aljazblatnik/Spectrum-analyzer/README.md

# Spectrum-analyzer
This is the first public release of all the building blocks of an open source 0 - 4 GHz spectrum analyzer with tracking generator. Detailed assembly instructions and plans will be published in the coming months.
