aljazblatnik/Spectrum-analyzer/AMP HEMT/AMP HEMT schematic.png

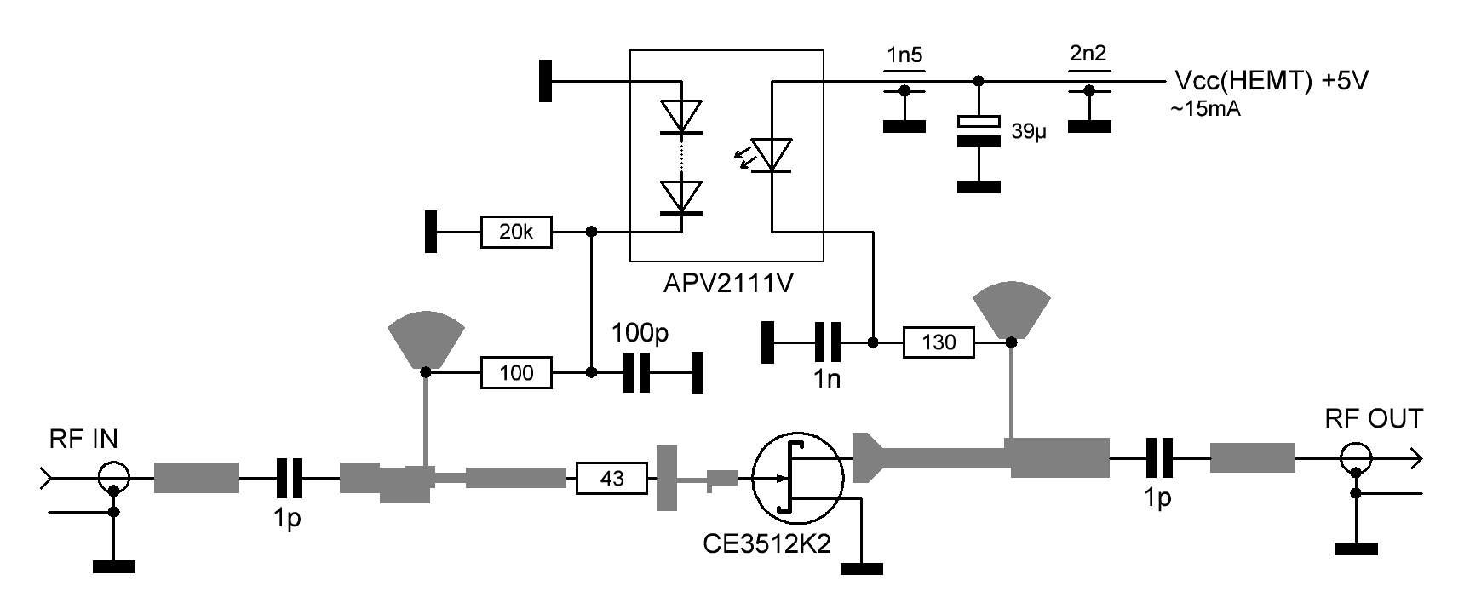
AMP HEMT/AMP HEMT schematic.png
