aljazblatnik/Spectrum-analyzer/AMP HEMT/photo/IMG_5204.jpg

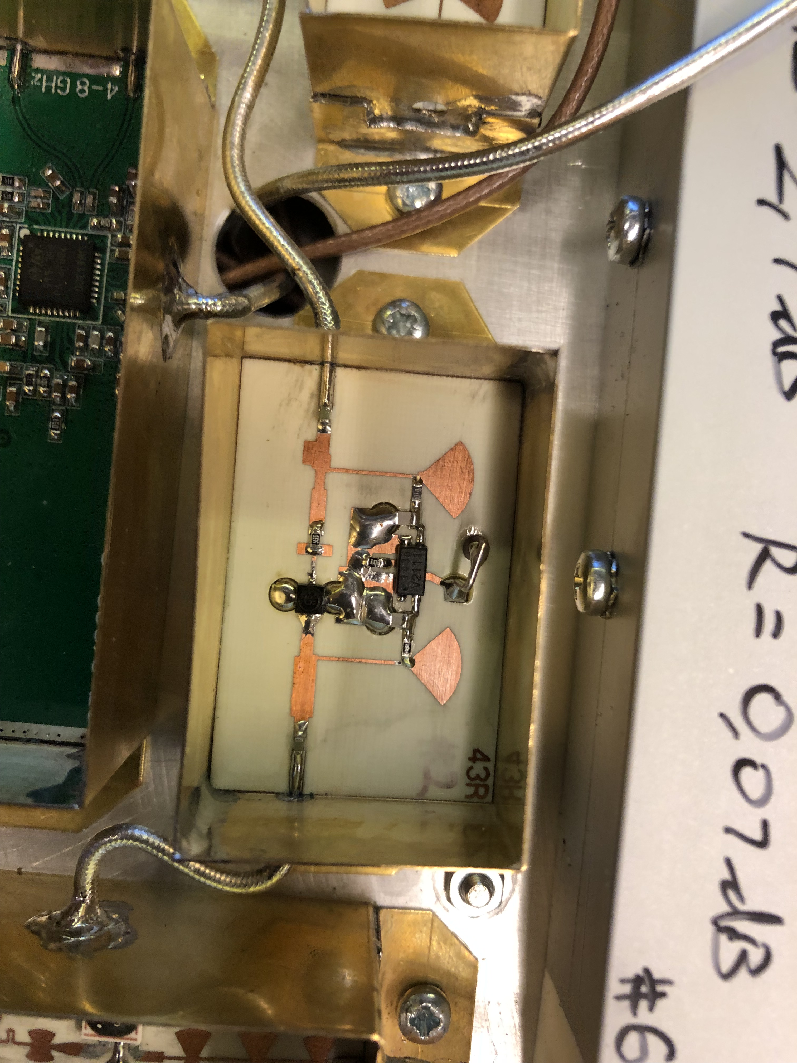
AMP HEMT/photo/IMG_5204.jpg
