aljazblatnik/Spectrum-analyzer/AMP HEMT/photo/IMG_5205.jpg

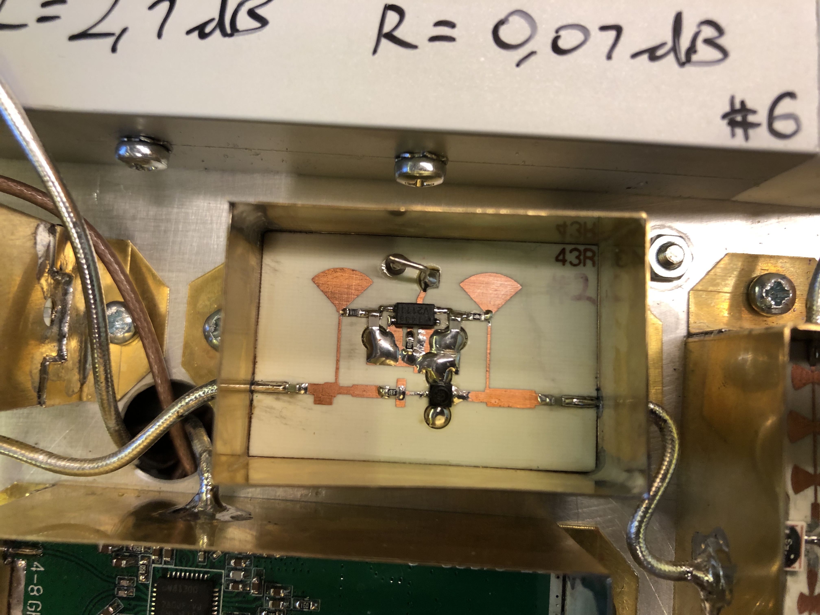
AMP HEMT/photo/IMG_5205.jpg
