aljazblatnik/Spectrum-analyzer/AMP HEMT/photo/IMG_5207.jpg

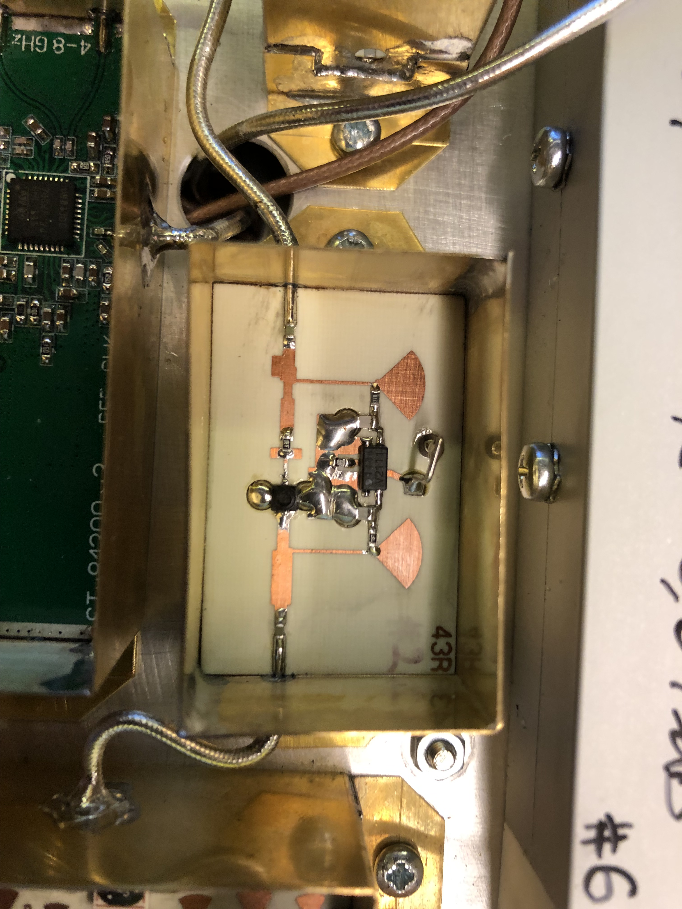
AMP HEMT/photo/IMG_5207.jpg
