aljazblatnik/Spectrum-analyzer/AMP HEMT/photo/IMG_5208.jpg

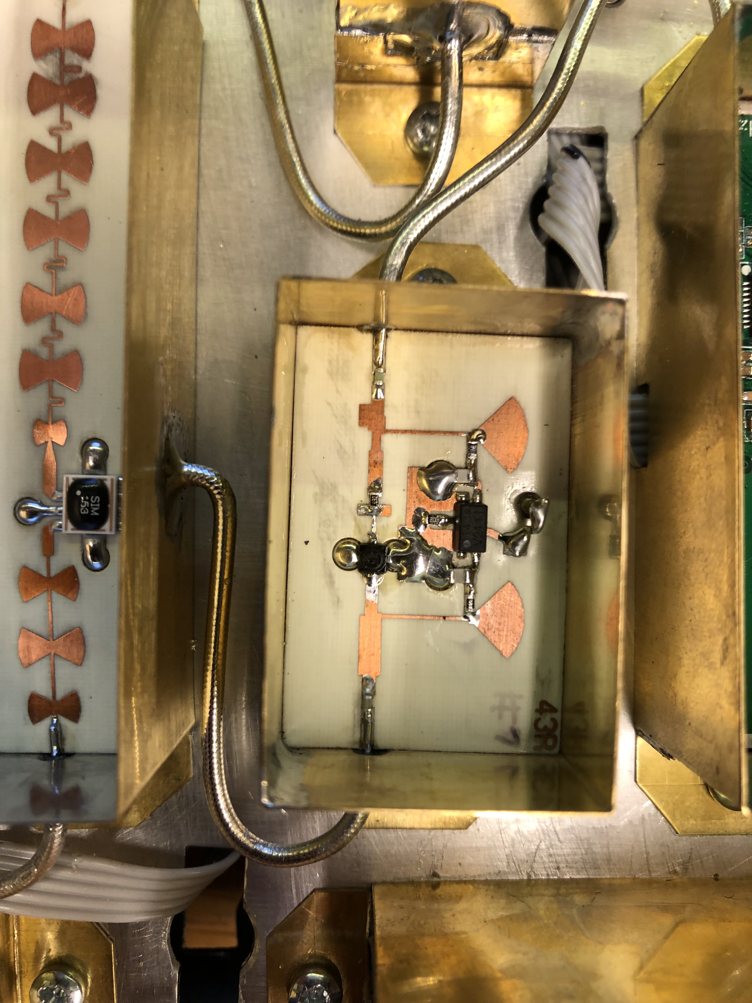
AMP HEMT/photo/IMG_5208.jpg
