aljazblatnik/Spectrum-analyzer/AMP HEMT/photo/IMG_5209.jpg

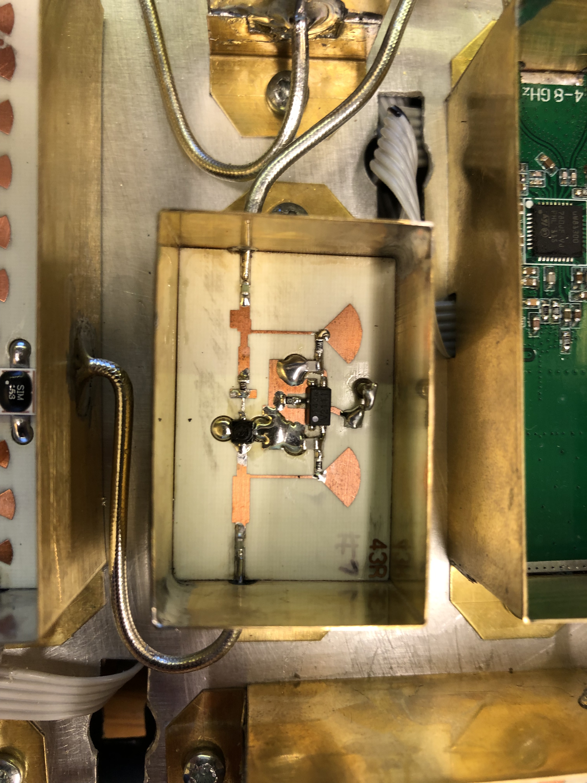
AMP HEMT/photo/IMG_5209.jpg
