aljazblatnik/Spectrum-analyzer/AMP HEMT/photo/IMG_5210.jpg

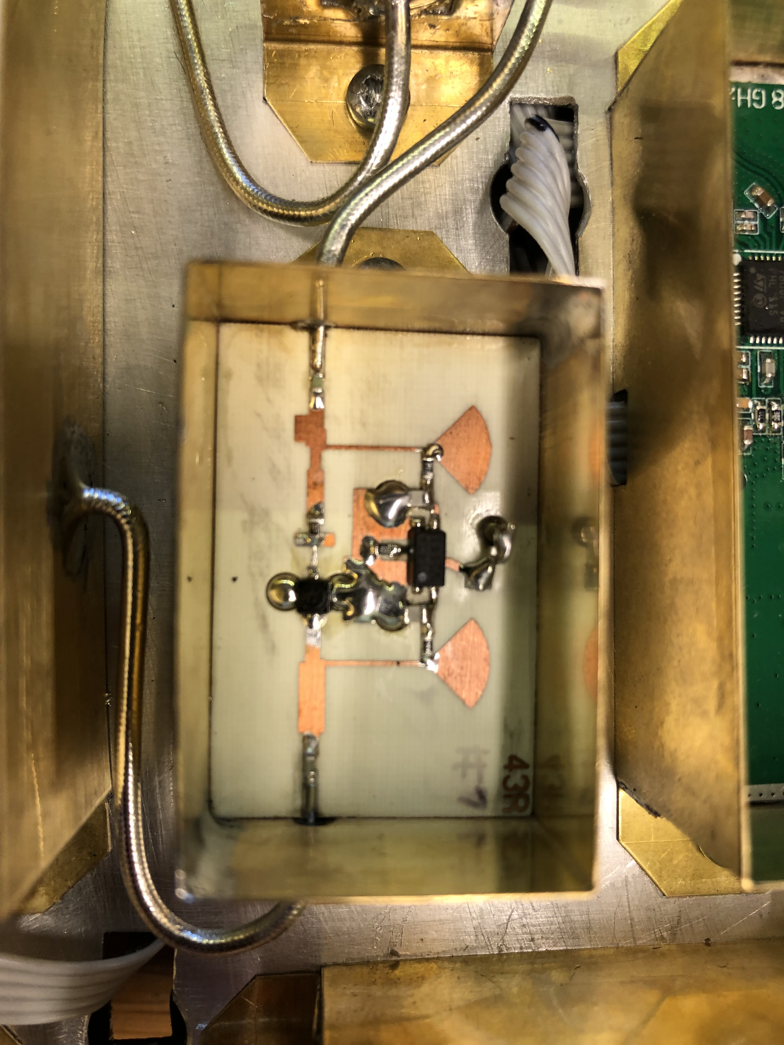
AMP HEMT/photo/IMG_5210.jpg
