aljazblatnik/Spectrum-analyzer/AMP HEMT/photo/IMG_5356.JPEG

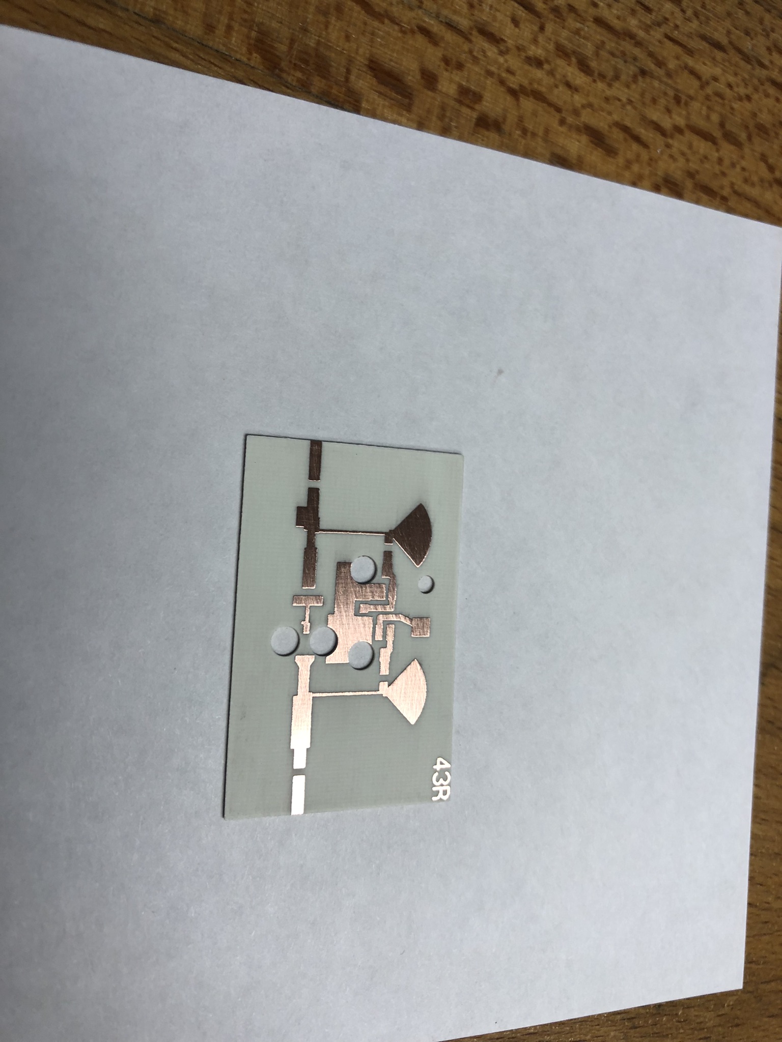
AMP HEMT/photo/IMG_5356.JPEG
