aljazblatnik/Spectrum-analyzer/AMP HEMT/photo/IMG_5357.JPEG

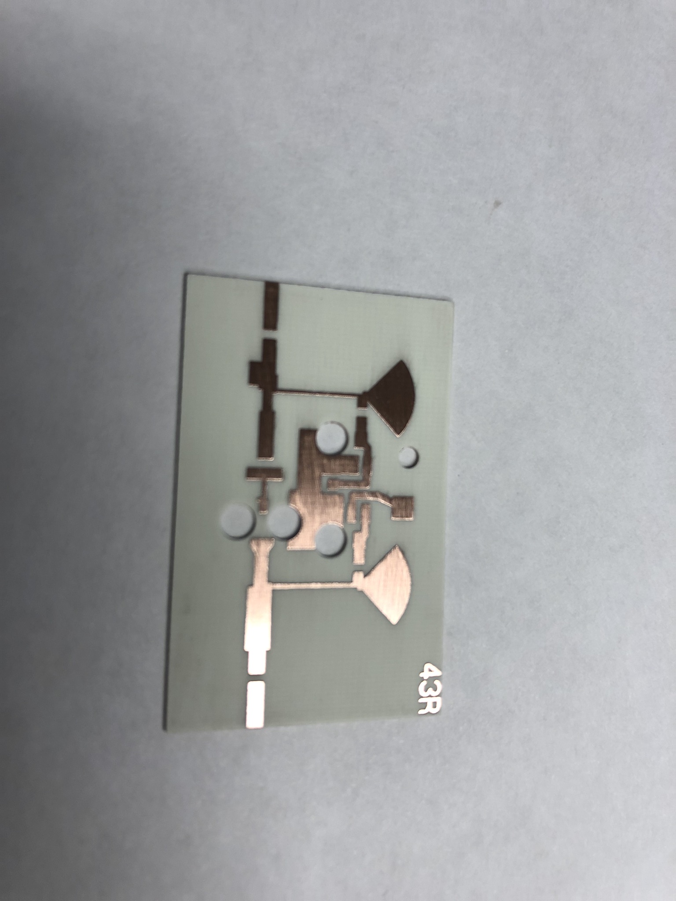
AMP HEMT/photo/IMG_5357.JPEG
