aljazblatnik/Spectrum-analyzer/AMP HEMT/photo/IMG_5361.JPG

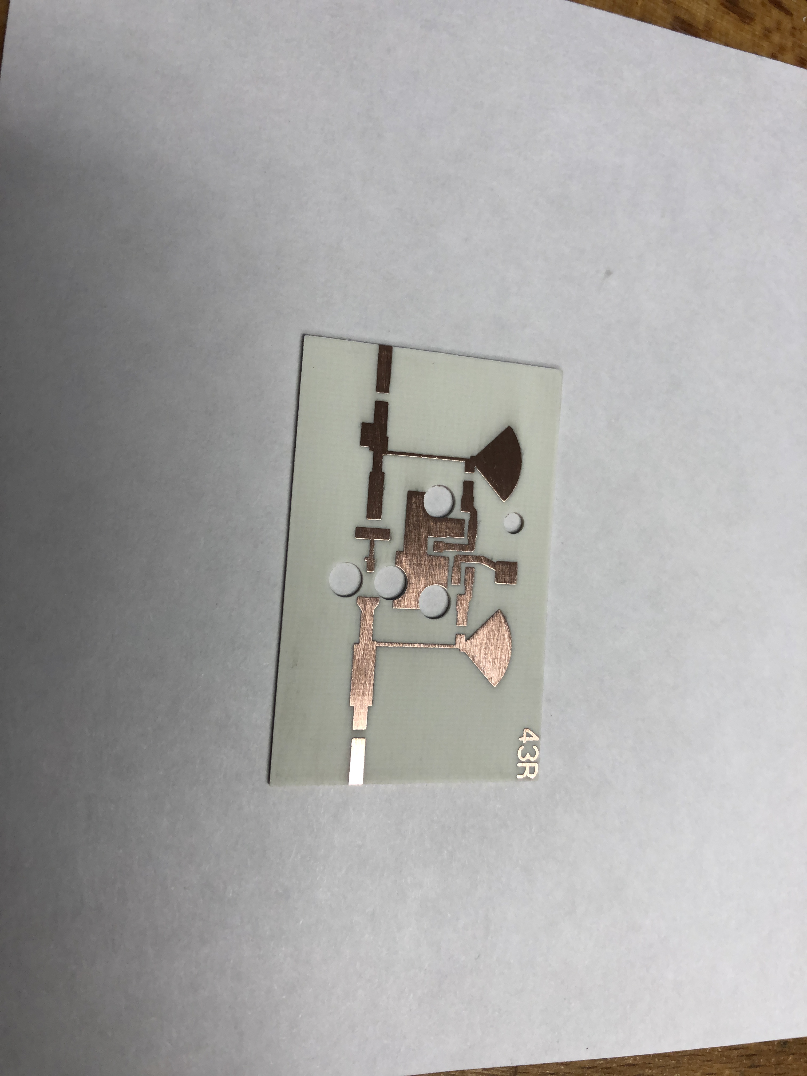
AMP HEMT/photo/IMG_5361.JPG
