aljazblatnik/Spectrum-analyzer/AMP HEMT/photo/IMG_5369.JPG

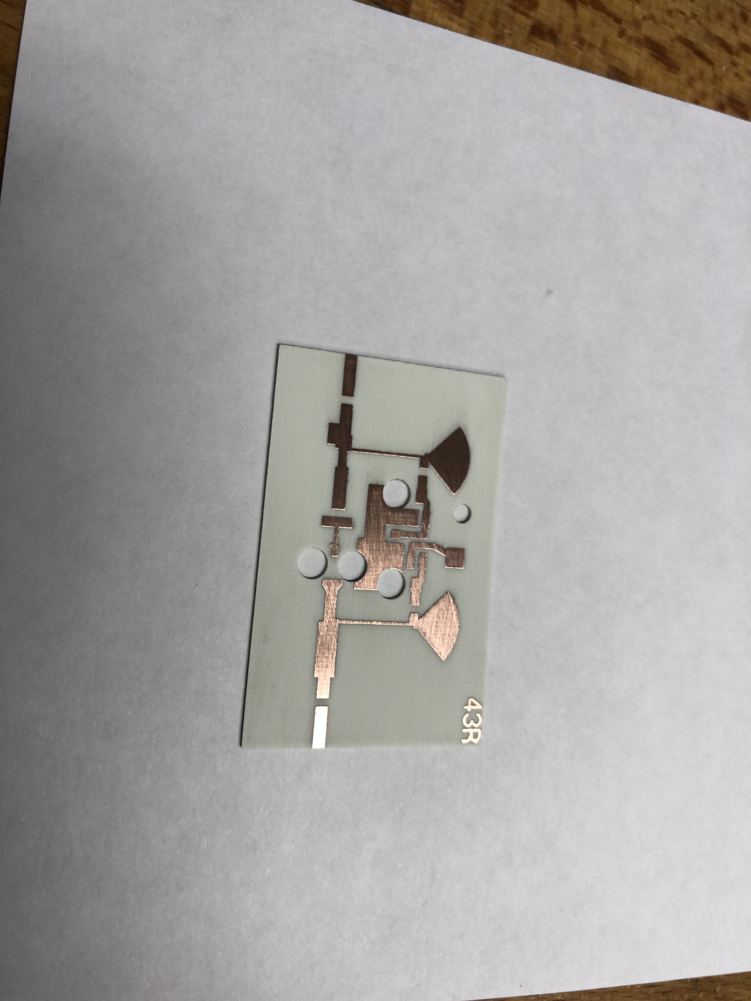
AMP HEMT/photo/IMG_5369.JPG
