aljazblatnik/Spectrum-analyzer/AMP HEMT/photo/IMG_5370.JPEG

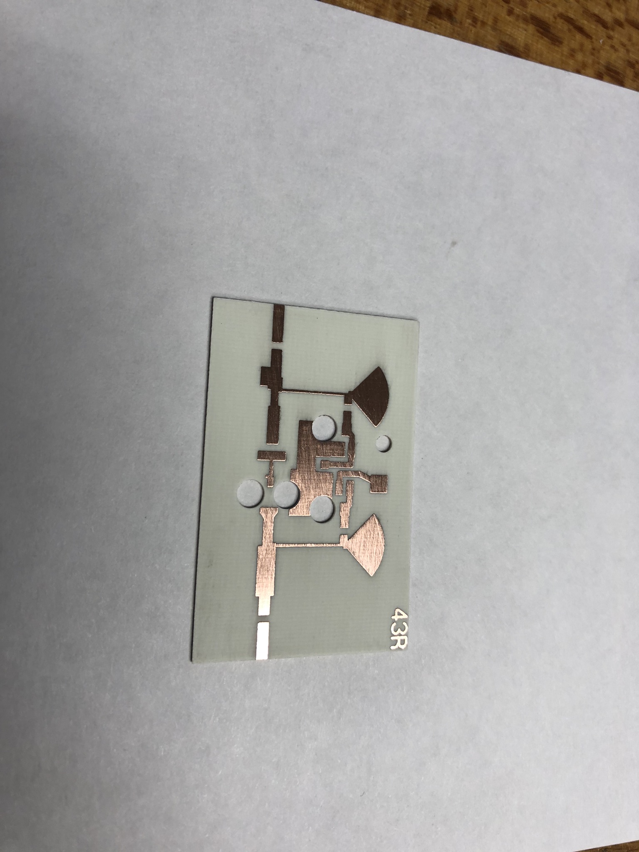
AMP HEMT/photo/IMG_5370.JPEG
