aljazblatnik/Spectrum-analyzer/AMP HEMT/photo/IMG_5371.JPEG

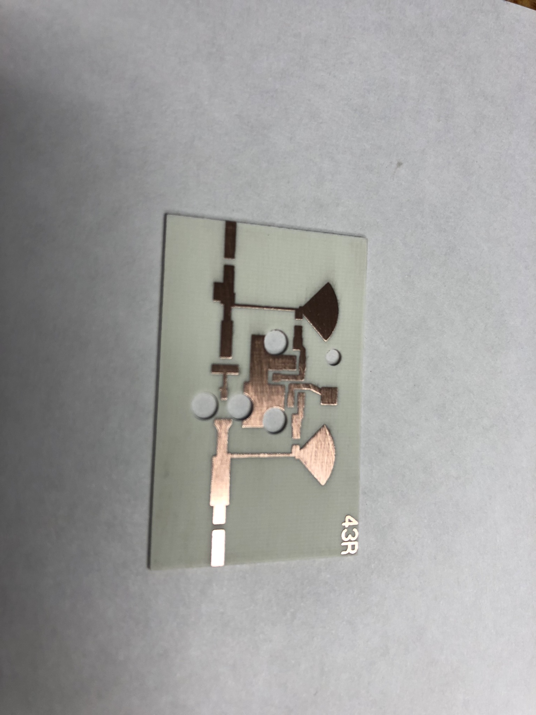
AMP HEMT/photo/IMG_5371.JPEG
