aljazblatnik/Spectrum-analyzer/AMP HEMT/photo/IMG_5372.JPEG

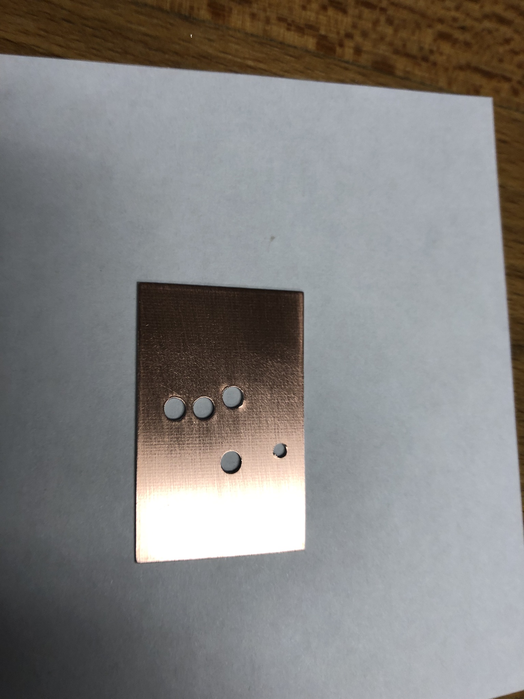
AMP HEMT/photo/IMG_5372.JPEG
