aljazblatnik/Spectrum-analyzer/AMP HEMT/photo/IMG_5373.JPEG

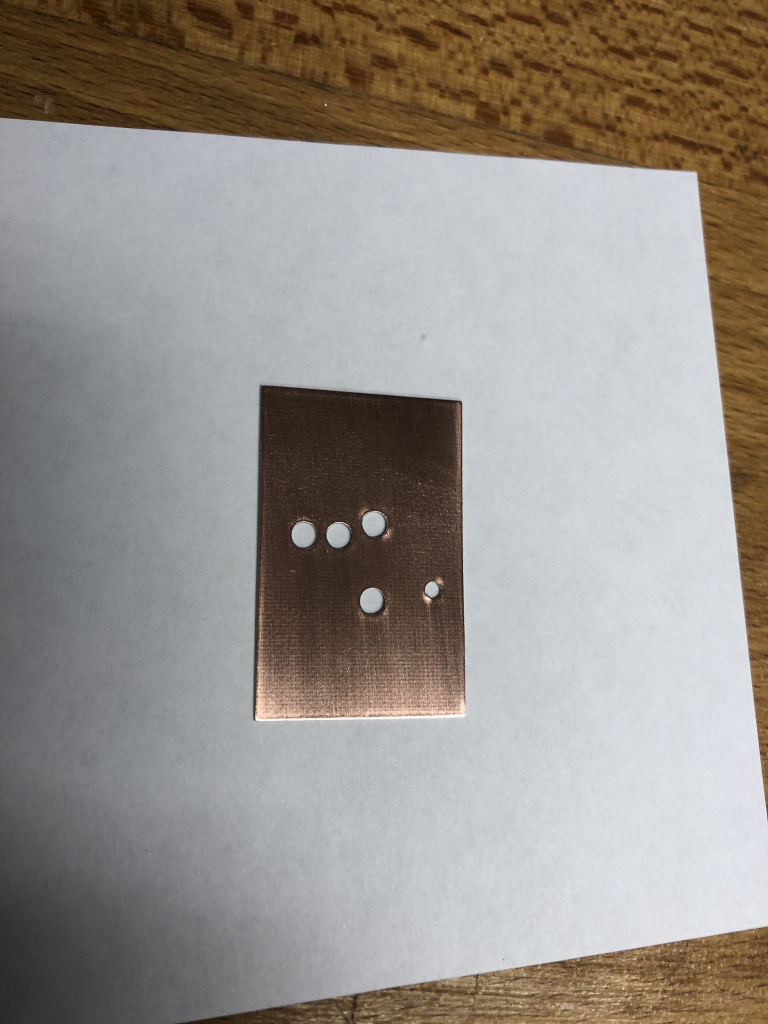
AMP HEMT/photo/IMG_5373.JPEG
