aljazblatnik/Spectrum-analyzer/AMP HEMT/photo/IMG_5374.JPEG

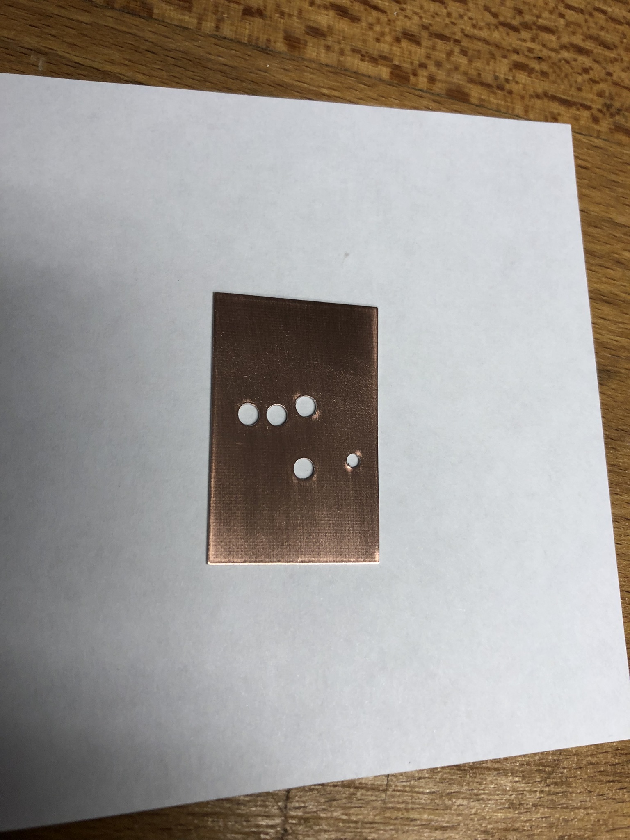
AMP HEMT/photo/IMG_5374.JPEG
