aljazblatnik/Spectrum-analyzer/AMP HEMT/photo/IMG_5375.JPEG

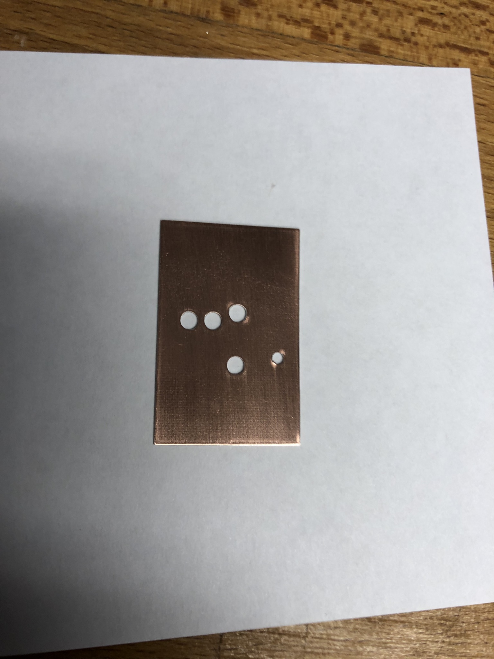
AMP HEMT/photo/IMG_5375.JPEG
