aljazblatnik/Spectrum-analyzer/AMP HEMT/photo/IMG_5376.JPEG

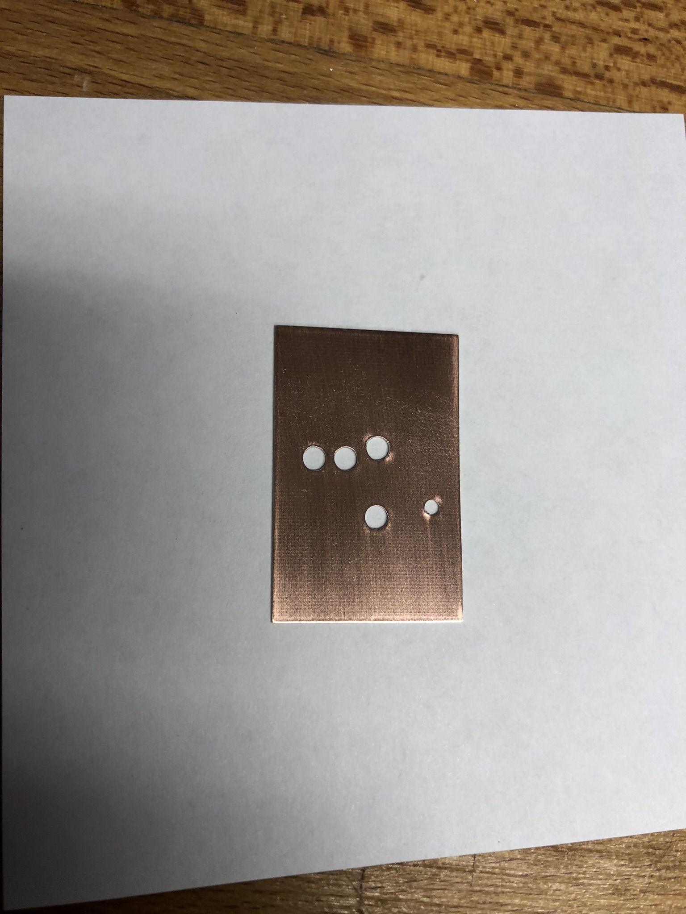
AMP HEMT/photo/IMG_5376.JPEG
