aljazblatnik/Spectrum-analyzer/AMP HEMT/photo/IMG_5377.JPEG

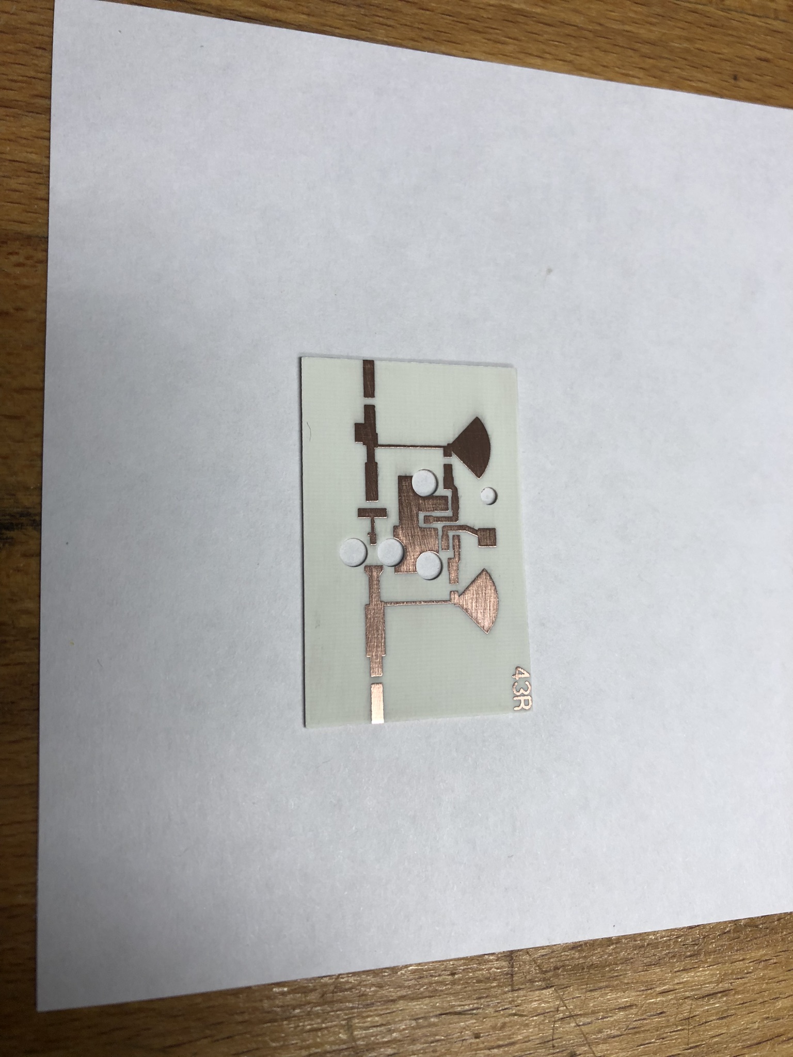
AMP HEMT/photo/IMG_5377.JPEG
