aljazblatnik/Spectrum-analyzer/AMP HEMT/photo/IMG_5378.JPEG

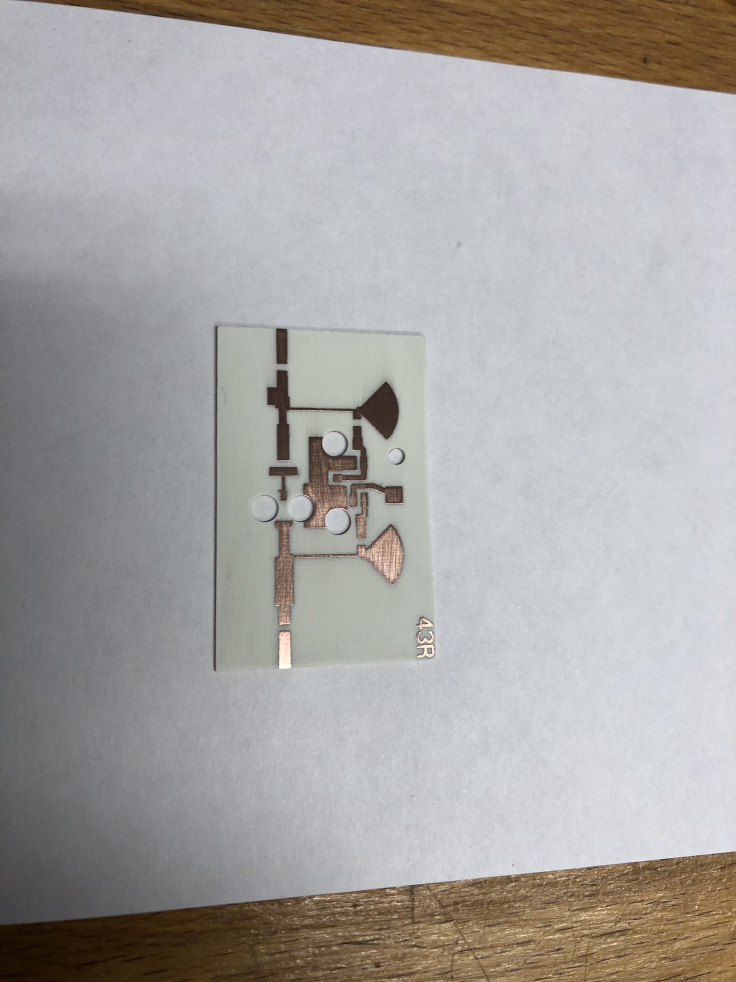
AMP HEMT/photo/IMG_5378.JPEG
