aljazblatnik/Spectrum-analyzer/AMP HEMT/photo/IMG_5379.JPEG

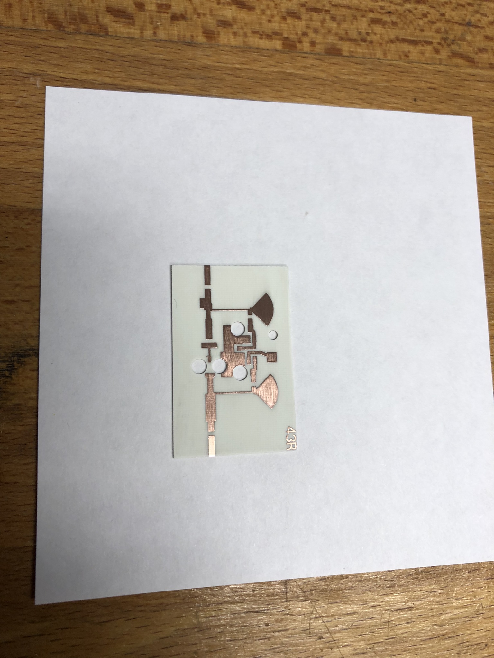
AMP HEMT/photo/IMG_5379.JPEG
