aljazblatnik/Spectrum-analyzer/AMP HEMT/photo/IMG_5380.JPEG

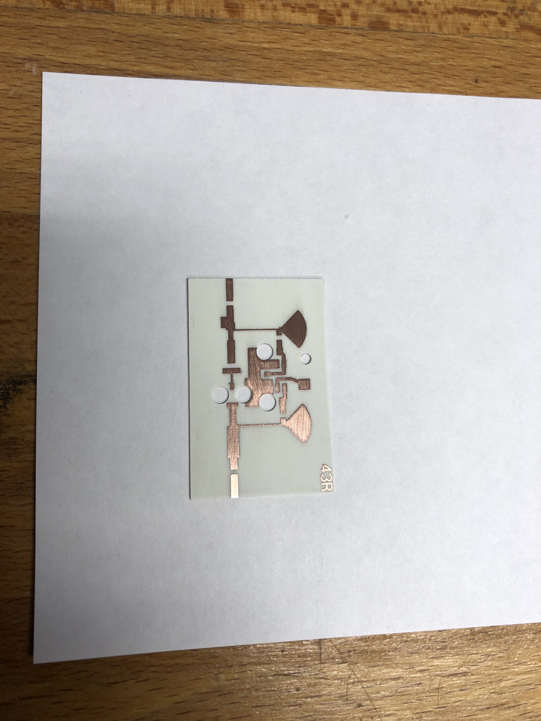
AMP HEMT/photo/IMG_5380.JPEG
