aljazblatnik/Spectrum-analyzer/AMP HEMT/photo/IMG_5381.JPEG

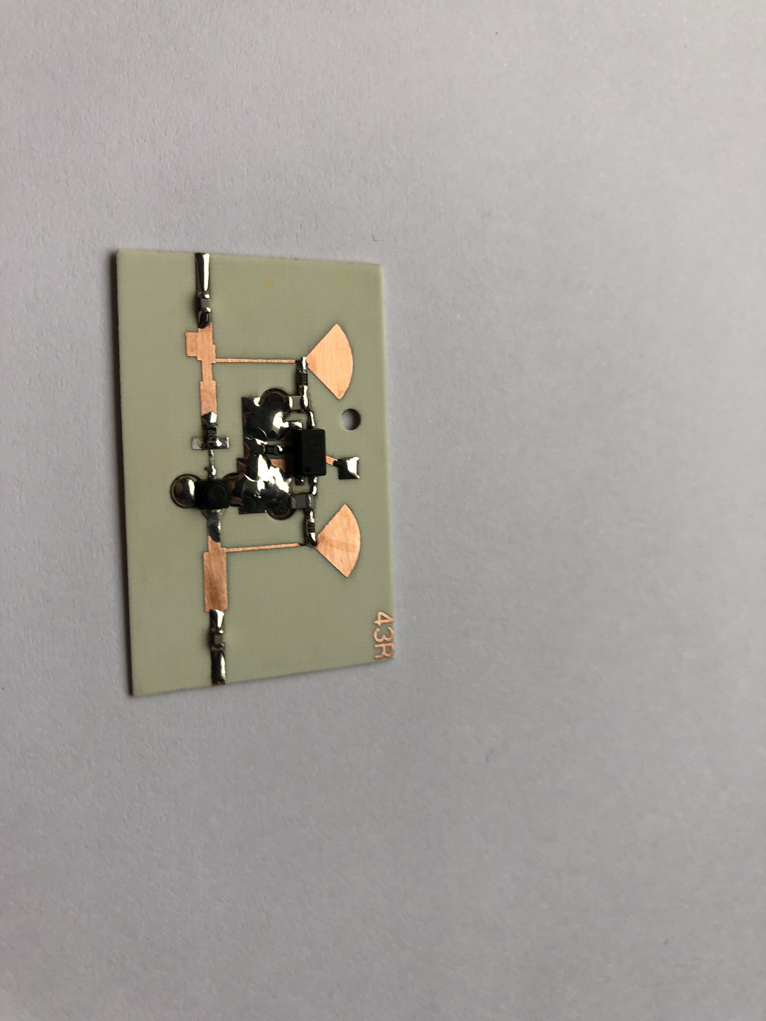
AMP HEMT/photo/IMG_5381.JPEG
