aljazblatnik/Spectrum-analyzer/AMP HEMT/photo/IMG_5382.JPEG

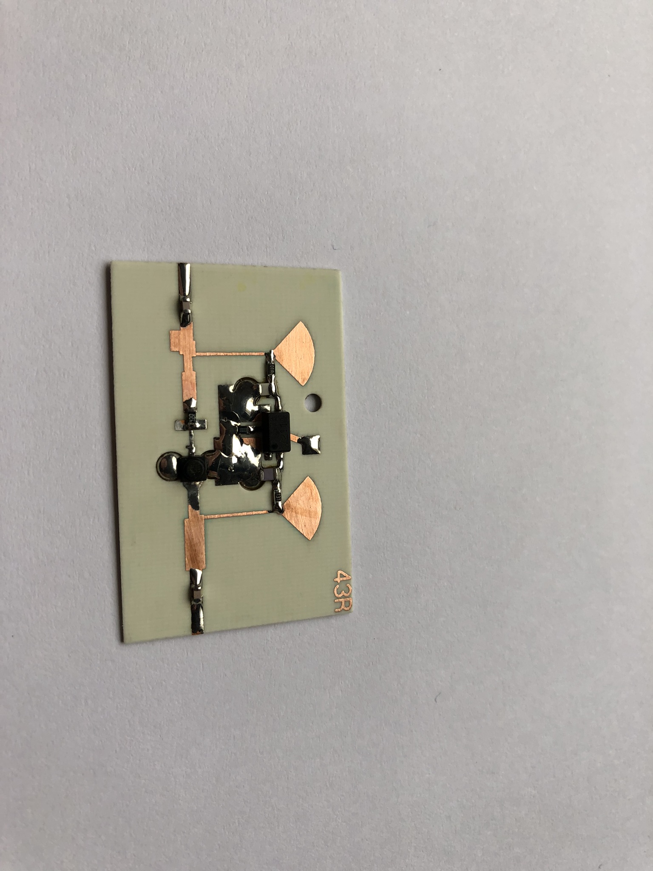
AMP HEMT/photo/IMG_5382.JPEG
