aljazblatnik/Spectrum-analyzer/AMP HEMT/photo/IMG_5383.JPEG

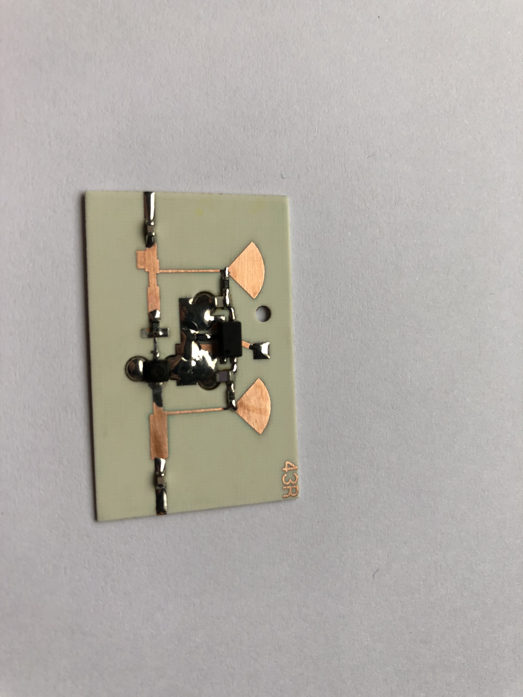
AMP HEMT/photo/IMG_5383.JPEG
