aljazblatnik/Spectrum-analyzer/AMP HEMT/photo/IMG_5384.JPEG

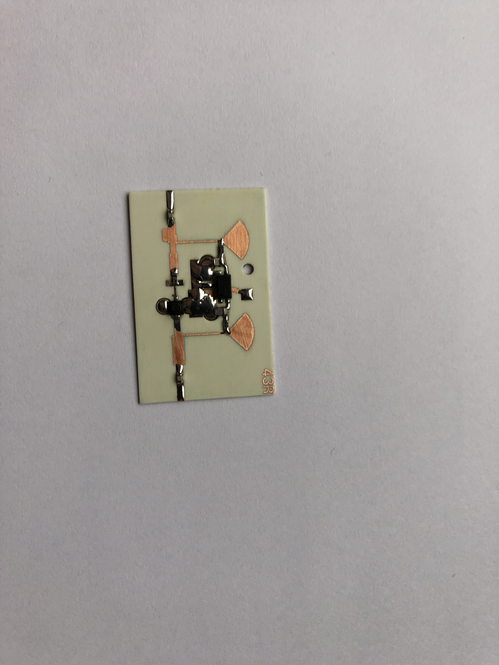
AMP HEMT/photo/IMG_5384.JPEG
