aljazblatnik/Spectrum-analyzer/AMP HEMT/photo/IMG_5385.JPEG

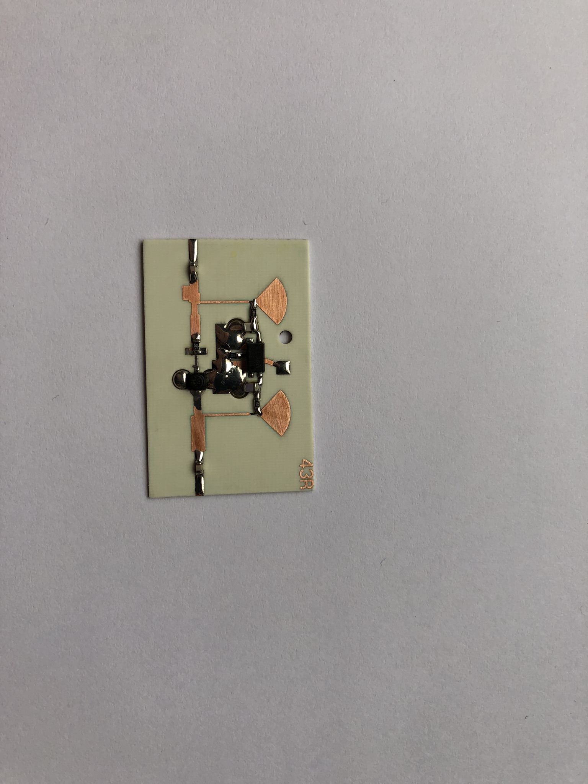
AMP HEMT/photo/IMG_5385.JPEG
