aljazblatnik/Spectrum-analyzer/AMP HEMT/photo/IMG_5386.JPEG

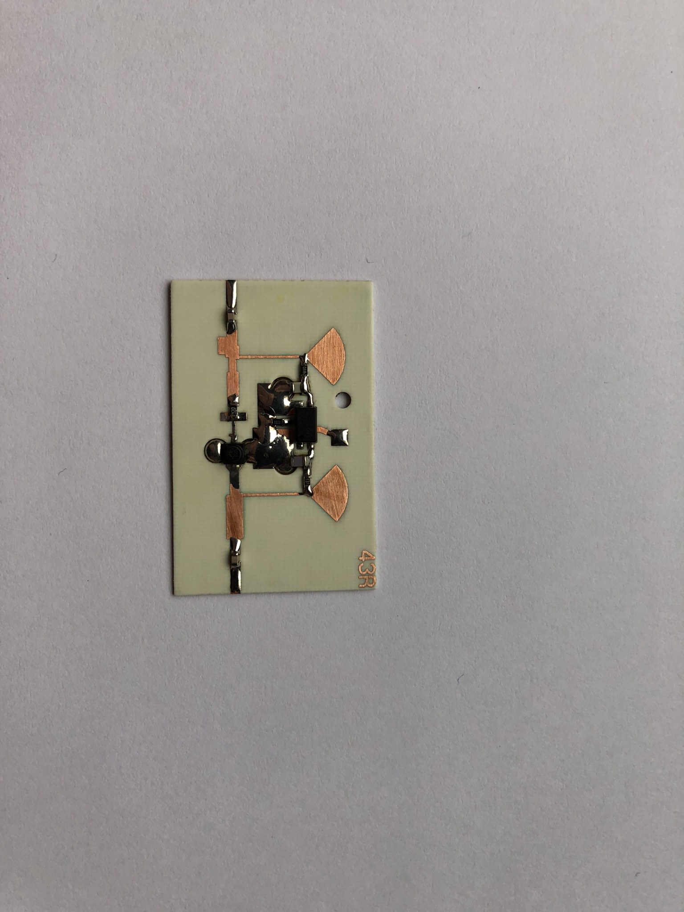
AMP HEMT/photo/IMG_5386.JPEG
