aljazblatnik/Spectrum-analyzer/AMP HEMT/photo/IMG_5387.JPEG

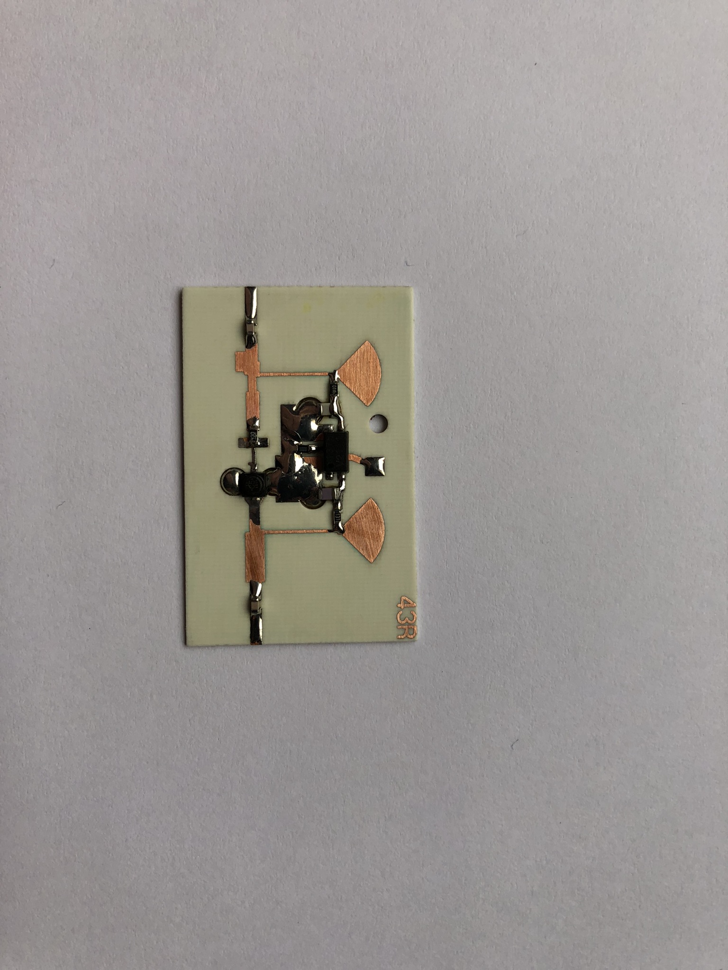
AMP HEMT/photo/IMG_5387.JPEG
