aljazblatnik/Spectrum-analyzer/AMP HEMT/photo/IMG_5388.JPEG

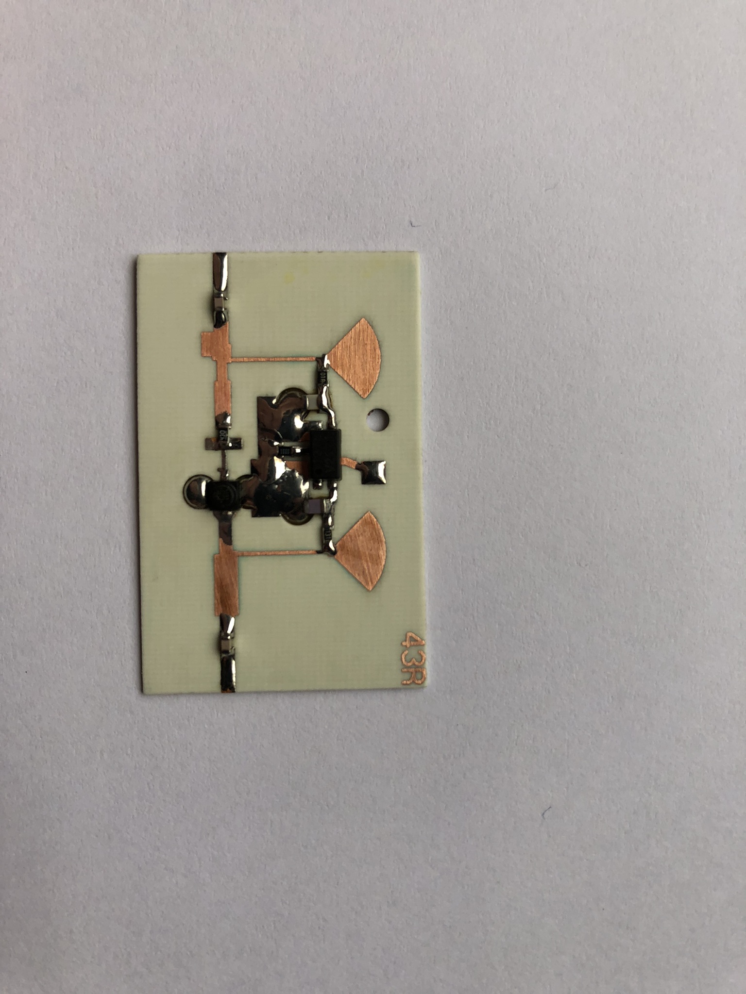
AMP HEMT/photo/IMG_5388.JPEG
