aljazblatnik/Spectrum-analyzer/AMP HEMT/photo/IMG_5389.JPEG

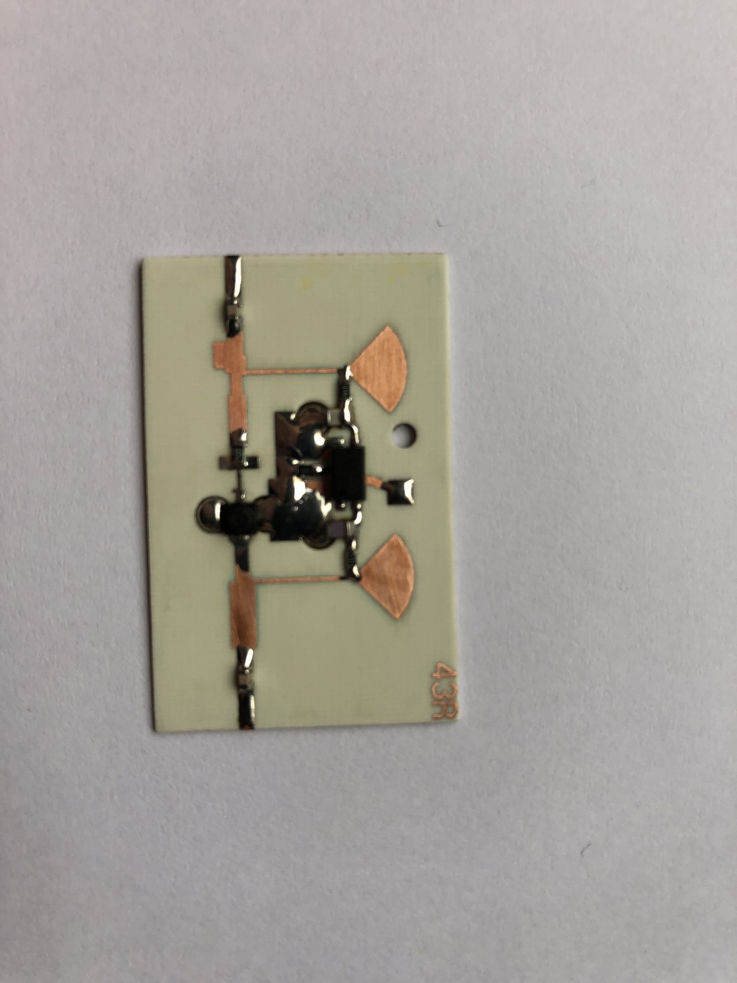
AMP HEMT/photo/IMG_5389.JPEG
