aljazblatnik/Spectrum-analyzer/AMP HEMT/photo/IMG_5390.JPEG

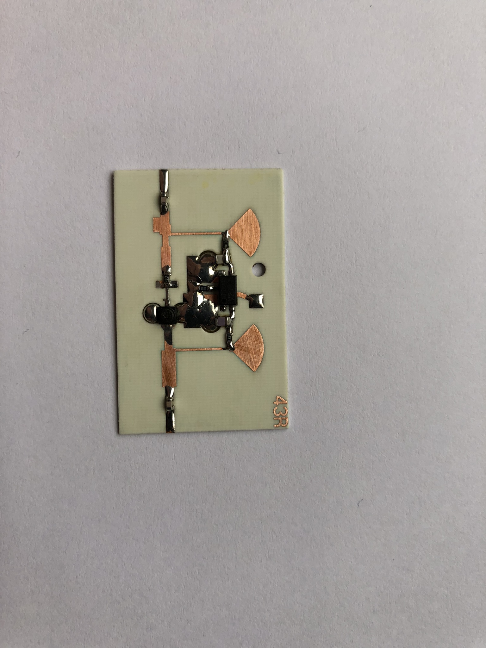
AMP HEMT/photo/IMG_5390.JPEG
