aljazblatnik/Spectrum-analyzer/AMP HEMT/photo/IMG_5391.JPEG

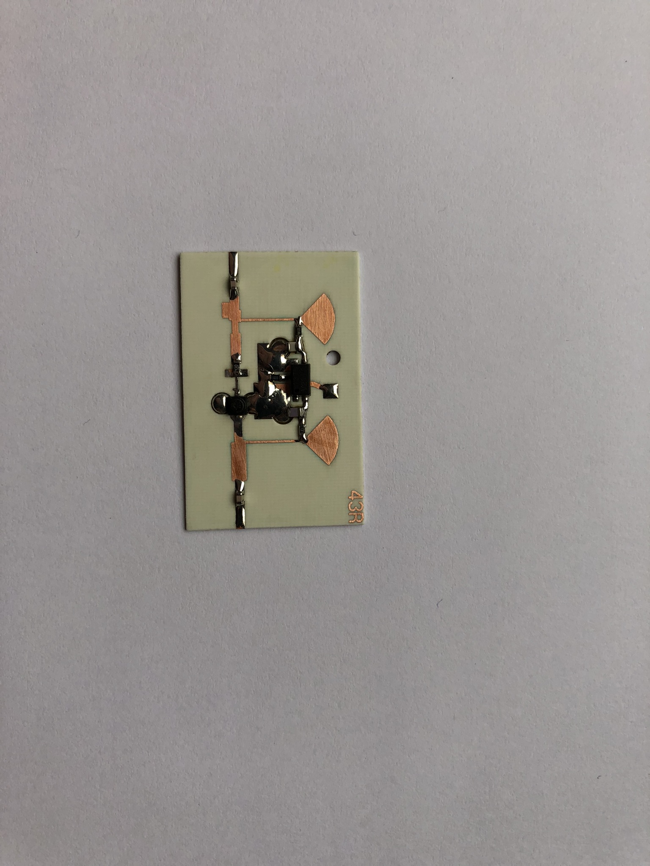
AMP HEMT/photo/IMG_5391.JPEG
