aljazblatnik/Spectrum-analyzer/AMP HEMT/photo/IMG_5392.JPEG

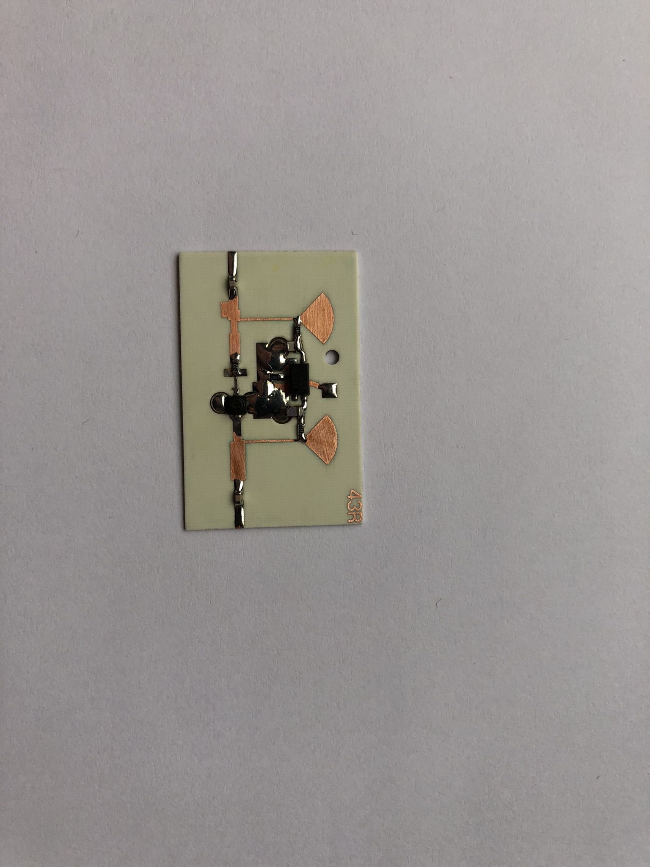
AMP HEMT/photo/IMG_5392.JPEG
