aljazblatnik/Spectrum-analyzer/AMP HEMT/photo/IMG_5394.JPEG

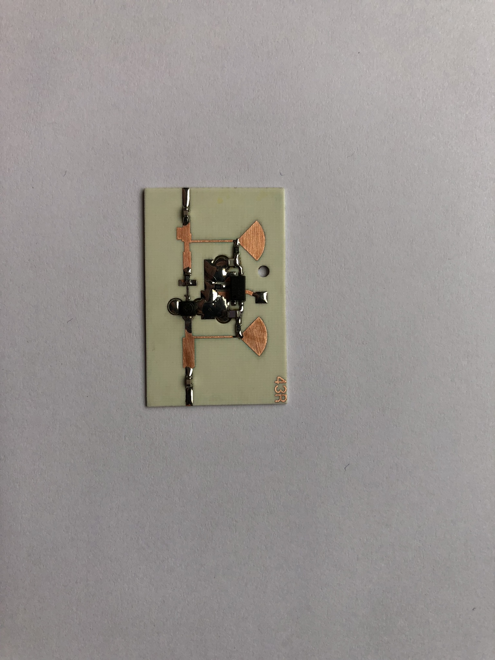
AMP HEMT/photo/IMG_5394.JPEG
