aljazblatnik/Spectrum-analyzer/AMP HEMT/photo/IMG_5395.JPEG

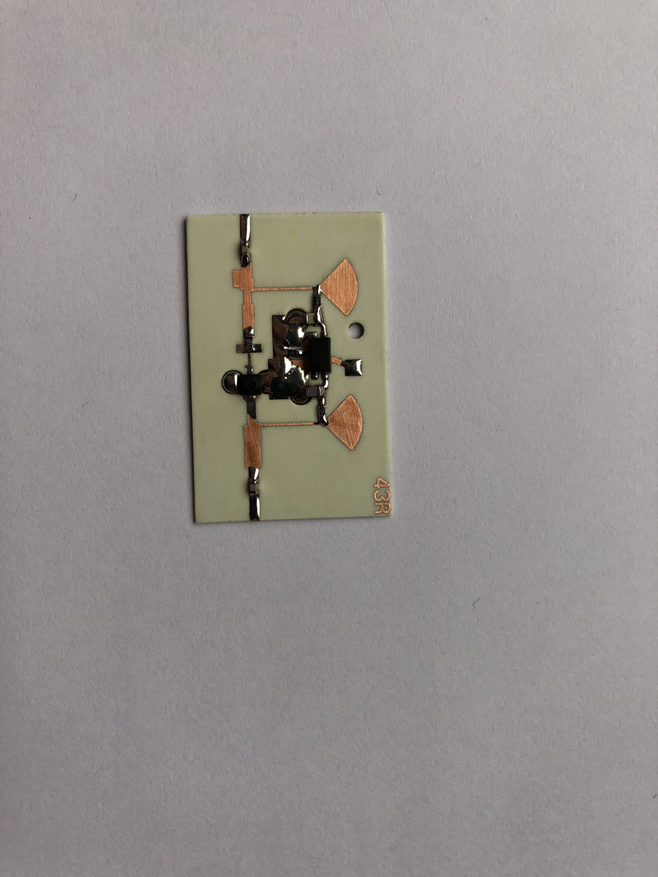
AMP HEMT/photo/IMG_5395.JPEG
