aljazblatnik/Spectrum-analyzer/AMP HEMT/photo/IMG_5396.JPEG

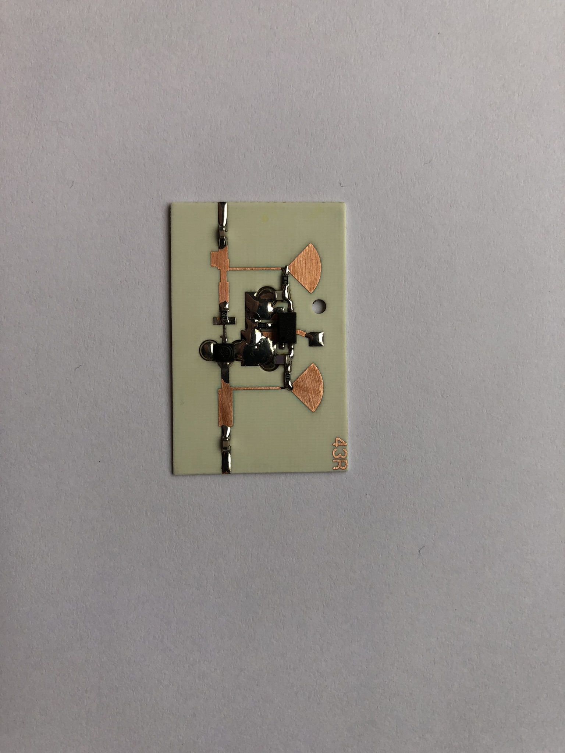
AMP HEMT/photo/IMG_5396.JPEG
