aljazblatnik/Spectrum-analyzer/AMP HEMT/photo/IMG_5397.JPEG

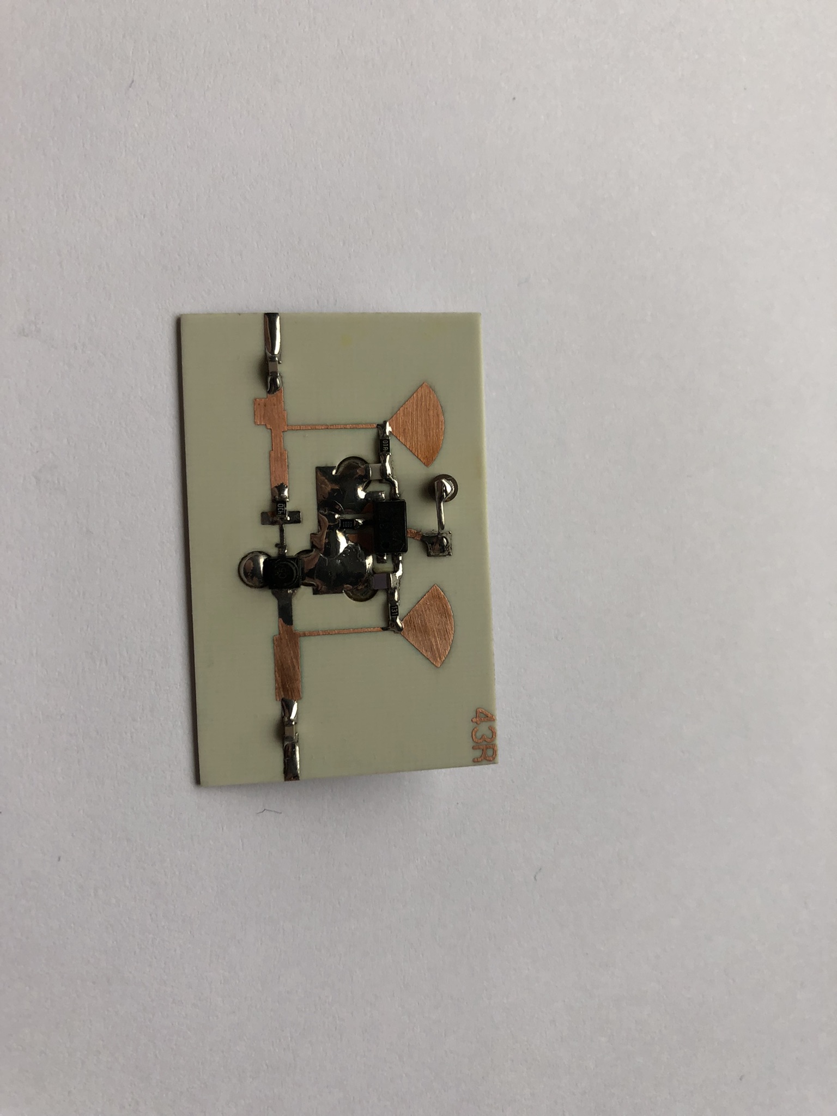
AMP HEMT/photo/IMG_5397.JPEG
