aljazblatnik/Spectrum-analyzer/AMP HEMT/photo/IMG_5398.JPEG

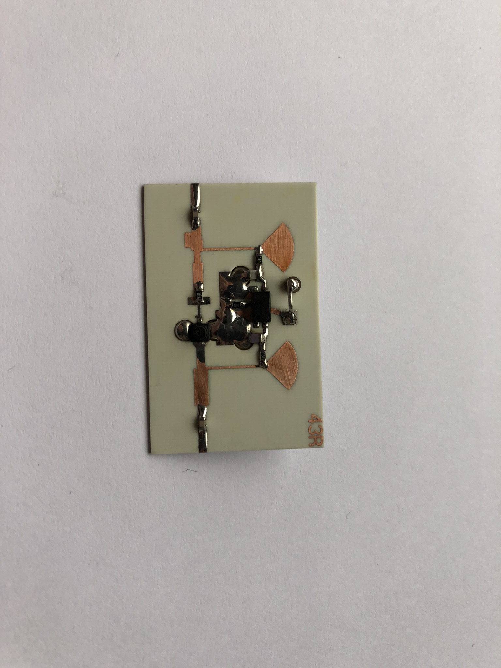
AMP HEMT/photo/IMG_5398.JPEG
