aljazblatnik/Spectrum-analyzer/AMP HEMT/photo/IMG_5399.JPEG

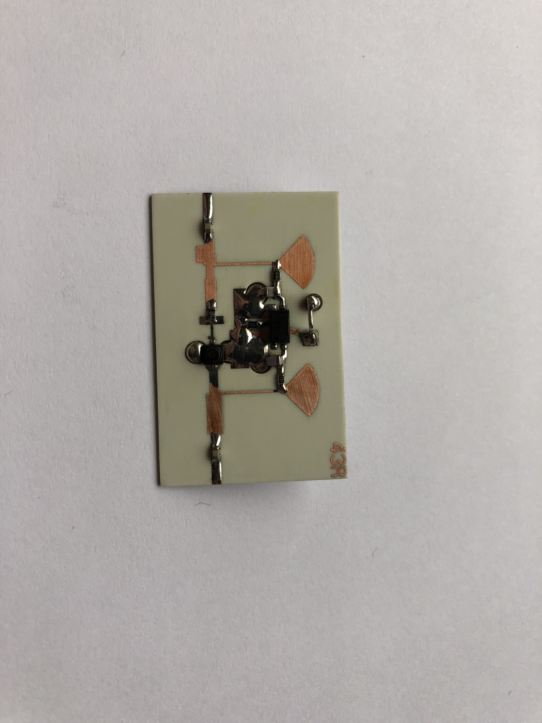
AMP HEMT/photo/IMG_5399.JPEG
