aljazblatnik/Spectrum-analyzer/AMP HEMT/photo/IMG_5400.JPEG

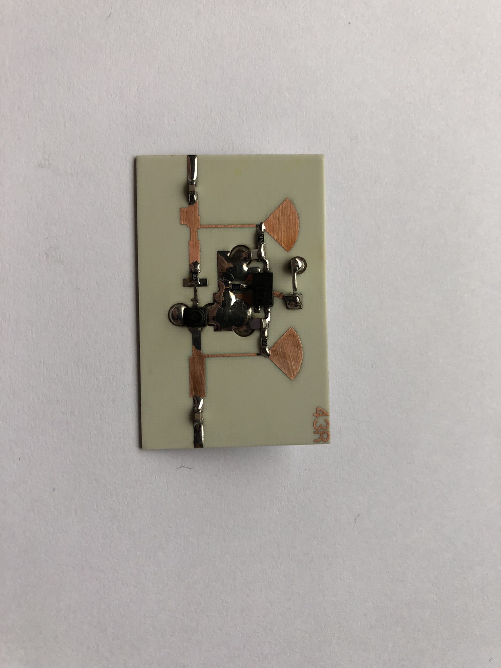
AMP HEMT/photo/IMG_5400.JPEG
