aljazblatnik/Spectrum-analyzer/AMP HEMT/photo/IMG_5401.JPEG

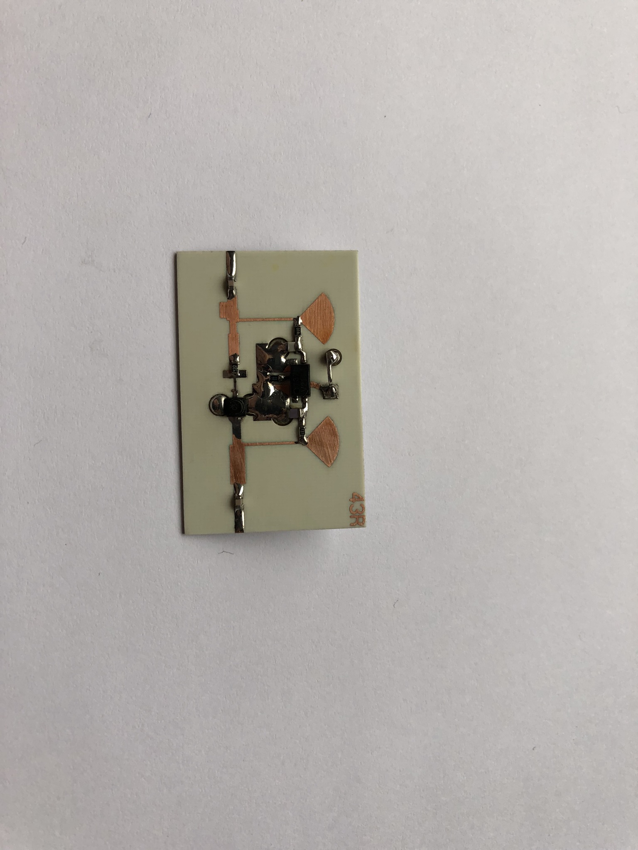
AMP HEMT/photo/IMG_5401.JPEG
