aljazblatnik/Spectrum-analyzer/AMP HEMT/photo/IMG_5402.JPEG

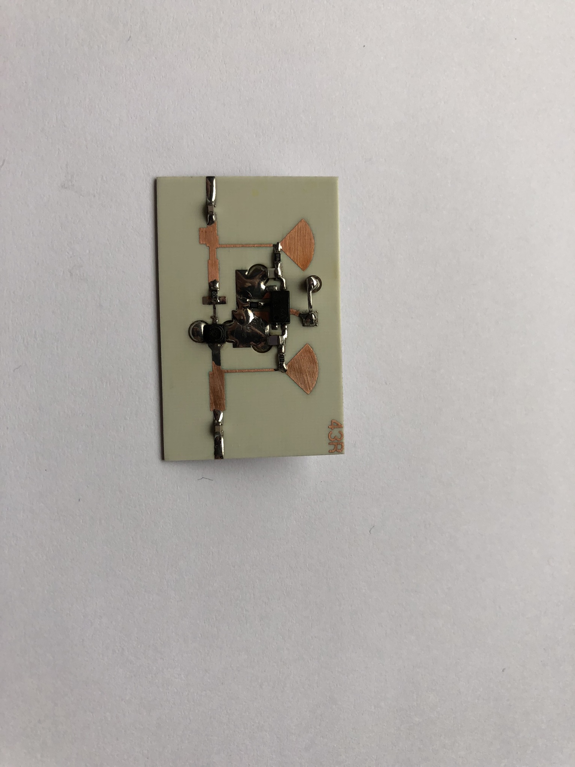
AMP HEMT/photo/IMG_5402.JPEG
