aljazblatnik/Spectrum-analyzer/AMP HEMT/photo/IMG_5403.JPEG

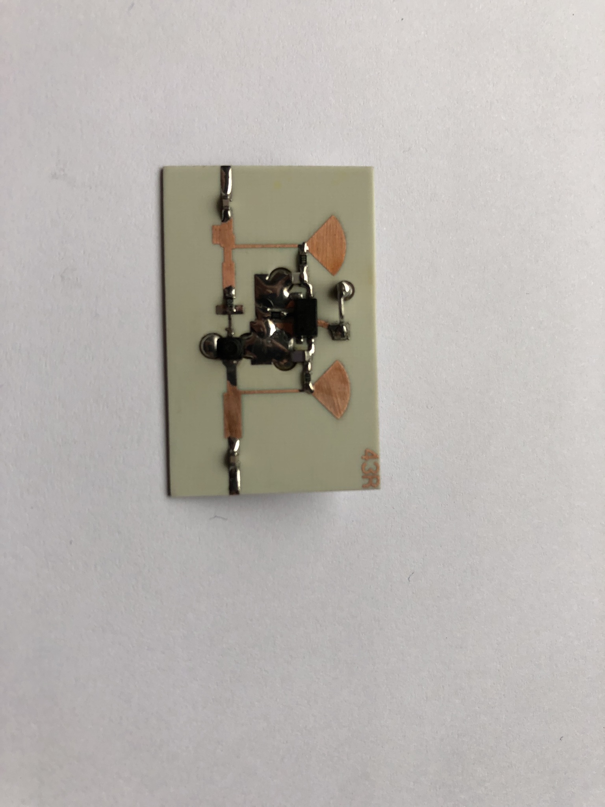
AMP HEMT/photo/IMG_5403.JPEG
