aljazblatnik/Spectrum-analyzer/AMP HEMT/photo/IMG_5404.JPEG

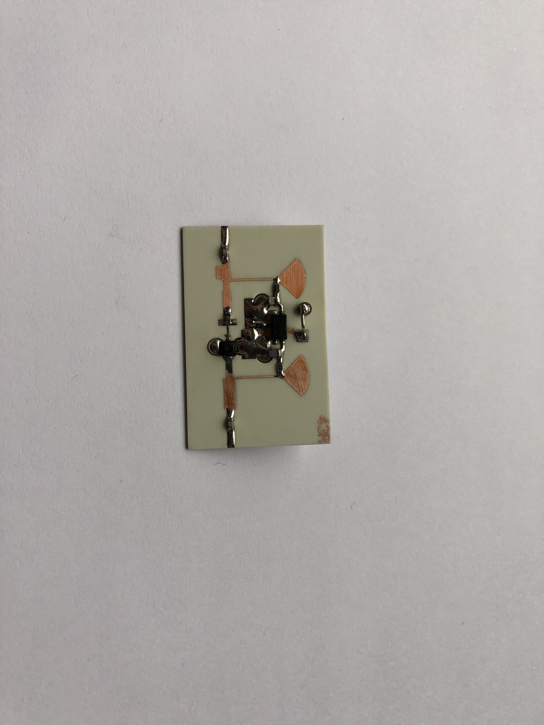
AMP HEMT/photo/IMG_5404.JPEG
