aljazblatnik/Spectrum-analyzer/AMP HEMT/photo/IMG_5413.jpg

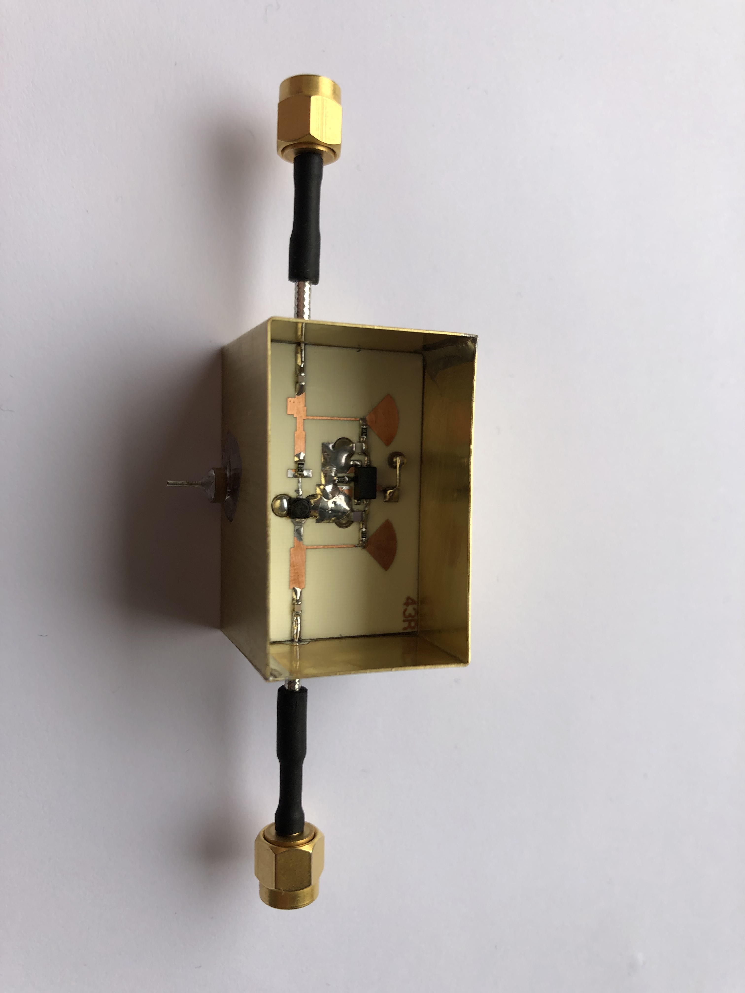
AMP HEMT/photo/IMG_5413.jpg
