aljazblatnik/Spectrum-analyzer/AMP HEMT/photo/IMG_5415.jpg

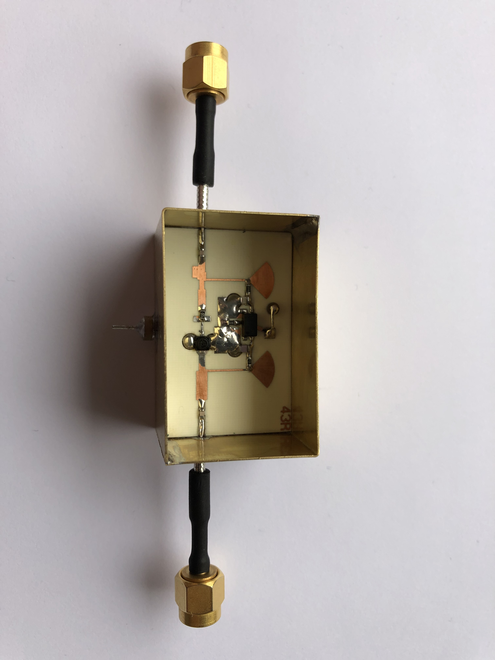
AMP HEMT/photo/IMG_5415.jpg
