aljazblatnik/Spectrum-analyzer/AMP HEMT/photo/IMG_5416.jpg

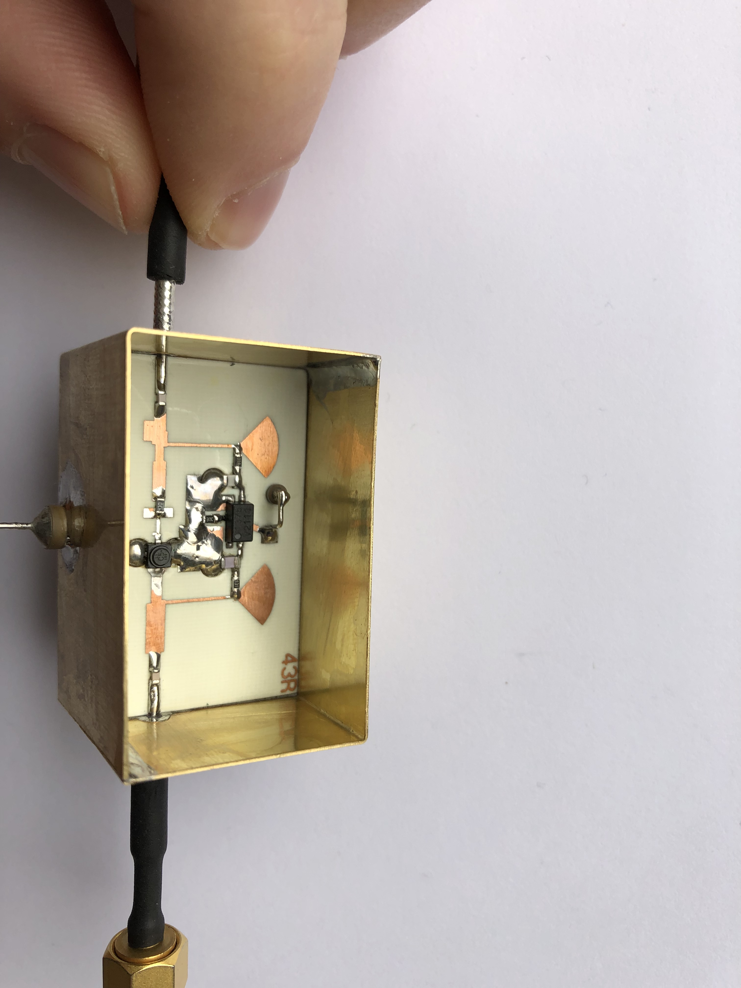
AMP HEMT/photo/IMG_5416.jpg
