aljazblatnik/Spectrum-analyzer/AMP HEMT/photo/IMG_5417.jpg

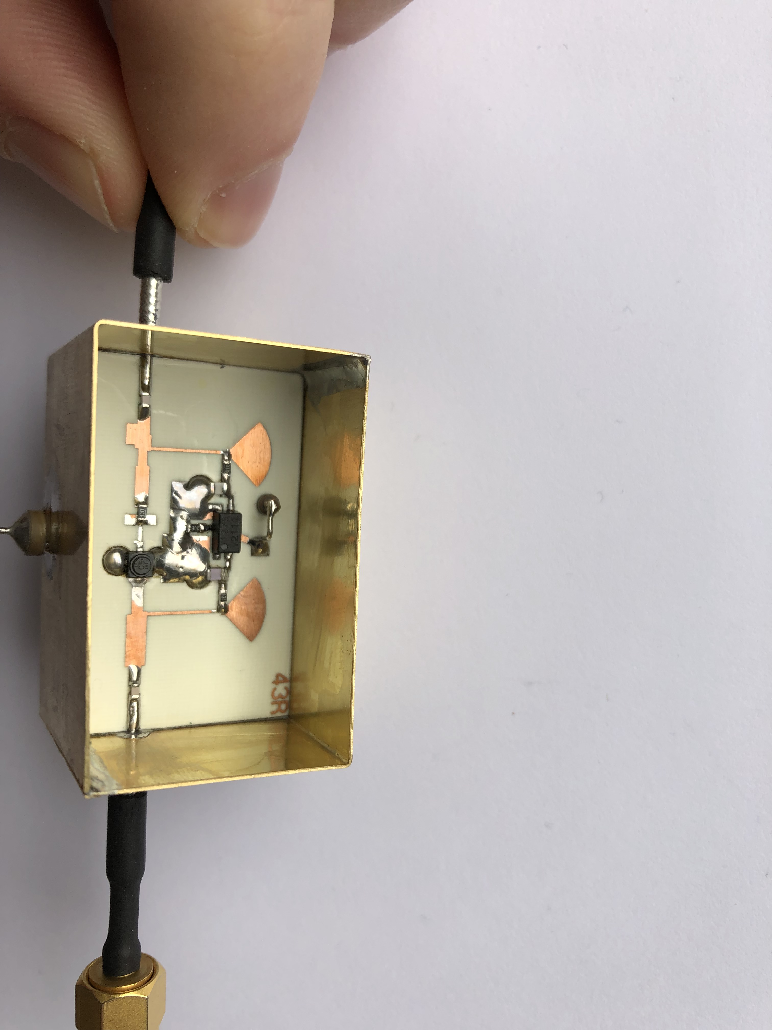
AMP HEMT/photo/IMG_5417.jpg
