aljazblatnik/Spectrum-analyzer/AMP HEMT/photo/IMG_5419.jpg

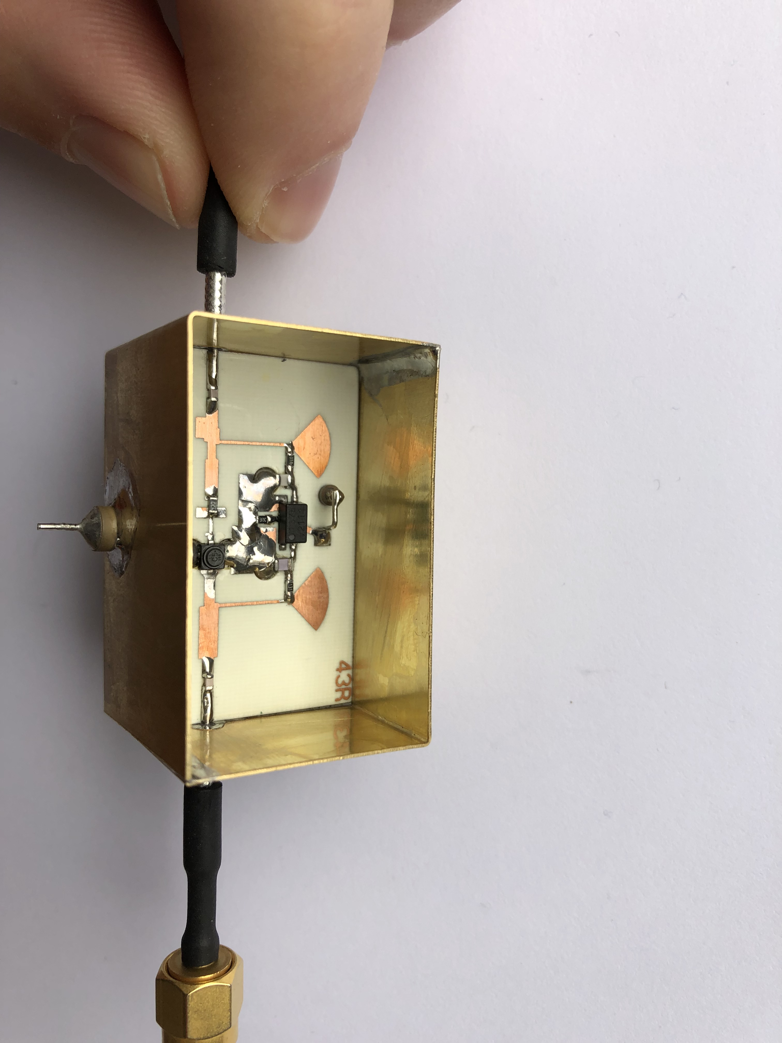
AMP HEMT/photo/IMG_5419.jpg
