aljazblatnik/Spectrum-analyzer/AMP HEMT/photo/IMG_5420.jpg

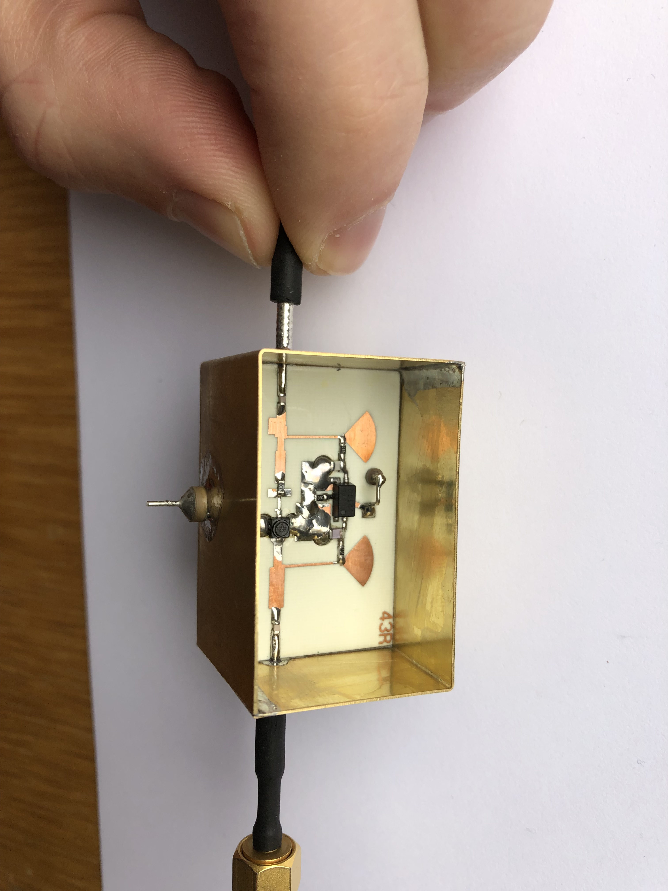
AMP HEMT/photo/IMG_5420.jpg
