aljazblatnik/Spectrum-analyzer/AMP HEMT/photo/IMG_5421.jpg

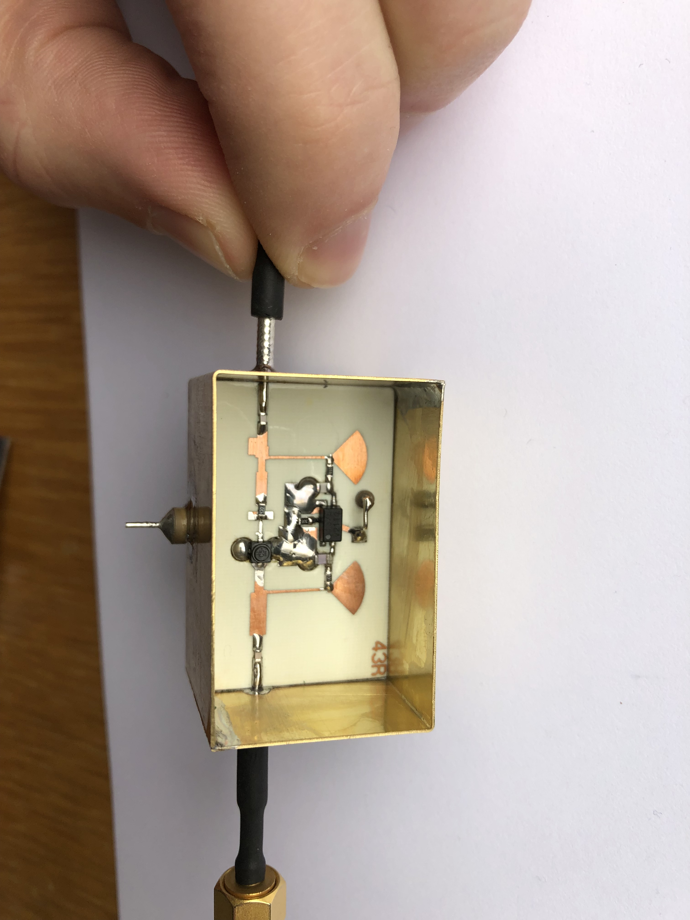
AMP HEMT/photo/IMG_5421.jpg
