aljazblatnik/Spectrum-analyzer/AMP HEMT/photo/IMG_5422.jpg

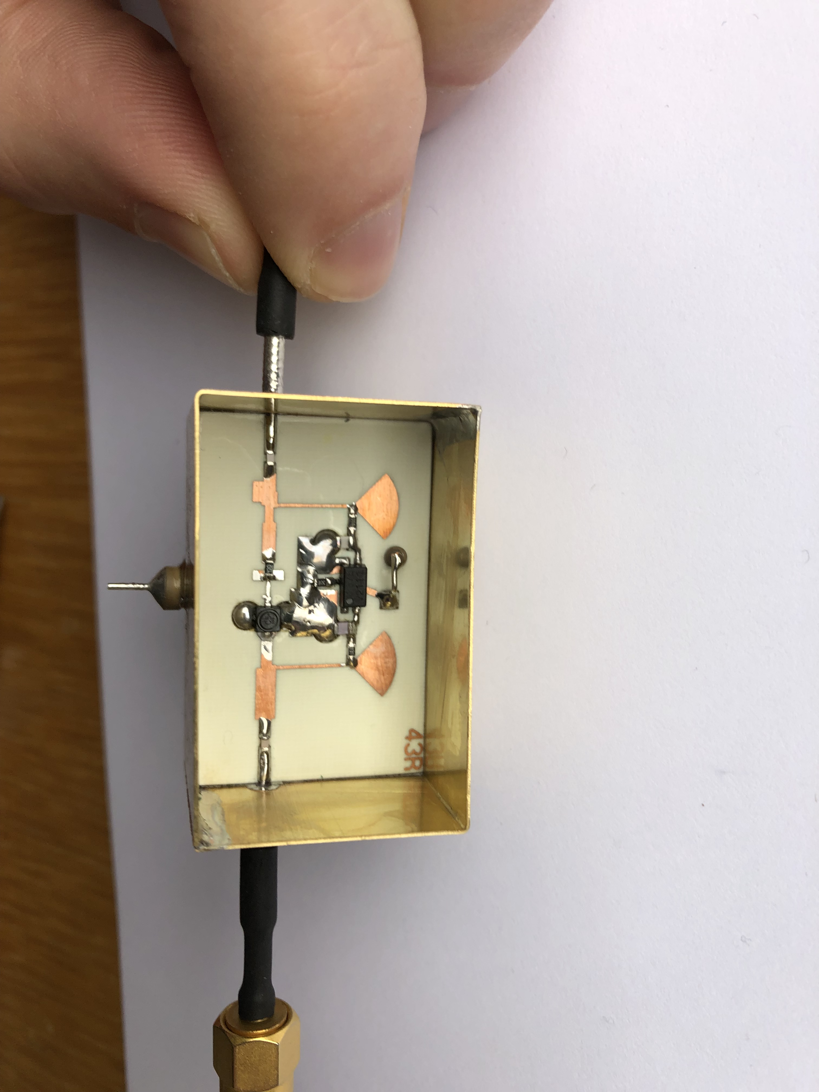
AMP HEMT/photo/IMG_5422.jpg
