aljazblatnik/Spectrum-analyzer/AMP HEMT/photo/IMG_5423.jpg

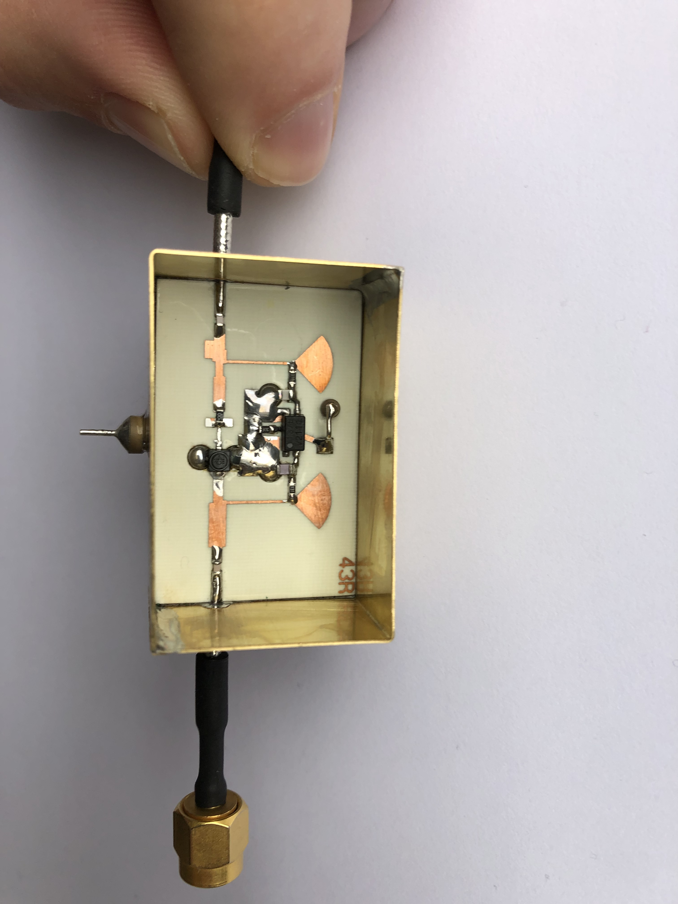
AMP HEMT/photo/IMG_5423.jpg
