aljazblatnik/Spectrum-analyzer/AMP HEMT/photo/IMG_5424.jpg

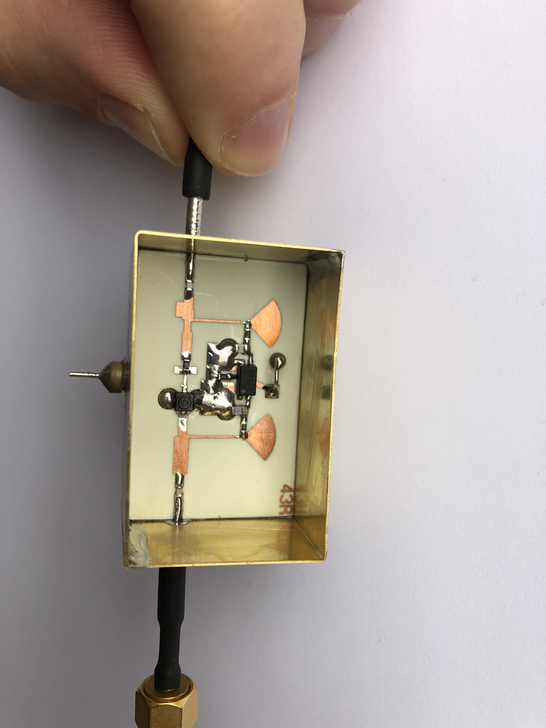
AMP HEMT/photo/IMG_5424.jpg
