aljazblatnik/Spectrum-analyzer/AMP HEMT/photo/IMG_5425.jpg

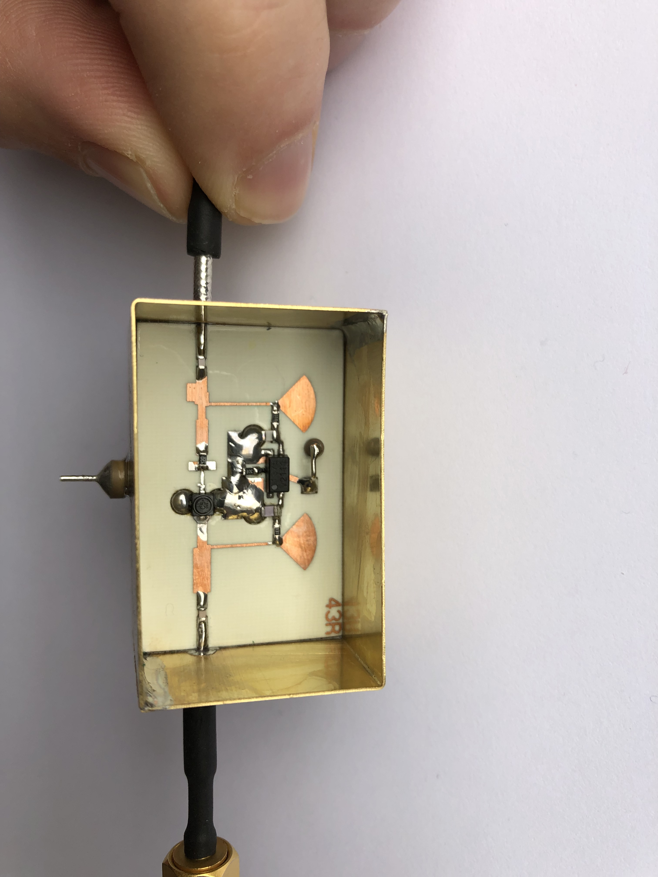
AMP HEMT/photo/IMG_5425.jpg
