aljazblatnik/Spectrum-analyzer/ATT/ATT schematic.png

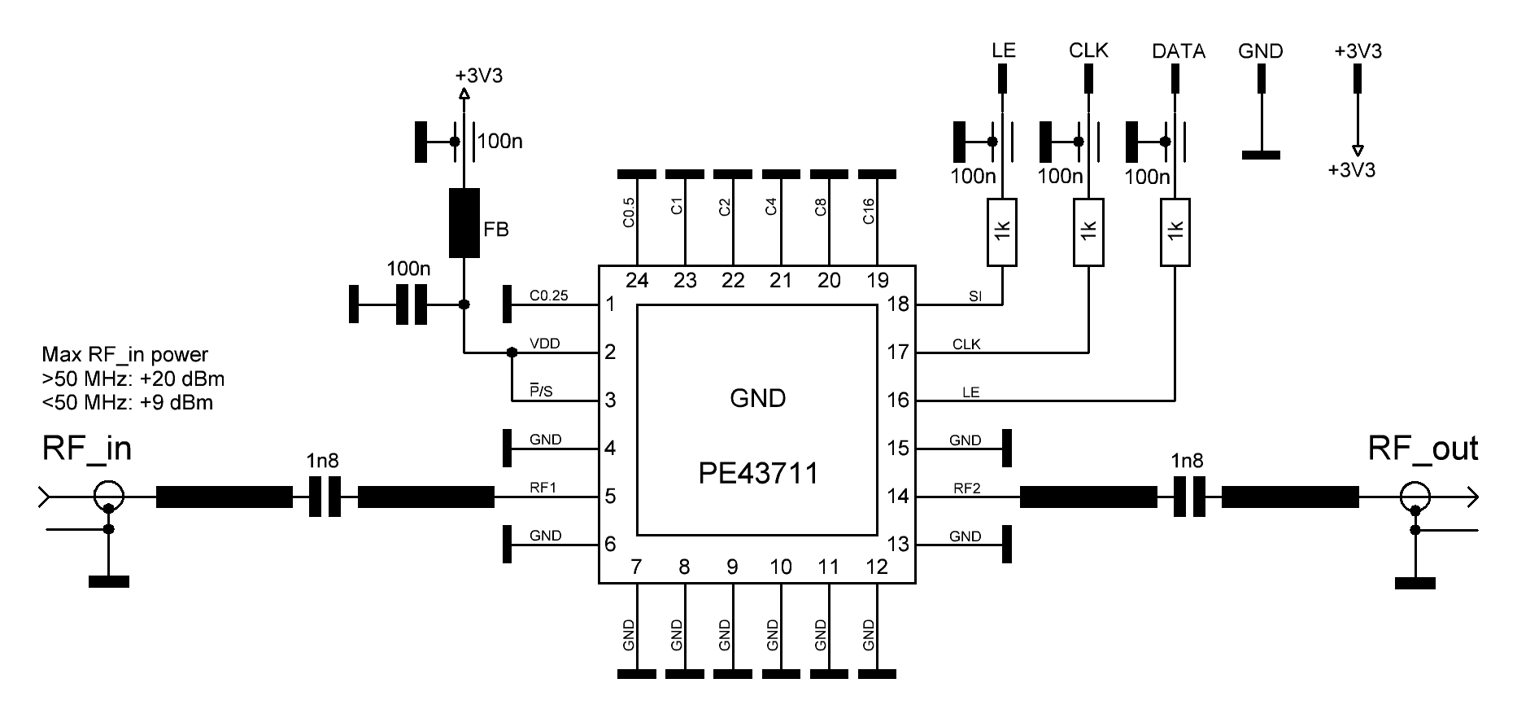
ATT/ATT schematic.png
