aljazblatnik/Spectrum-analyzer/ATT/photo/IMG_4691.jpg

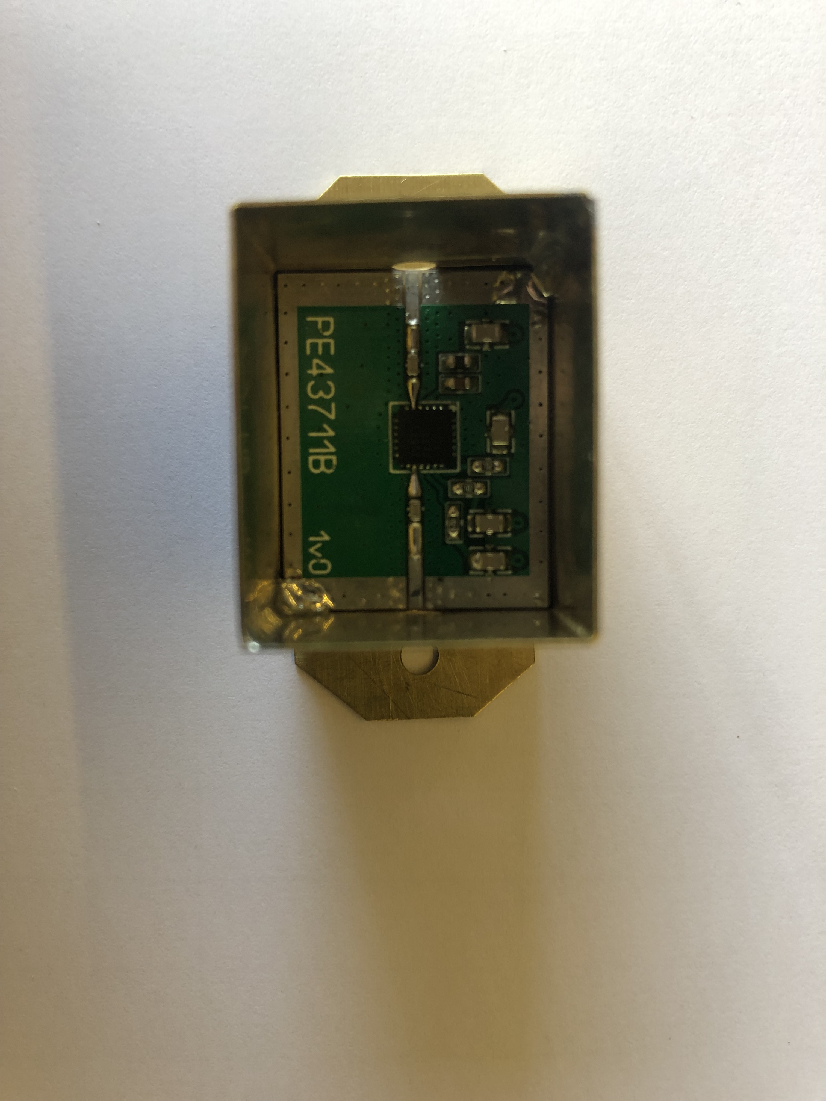
ATT/photo/IMG_4691.jpg
