aljazblatnik/Spectrum-analyzer/ATT/photo/IMG_4693.jpg

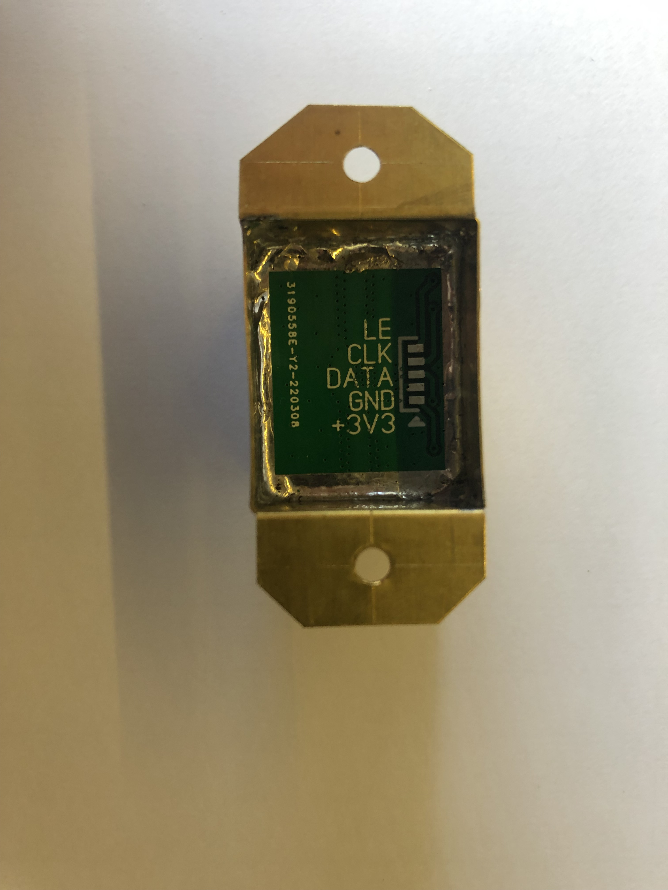
ATT/photo/IMG_4693.jpg
