aljazblatnik/Spectrum-analyzer/ATT/photo/IMG_4694.jpg

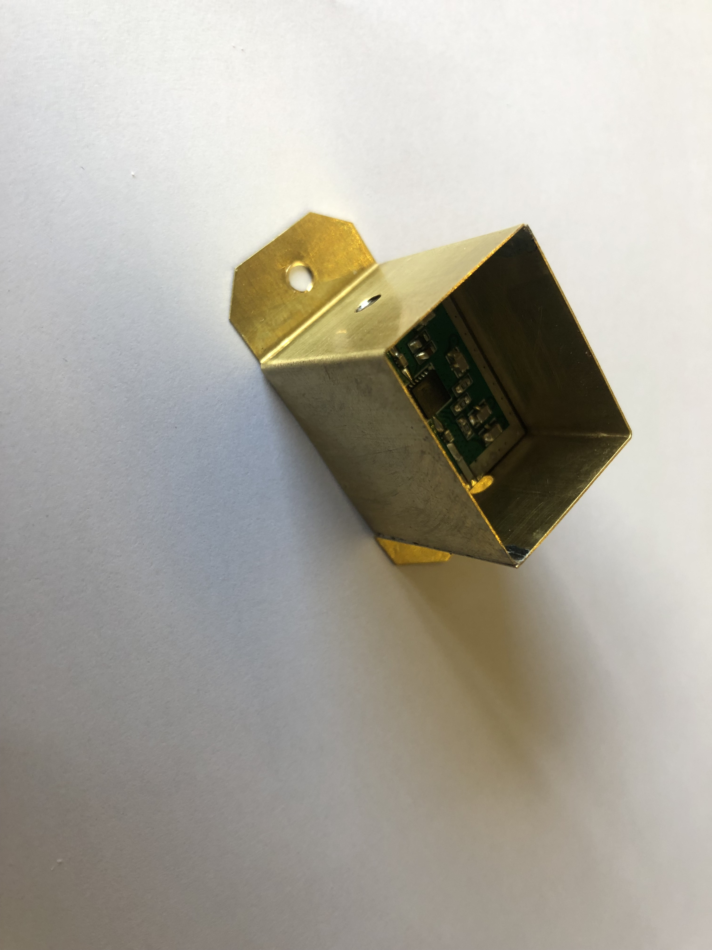
ATT/photo/IMG_4694.jpg
