aljazblatnik/Spectrum-analyzer/ATT/photo/IMG_4695.jpg

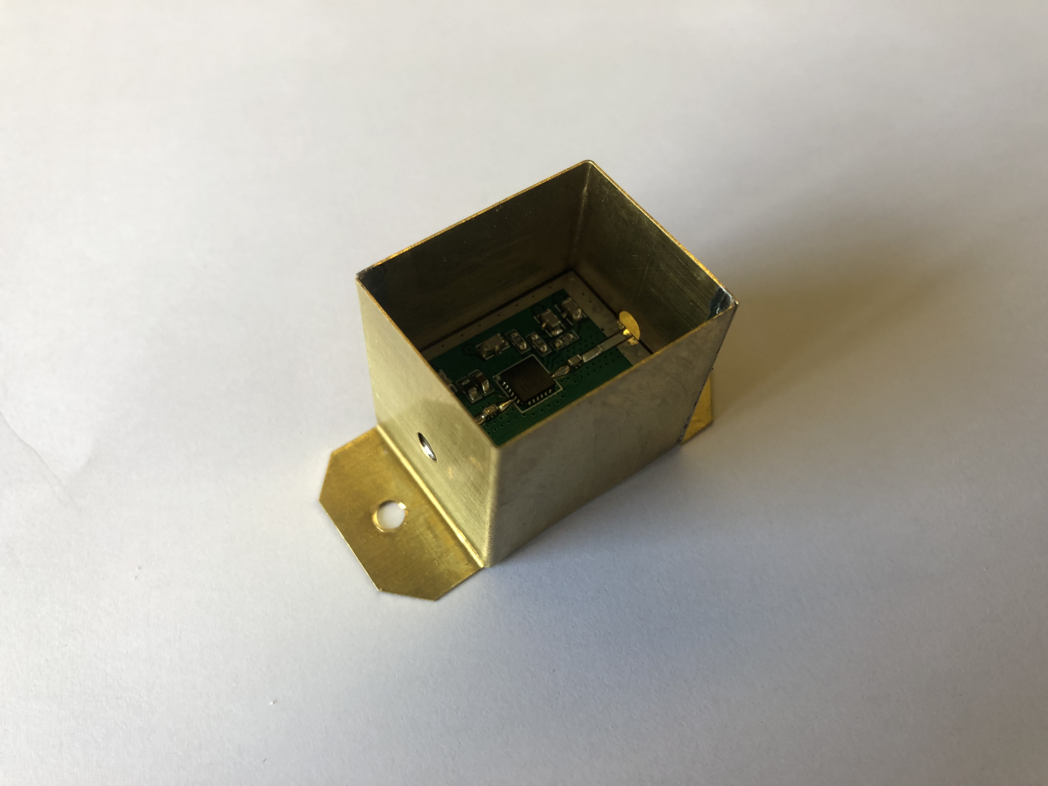
ATT/photo/IMG_4695.jpg
