aljazblatnik/Spectrum-analyzer/ATT/photo/IMG_4974.JPEG

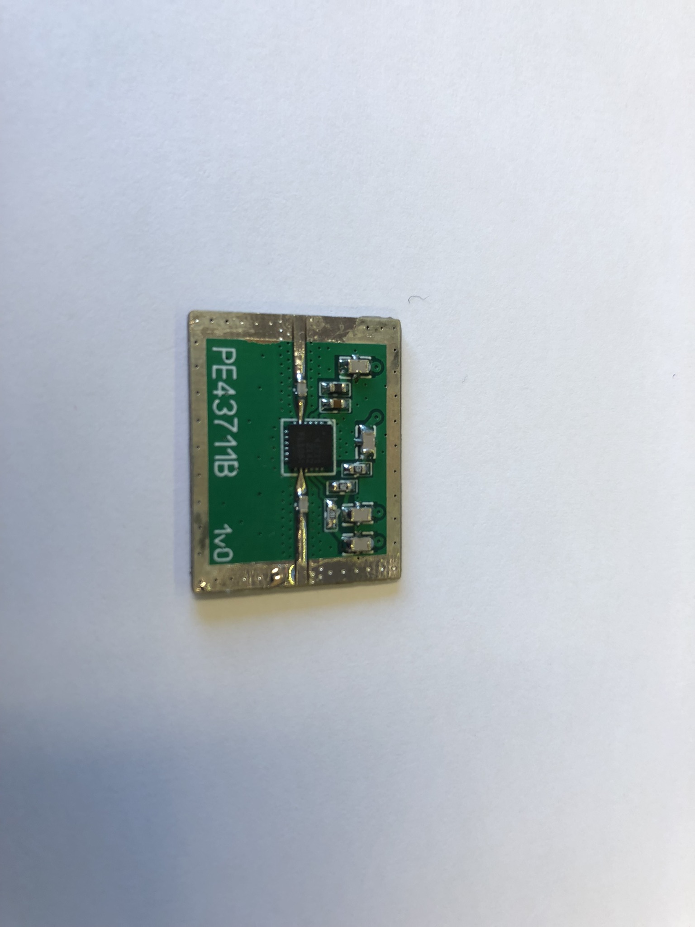
ATT/photo/IMG_4974.JPEG
