aljazblatnik/Spectrum-analyzer/ATT/photo/IMG_4976.JPEG

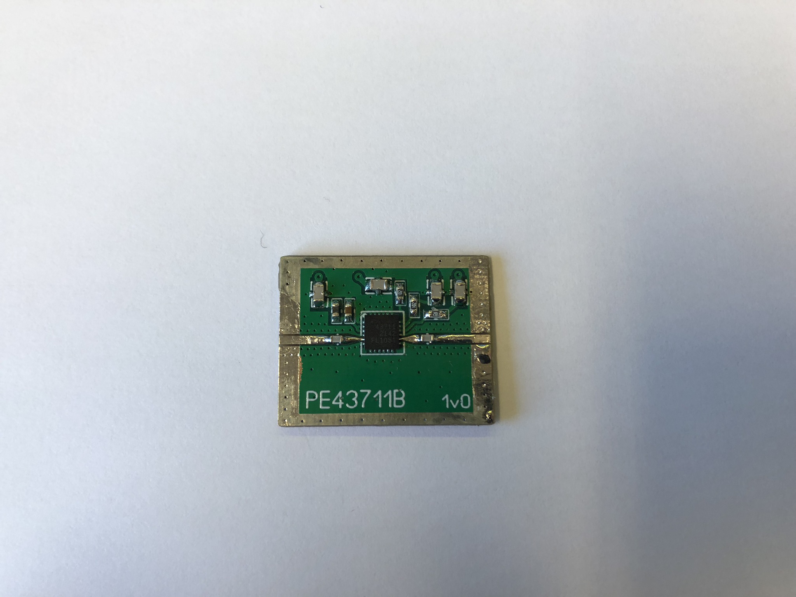
ATT/photo/IMG_4976.JPEG
