aljazblatnik/Spectrum-analyzer/ATT/photo/IMG_4977.JPEG

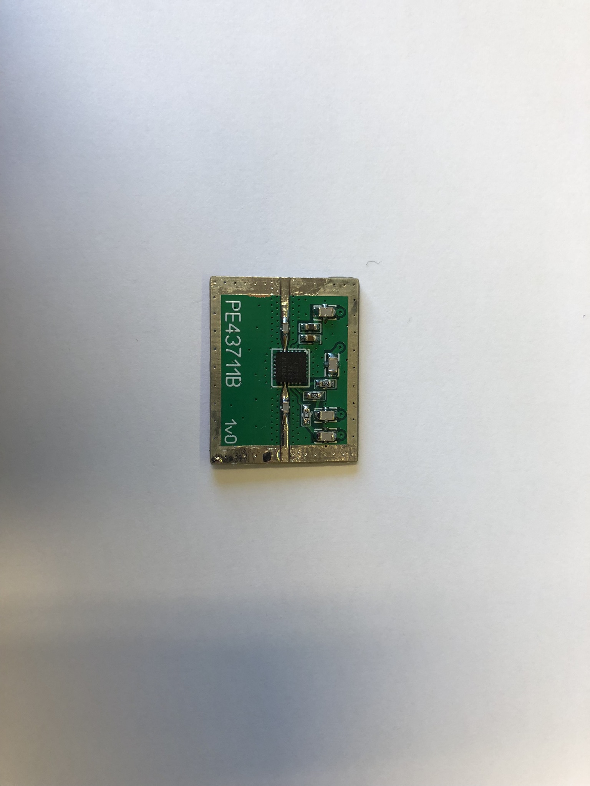
ATT/photo/IMG_4977.JPEG
