aljazblatnik/Spectrum-analyzer/ATT/photo/IMG_4978.JPEG

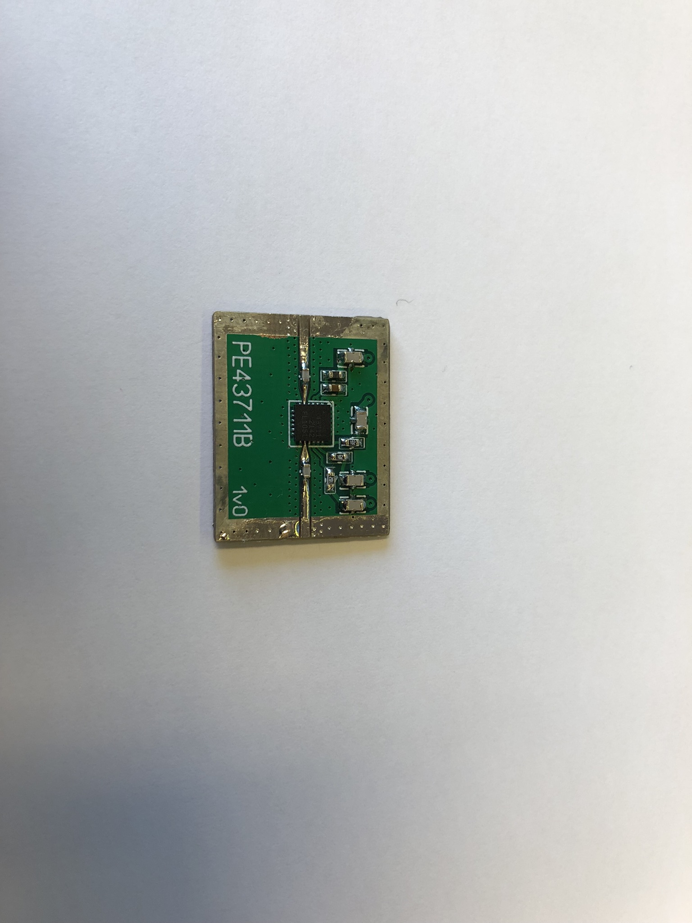
ATT/photo/IMG_4978.JPEG
