aljazblatnik/Spectrum-analyzer/Cavity filter/photo/drilled_holes_bottom.jpg

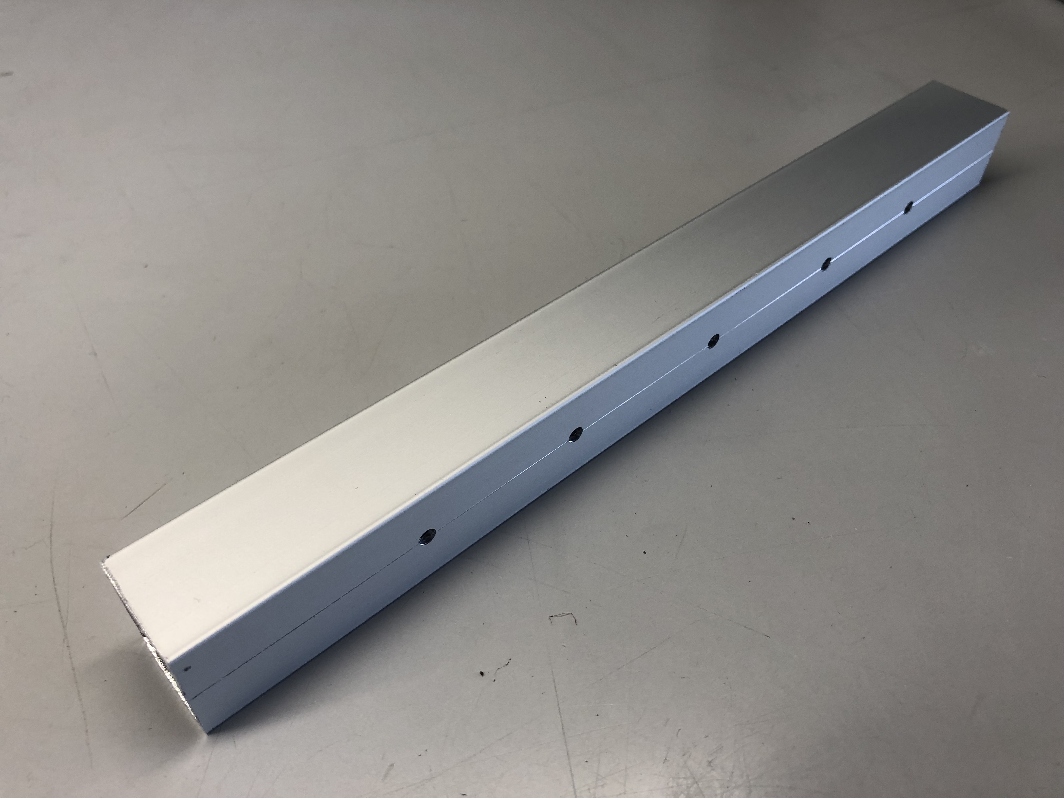
Cavity filter/photo/drilled_holes_bottom.jpg
