aljazblatnik/Spectrum-analyzer/Cavity filter/photo/inside_look.jpg

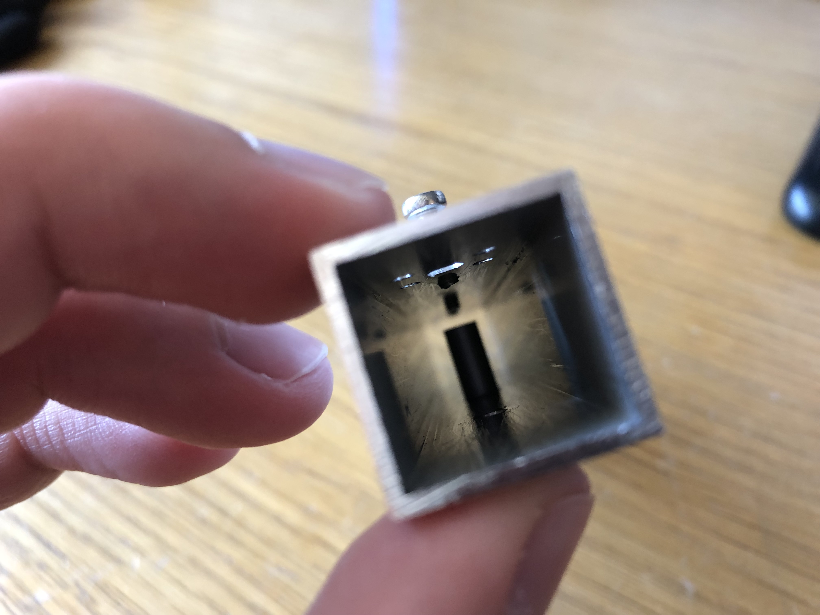
Cavity filter/photo/inside_look.jpg
