aljazblatnik/Spectrum-analyzer/Cavity filter/photo/resonators.jpg

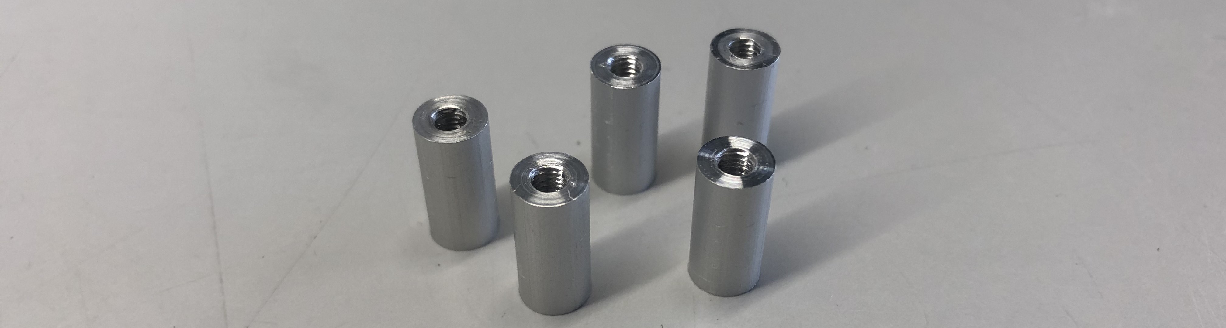
Cavity filter/photo/resonators.jpg
