aljazblatnik/Spectrum-analyzer/LO1/phase noise/LMX2491 5 kHz (frac - 3).png

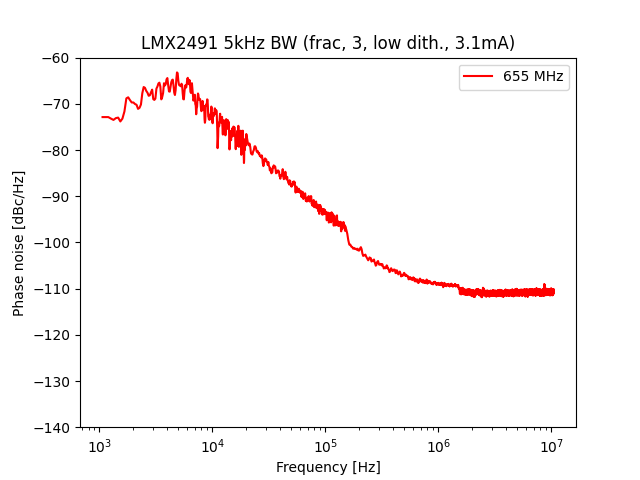
LO1/phase noise/LMX2491 5 kHz (frac - 3).png
