aljazblatnik/Spectrum-analyzer/LO1/phase noise/LMX2491 10 kHz (frac - 3).png

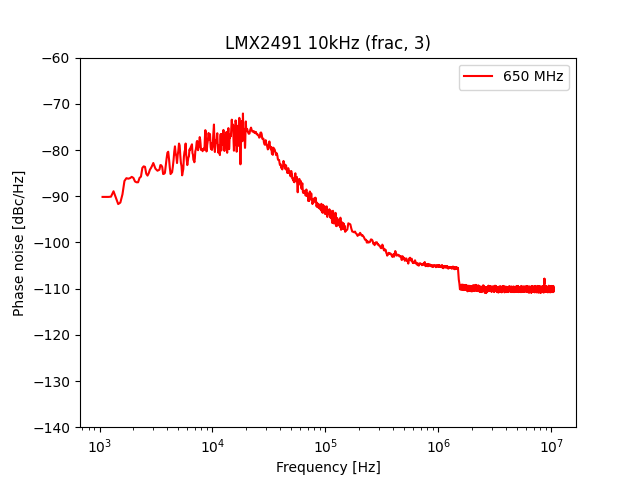
LO1/phase noise/LMX2491 10 kHz (frac - 3).png
