aljazblatnik/Spectrum-analyzer/LO1/phase noise/LMX2491 low jitter (frac - 3 - 100uA.png

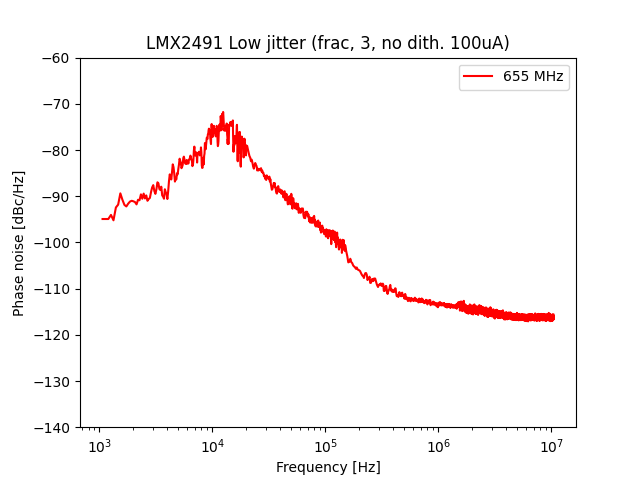
LO1/phase noise/LMX2491 low jitter (frac - 3 - 100uA.png
