aljazblatnik/Spectrum-analyzer/LO1/phase noise/LMX2491 low jitter (int).png

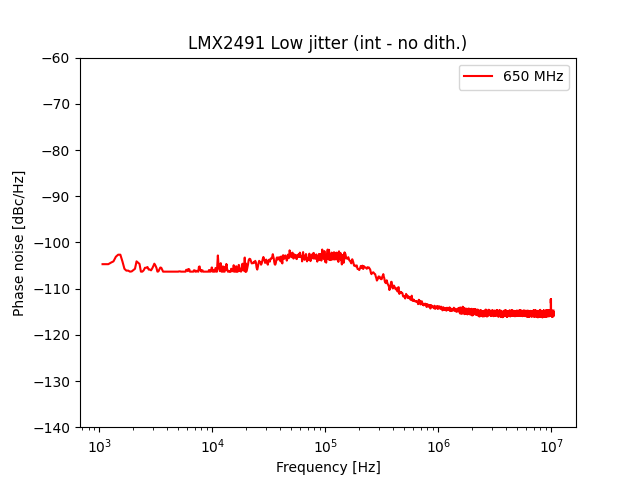
LO1/phase noise/LMX2491 low jitter (int).png
