aljazblatnik/Spectrum-analyzer/LO1/phase noise/LMX+STuW/10kHz_loop_filter.png

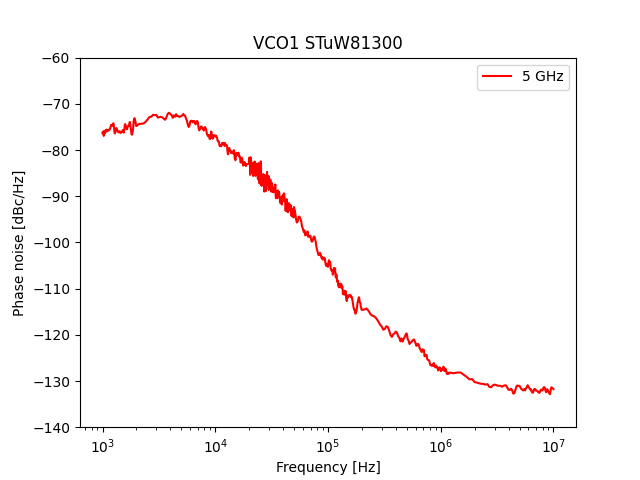
LO1/phase noise/LMX+STuW/10kHz_loop_filter.png
