aljazblatnik/Spectrum-analyzer/LO1/phase noise/LMX+STuW/EXTERNAL AMP/10kHz_loop_filter_HEMT_comparison_positive_gain.png

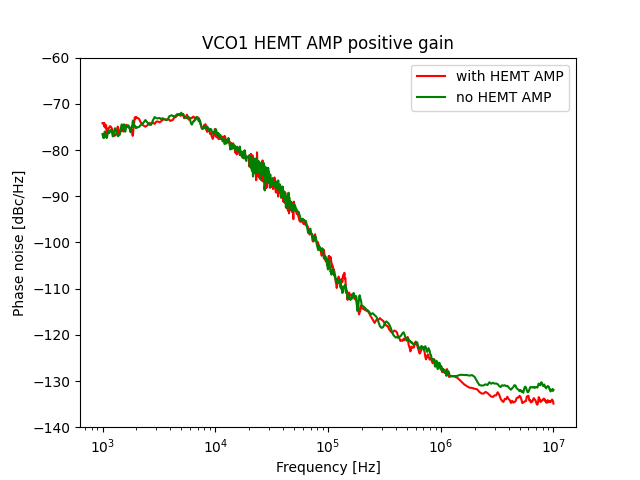
LO1/phase noise/LMX+STuW/EXTERNAL AMP/10kHz_loop_filter_HEMT_comparison_positive_gain.png
