aljazblatnik/Spectrum-analyzer/LO1/phase noise/LMX+STuW/first_try.png

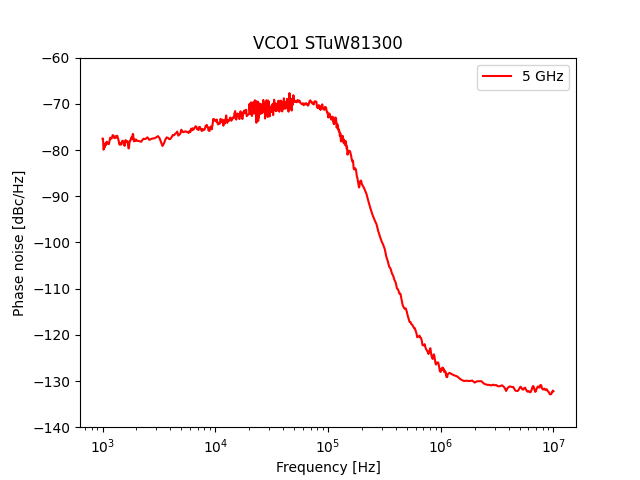
LO1/phase noise/LMX+STuW/first_try.png
