aljazblatnik/Spectrum-analyzer/LO1/phase noise/STuW81300_5GHz.png

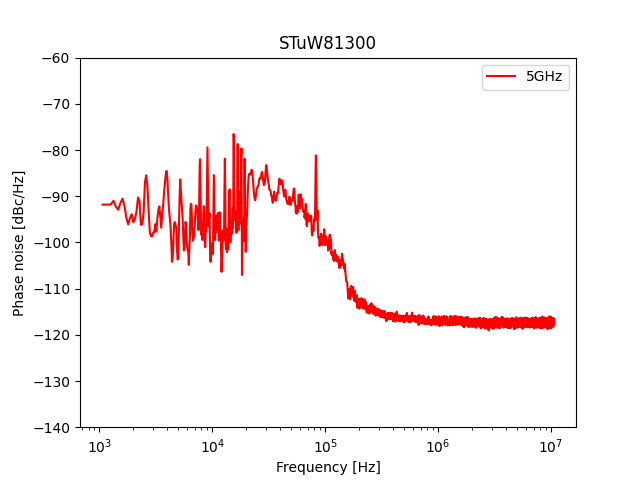
LO1/phase noise/STuW81300_5GHz.png
