aljazblatnik/Spectrum-analyzer/LO1/phase noise/STuW + LMX first try (no loop change).png

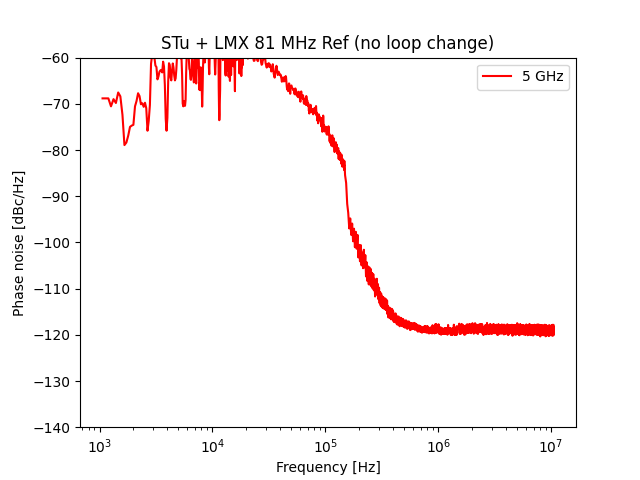
LO1/phase noise/STuW + LMX first try (no loop change).png
