aljazblatnik/Spectrum-analyzer/LO1/phase noise/v2 pcb/amp gain/LMX2491 resistor.png

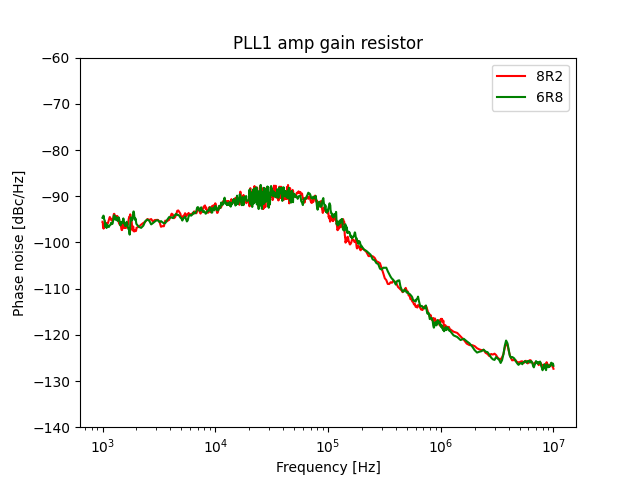
LO1/phase noise/v2 pcb/amp gain/LMX2491 resistor.png
