aljazblatnik/Spectrum-analyzer/LO1/phase noise/v2 pcb/crystal_generator_clk_com/PLL1_1_30_kHz_proto2.png

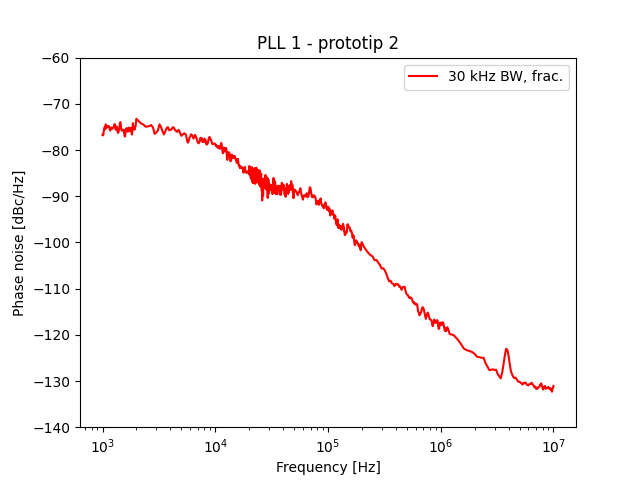
LO1/phase noise/v2 pcb/crystal_generator_clk_com/PLL1_1_30_kHz_proto2.png
