aljazblatnik/Spectrum-analyzer/LO1/phase noise/v2 pcb/dither/PLL_1_dith_modes.png

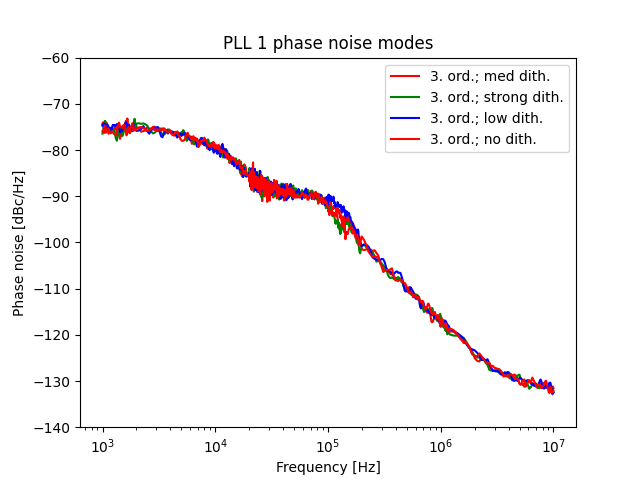
LO1/phase noise/v2 pcb/dither/PLL_1_dith_modes.png
