aljazblatnik/Spectrum-analyzer/LO1/phase noise/v2 pcb/modulator/PLL_1_modulator_modes.png

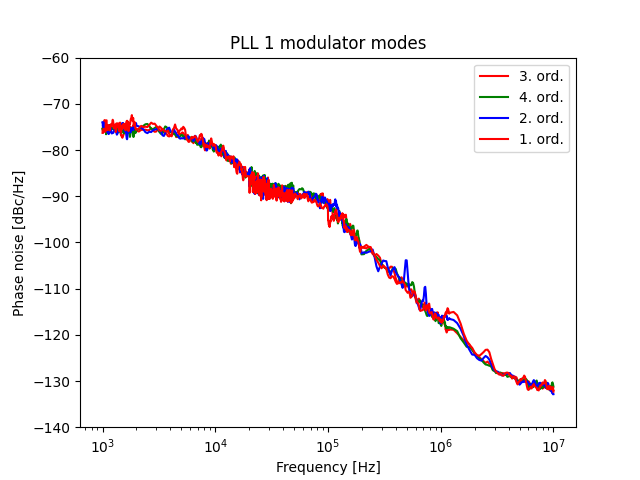
LO1/phase noise/v2 pcb/modulator/PLL_1_modulator_modes.png
