aljazblatnik/Spectrum-analyzer/LO3/LO3 schematic.png

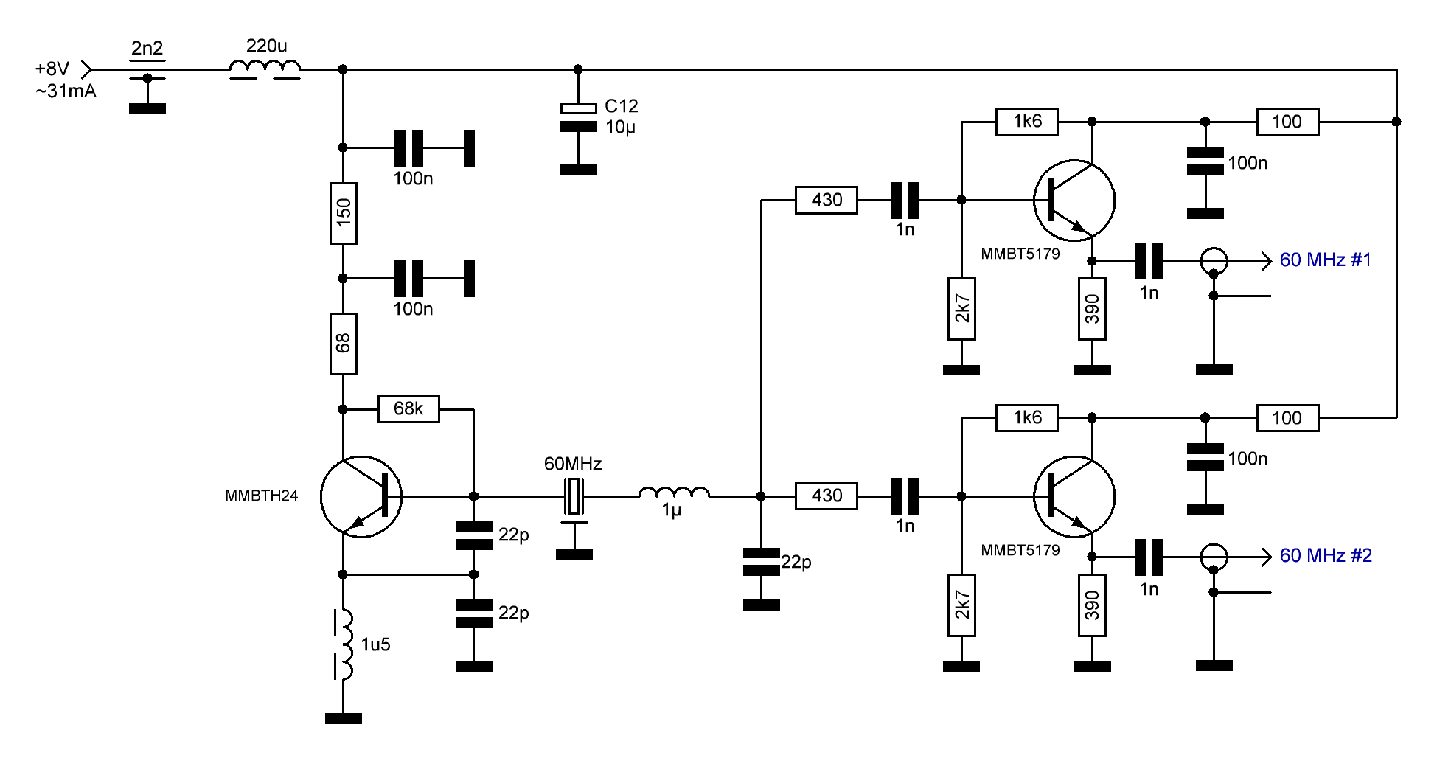
LO3/LO3 schematic.png
