aljazblatnik/Spectrum-analyzer/LO3/photo/IMG_5108.jpg

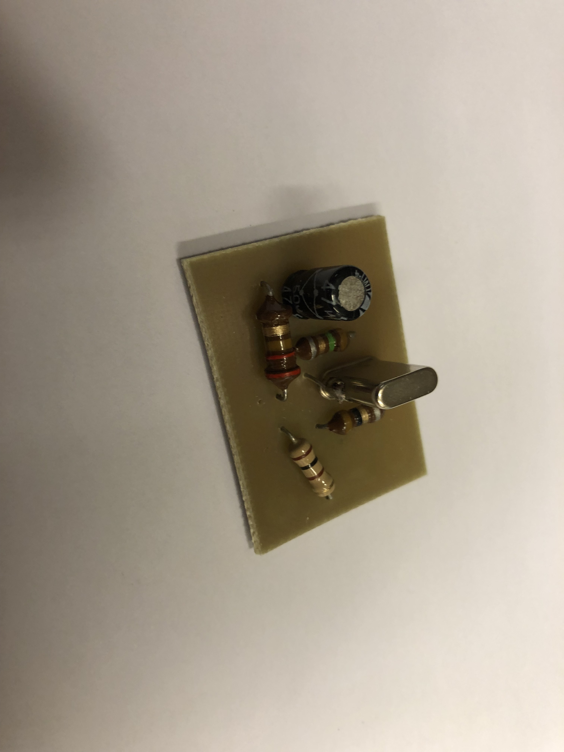
LO3/photo/IMG_5108.jpg
