aljazblatnik/Spectrum-analyzer/LO3/photo/IMG_5109.jpg

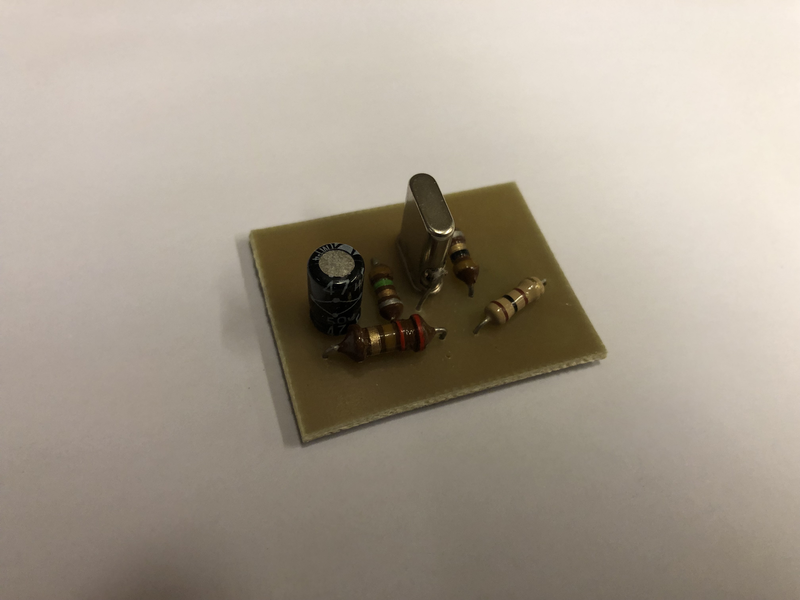
LO3/photo/IMG_5109.jpg
