aljazblatnik/Spectrum-analyzer/LO3/photo/IMG_5110.jpg

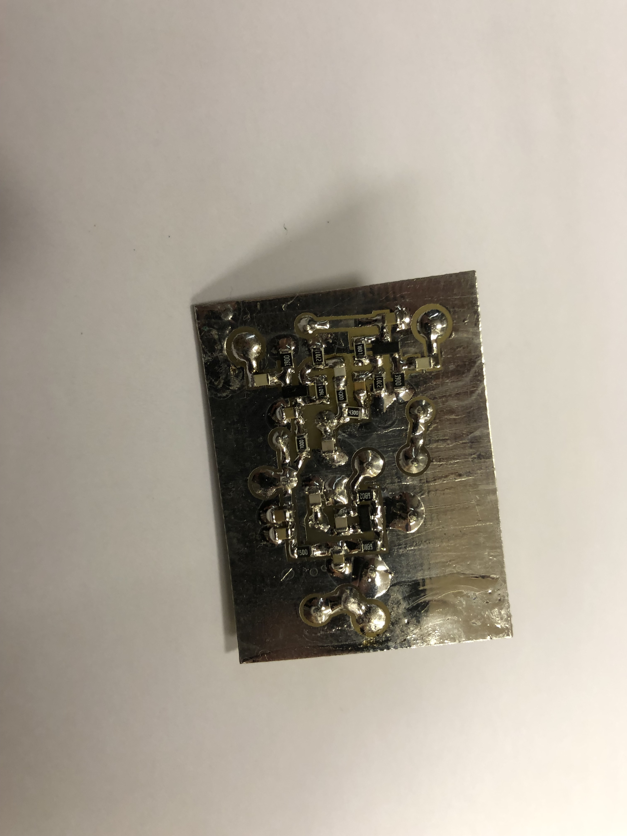
LO3/photo/IMG_5110.jpg
