aljazblatnik/Spectrum-analyzer/LO3/photo/IMG_5112.jpg

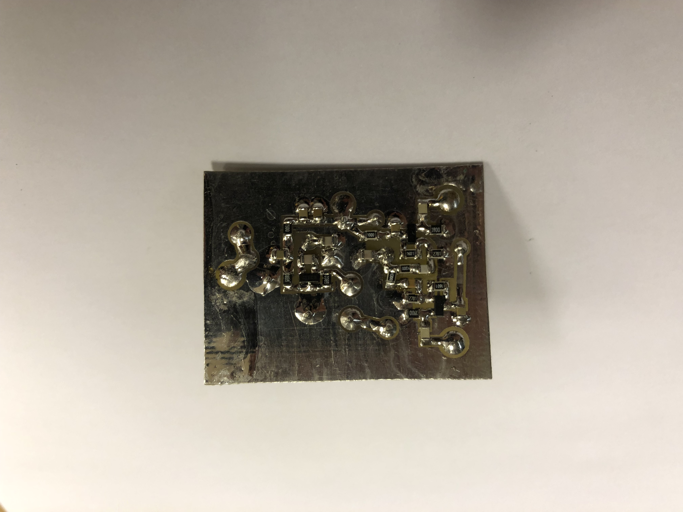
LO3/photo/IMG_5112.jpg
