aljazblatnik/Spectrum-analyzer/LOG detector/LOG schematic.png

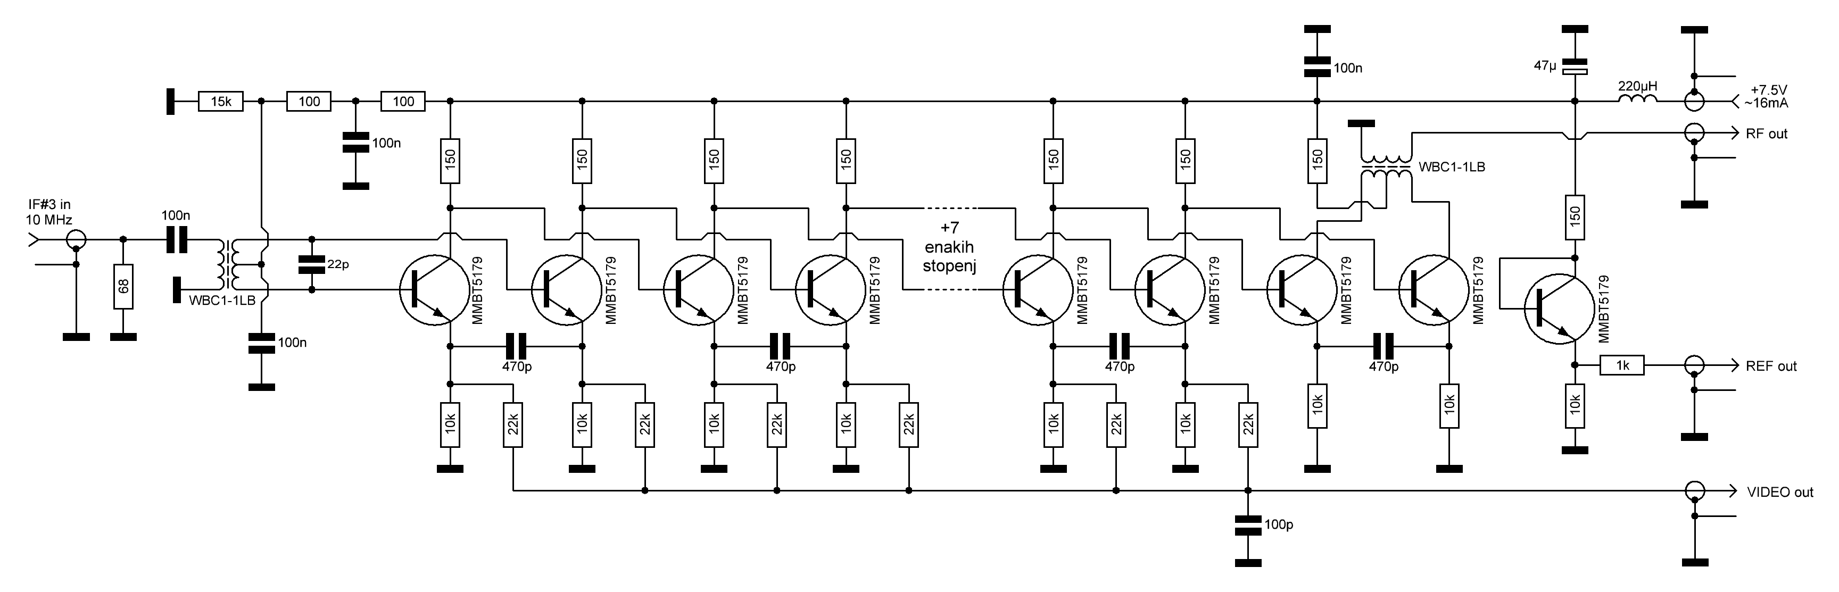
LOG detector/LOG schematic.png
