aljazblatnik/Spectrum-analyzer/LOG detector/photo/IMG_4850.jpg

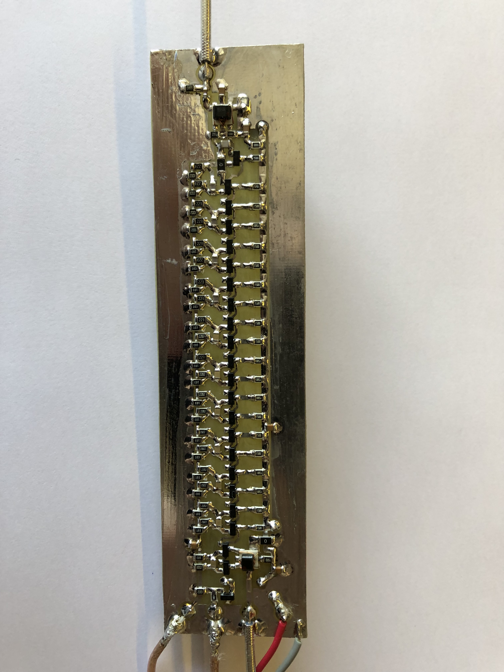
LOG detector/photo/IMG_4850.jpg
