aljazblatnik/Spectrum-analyzer/LOG detector/photo/IMG_4851.jpg

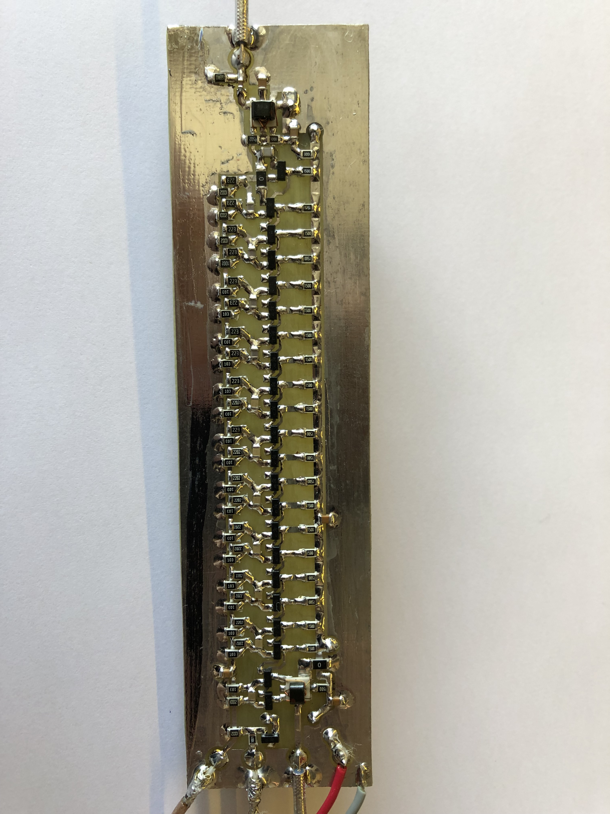
LOG detector/photo/IMG_4851.jpg
