aljazblatnik/Spectrum-analyzer/LOG detector/photo/IMG_4852.jpg

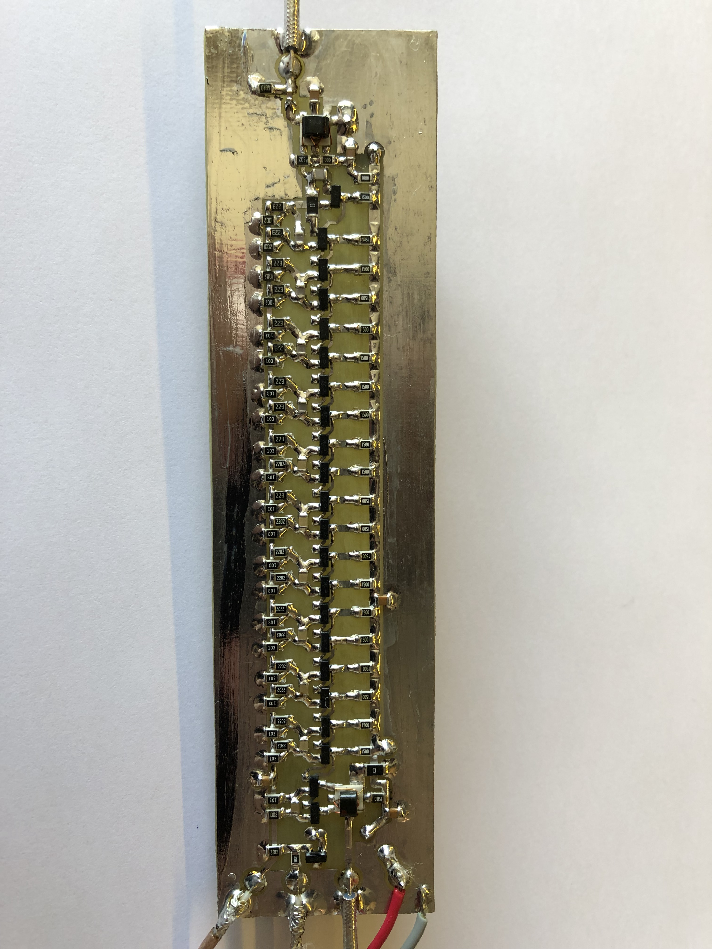
LOG detector/photo/IMG_4852.jpg
