aljazblatnik/Spectrum-analyzer/LOG detector/photo/IMG_4853.jpg

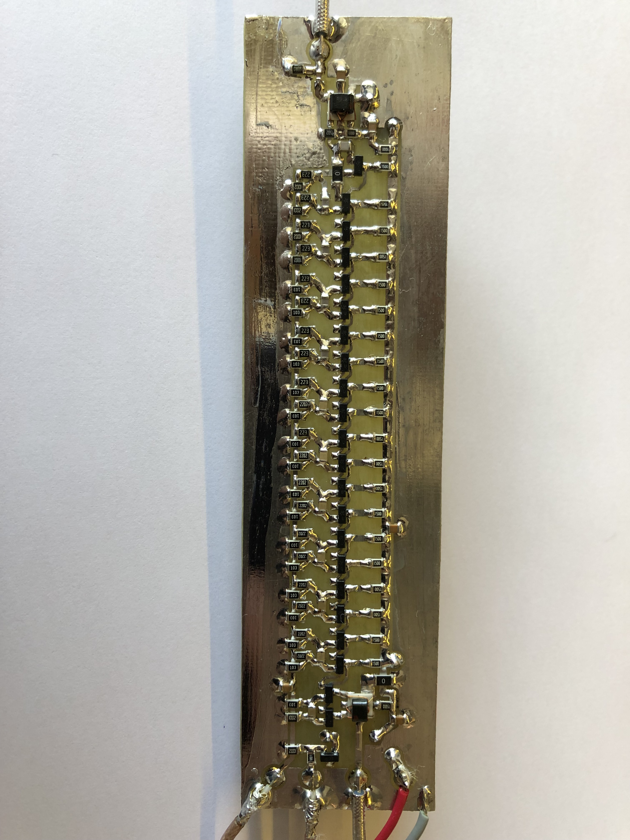
LOG detector/photo/IMG_4853.jpg
