aljazblatnik/Spectrum-analyzer/LOG detector/photo/IMG_4954.JPEG

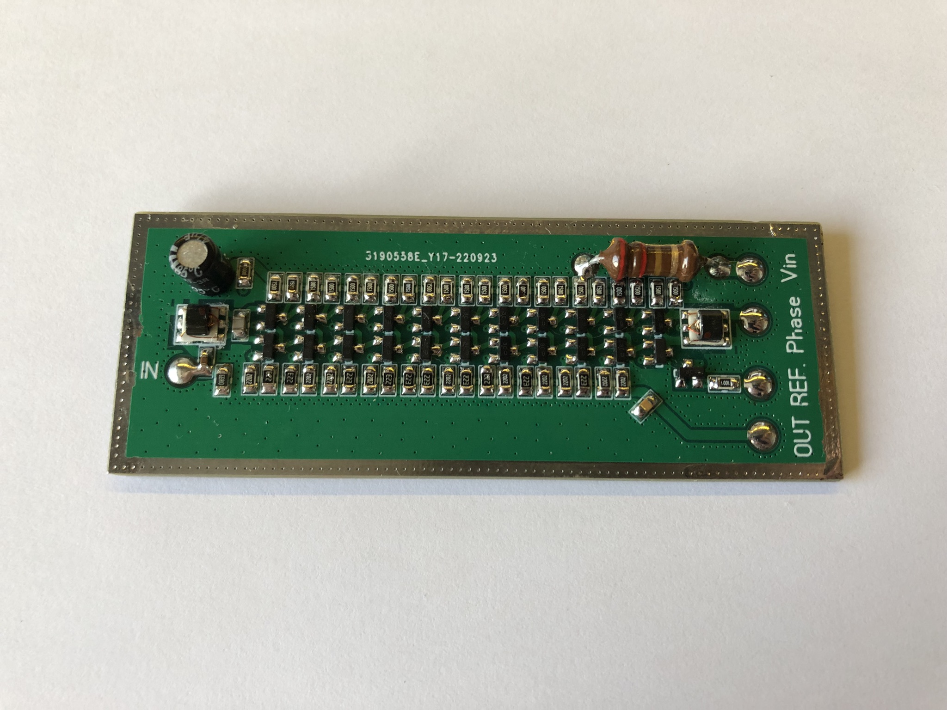
LOG detector/photo/IMG_4954.JPEG
