aljazblatnik/Spectrum-analyzer/LOG detector/photo/IMG_4955.JPEG

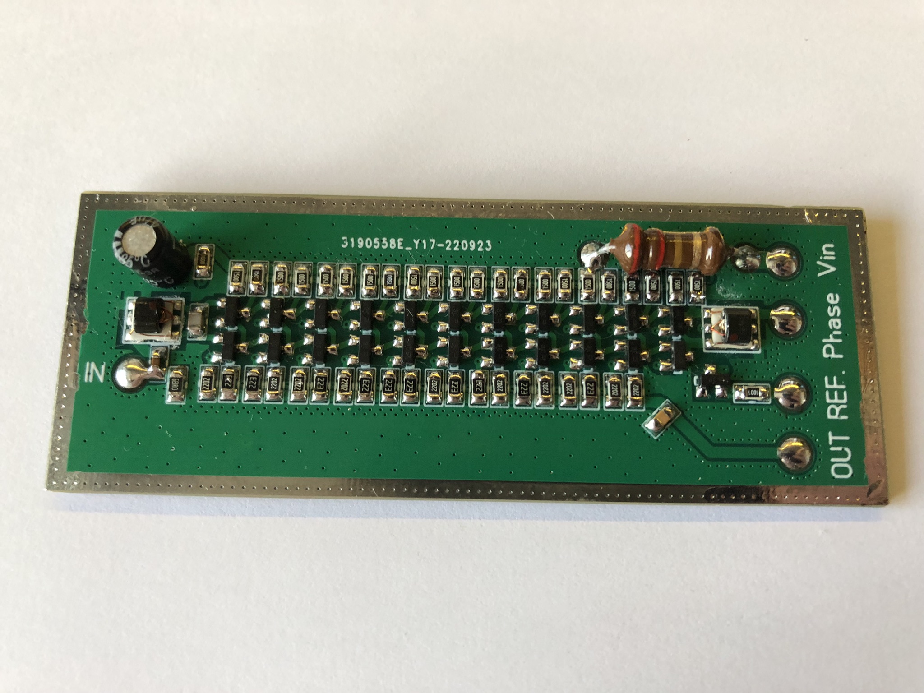
LOG detector/photo/IMG_4955.JPEG
