aljazblatnik/Spectrum-analyzer/LOG detector/photo/IMG_4956.JPEG

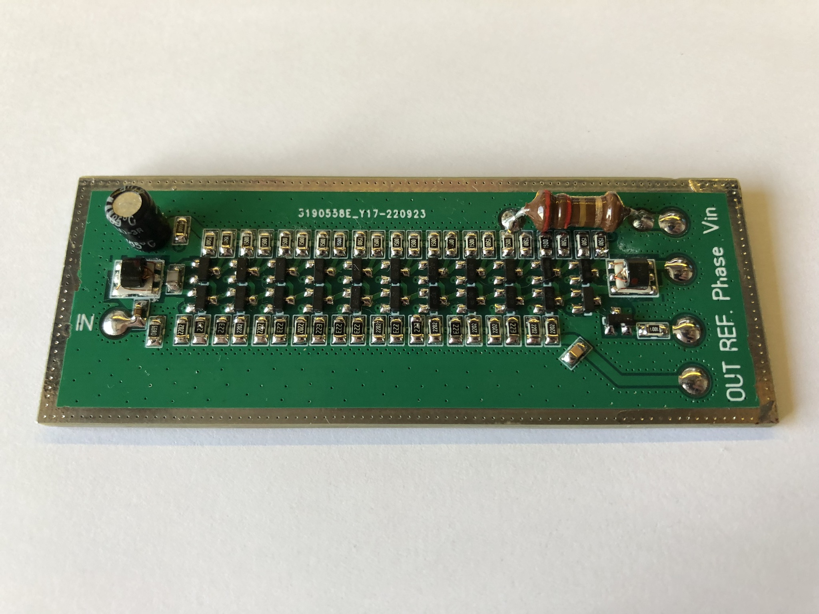
LOG detector/photo/IMG_4956.JPEG
