aljazblatnik/Spectrum-analyzer/LOG detector/photo/IMG_4957.JPEG

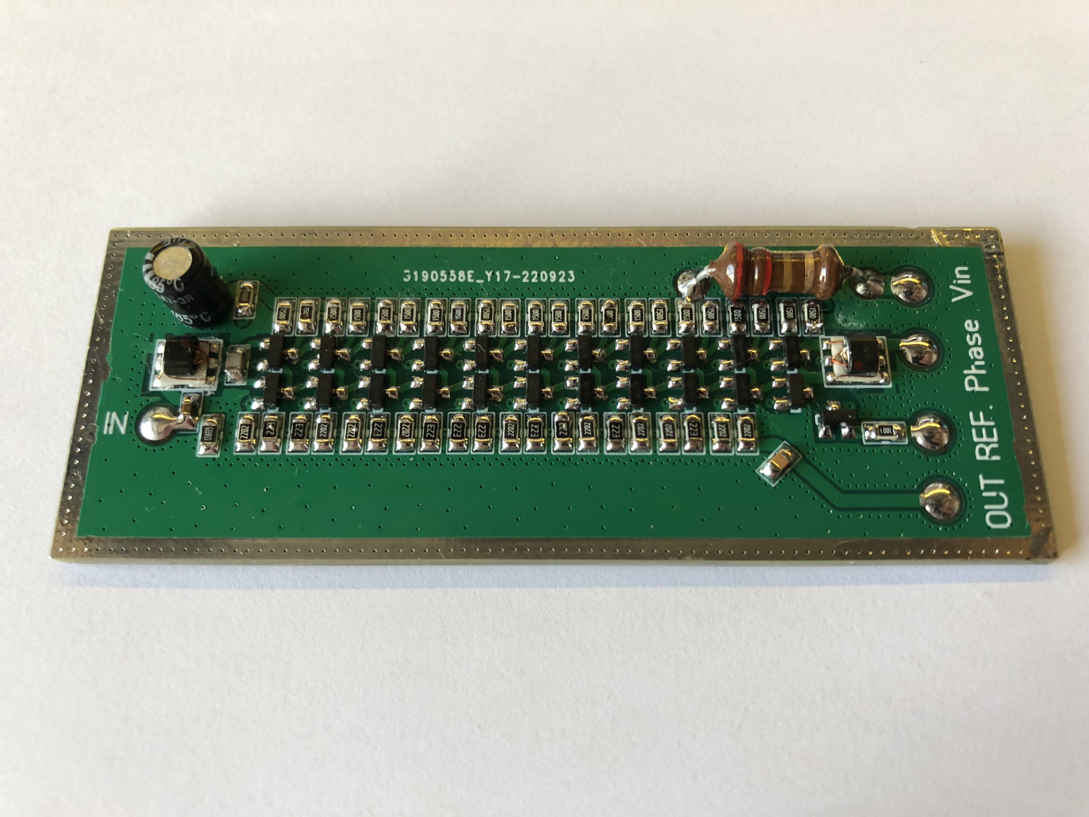
LOG detector/photo/IMG_4957.JPEG
