aljazblatnik/Spectrum-analyzer/LOG detector/photo/IMG_4959.JPEG

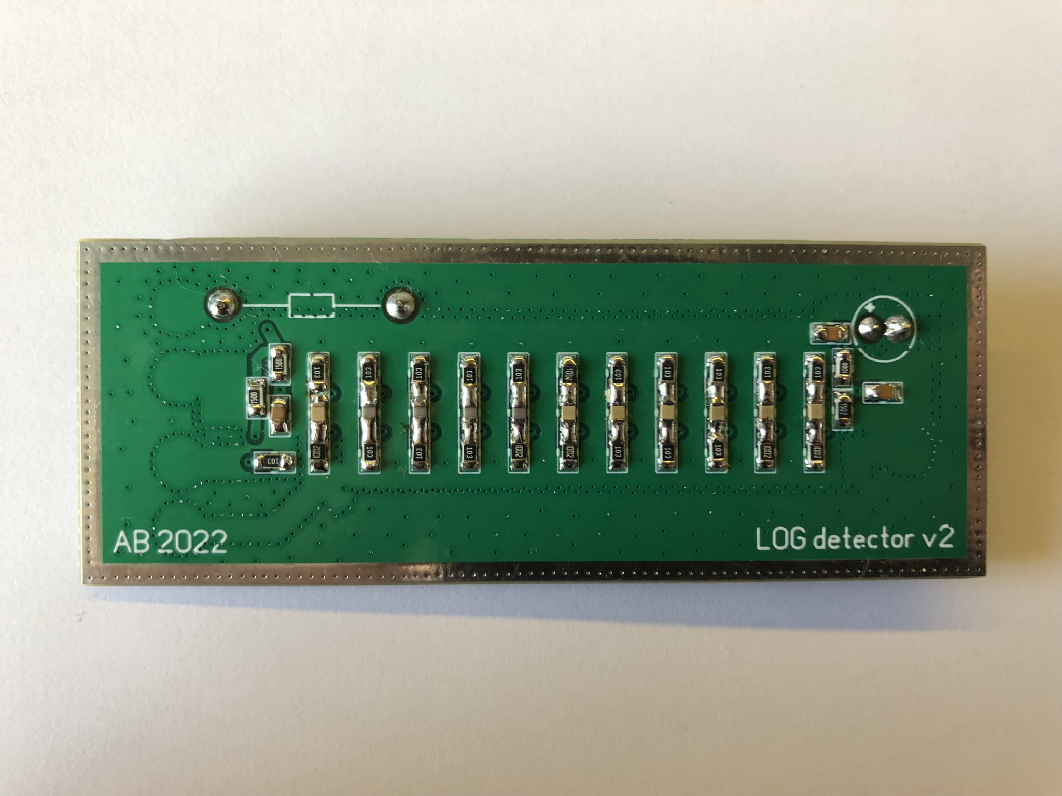
LOG detector/photo/IMG_4959.JPEG
