aljazblatnik/Spectrum-analyzer/LOG detector/photo/IMG_4962.JPEG

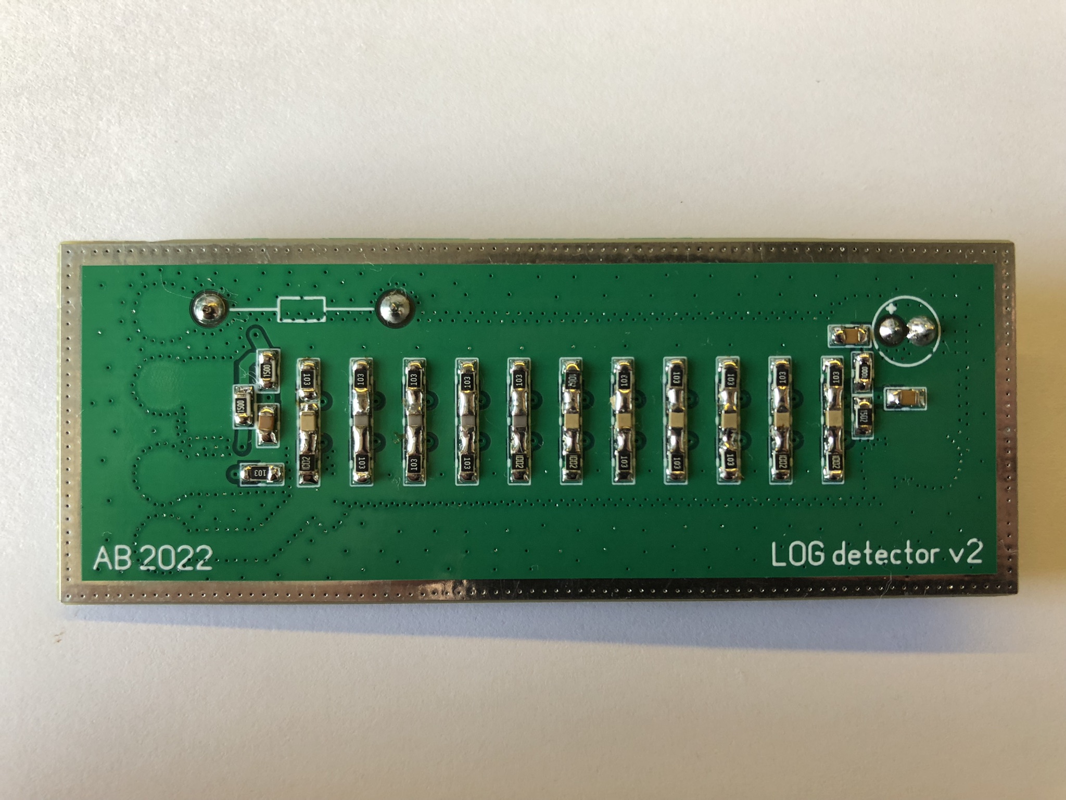
LOG detector/photo/IMG_4962.JPEG
