aljazblatnik/Spectrum-analyzer/LOG detector/photo/IMG_5260.jpg

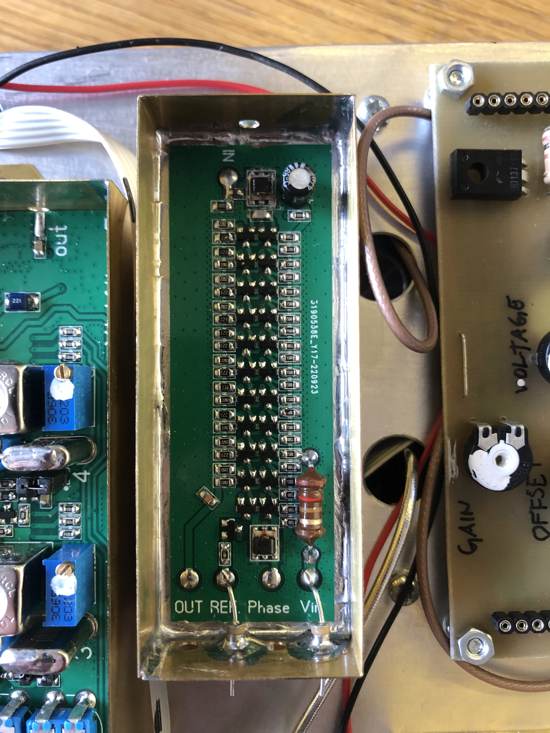
LOG detector/photo/IMG_5260.jpg
