aljazblatnik/Spectrum-analyzer/MCU/MCU schematic.png

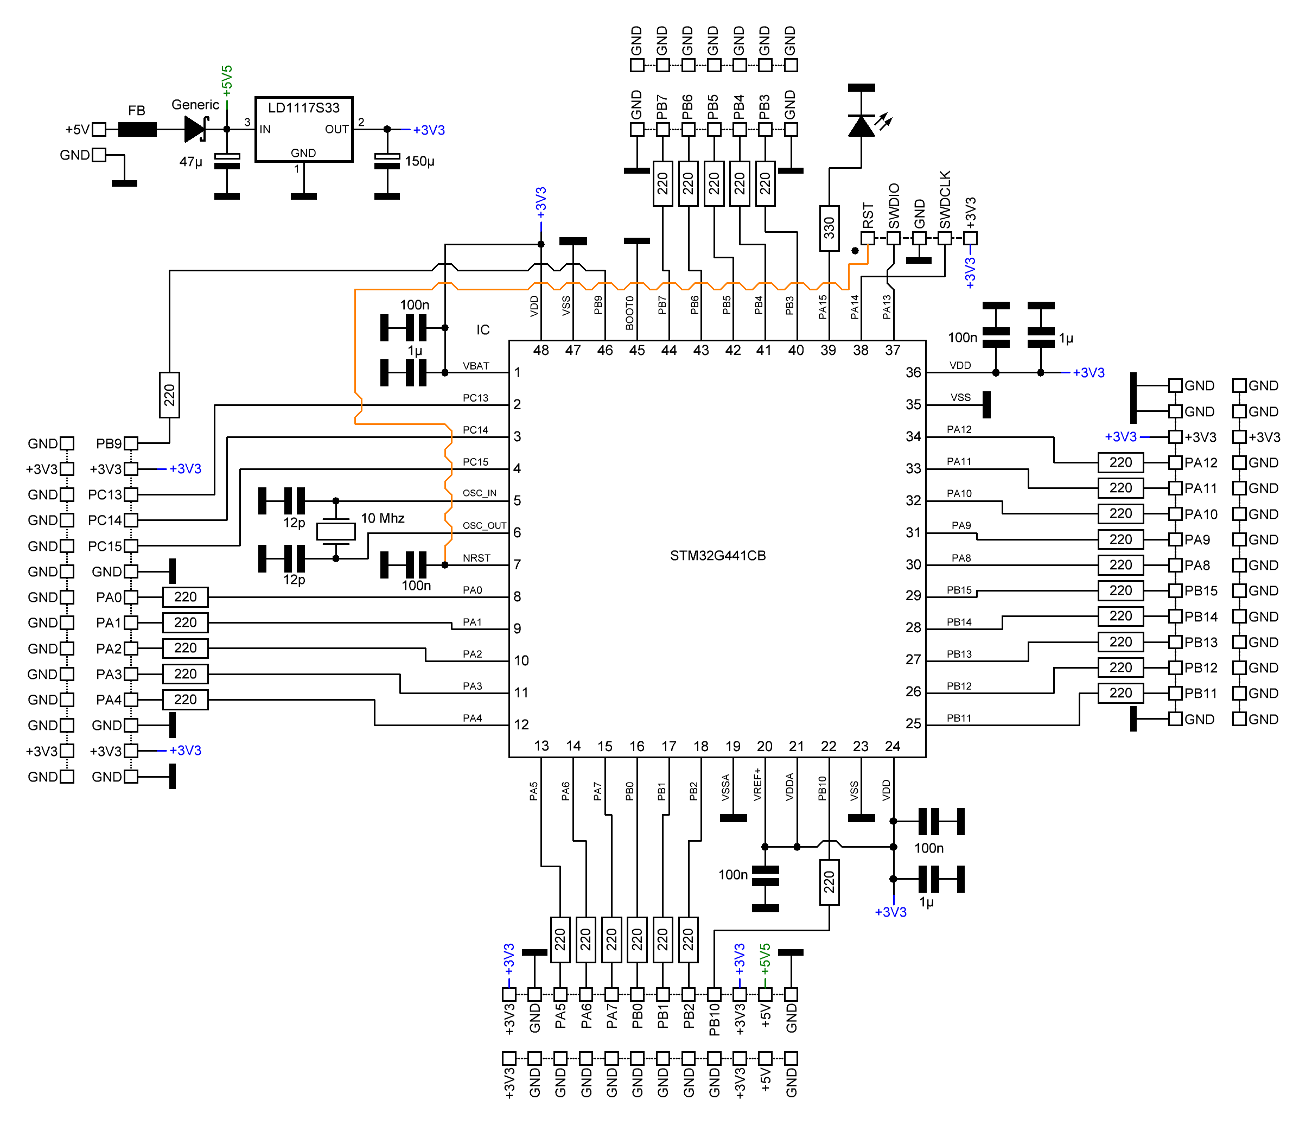
MCU/MCU schematic.png
