aljazblatnik/Spectrum-analyzer/MCU/photo/IMG_5297.jpg

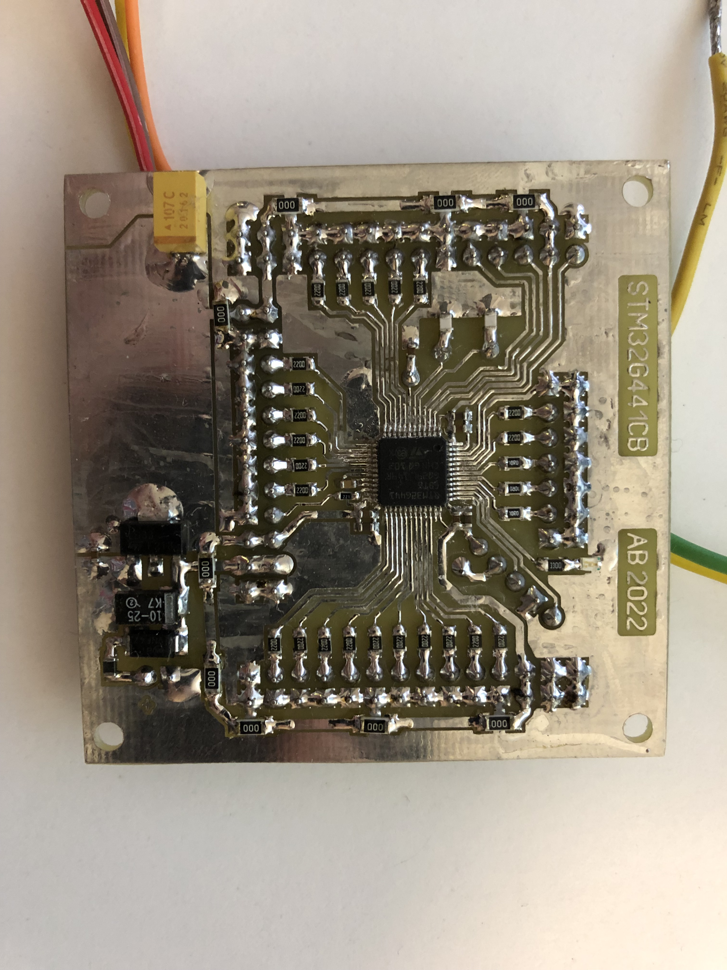
MCU/photo/IMG_5297.jpg
