aljazblatnik/Spectrum-analyzer/MCU/photo/IMG_5298.jpg

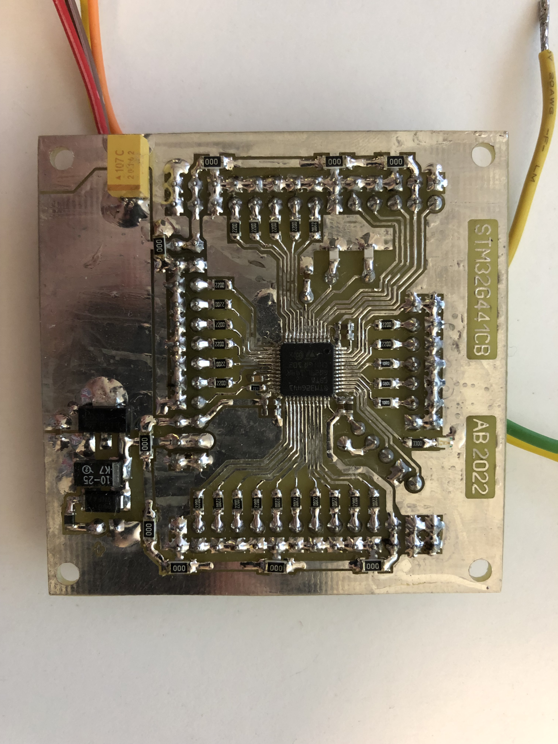
MCU/photo/IMG_5298.jpg
