aljazblatnik/Spectrum-analyzer/MCU/photo/IMG_5299.jpg

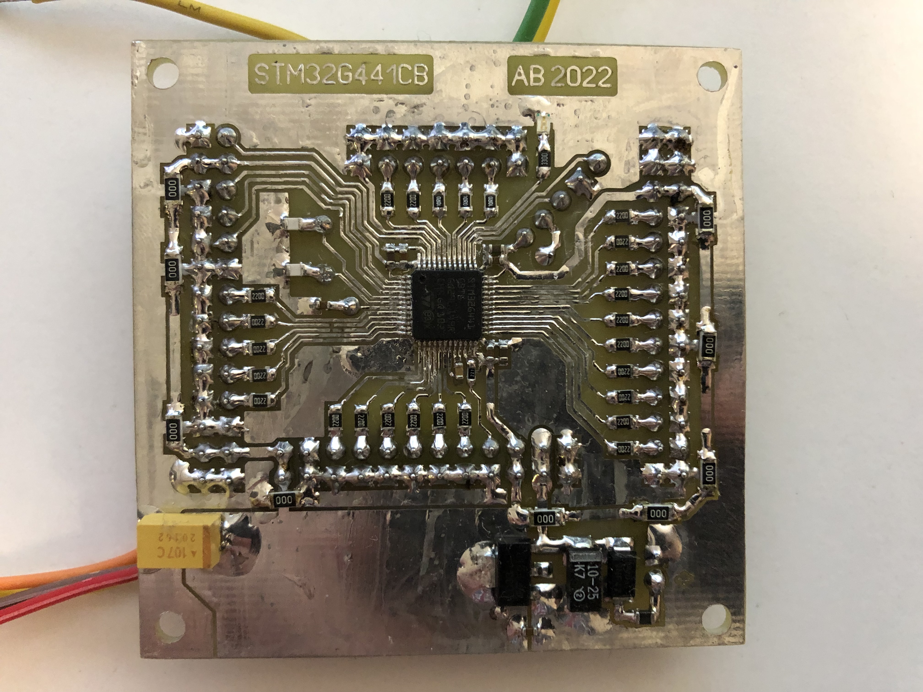
MCU/photo/IMG_5299.jpg
