aljazblatnik/Spectrum-analyzer/MCU/photo/IMG_5300.jpg

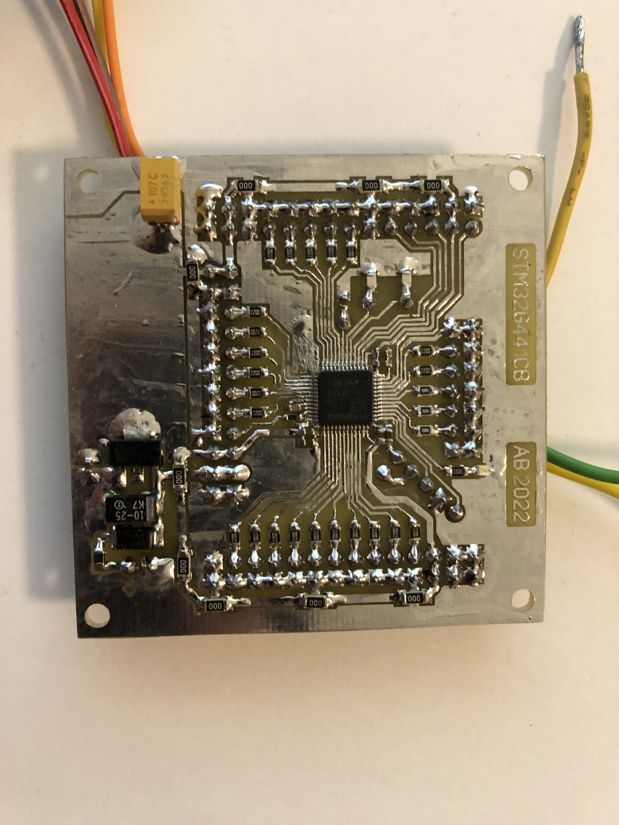
MCU/photo/IMG_5300.jpg
