aljazblatnik/Spectrum-analyzer/MCU/photo/IMG_5302.jpg

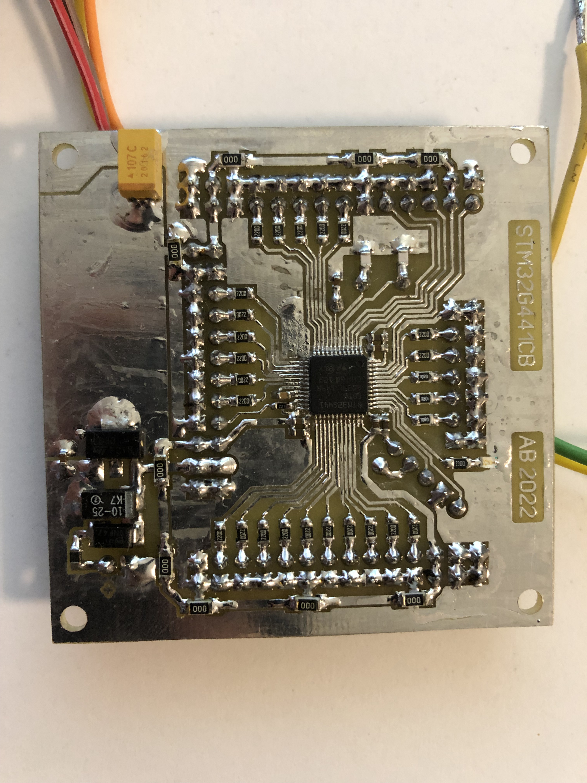
MCU/photo/IMG_5302.jpg
