aljazblatnik/Spectrum-analyzer/MCU/photo/IMG_5309.jpg

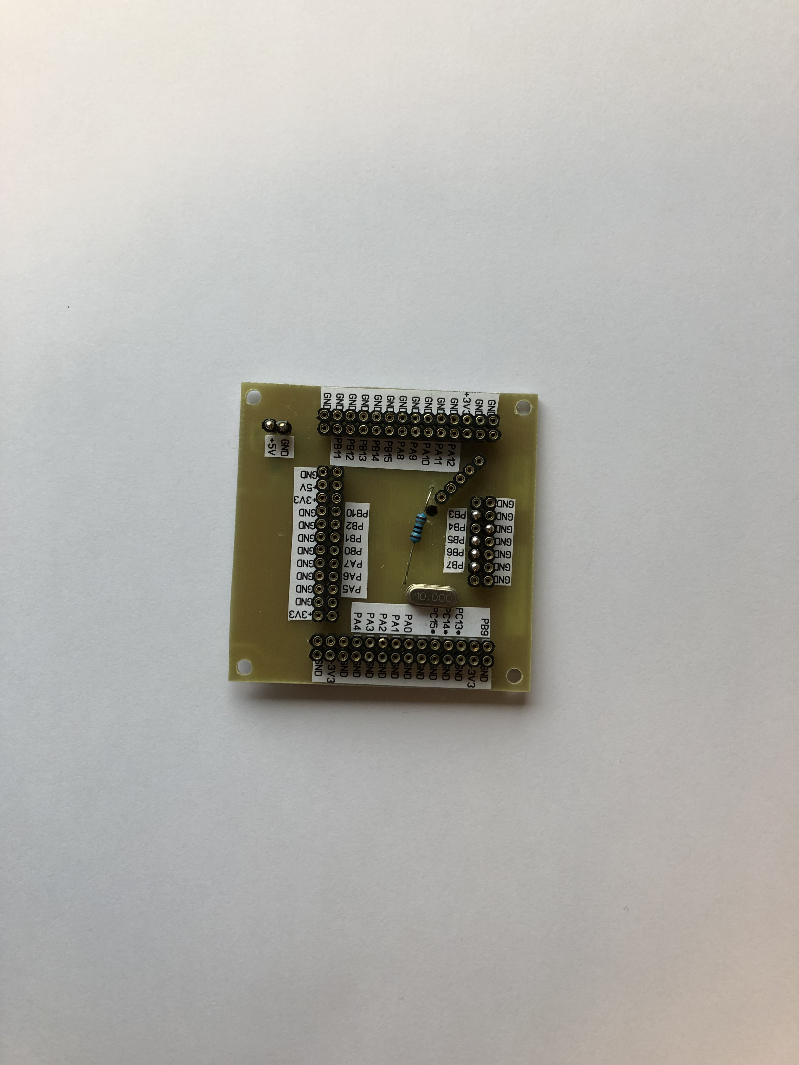
MCU/photo/IMG_5309.jpg
