aljazblatnik/Spectrum-analyzer/MCU/photo/IMG_5310.jpg

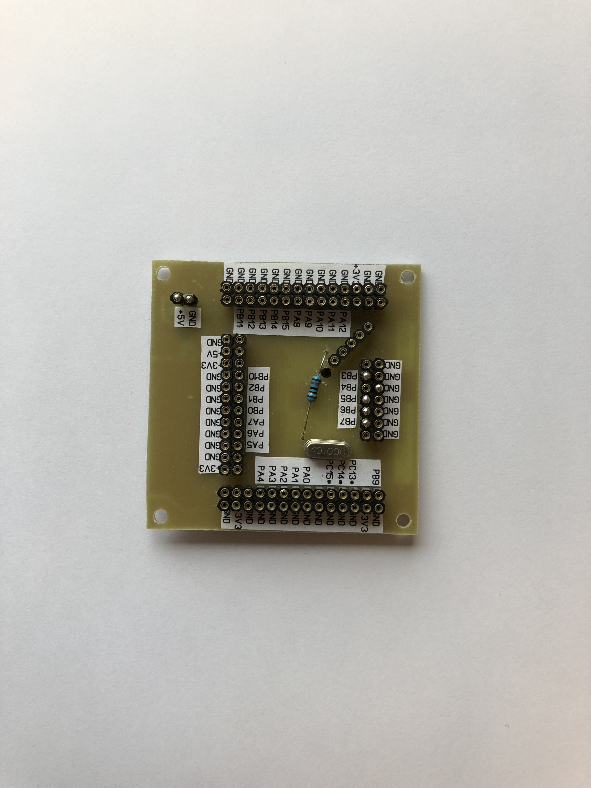
MCU/photo/IMG_5310.jpg
