aljazblatnik/Spectrum-analyzer/MCU/photo/IMG_5311.jpg

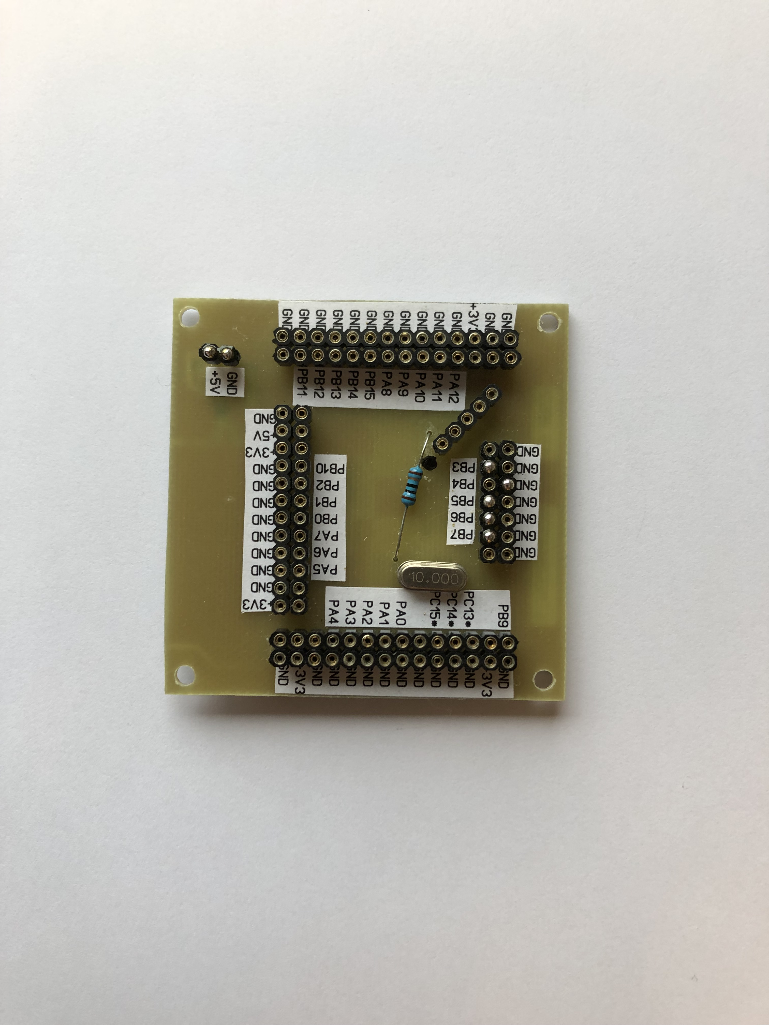
MCU/photo/IMG_5311.jpg
