aljazblatnik/Spectrum-analyzer/MCU/photo/IMG_5312.jpg

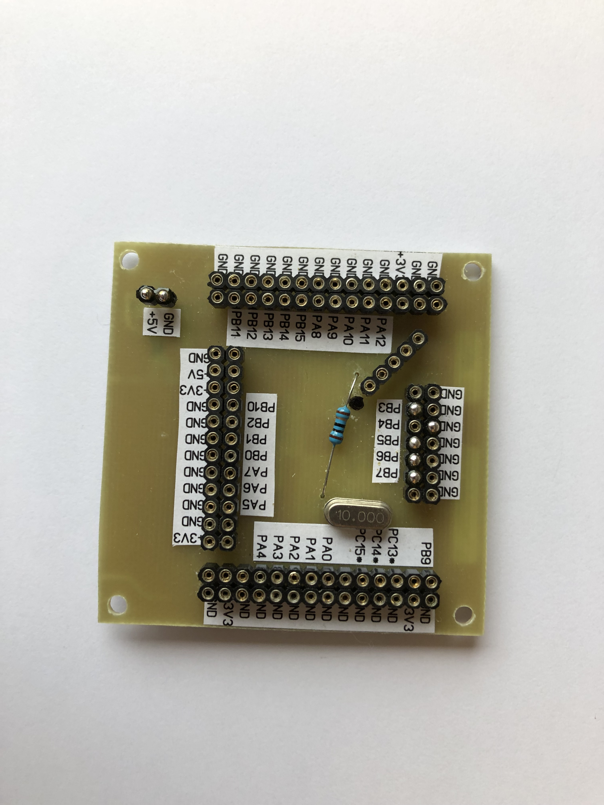
MCU/photo/IMG_5312.jpg
