aljazblatnik/Spectrum-analyzer/MCU/photo/IMG_5313.jpg

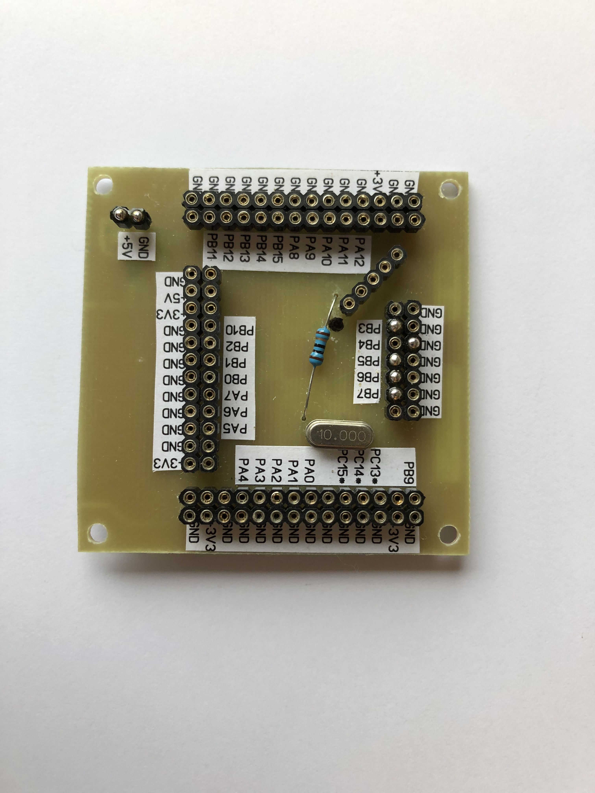
MCU/photo/IMG_5313.jpg
