aljazblatnik/Spectrum-analyzer/MCU/photo/IMG_5314.jpg

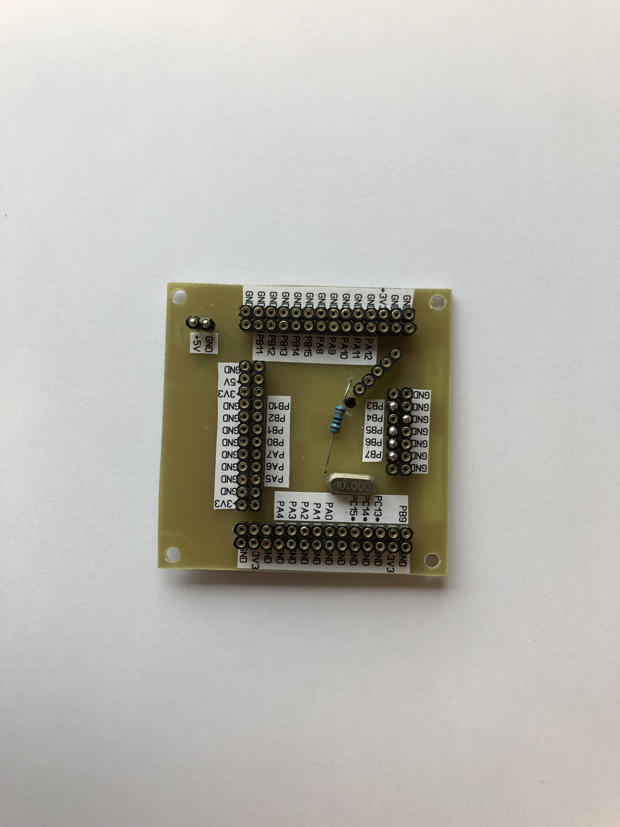
MCU/photo/IMG_5314.jpg
