aljazblatnik/Spectrum-analyzer/MCU/photo/IMG_5315.jpg

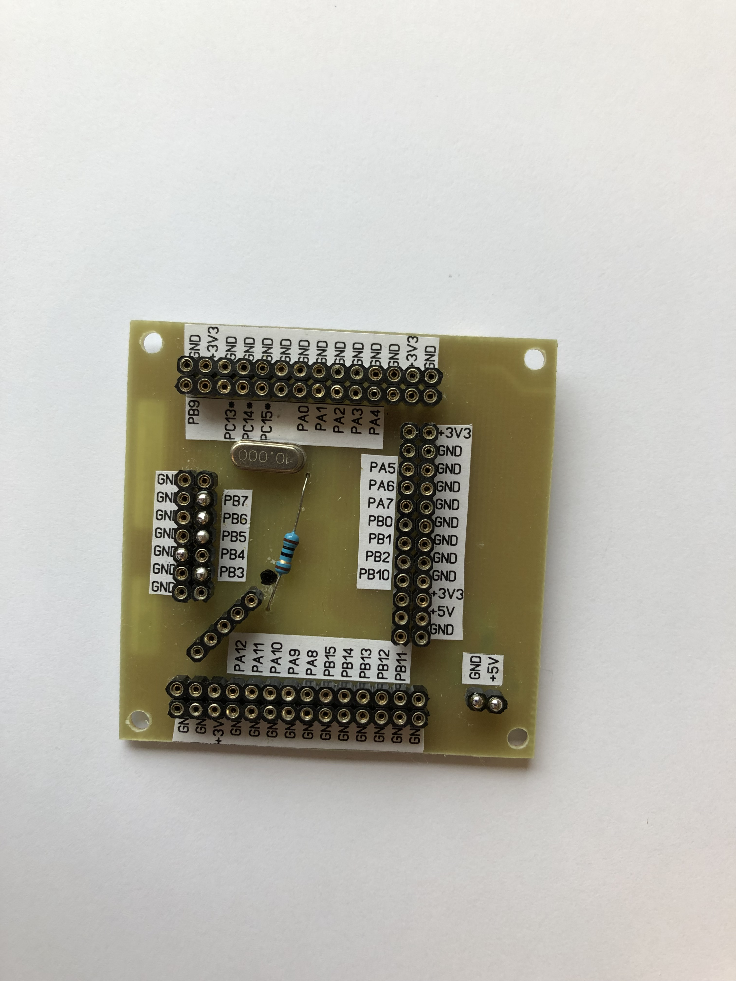
MCU/photo/IMG_5315.jpg
