aljazblatnik/Spectrum-analyzer/MCU/photo/IMG_5316.jpg

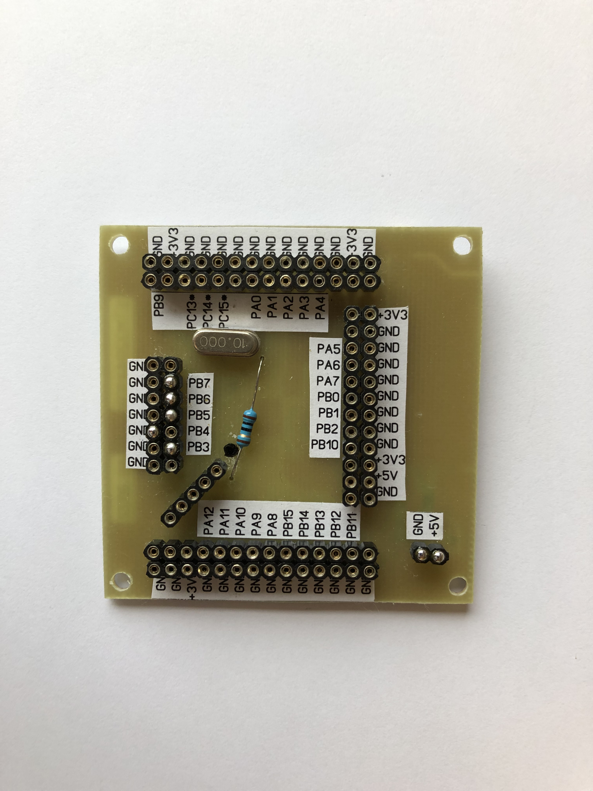
MCU/photo/IMG_5316.jpg
