aljazblatnik/Spectrum-analyzer/MCU/photo/IMG_5317.jpg

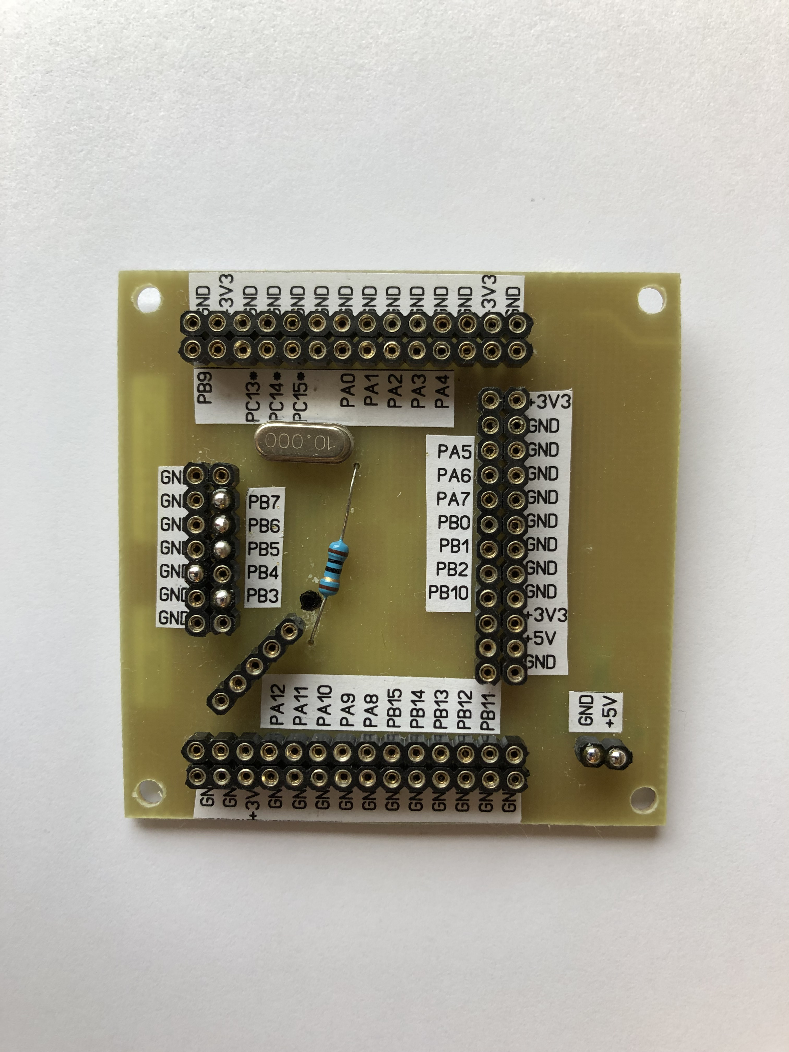
MCU/photo/IMG_5317.jpg
