aljazblatnik/Spectrum-analyzer/MIX/photo/MIX1_v3.JPEG

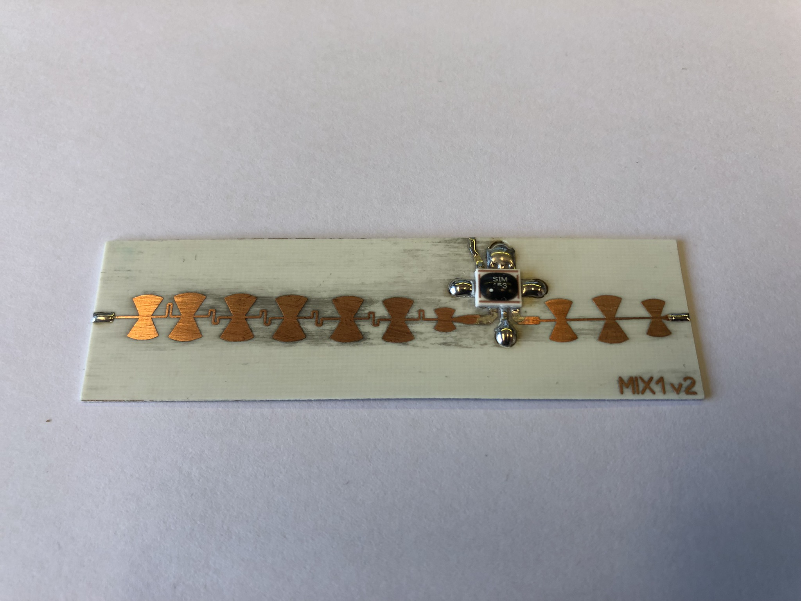
MIX/photo/MIX1_v3.JPEG
