aljazblatnik/Spectrum-analyzer/MIX/photo/MIX2_case.JPEG

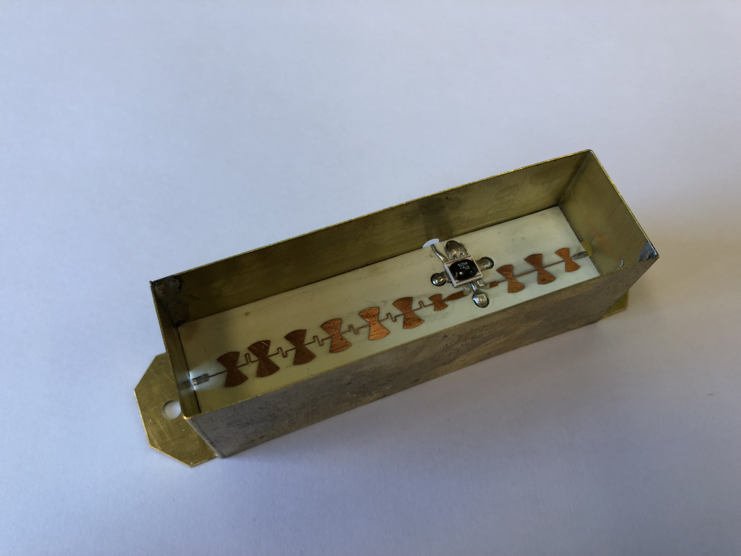
MIX/photo/MIX2_case.JPEG
