aljazblatnik/Spectrum-analyzer/MIX/photo/MIX2_v2.JPEG

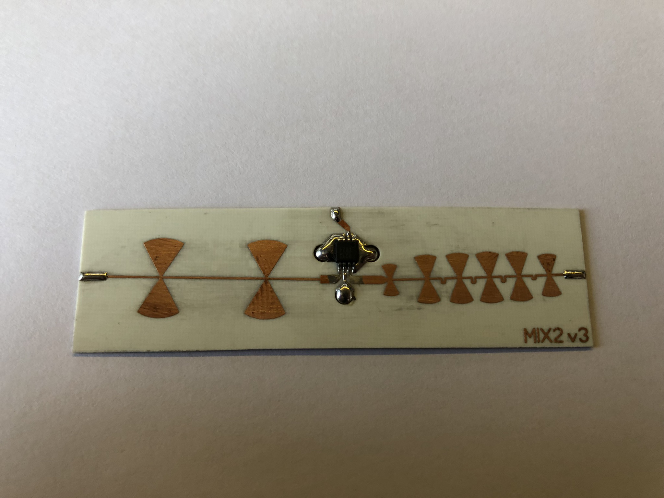
MIX/photo/MIX2_v2.JPEG
