aljazblatnik/Spectrum-analyzer/MIX/photo/MIX3_bottom.JPEG

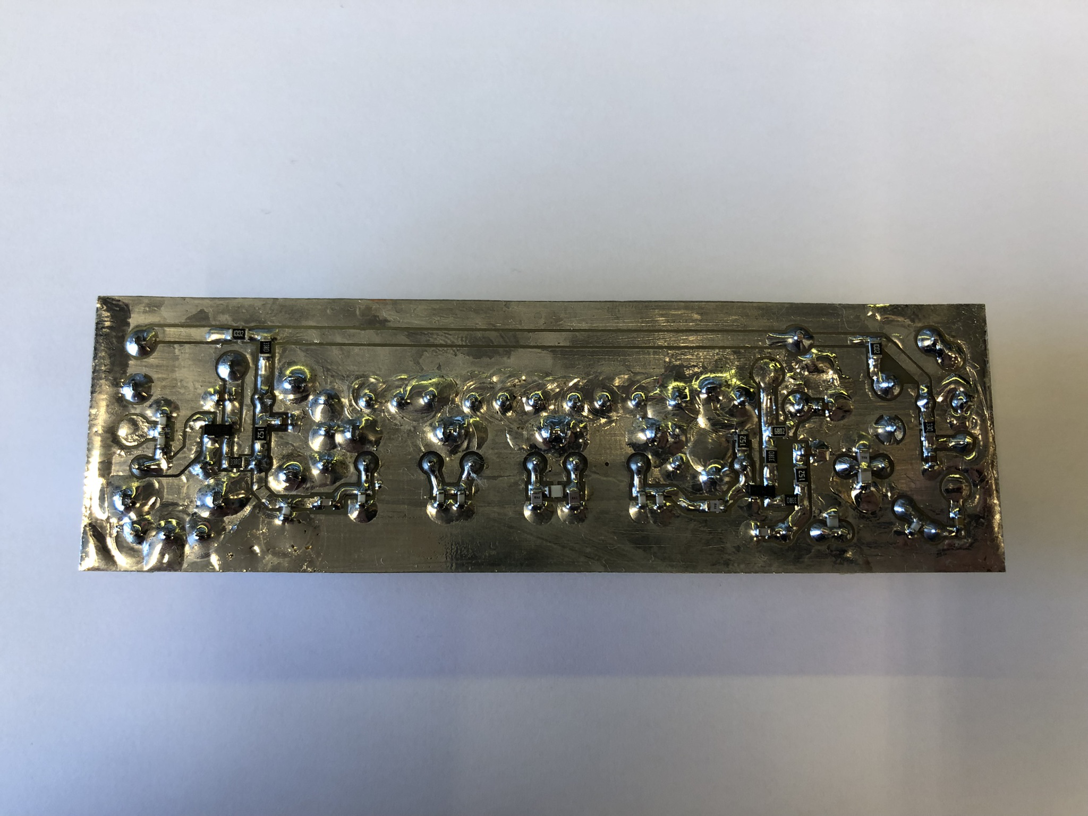
MIX/photo/MIX3_bottom.JPEG
