aljazblatnik/Spectrum-analyzer/MIX/photo/MIX3_top.JPEG

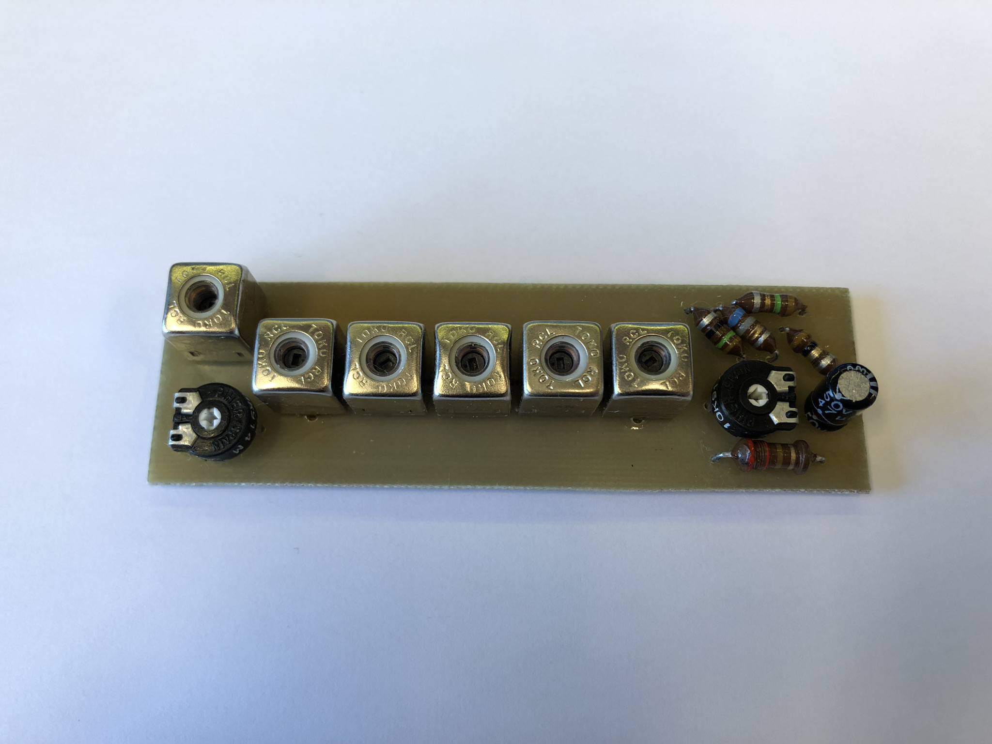
MIX/photo/MIX3_top.JPEG
