aljazblatnik/Spectrum-analyzer/RBW LC filter/PCB_bottom.JPG

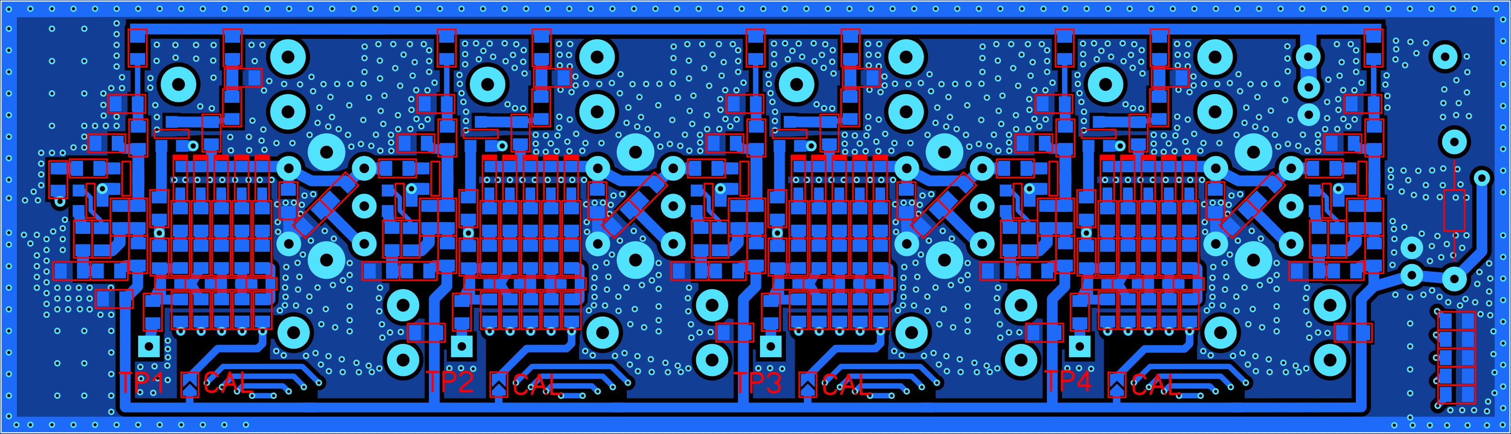
RBW LC filter/PCB_bottom.JPG
