aljazblatnik/Spectrum-analyzer/RBW LC filter/PCB_top.JPG

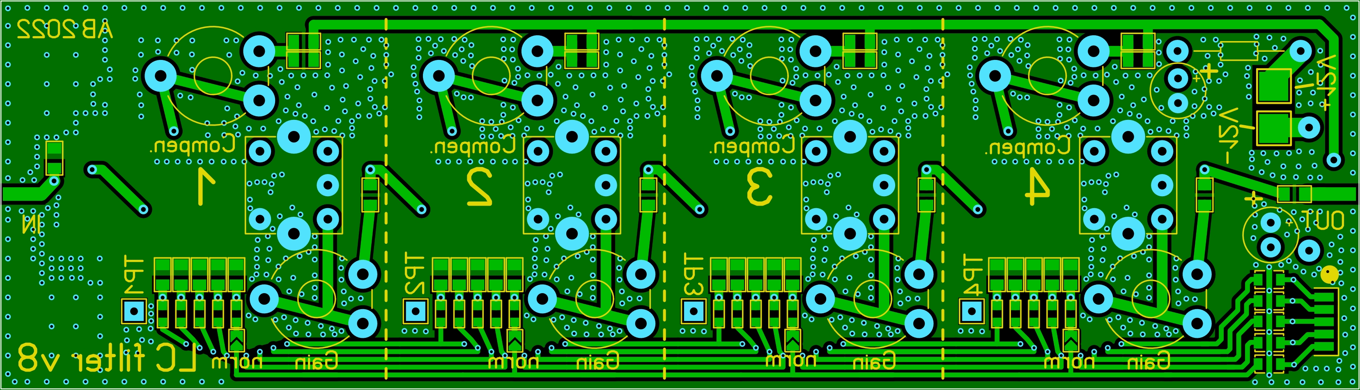
RBW LC filter/PCB_top.JPG
