aljazblatnik/Spectrum-analyzer/RBW LC filter/photo/BUFF_amp_proto.JPEG

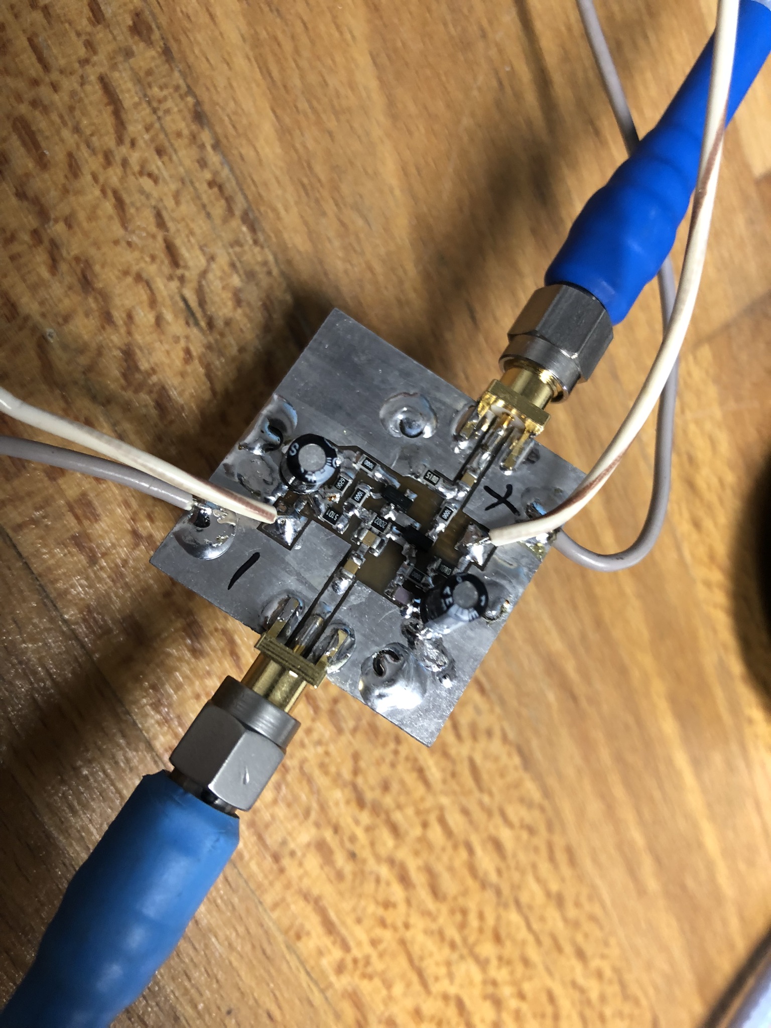
RBW LC filter/photo/BUFF_amp_proto.JPEG
