aljazblatnik/Spectrum-analyzer/RBW LC filter/photo/IMG_4667.JPEG

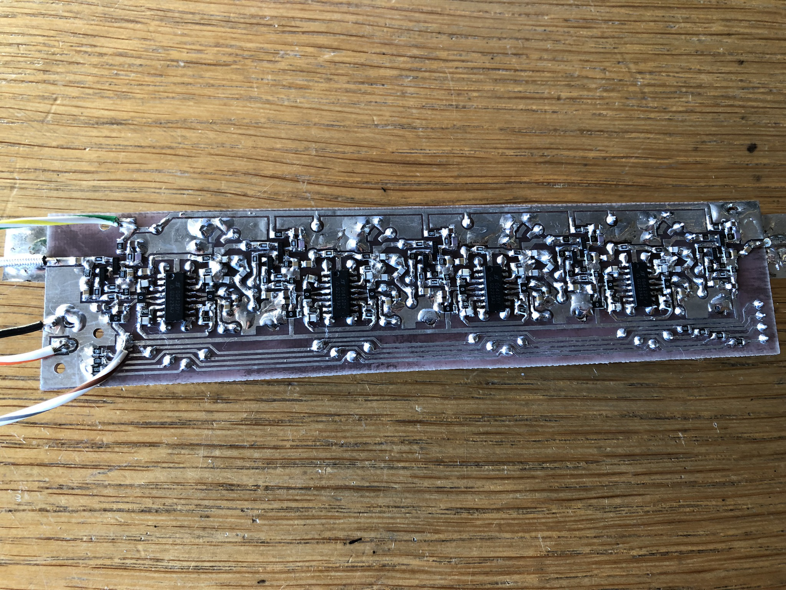
RBW LC filter/photo/IMG_4667.JPEG
