aljazblatnik/Spectrum-analyzer/RBW LC filter/photo/IMG_4668.JPEG

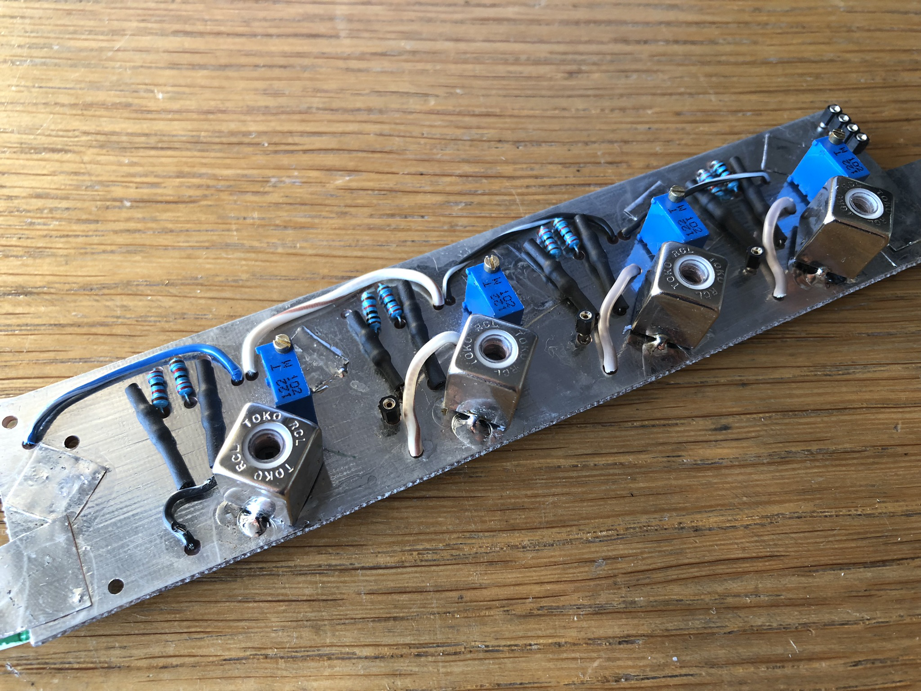
RBW LC filter/photo/IMG_4668.JPEG
