aljazblatnik/Spectrum-analyzer/RBW LC filter/photo/IMG_4669.JPEG

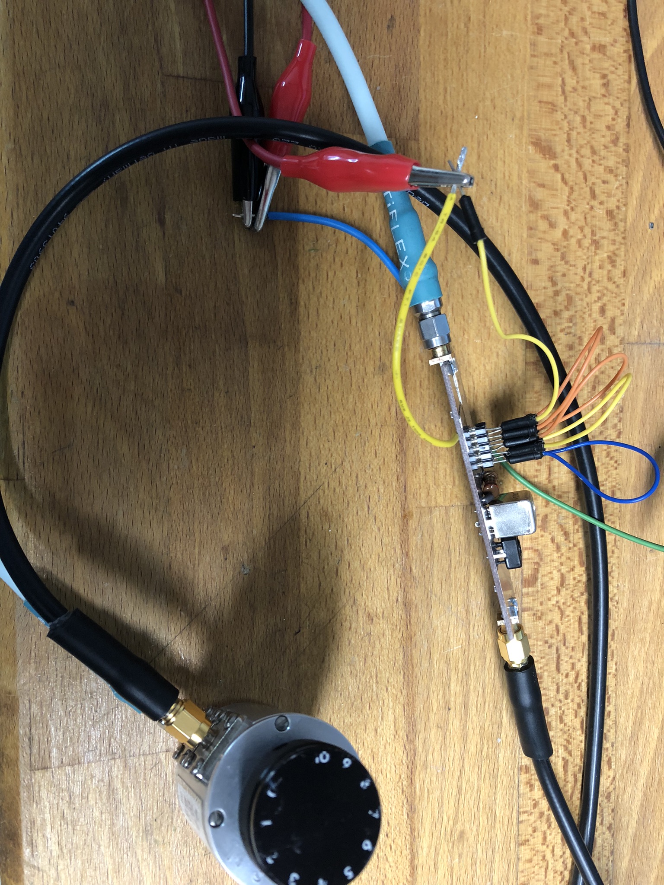
RBW LC filter/photo/IMG_4669.JPEG
