aljazblatnik/Spectrum-analyzer/RBW LC filter/photo/IMG_4670.JPEG

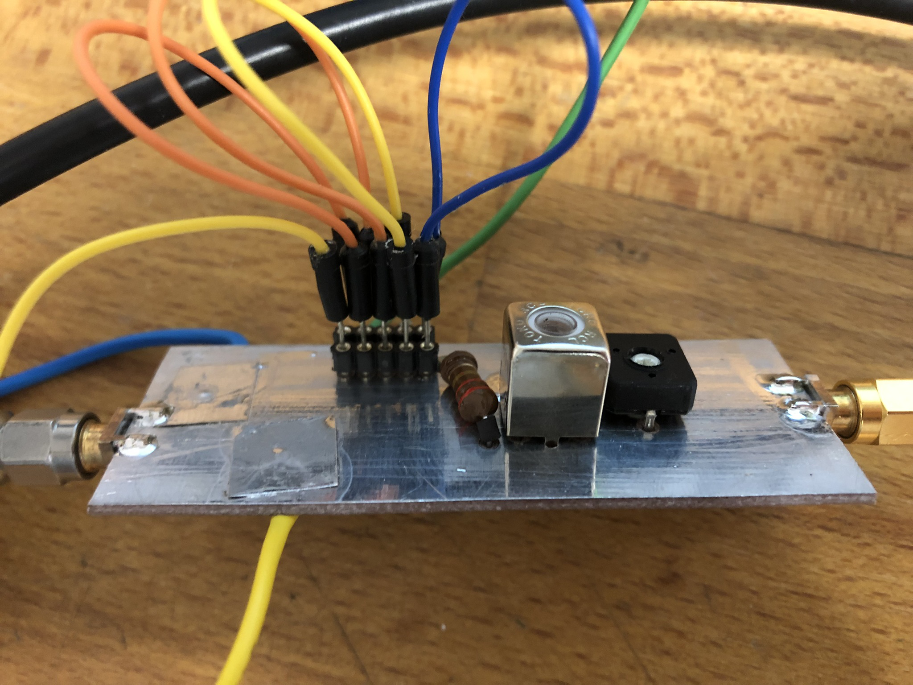
RBW LC filter/photo/IMG_4670.JPEG
