aljazblatnik/Spectrum-analyzer/RBW LC filter/photo/IMG_4671.JPEG

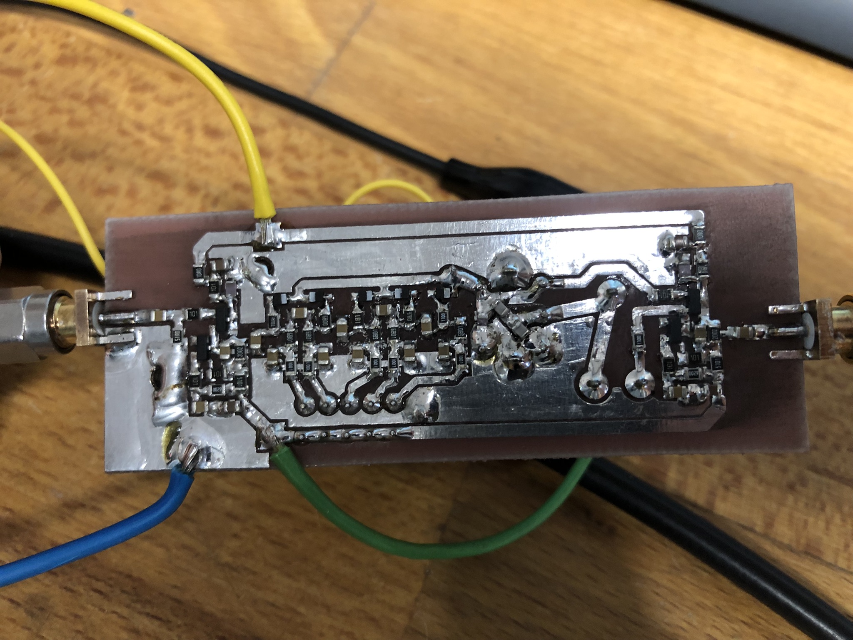
RBW LC filter/photo/IMG_4671.JPEG
