aljazblatnik/Spectrum-analyzer/RBW LC filter/photo/IMG_4672.JPEG

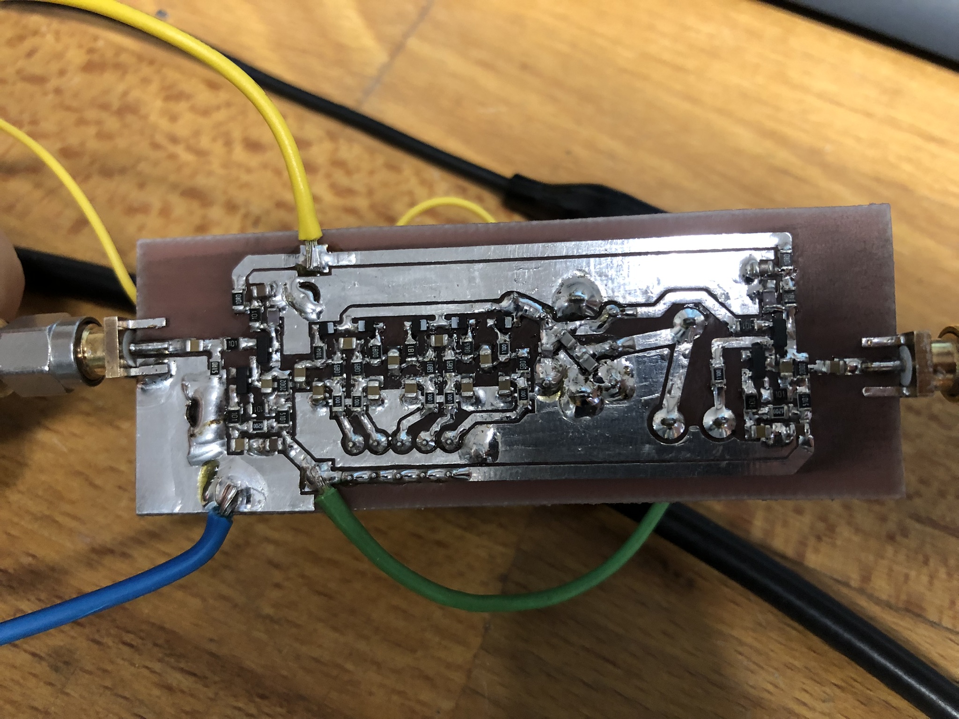
RBW LC filter/photo/IMG_4672.JPEG
