aljazblatnik/Spectrum-analyzer/RBW LC filter/photo/IMG_4680.jpg

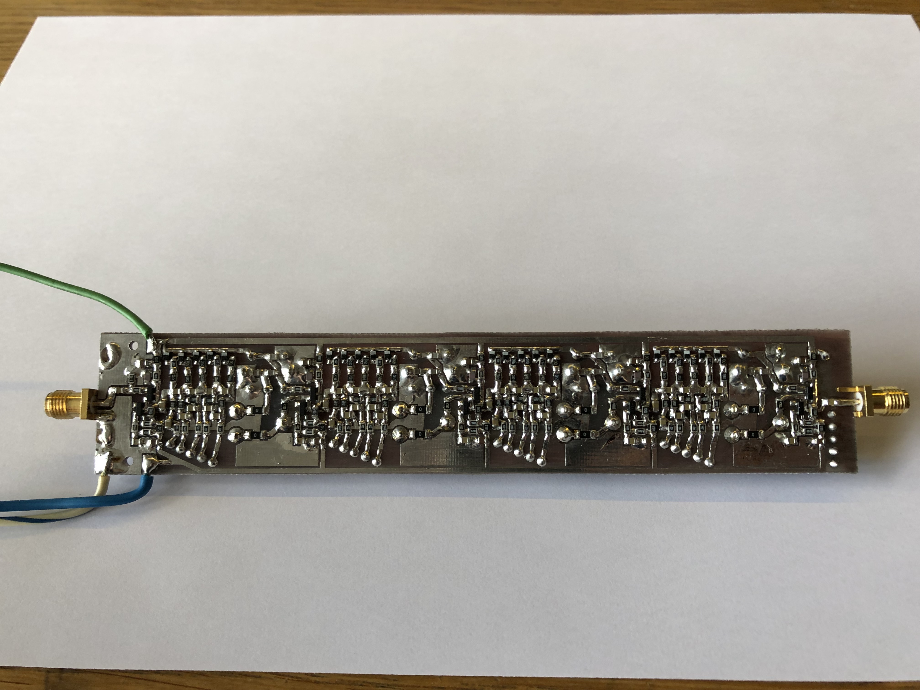
RBW LC filter/photo/IMG_4680.jpg
