aljazblatnik/Spectrum-analyzer/RBW LC filter/photo/IMG_4681.jpg

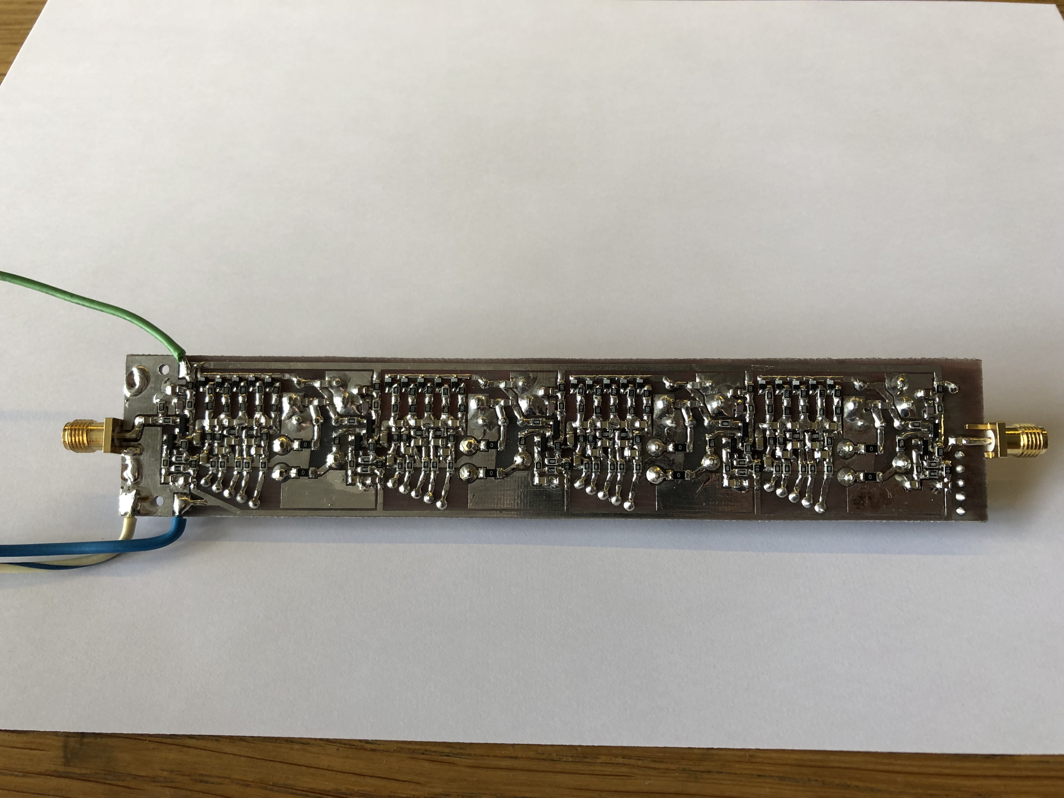
RBW LC filter/photo/IMG_4681.jpg
