aljazblatnik/Spectrum-analyzer/RBW LC filter/photo/IMG_4682.jpg

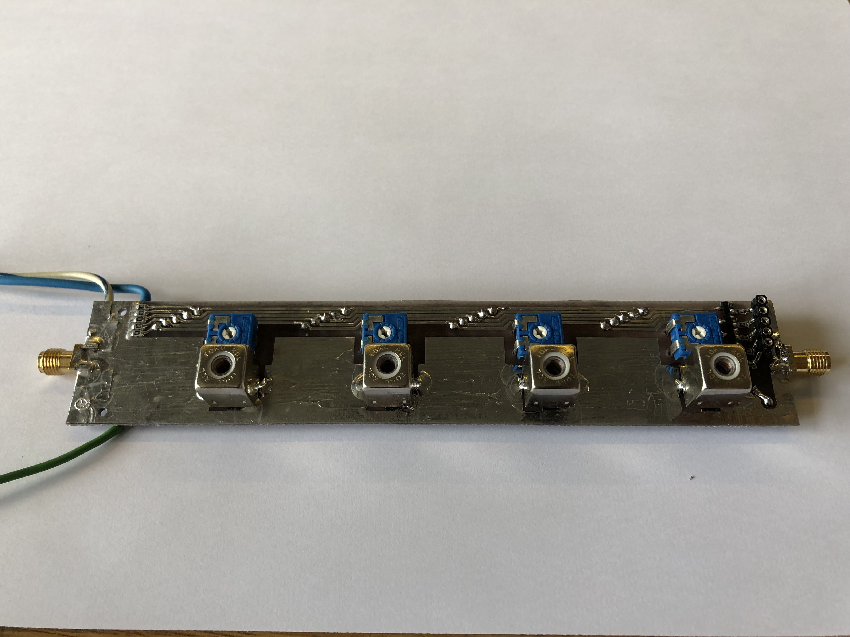
RBW LC filter/photo/IMG_4682.jpg
