aljazblatnik/Spectrum-analyzer/RBW LC filter/photo/IMG_4684.jpg

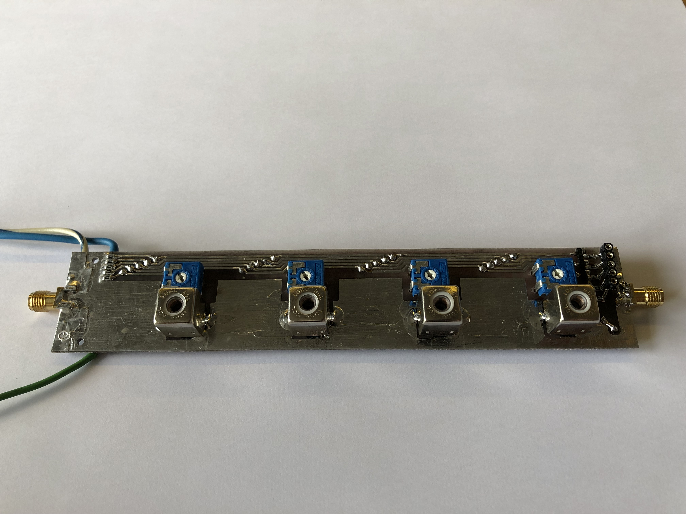
RBW LC filter/photo/IMG_4684.jpg
