aljazblatnik/Spectrum-analyzer/RBW LC filter/photo/LC_PCB_bottom.JPEG

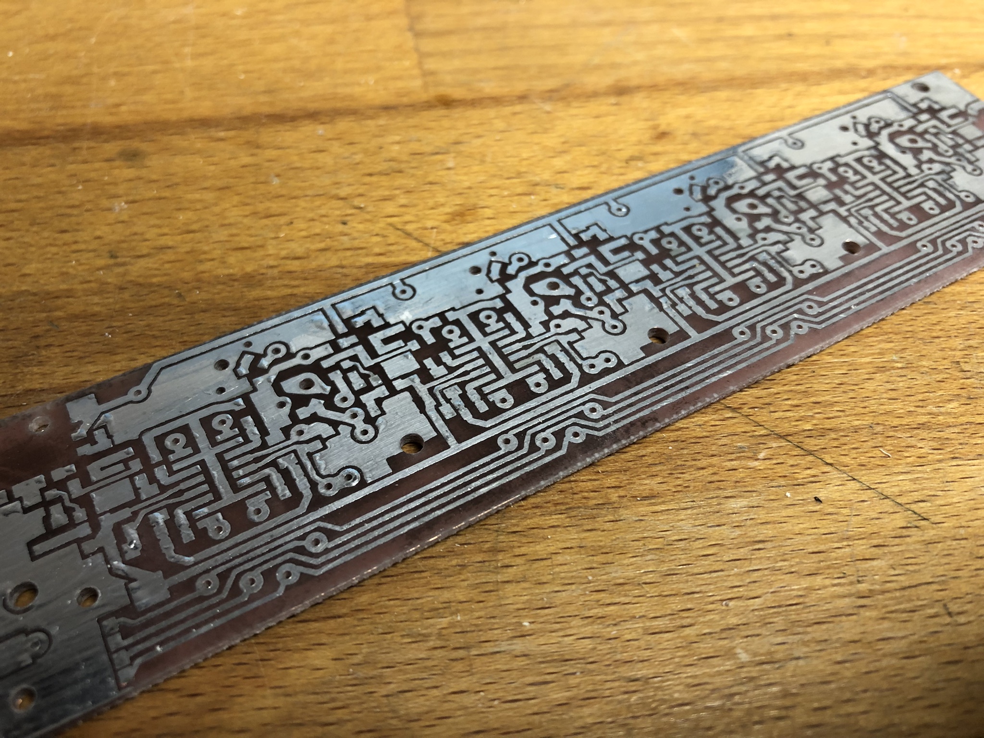
RBW LC filter/photo/LC_PCB_bottom.JPEG
