aljazblatnik/Spectrum-analyzer/RBW LC filter/photo/LC_PCB_top.JPEG

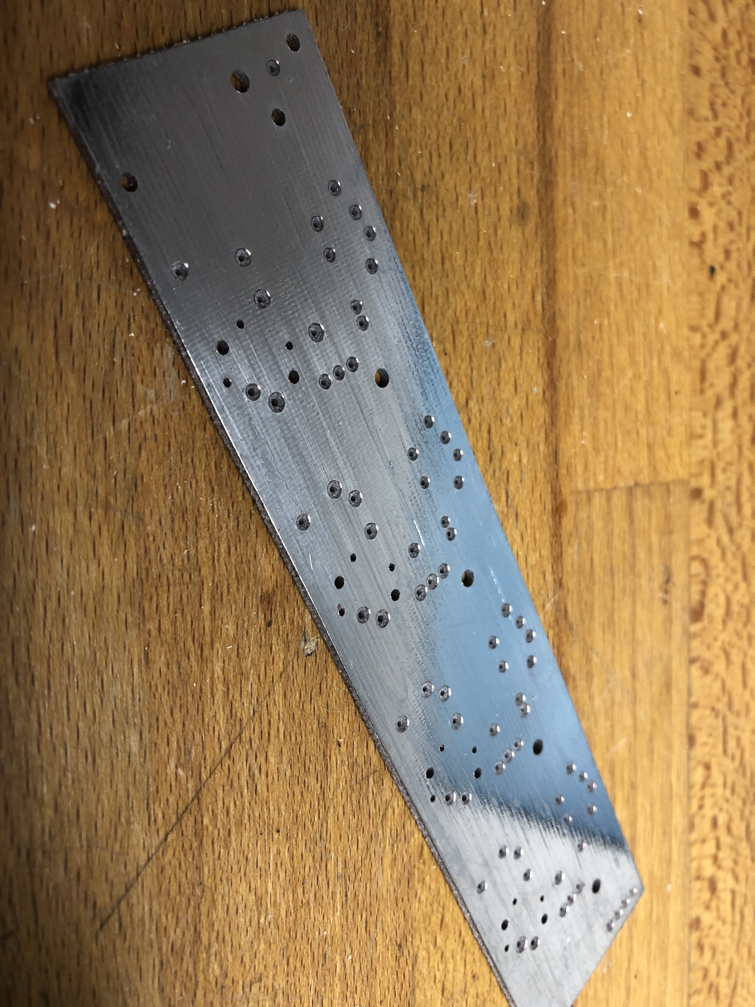
RBW LC filter/photo/LC_PCB_top.JPEG
