aljazblatnik/Spectrum-analyzer/RBW LC filter/photo/LC_proto_1_stage.JPEG

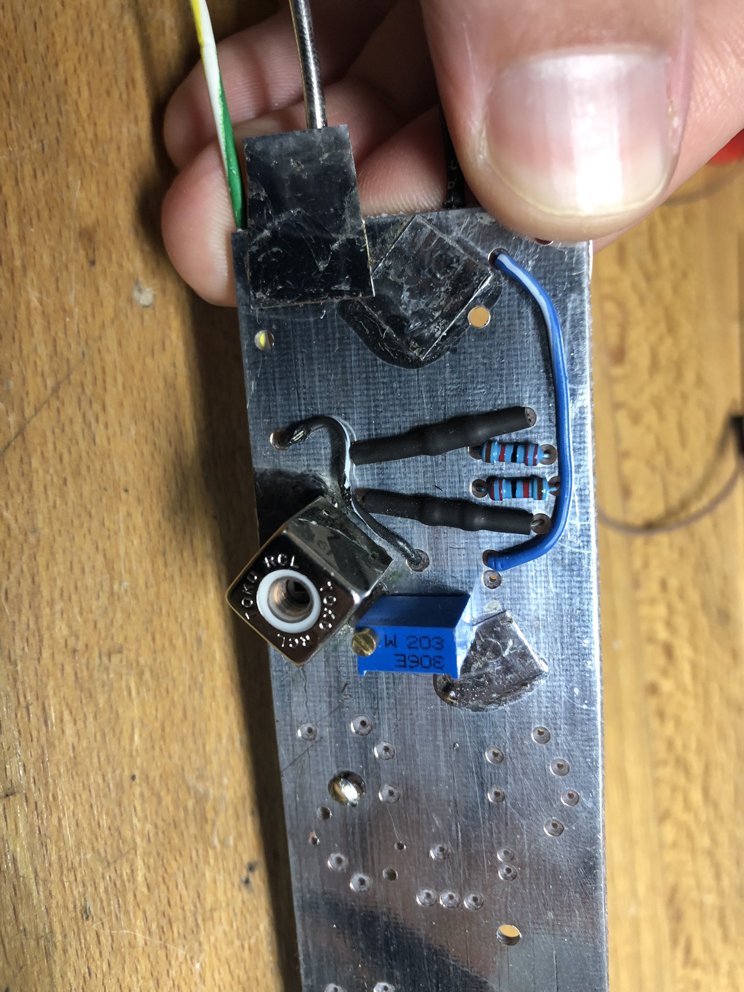
RBW LC filter/photo/LC_proto_1_stage.JPEG
