aljazblatnik/Spectrum-analyzer/RBW LC filter/photo/PIN_1_stage_bottom.jpeg

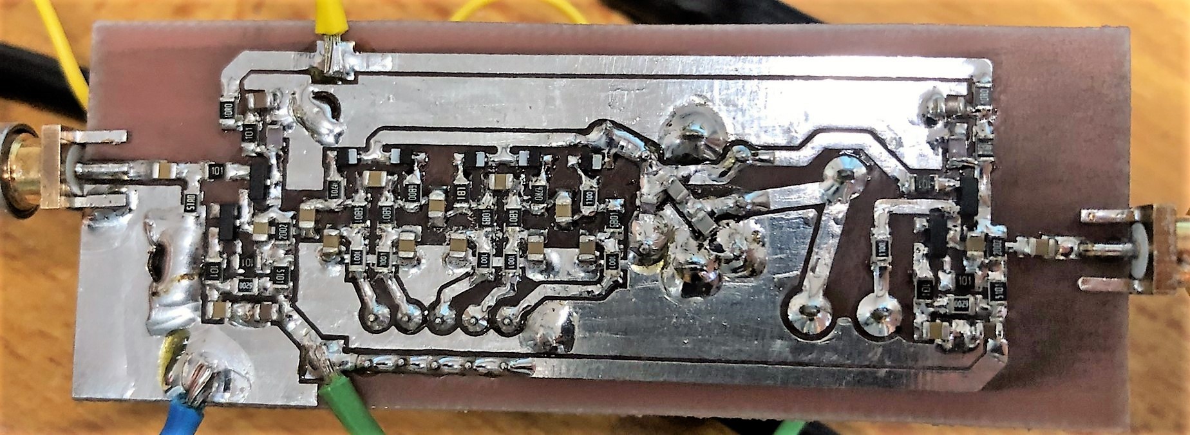
RBW LC filter/photo/PIN_1_stage_bottom.jpeg
