aljazblatnik/Spectrum-analyzer/RBW LC filter/photo/PIN_1_stage_top.jpeg

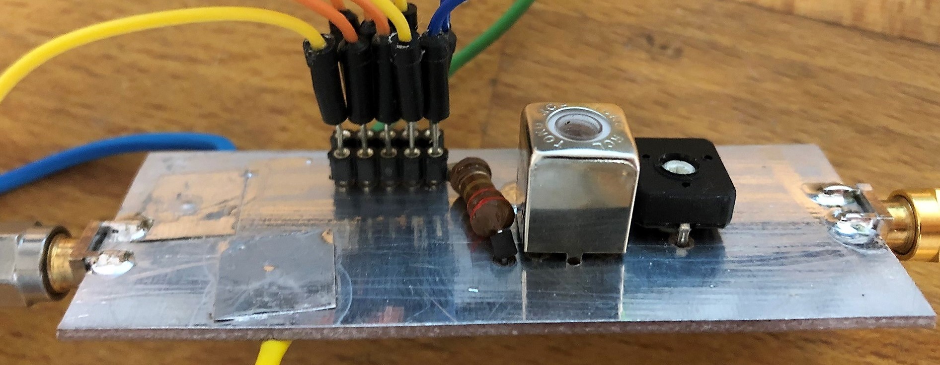
RBW LC filter/photo/PIN_1_stage_top.jpeg
