aljazblatnik/Spectrum-analyzer/RBW LC filter/photo/PIN_switch_BOTTOM.jpg

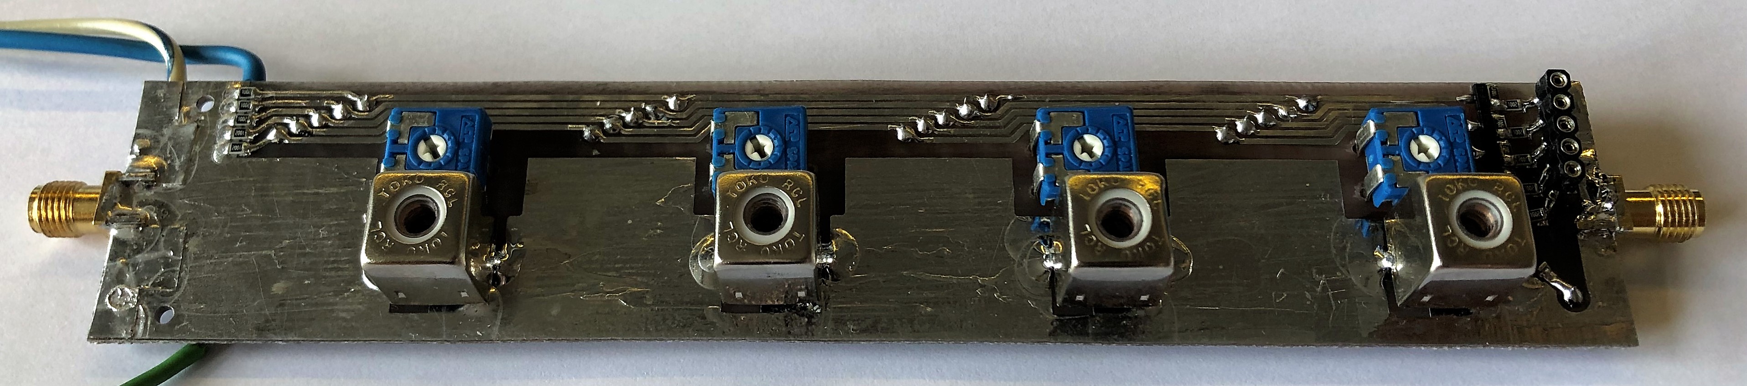
RBW LC filter/photo/PIN_switch_BOTTOM.jpg
