aljazblatnik/Spectrum-analyzer/RBW LC filter/photo/PIN_switch_TOP.jpg

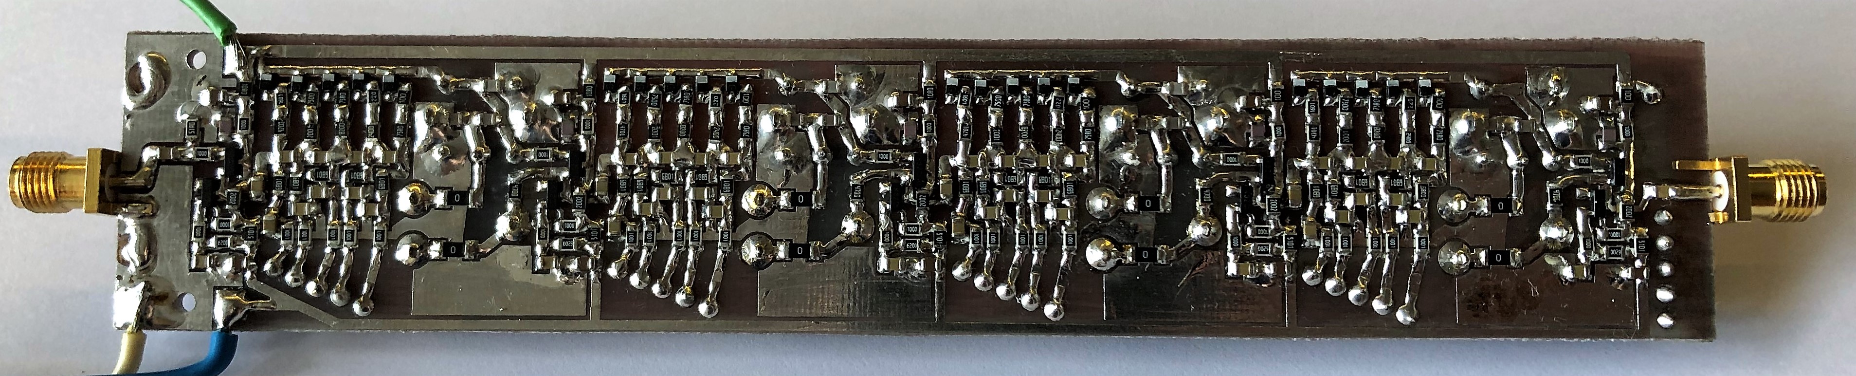
RBW LC filter/photo/PIN_switch_TOP.jpg
