aljazblatnik/Spectrum-analyzer/RBW LC filter/photo/tuljava_mikroskop.jpg

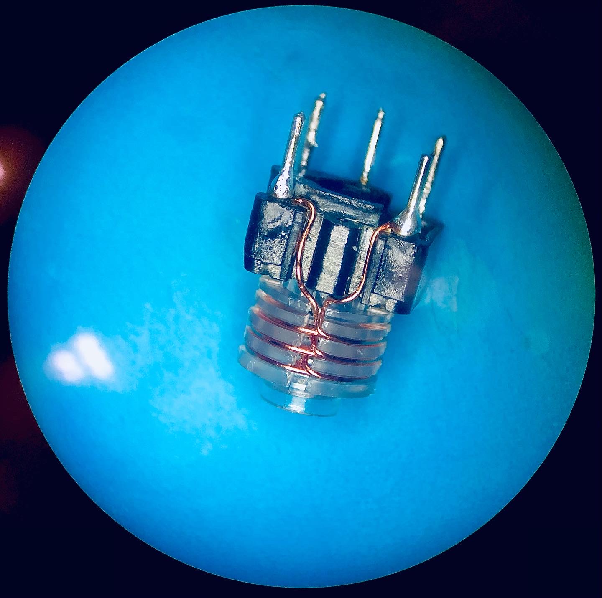
RBW LC filter/photo/tuljava_mikroskop.jpg
