aljazblatnik/Spectrum-analyzer/RBW LC filter/RBW_LC_schematic.png

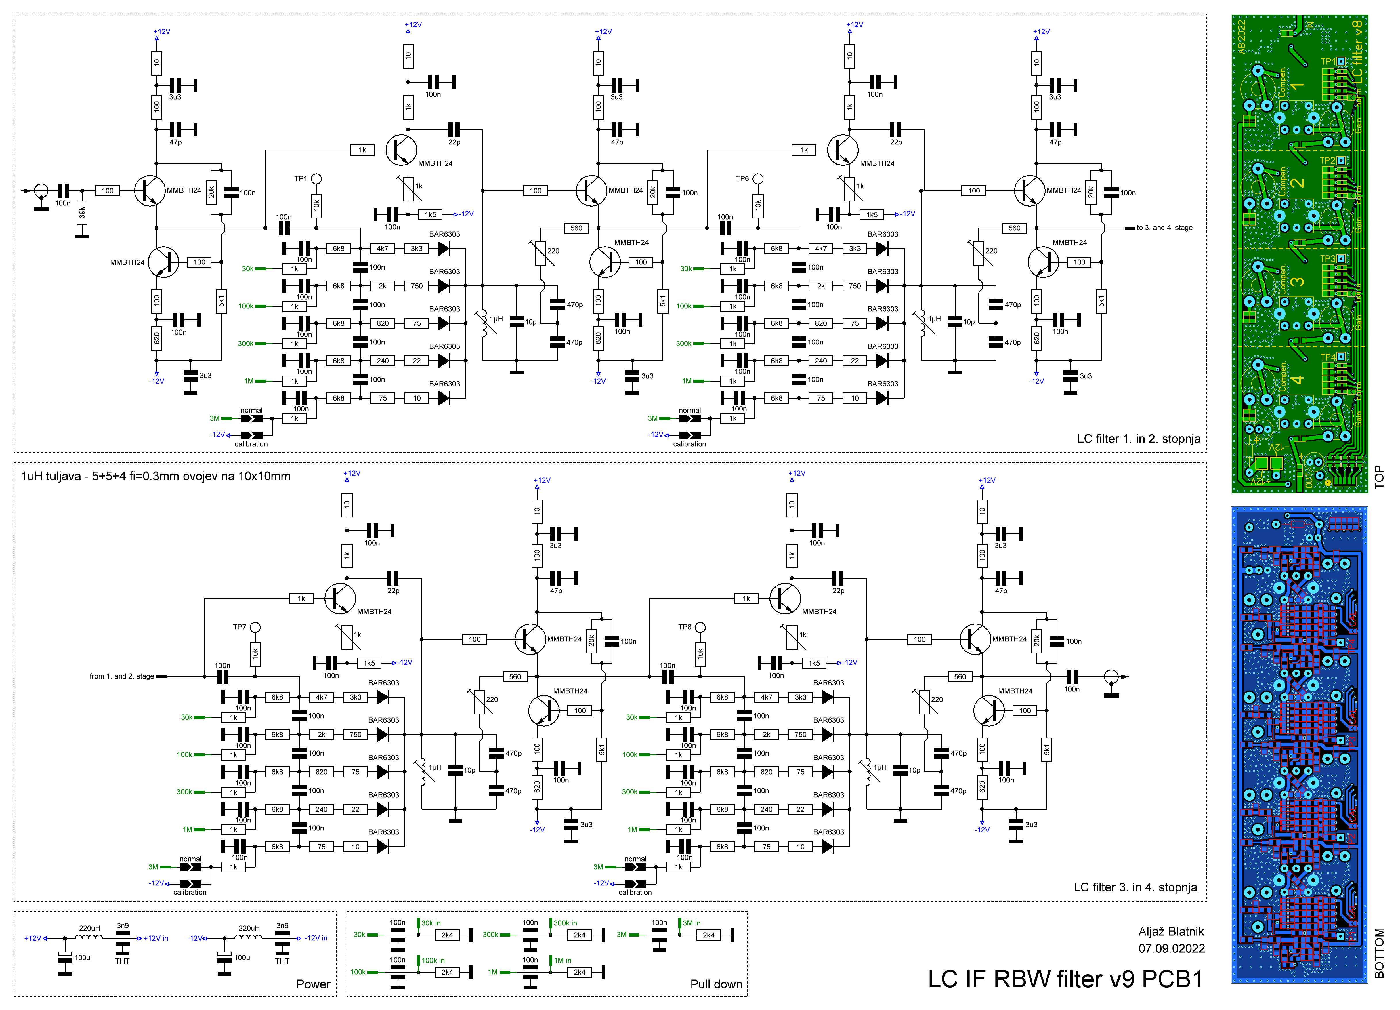
RBW LC filter/RBW_LC_schematic.png
