aljazblatnik/Spectrum-analyzer/RBW Xtal filter/PCB_top.jpg

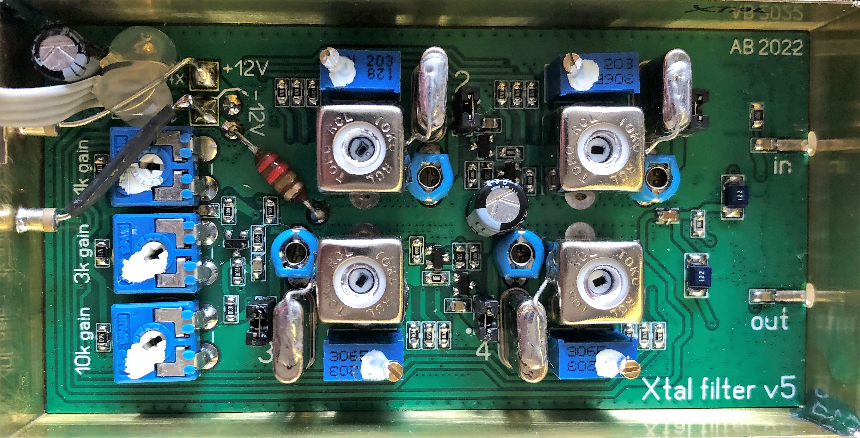
RBW Xtal filter/PCB_top.jpg
