aljazblatnik/Spectrum-analyzer/RBW Xtal filter/photo/1kHz_Xtal_sito.jpg

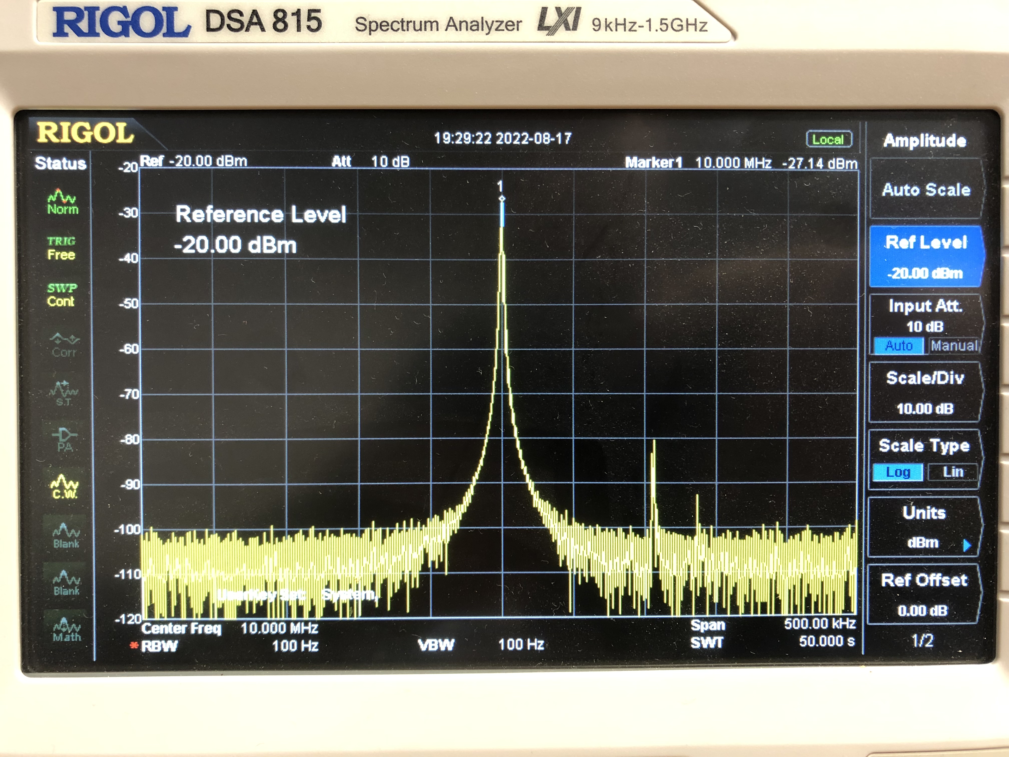
RBW Xtal filter/photo/1kHz_Xtal_sito.jpg
