aljazblatnik/Spectrum-analyzer/RBW Xtal filter/photo/10kHz_BW_2.jpg

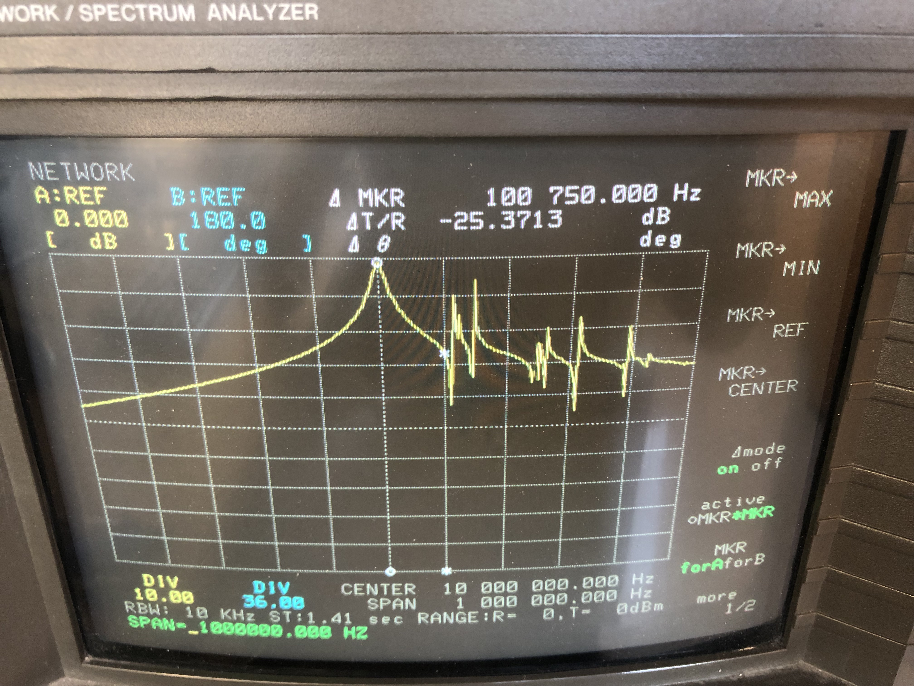
RBW Xtal filter/photo/10kHz_BW_2.jpg
