aljazblatnik/Spectrum-analyzer/RBW Xtal filter/photo/IMG_4700.jpg

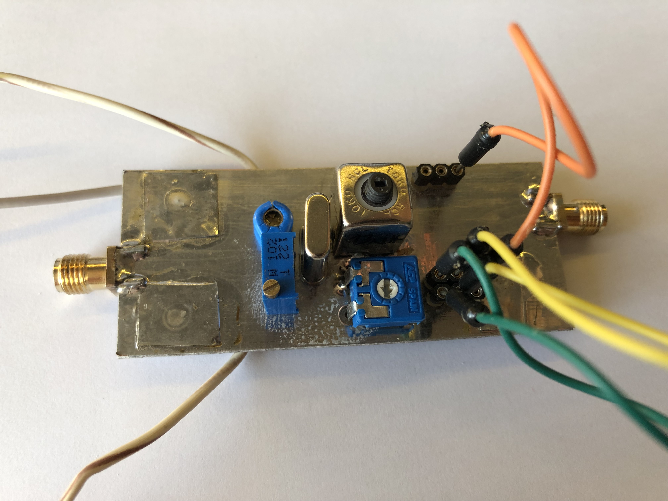
RBW Xtal filter/photo/IMG_4700.jpg
