aljazblatnik/Spectrum-analyzer/RBW Xtal filter/photo/IMG_4701.jpg

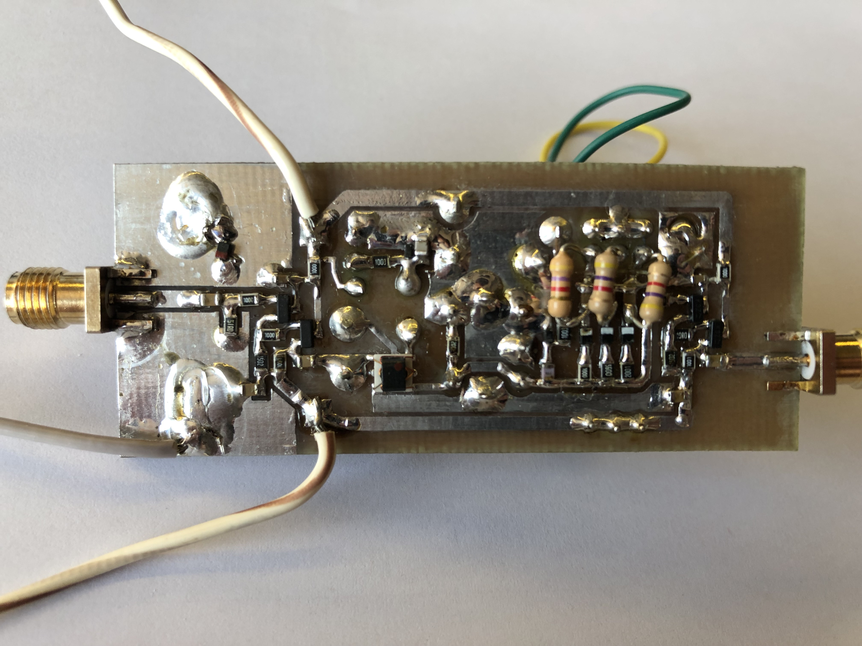
RBW Xtal filter/photo/IMG_4701.jpg
