aljazblatnik/Spectrum-analyzer/RBW Xtal filter/photo/IMG_4702.jpg

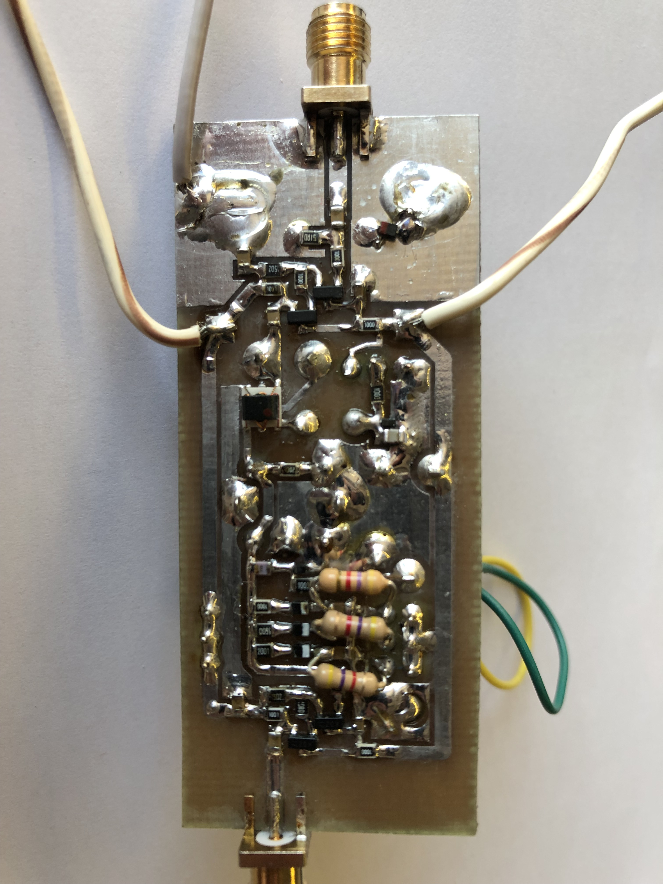
RBW Xtal filter/photo/IMG_4702.jpg
