aljazblatnik/Spectrum-analyzer/RBW Xtal filter/photo/IMG_4703.jpg

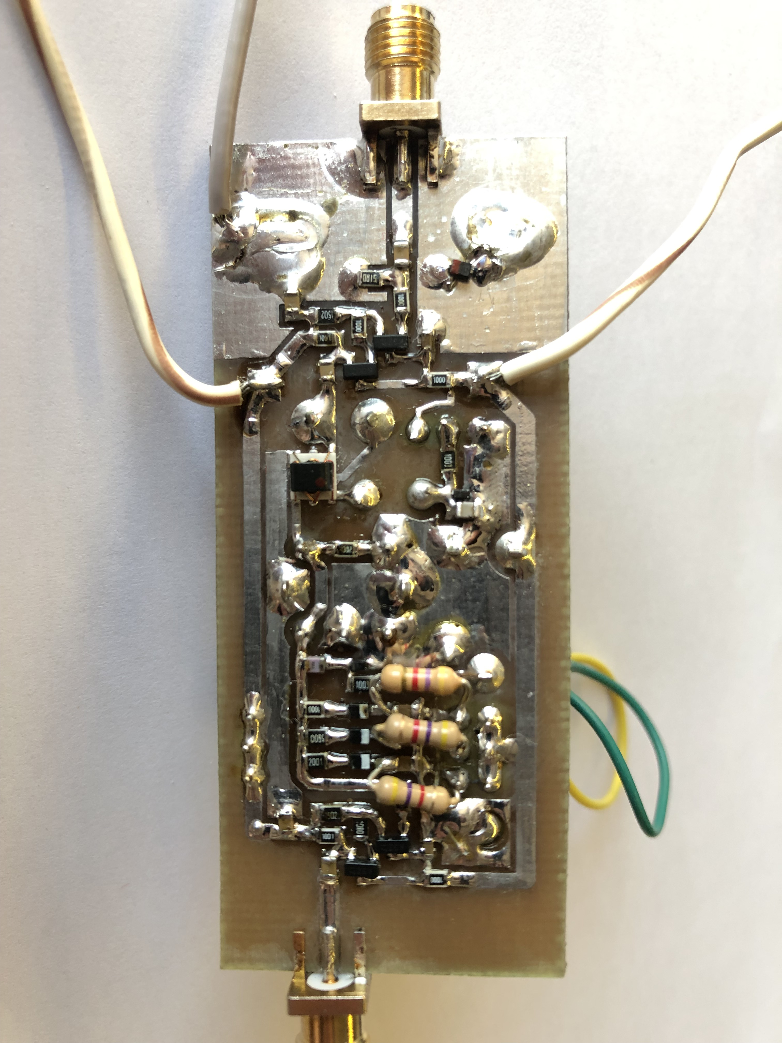
RBW Xtal filter/photo/IMG_4703.jpg
