aljazblatnik/Spectrum-analyzer/RBW Xtal filter/photo/IMG_4704.JPEG

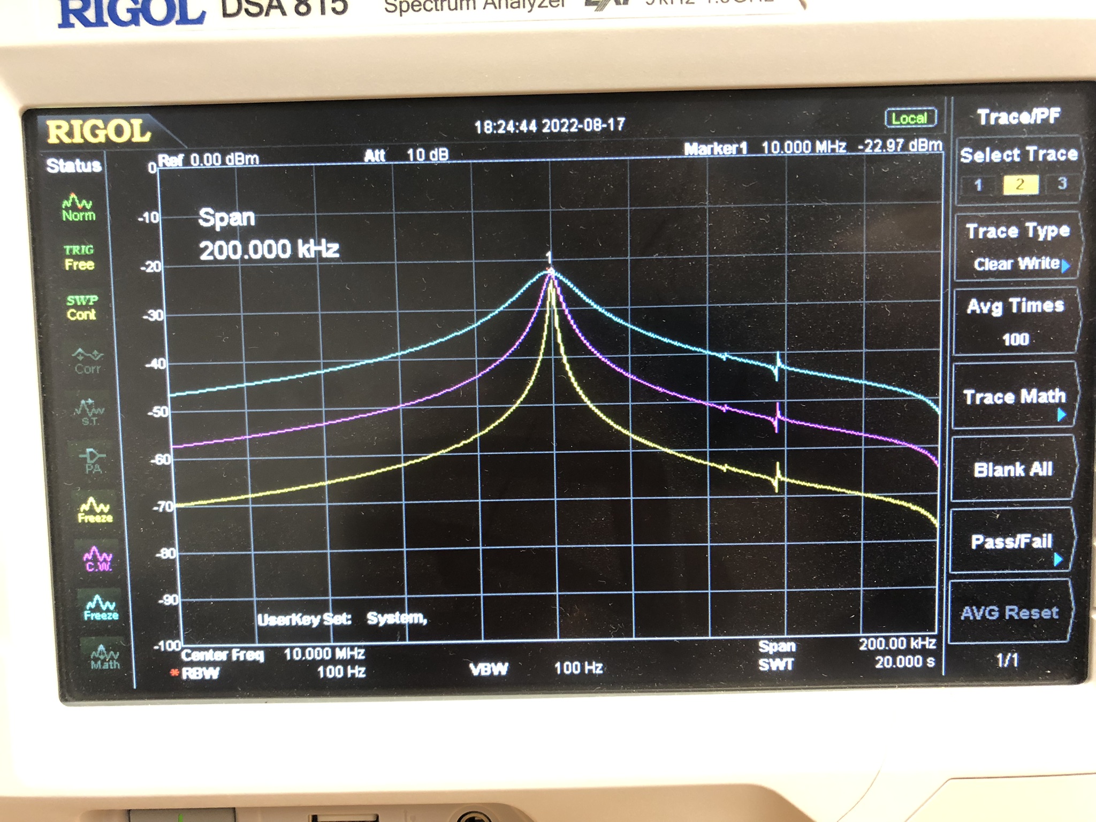
RBW Xtal filter/photo/IMG_4704.JPEG
