aljazblatnik/Spectrum-analyzer/RBW Xtal filter/photo/IMG_4705.JPEG

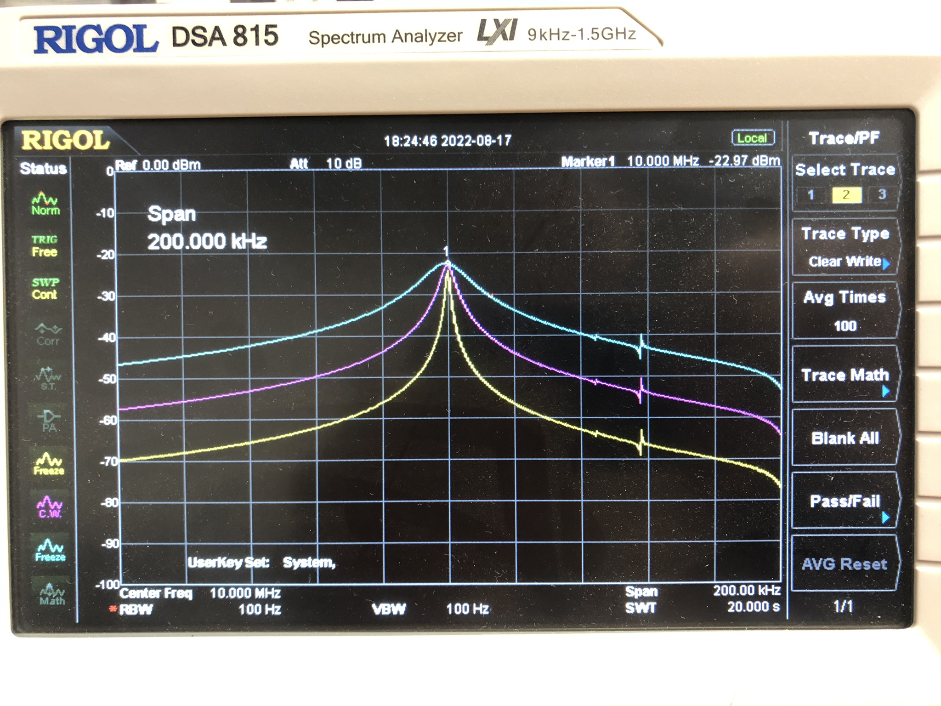
RBW Xtal filter/photo/IMG_4705.JPEG
