aljazblatnik/Spectrum-analyzer/RBW Xtal filter/photo/IMG_4708.JPEG

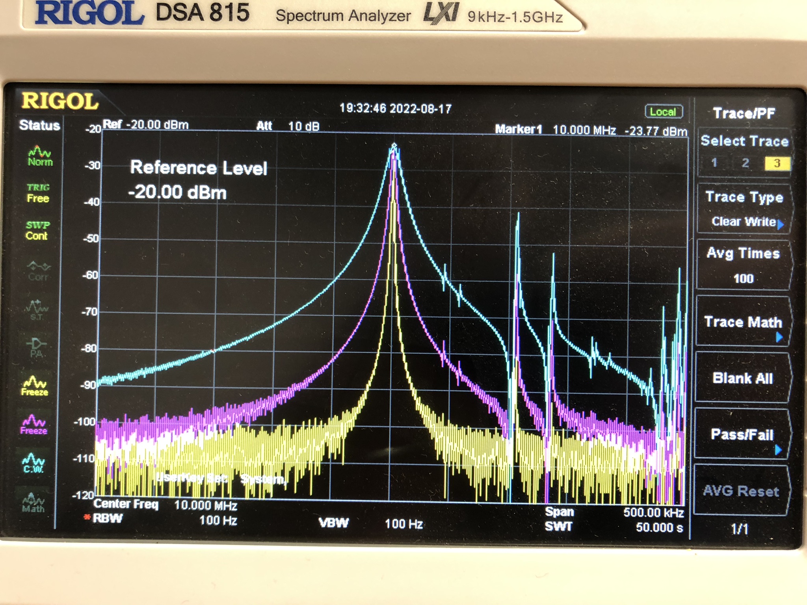
RBW Xtal filter/photo/IMG_4708.JPEG
