aljazblatnik/Spectrum-analyzer/RBW Xtal filter/photo/poskus_v1.jpg

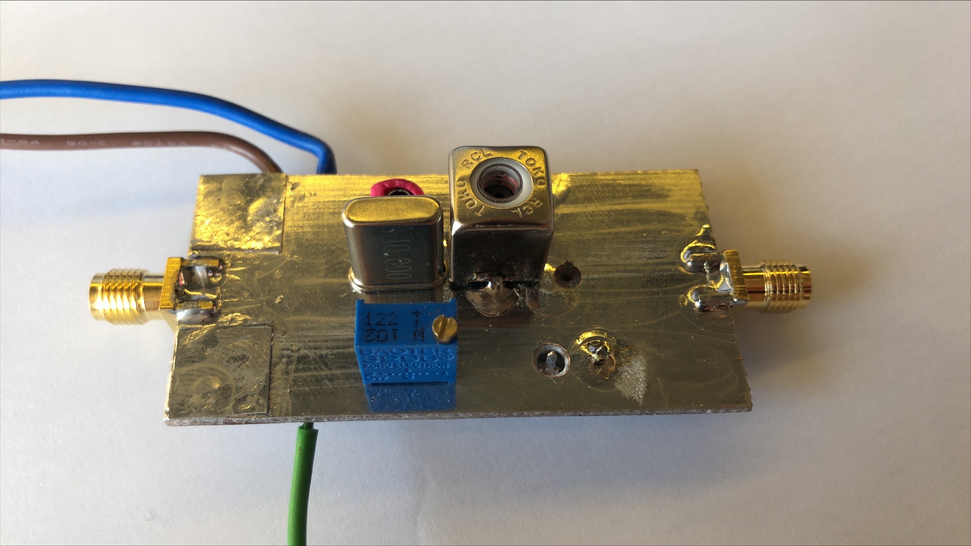
RBW Xtal filter/photo/poskus_v1.jpg
