aljazblatnik/Spectrum-analyzer/RBW Xtal filter/photo/poskus_v2.jpg

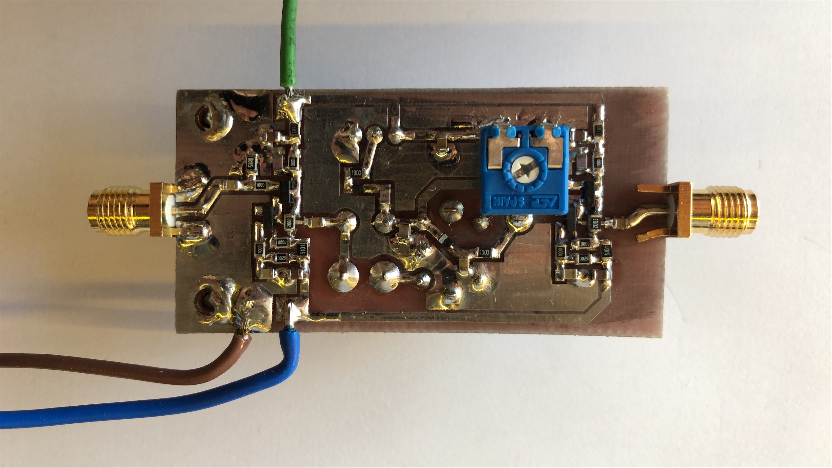
RBW Xtal filter/photo/poskus_v2.jpg
