aljazblatnik/Spectrum-analyzer/RBW Xtal filter/photo/Xtal_schematic_v2.png

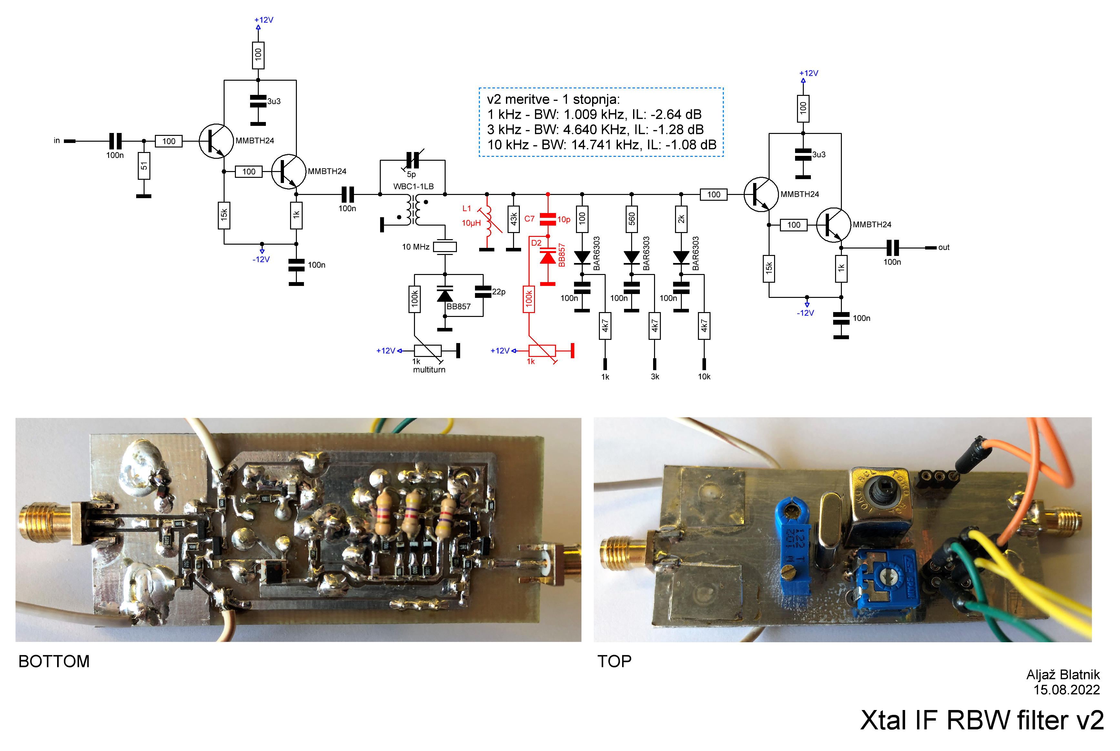
RBW Xtal filter/photo/Xtal_schematic_v2.png
