aljazblatnik/Spectrum-analyzer/RBW Xtal filter/photo/Xtal_v2_BOTTOM.jpg

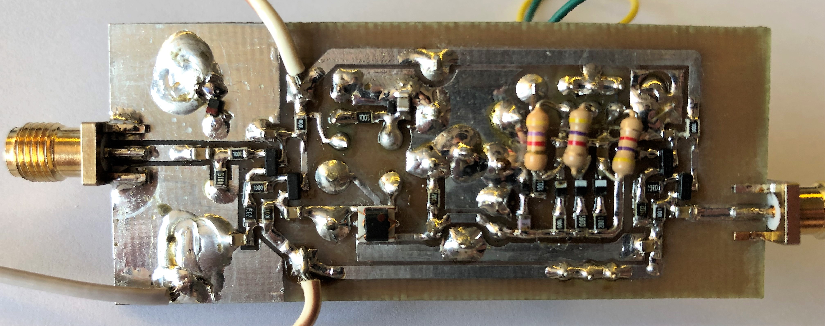
RBW Xtal filter/photo/Xtal_v2_BOTTOM.jpg
