aljazblatnik/Spectrum-analyzer/RBW Xtal filter/photo/Xtal_v2_TOP.jpg

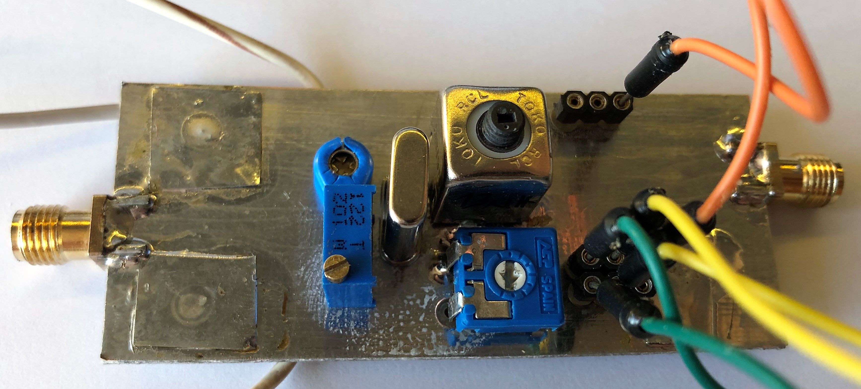
RBW Xtal filter/photo/Xtal_v2_TOP.jpg
