aljazblatnik/Spectrum-analyzer/RBW Xtal filter/RBW_Xtal_schematic.png

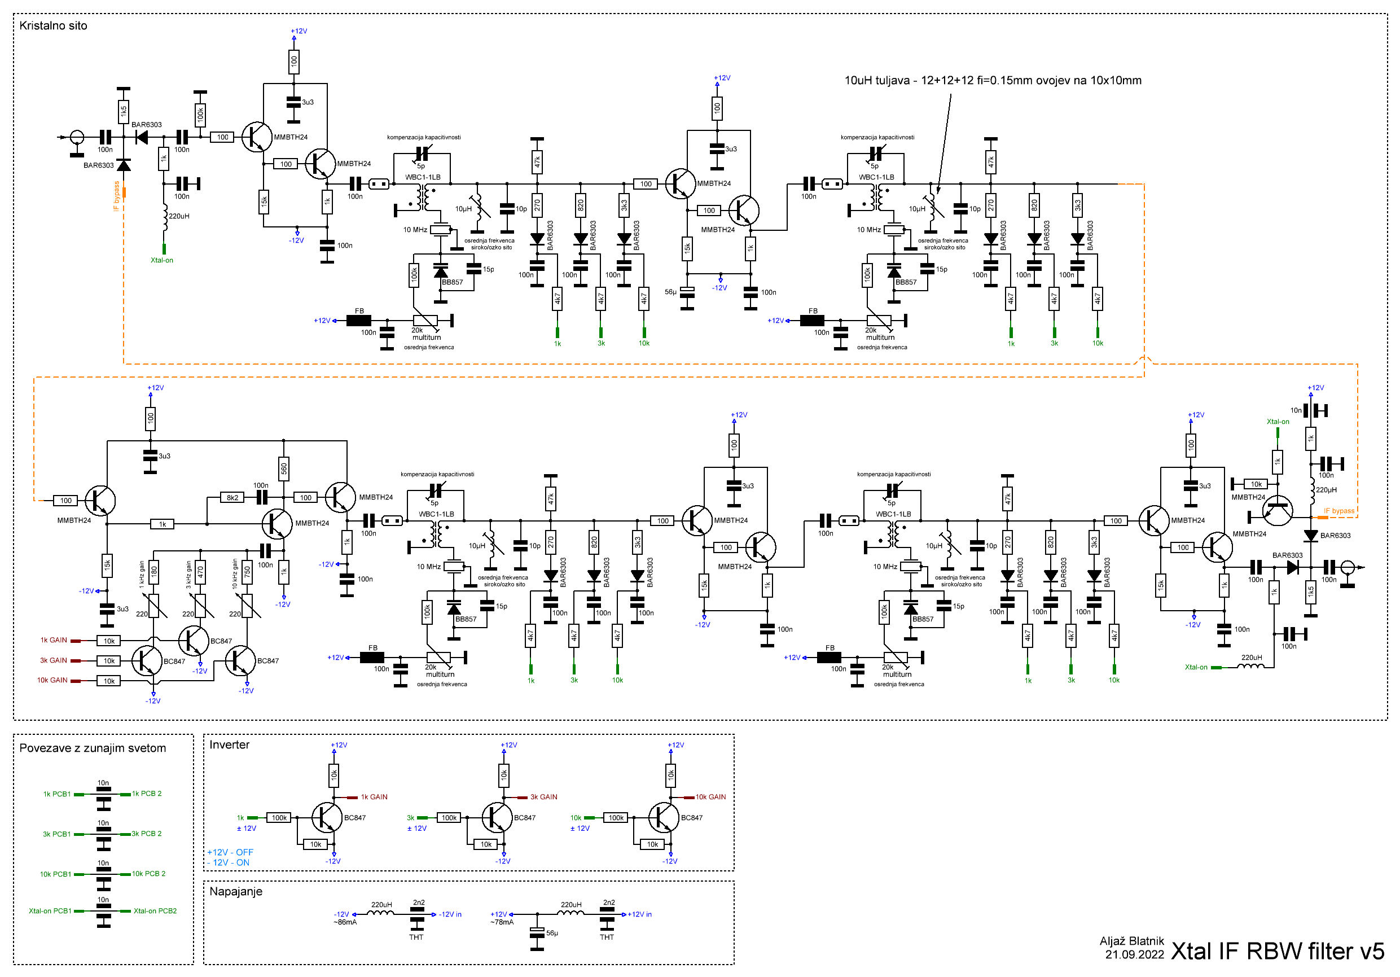
RBW Xtal filter/RBW_Xtal_schematic.png
