aljazblatnik/Spectrum-analyzer/REF clock/photo/IMG_5198.jpg

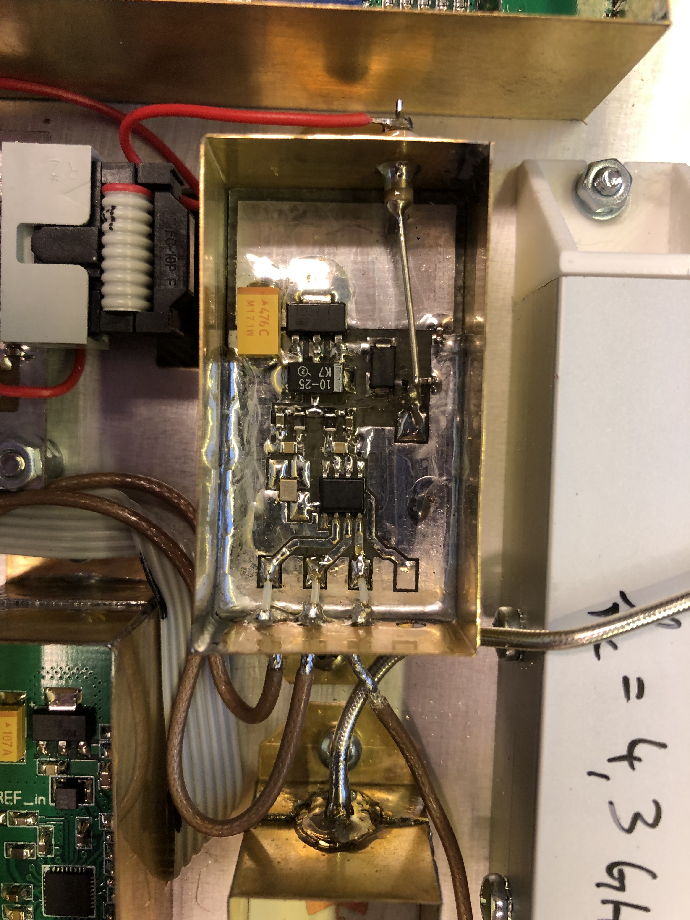
REF clock/photo/IMG_5198.jpg
