aljazblatnik/Spectrum-analyzer/REF clock/photo/IMG_5199.jpg

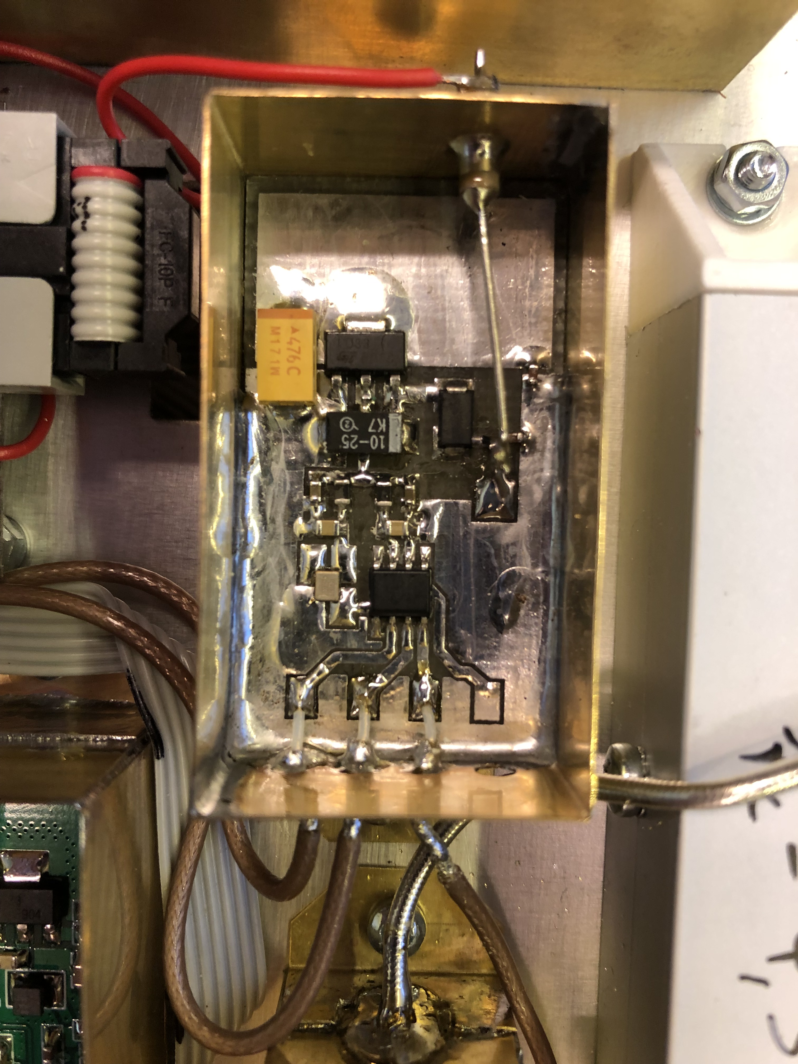
REF clock/photo/IMG_5199.jpg
