aljazblatnik/Spectrum-analyzer/REF clock/photo/IMG_5200.jpg

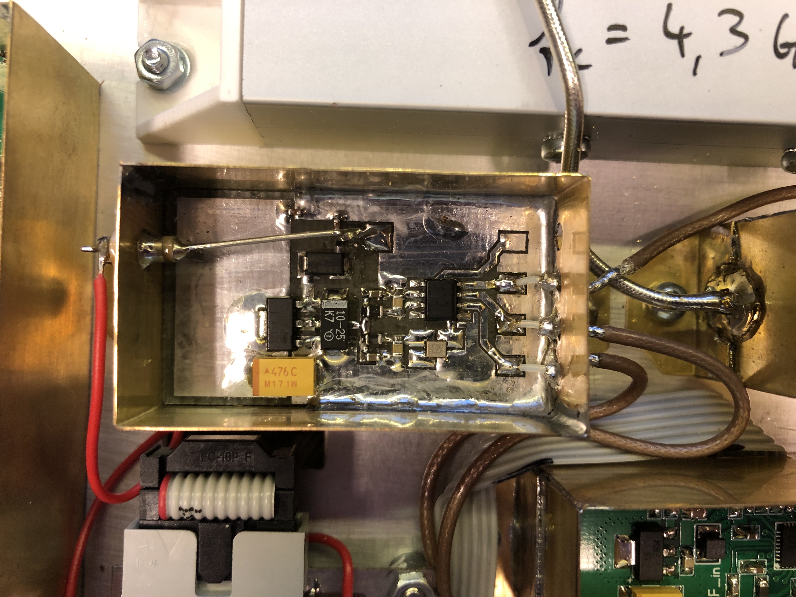
REF clock/photo/IMG_5200.jpg
