aljazblatnik/Spectrum-analyzer/REF clock/photo/IMG_5201.jpg

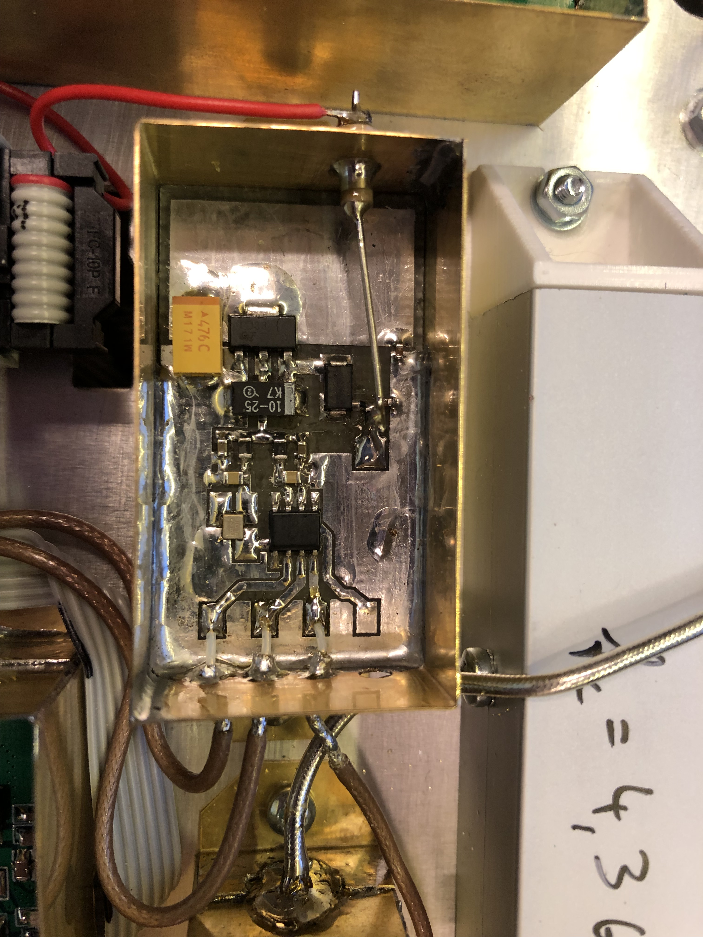
REF clock/photo/IMG_5201.jpg
