aljazblatnik/Spectrum-analyzer/REF clock/photo/IMG_5202.jpg

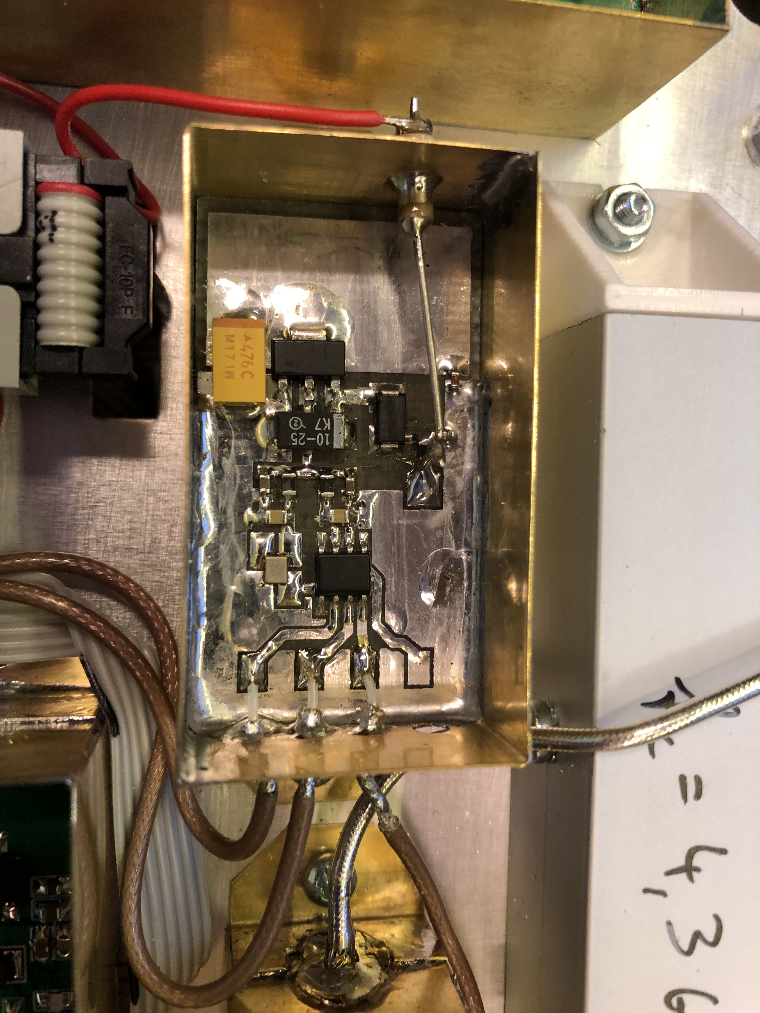
REF clock/photo/IMG_5202.jpg
