aljazblatnik/Spectrum-analyzer/REF clock/photo/IMG_5203.jpg

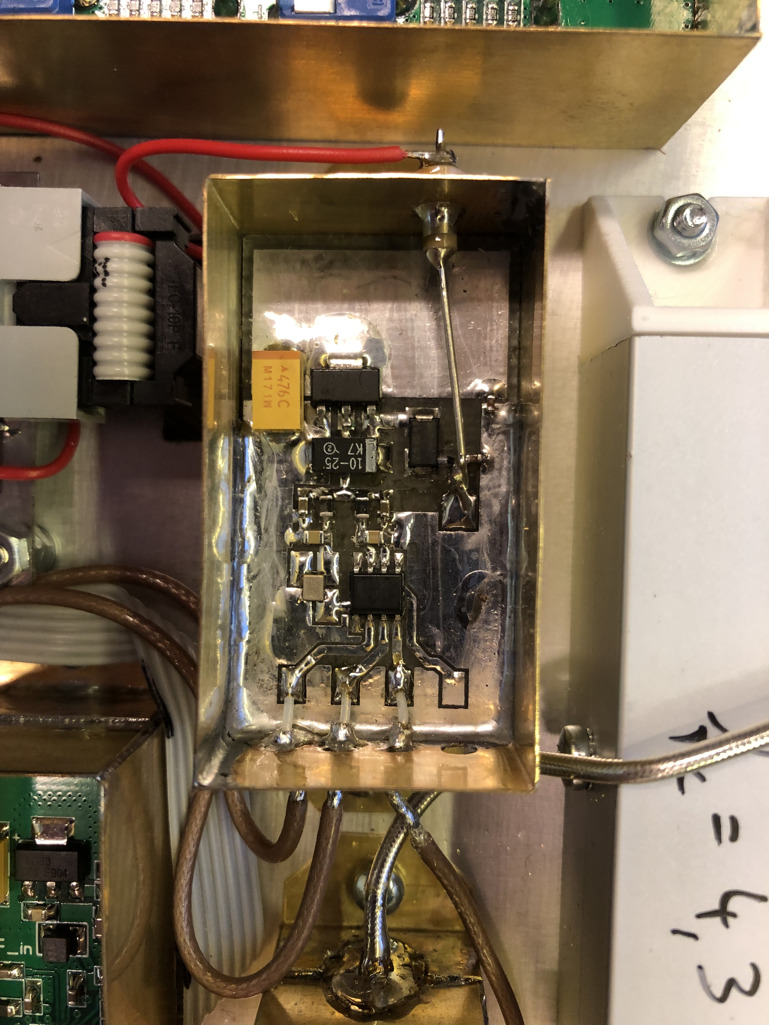
REF clock/photo/IMG_5203.jpg
