aljazblatnik/Spectrum-analyzer/REF clock/REF CLK schematic.png

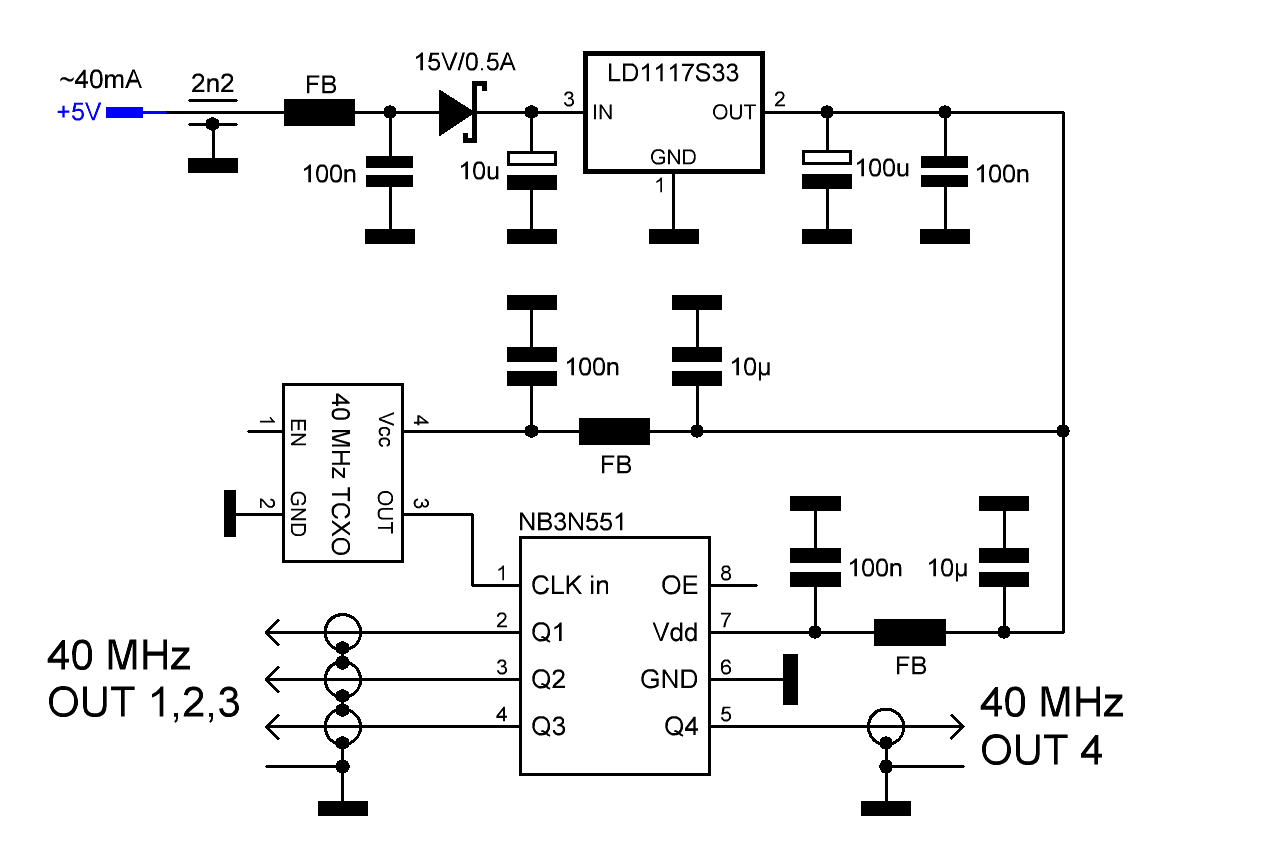
REF clock/REF CLK schematic.png
