aljazblatnik/Spectrum-analyzer/TG ARO/AGC ATT schematic.png

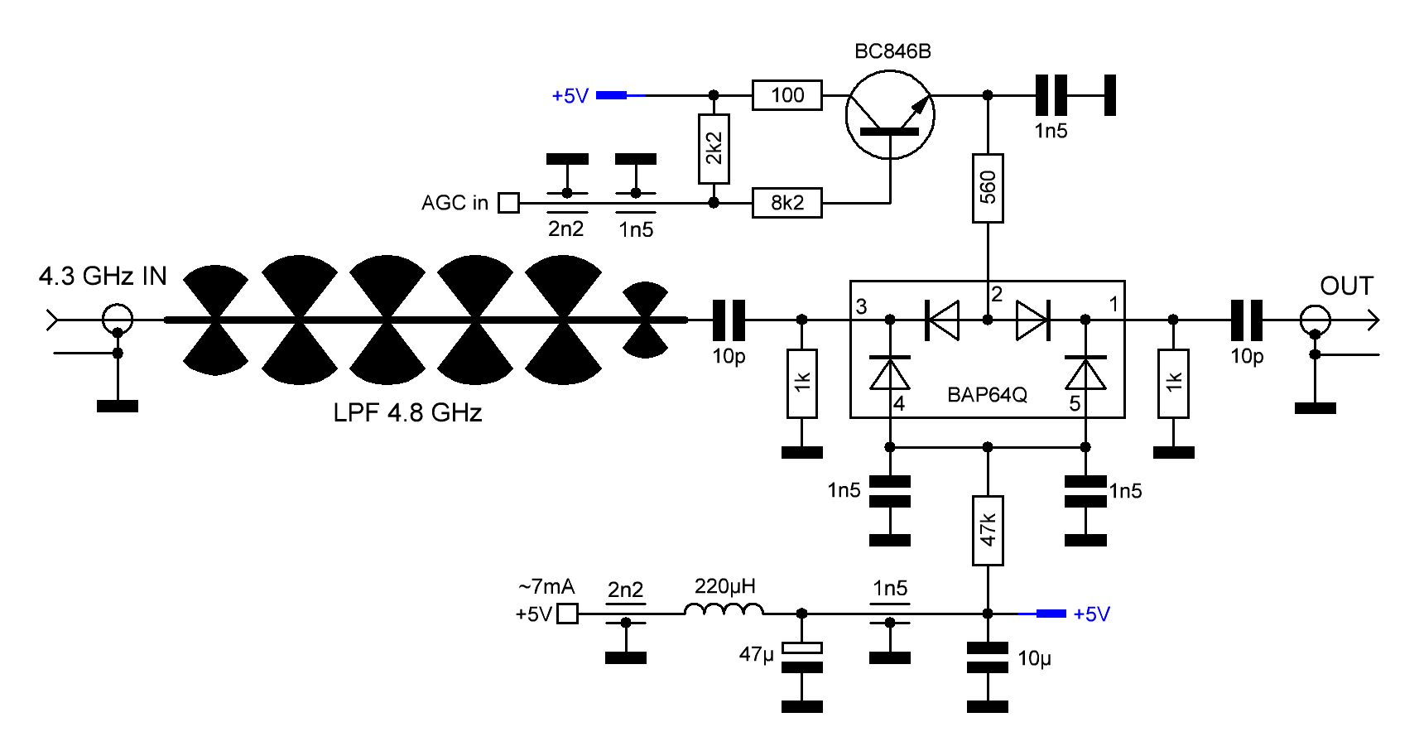
TG ARO/AGC ATT schematic.png
