aljazblatnik/Spectrum-analyzer/TG ARO/photo/IMG_5235.jpg

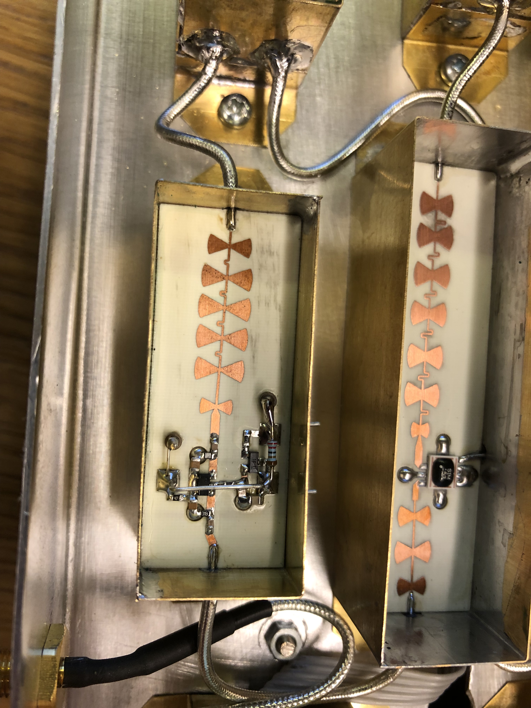
TG ARO/photo/IMG_5235.jpg
