aljazblatnik/Spectrum-analyzer/TG ARO/photo/IMG_5236.jpg

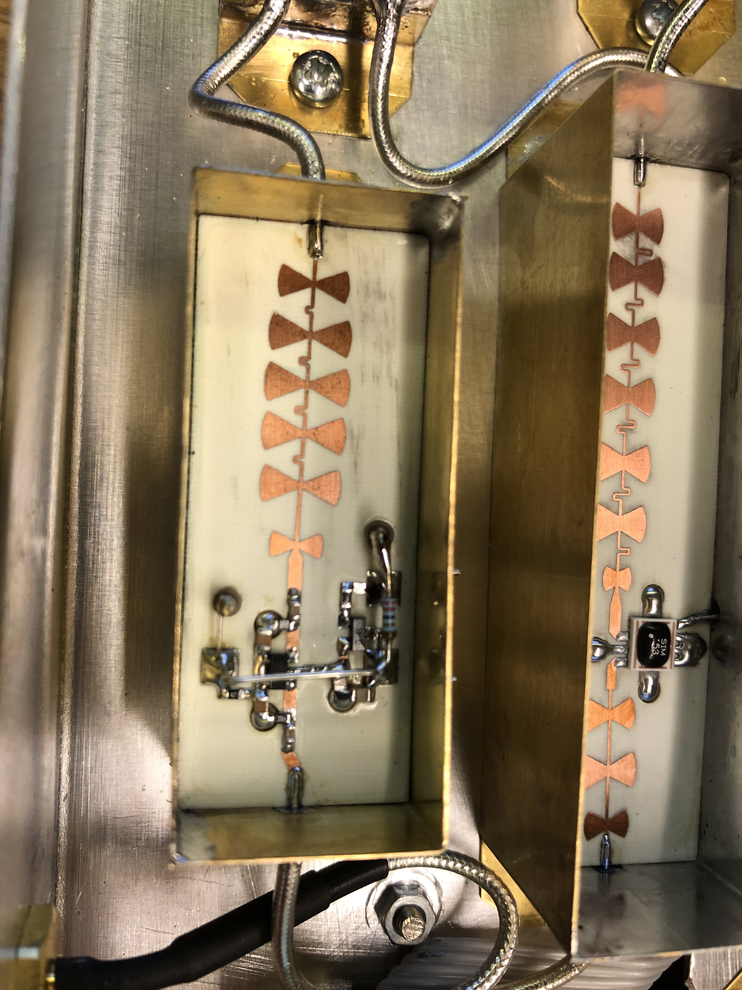
TG ARO/photo/IMG_5236.jpg
