aljazblatnik/Spectrum-analyzer/TG ARO/photo/IMG_5237.jpg

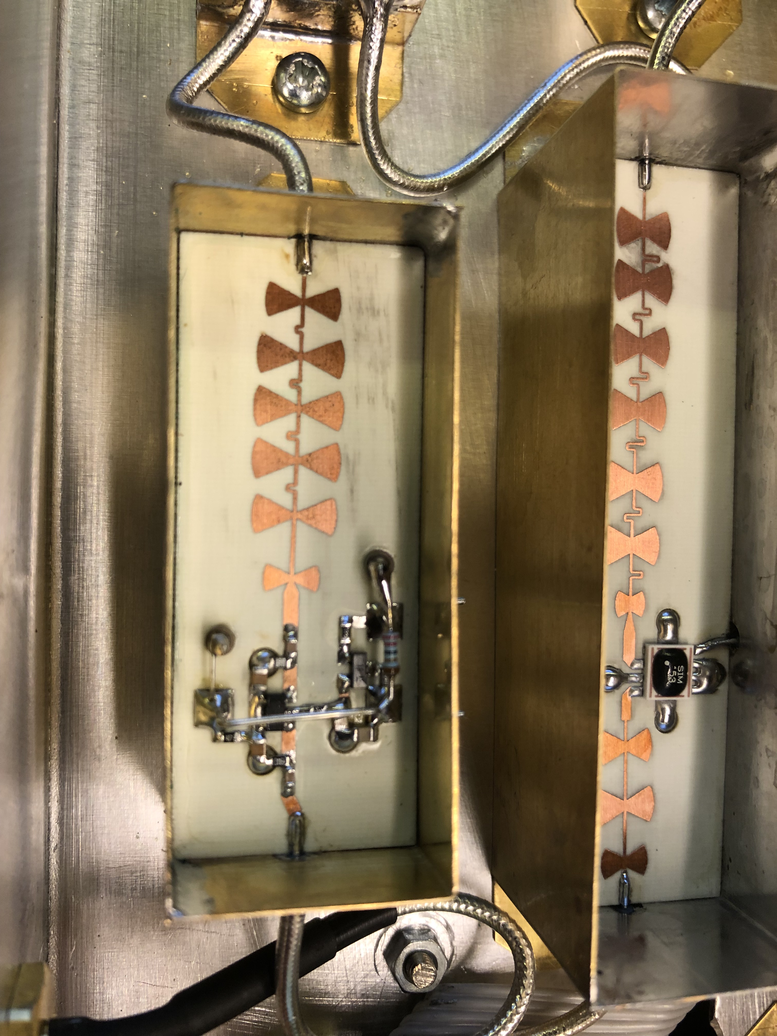
TG ARO/photo/IMG_5237.jpg
