aljazblatnik/Spectrum-analyzer/TG ARO/photo/IMG_5238.jpg

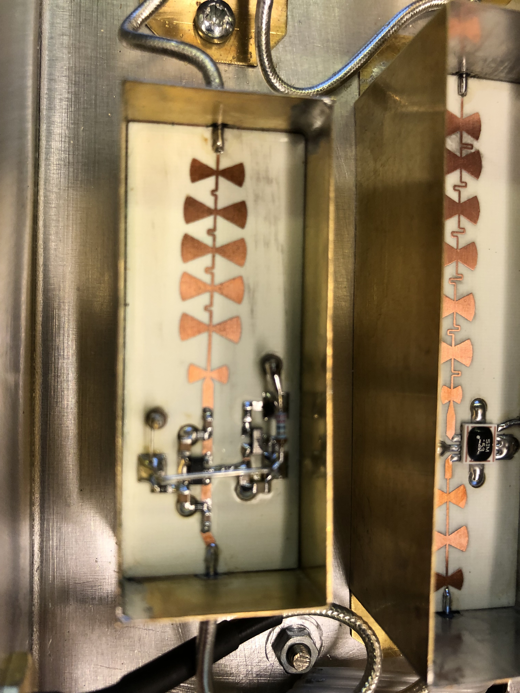
TG ARO/photo/IMG_5238.jpg
