aljazblatnik/Spectrum-analyzer/TG ARO/photo/IMG_5239.jpg

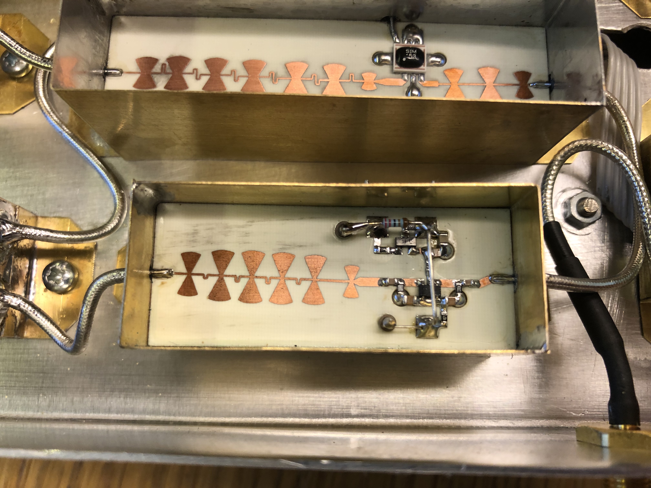
TG ARO/photo/IMG_5239.jpg
