aljazblatnik/Spectrum-analyzer/TG ARO/photo/IMG_5290.jpg

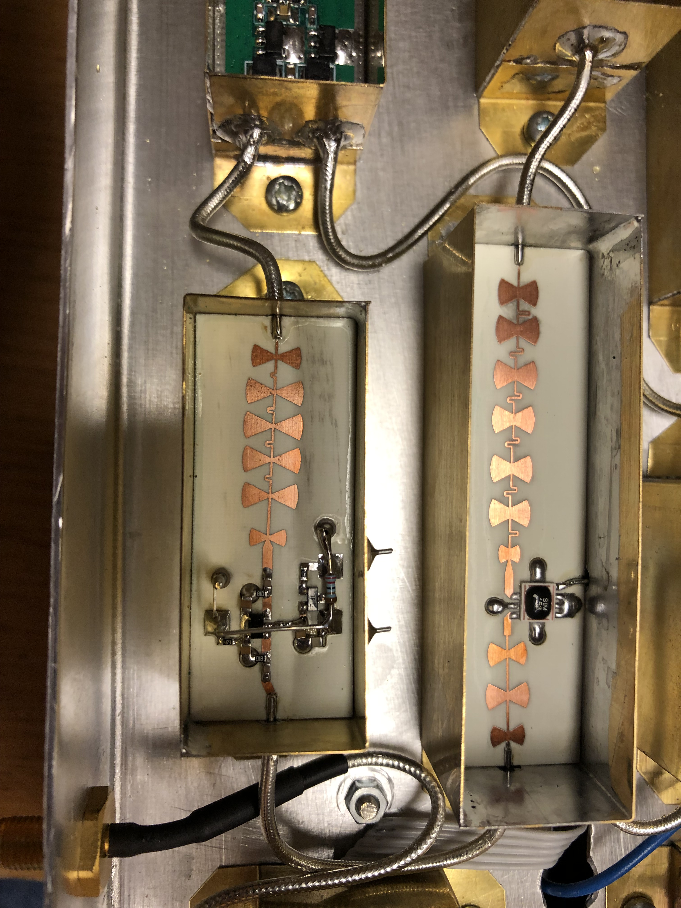
TG ARO/photo/IMG_5290.jpg
