aljazblatnik/Spectrum-analyzer/TG ARO/photo/IMG_5291.jpg

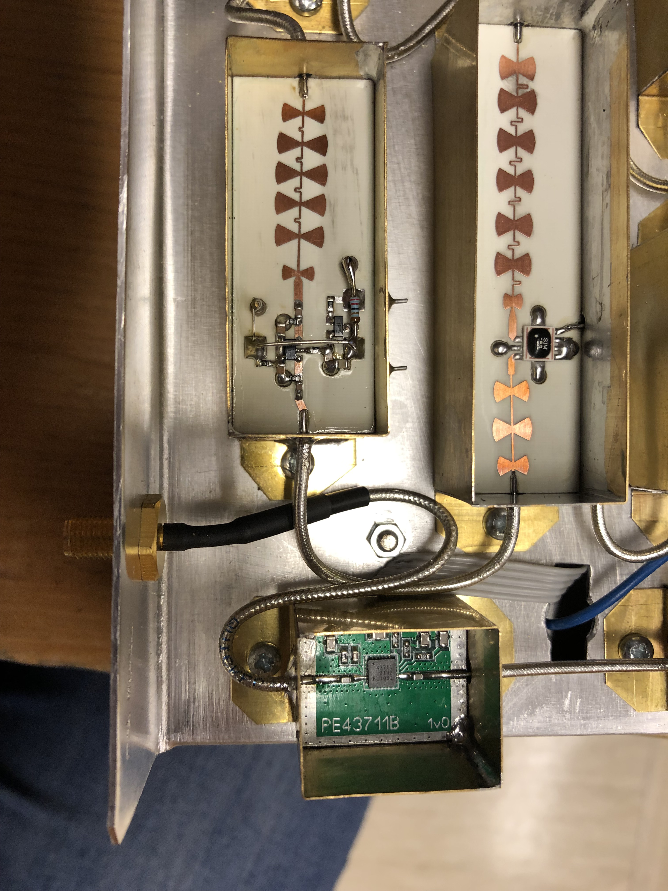
TG ARO/photo/IMG_5291.jpg
