aljazblatnik/Spectrum-analyzer/TG ARO/photo/IMG_5292.jpg

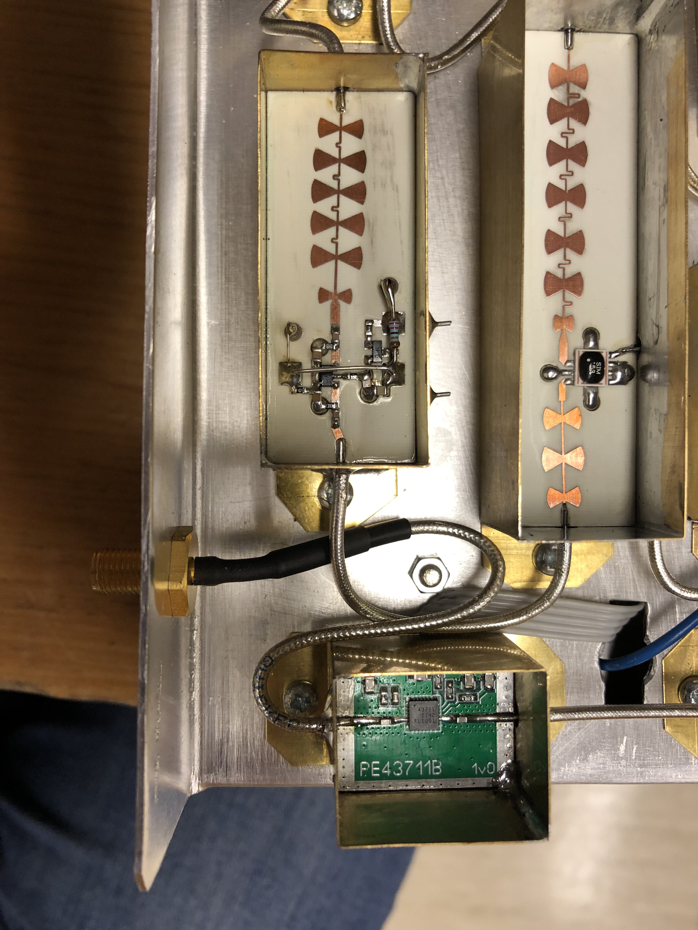
TG ARO/photo/IMG_5292.jpg
