aljazblatnik/Spectrum-analyzer/TG ARO/photo/IMG_5293.jpg

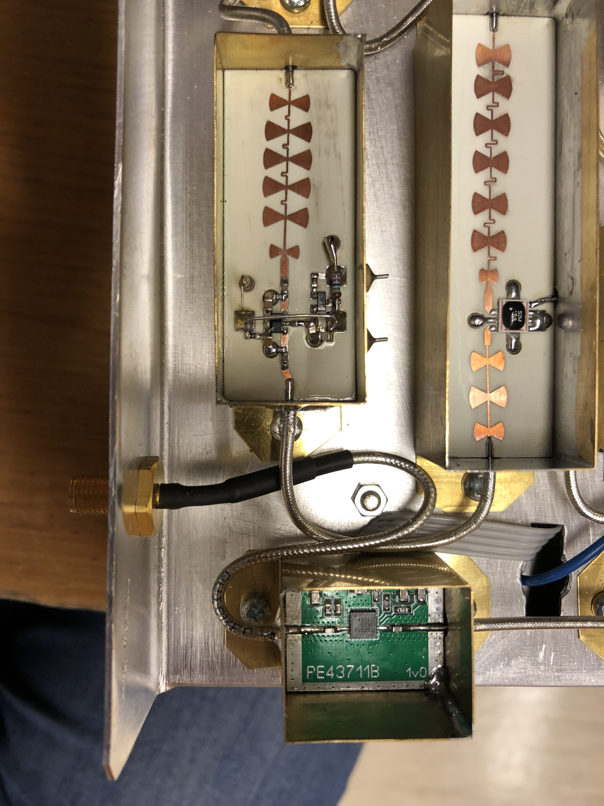
TG ARO/photo/IMG_5293.jpg
