aljazblatnik/Spectrum-analyzer/TG output AMP/photo/IMG_5240.jpg

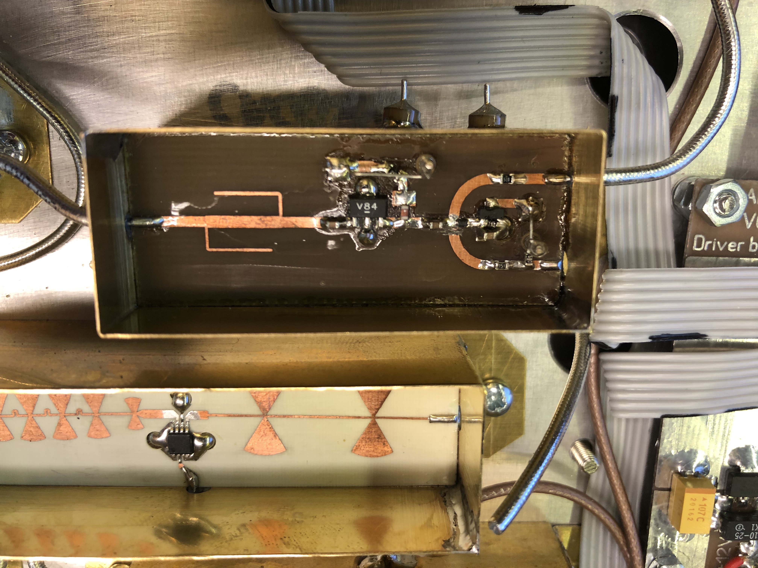
TG output AMP/photo/IMG_5240.jpg
