aljazblatnik/Spectrum-analyzer/TG output AMP/photo/IMG_5241.jpg

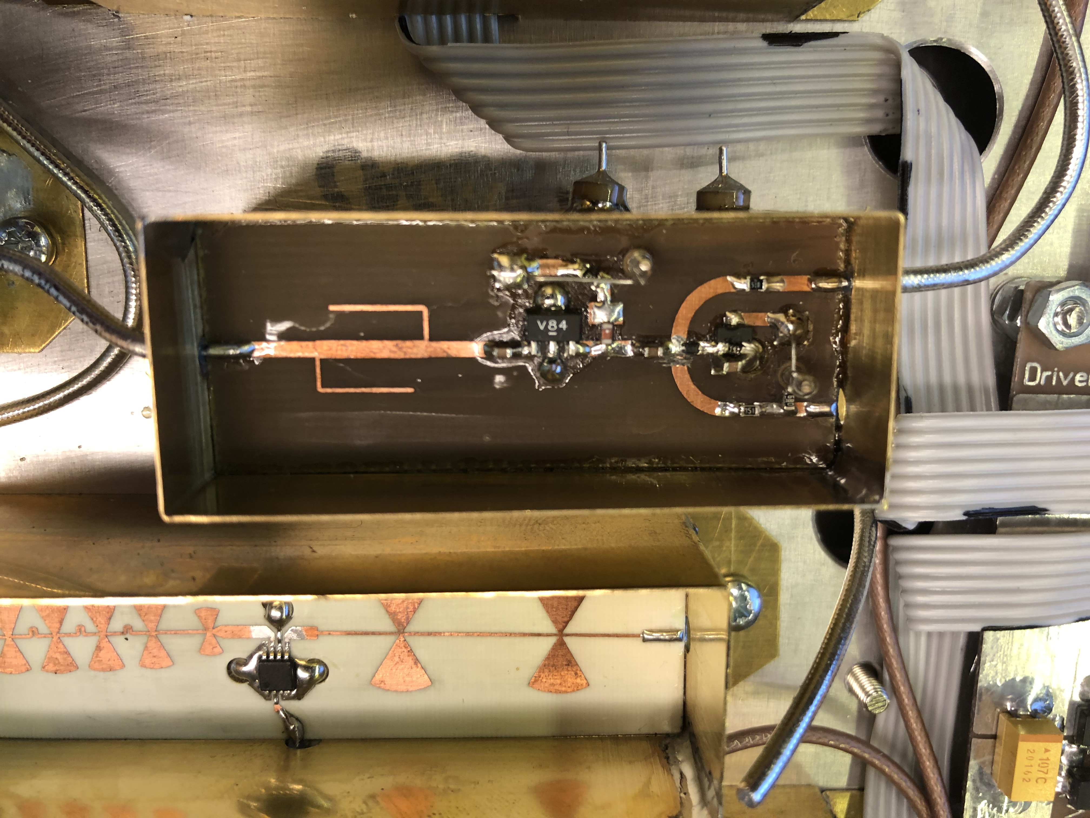
TG output AMP/photo/IMG_5241.jpg
