aljazblatnik/Spectrum-analyzer/TG output AMP/photo/IMG_5284.jpg

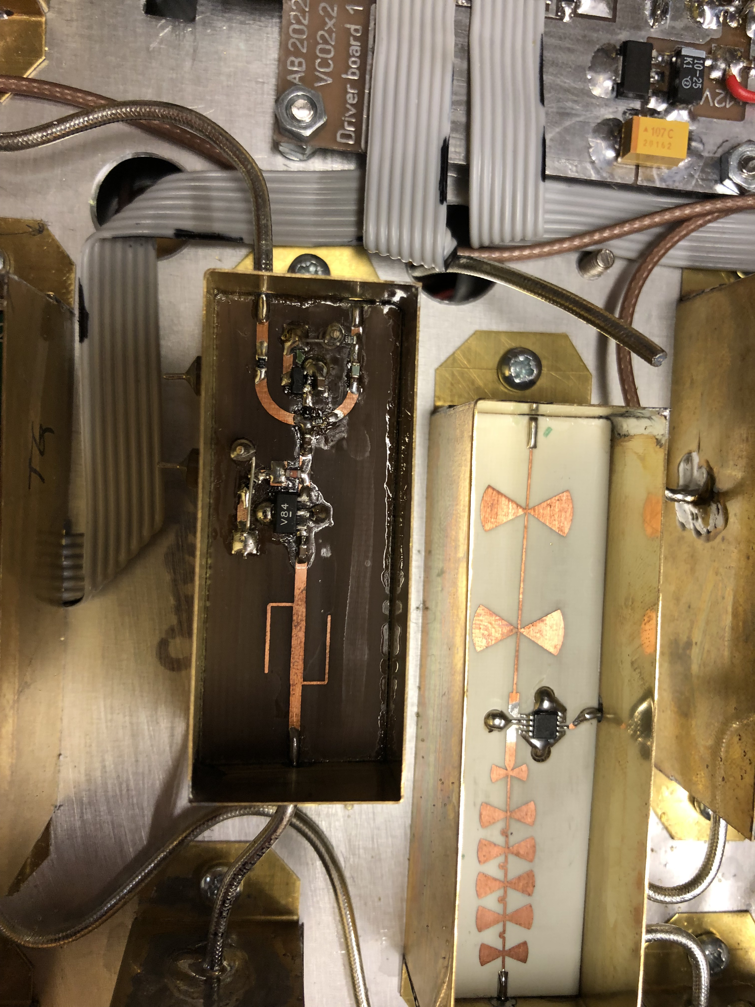
TG output AMP/photo/IMG_5284.jpg
