aljazblatnik/Spectrum-analyzer/TG output AMP/photo/IMG_5285.jpg

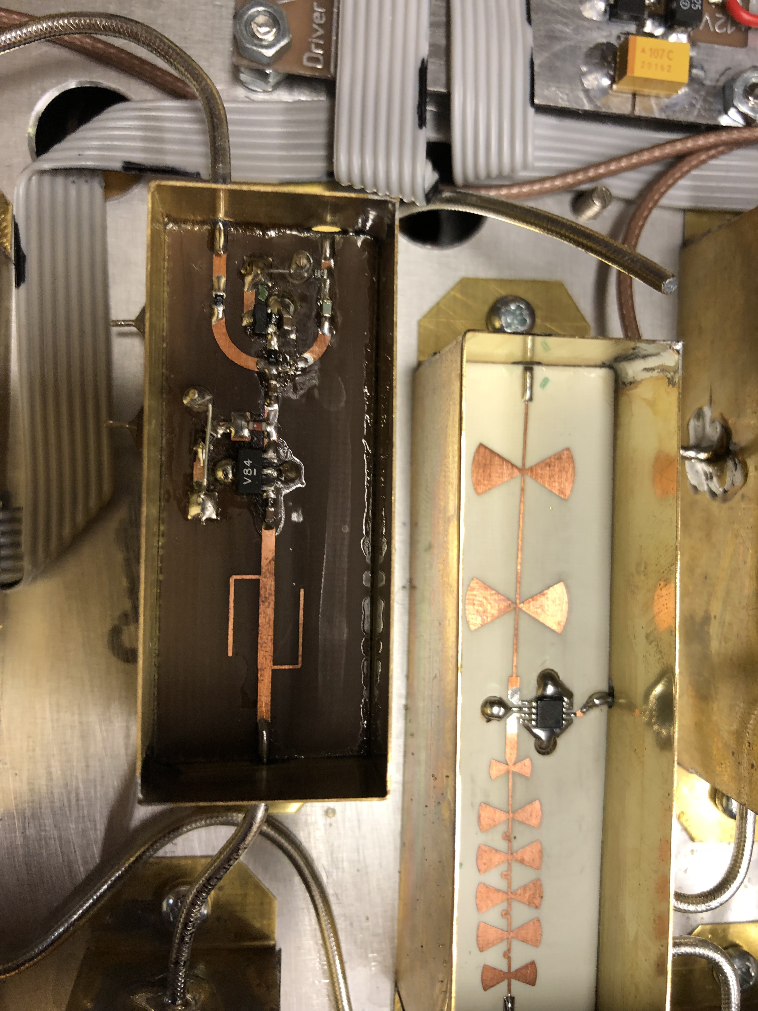
TG output AMP/photo/IMG_5285.jpg
