aljazblatnik/Spectrum-analyzer/TG output AMP/photo/IMG_5286.jpg

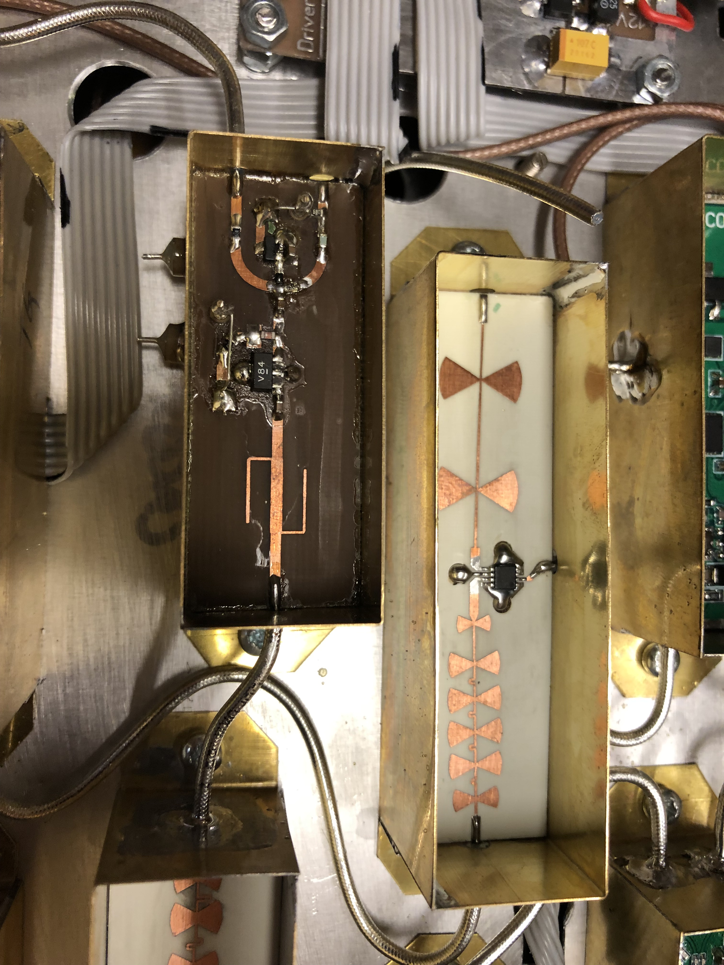
TG output AMP/photo/IMG_5286.jpg
