aljazblatnik/Spectrum-analyzer/TG output AMP/photo/IMG_5288.jpg

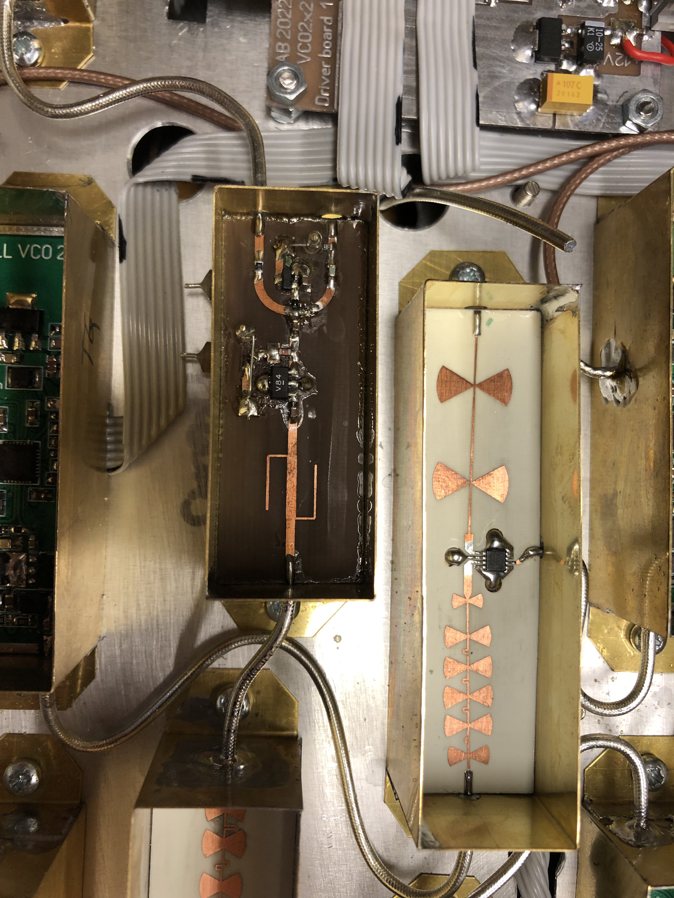
TG output AMP/photo/IMG_5288.jpg
