aljazblatnik/Spectrum-analyzer/TG output AMP/photo/IMG_5295.jpg

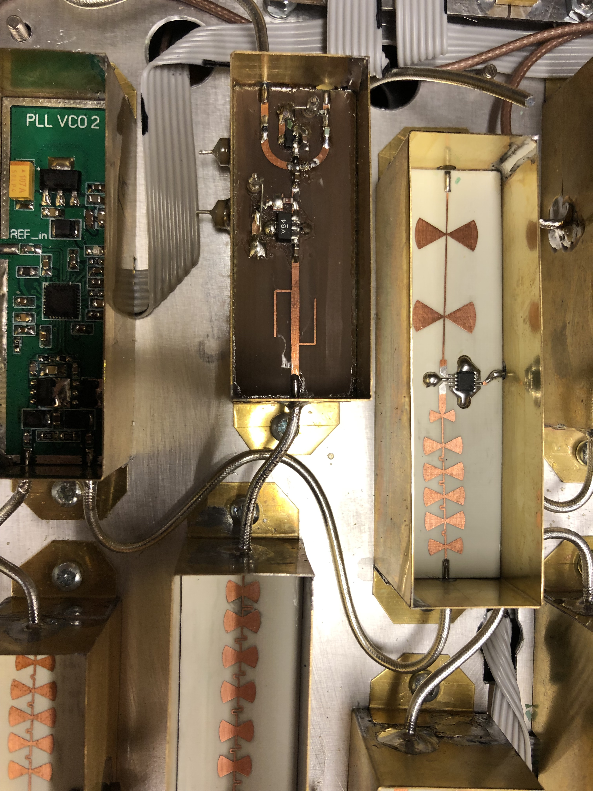
TG output AMP/photo/IMG_5295.jpg
