aljazblatnik/Spectrum-analyzer/TG output AMP/photo/IMG_5296.jpg

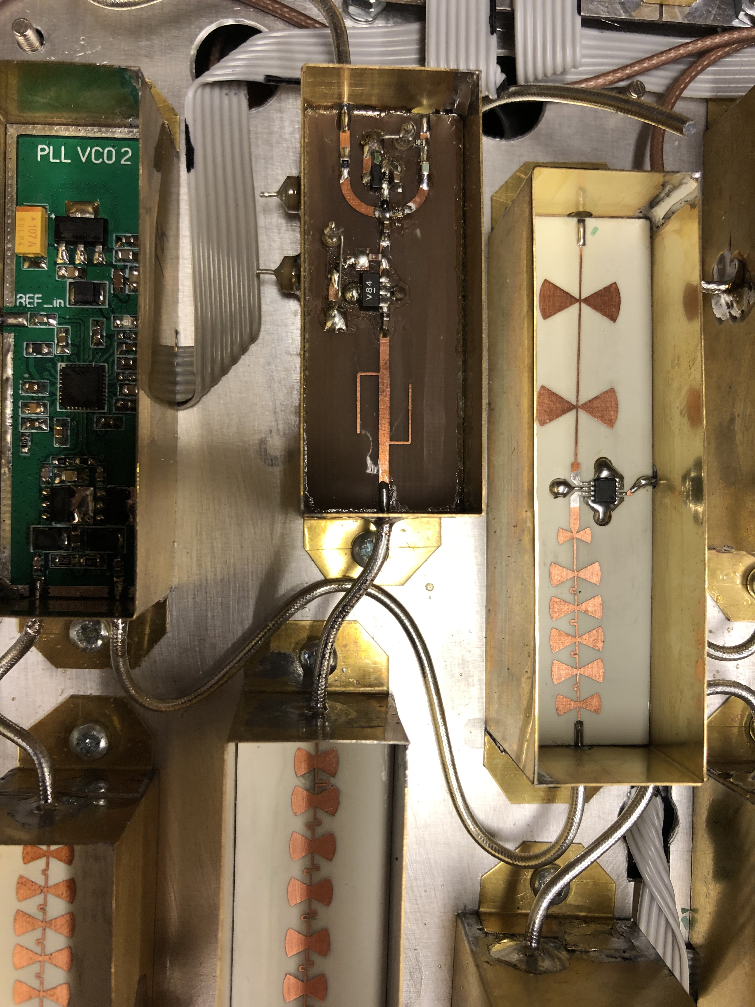
TG output AMP/photo/IMG_5296.jpg
