aljazblatnik/Spectrum-analyzer/TG output AMP/TG output AMP schematic.png

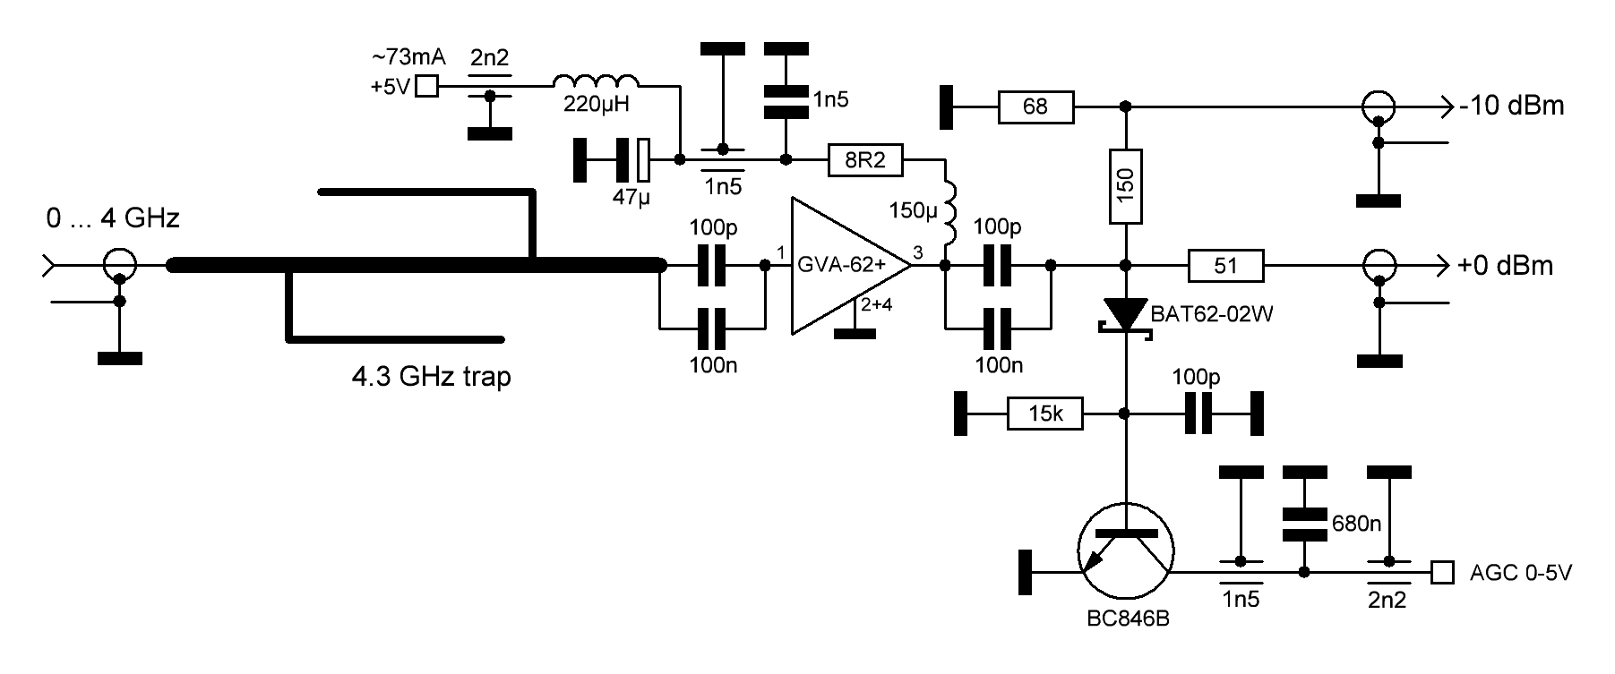
TG output AMP/TG output AMP schematic.png
