aljazblatnik/Spectrum-analyzer/TG PHASE comp/PHASE COMP schematic.png

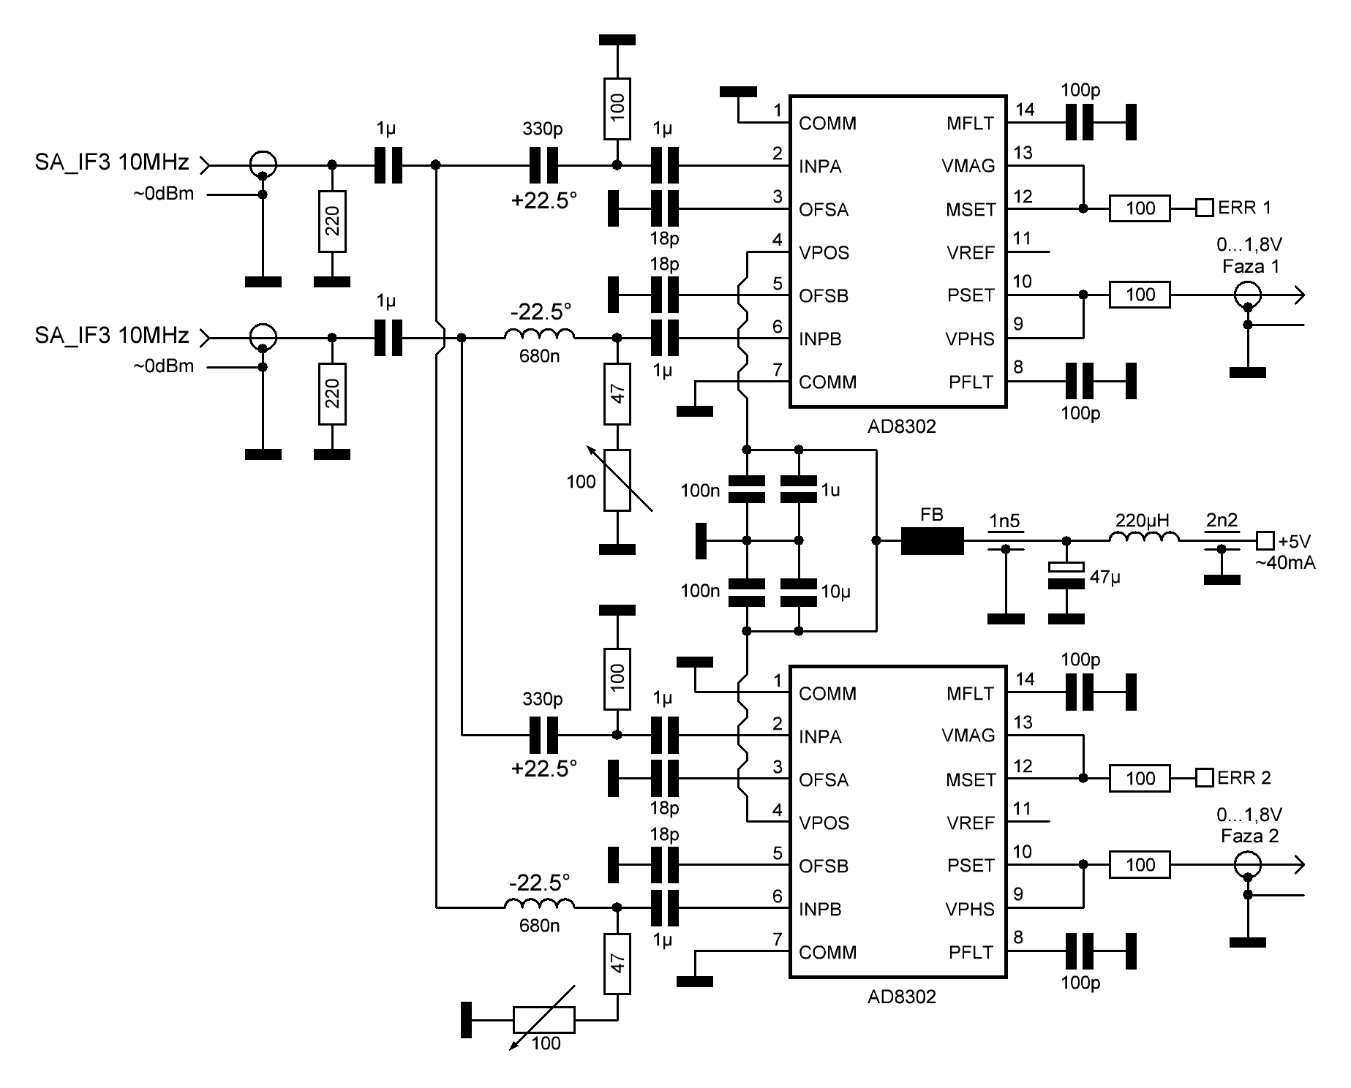
TG PHASE comp/PHASE COMP schematic.png
