aljazblatnik/Spectrum-analyzer/TG PHASE comp/photo/IMG_5303.jpg

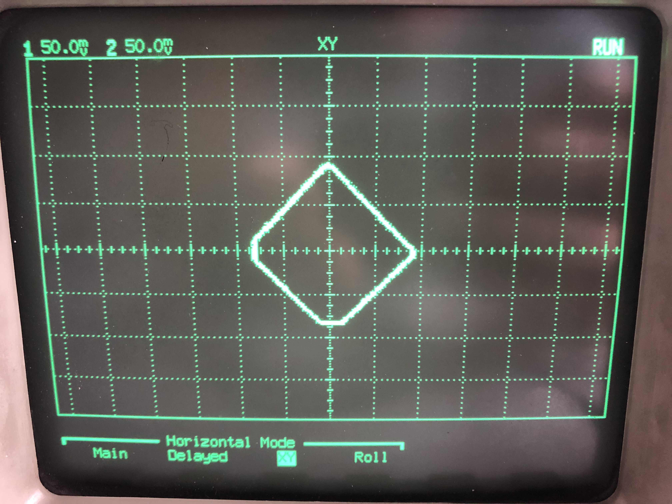
TG PHASE comp/photo/IMG_5303.jpg
