aljazblatnik/Spectrum-analyzer/TG PHASE comp/photo/IMG_5304.jpg

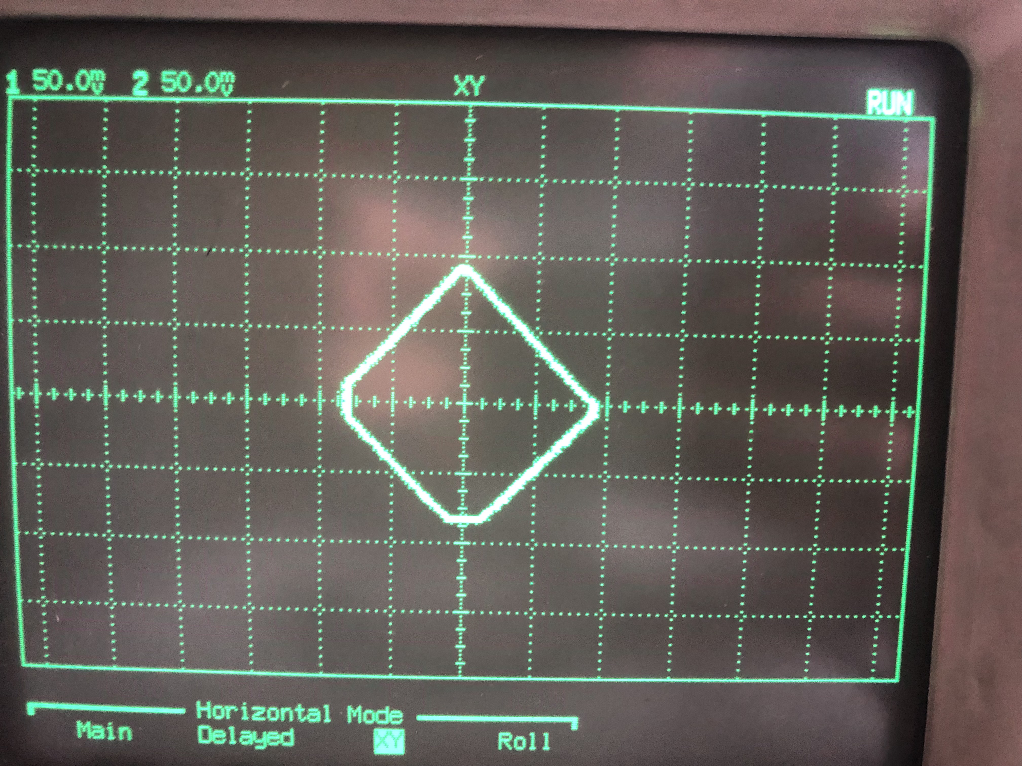
TG PHASE comp/photo/IMG_5304.jpg
