aljazblatnik/Spectrum-analyzer/TG PHASE comp/photo/IMG_5305.jpg

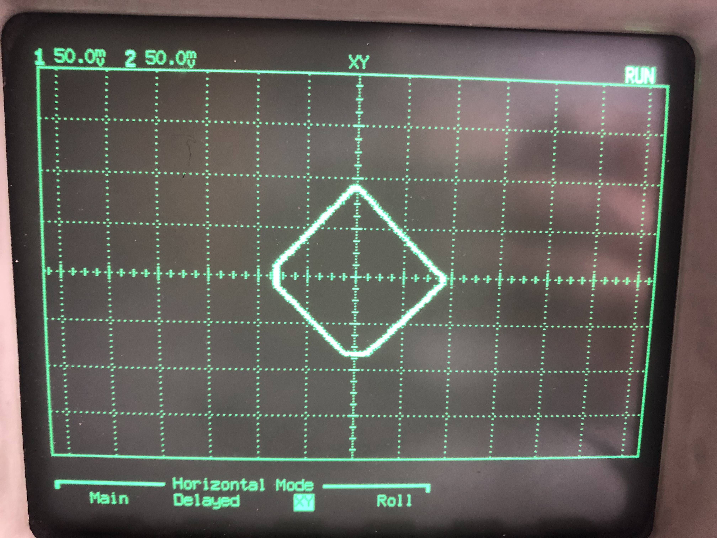
TG PHASE comp/photo/IMG_5305.jpg
