aljazblatnik/Spectrum-analyzer/TG PHASE comp/photo/IMG_5306.jpg

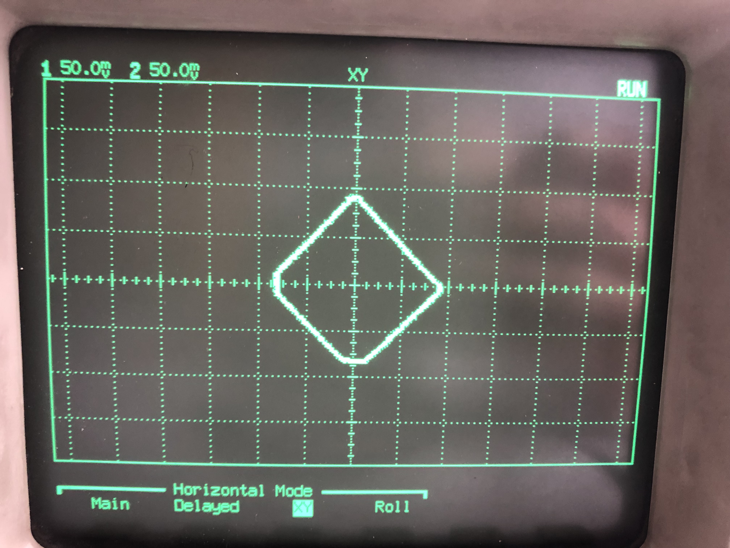
TG PHASE comp/photo/IMG_5306.jpg
