aljazblatnik/Spectrum-analyzer/TG PHASE comp/photo/IMG_5307.jpg

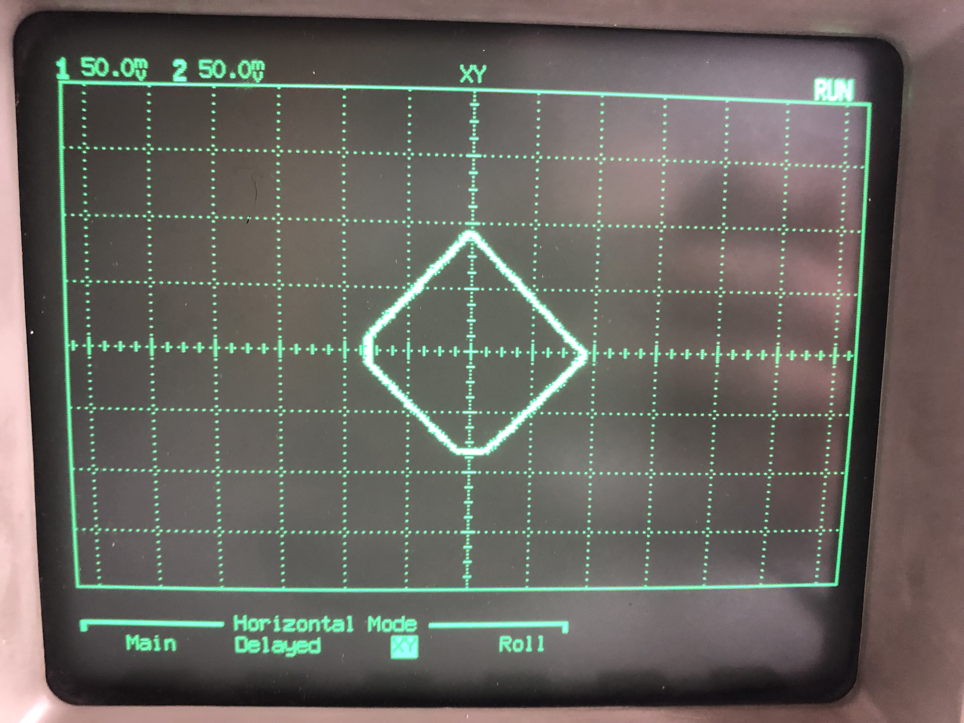
TG PHASE comp/photo/IMG_5307.jpg
