aljazblatnik/Spectrum-analyzer/TG PHASE comp/photo/IMG_5308.jpg

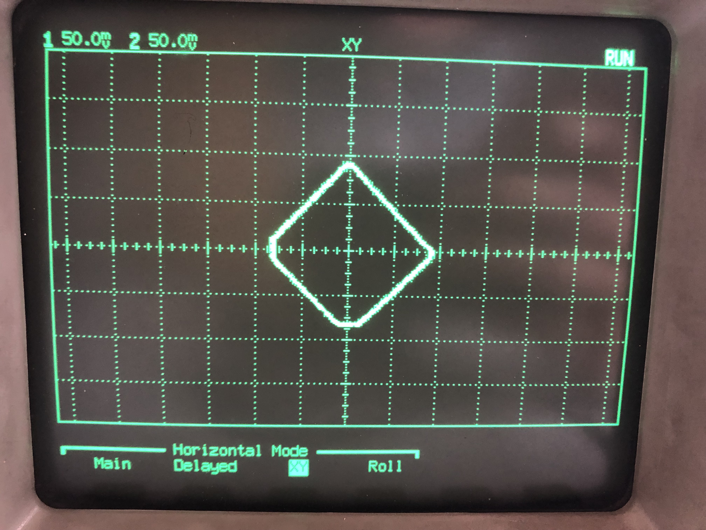
TG PHASE comp/photo/IMG_5308.jpg
