aljazblatnik/Spectrum-analyzer/TG PHASE comp/photo/IMG_5329.jpg

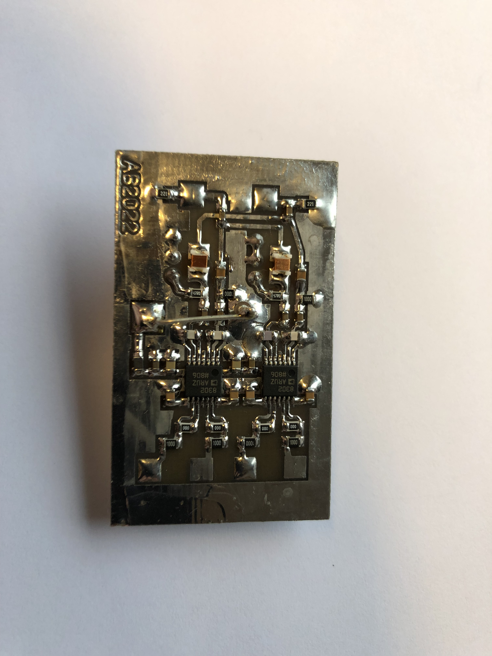
TG PHASE comp/photo/IMG_5329.jpg
