aljazblatnik/Spectrum-analyzer/TG PHASE comp/photo/IMG_5330.jpg

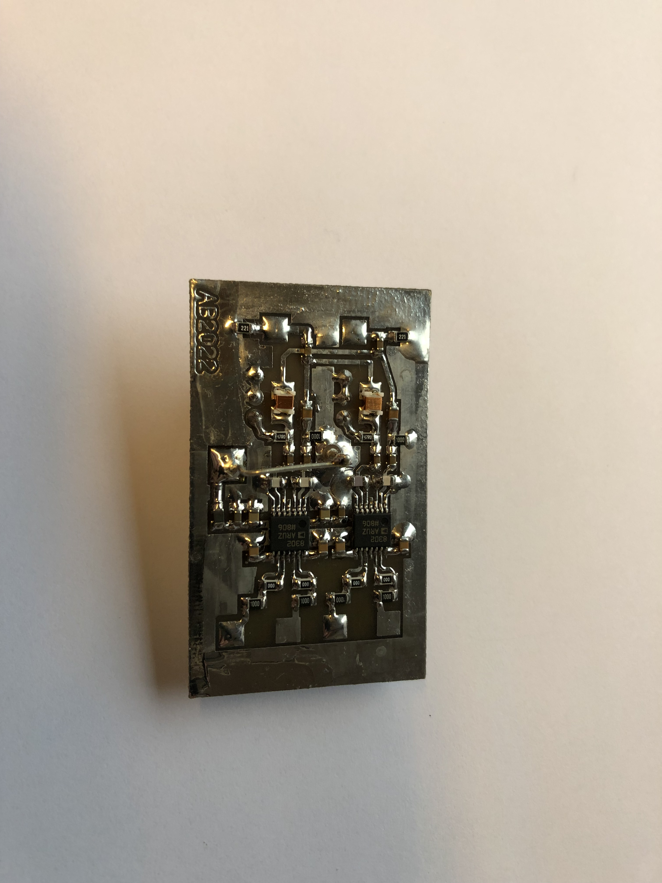
TG PHASE comp/photo/IMG_5330.jpg
