aljazblatnik/Spectrum-analyzer/TG PHASE comp/photo/IMG_5331.jpg

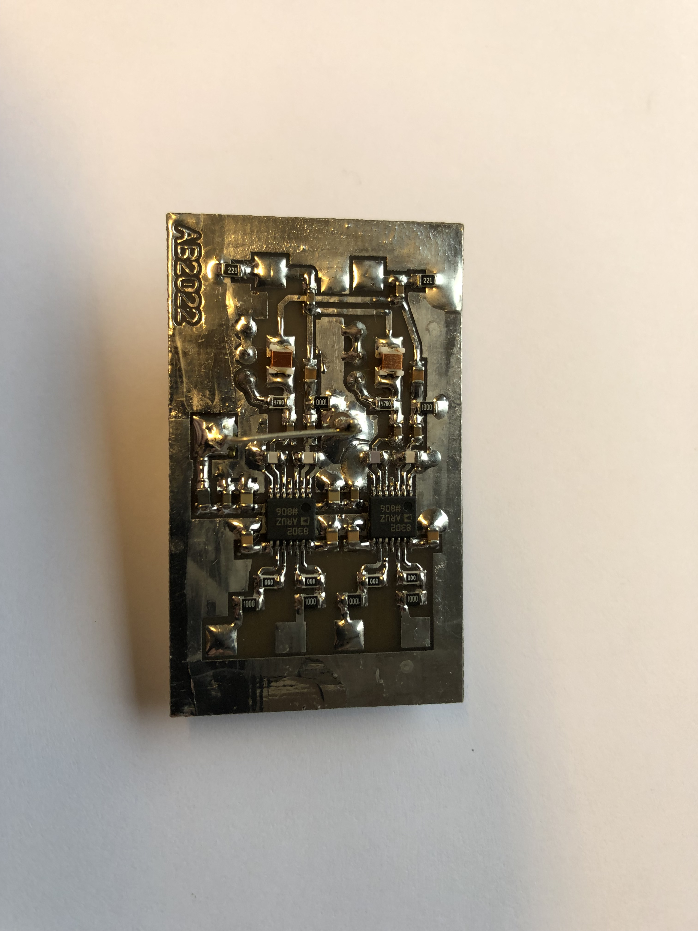
TG PHASE comp/photo/IMG_5331.jpg
