aljazblatnik/Spectrum-analyzer/TG PHASE comp/photo/IMG_5332.jpg

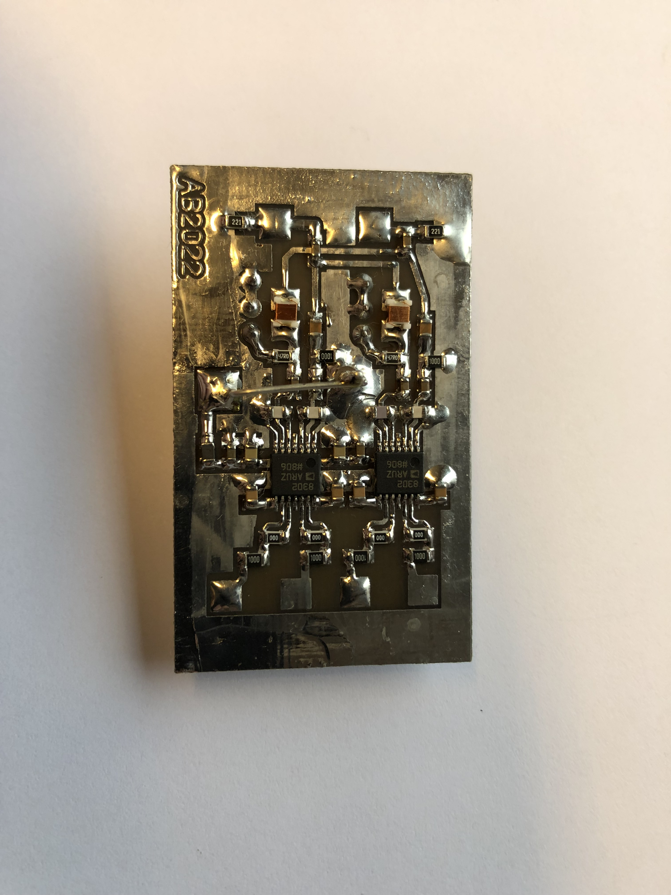
TG PHASE comp/photo/IMG_5332.jpg
