aljazblatnik/Spectrum-analyzer/TG PHASE comp/photo/IMG_5333.jpg

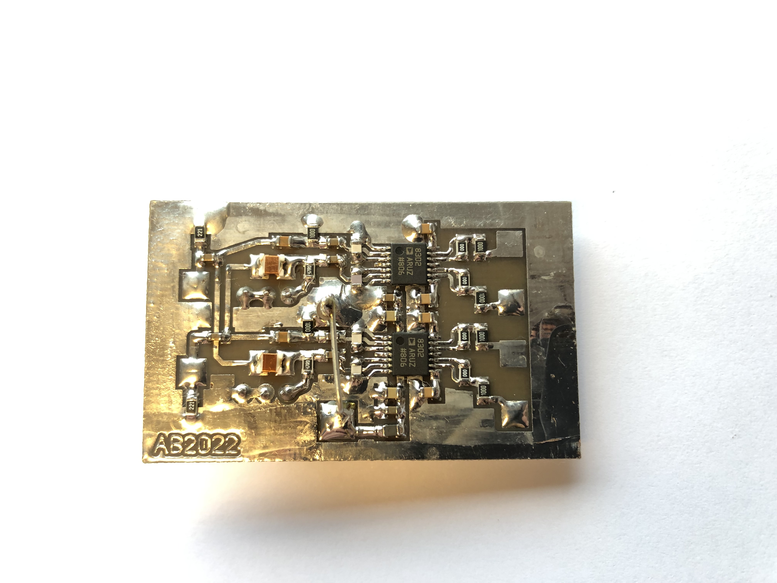
TG PHASE comp/photo/IMG_5333.jpg
