aljazblatnik/Spectrum-analyzer/TG PHASE comp/photo/IMG_5334.jpg

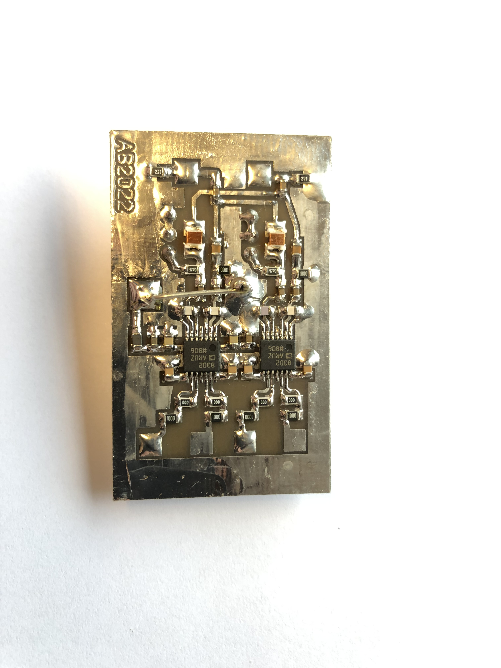
TG PHASE comp/photo/IMG_5334.jpg
