aljazblatnik/Spectrum-analyzer/TG PHASE comp/photo/IMG_5335.jpg

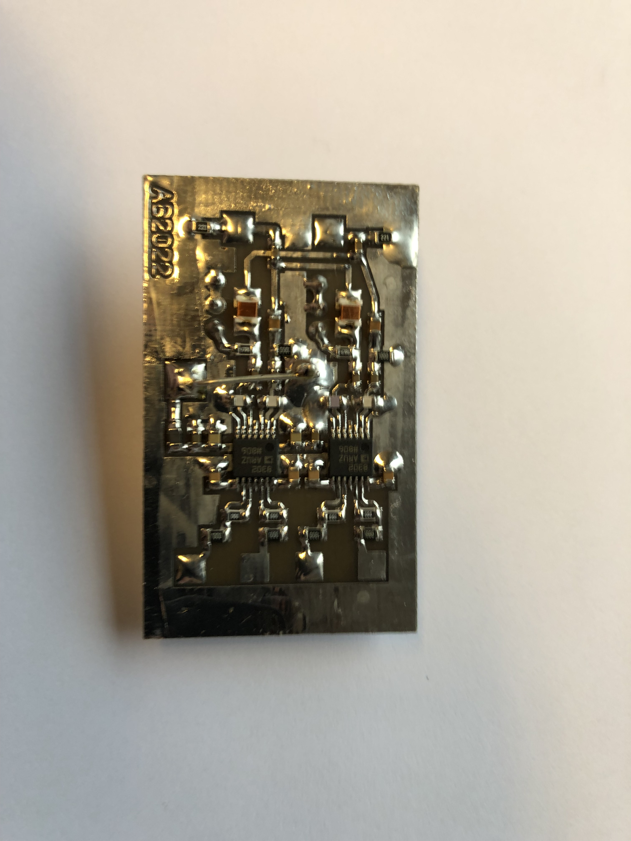
TG PHASE comp/photo/IMG_5335.jpg
