aljazblatnik/Spectrum-analyzer/TG PHASE comp/photo/IMG_5338.jpg

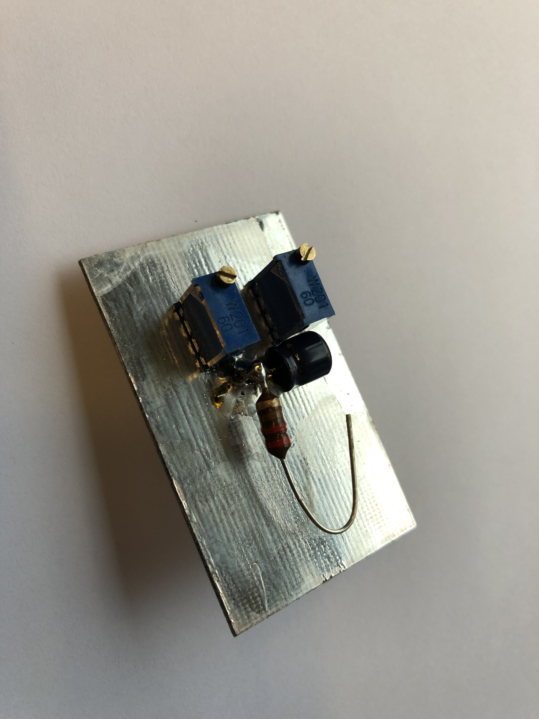
TG PHASE comp/photo/IMG_5338.jpg
