aljazblatnik/Spectrum-analyzer/TG PHASE comp/photo/IMG_5339.jpg

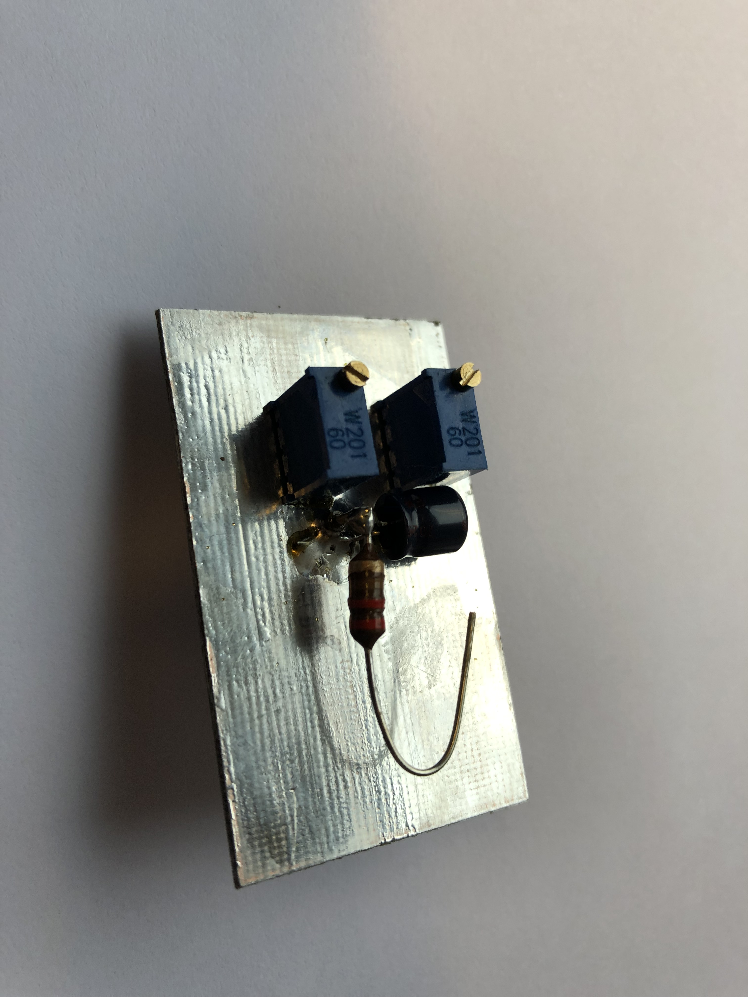
TG PHASE comp/photo/IMG_5339.jpg
