aljazblatnik/Spectrum-analyzer/VBW/photo/IMG_5266.jpg

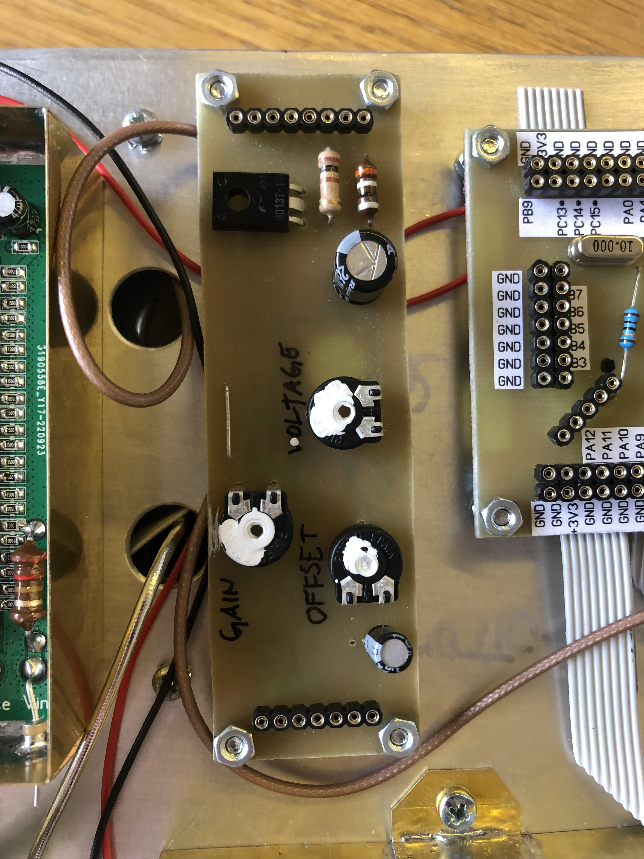
VBW/photo/IMG_5266.jpg
