aljazblatnik/Spectrum-analyzer/VBW/photo/IMG_5267.jpg

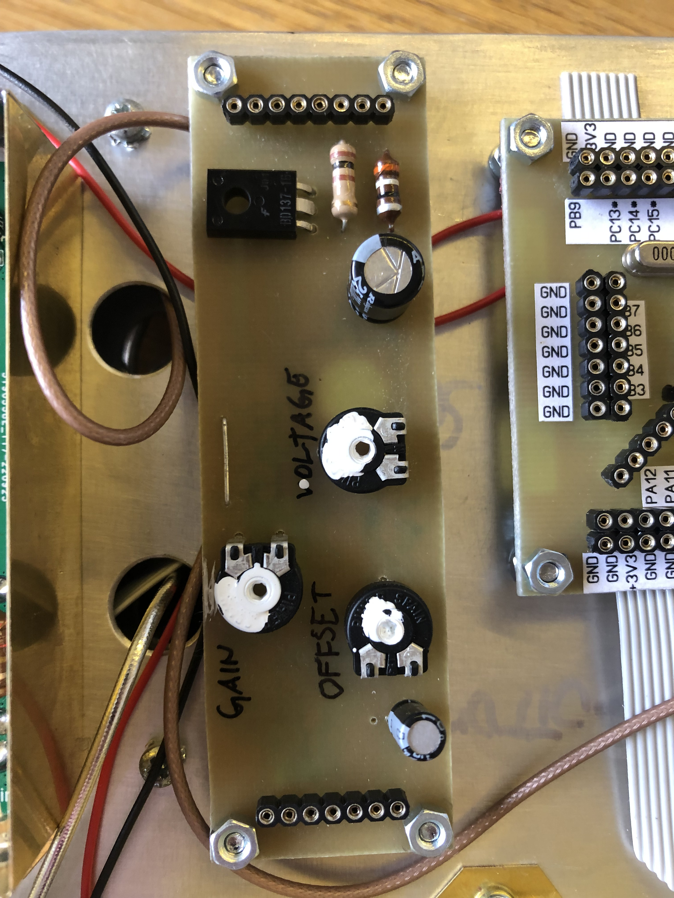
VBW/photo/IMG_5267.jpg
