aljazblatnik/Spectrum-analyzer/VBW/photo/IMG_5268.jpg

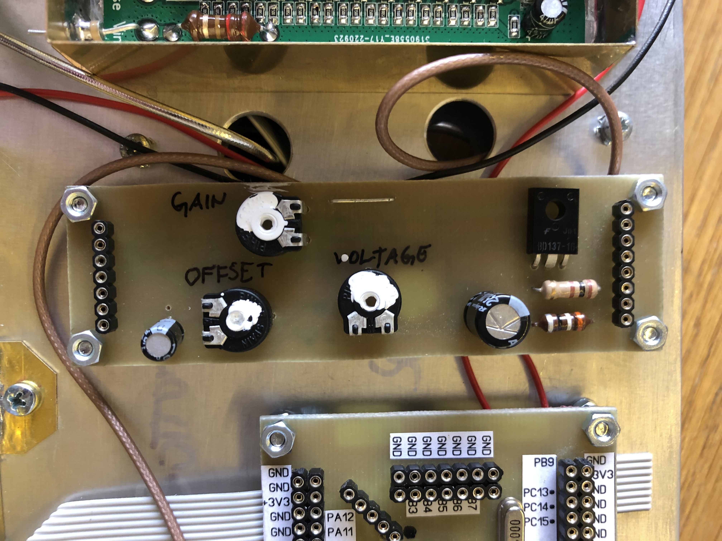
VBW/photo/IMG_5268.jpg
