aljazblatnik/Spectrum-analyzer/VBW/VIDEO schematic.png

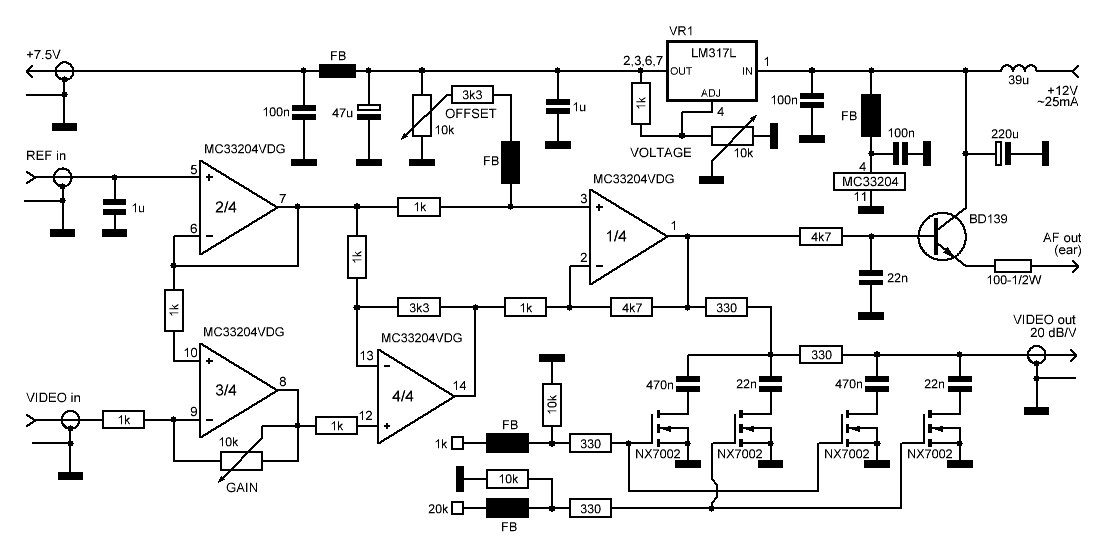
VBW/VIDEO schematic.png
