aljazblatnik/Spectrum-analyzer/MIX/MIX3_component_placement_SMD_bottom.png

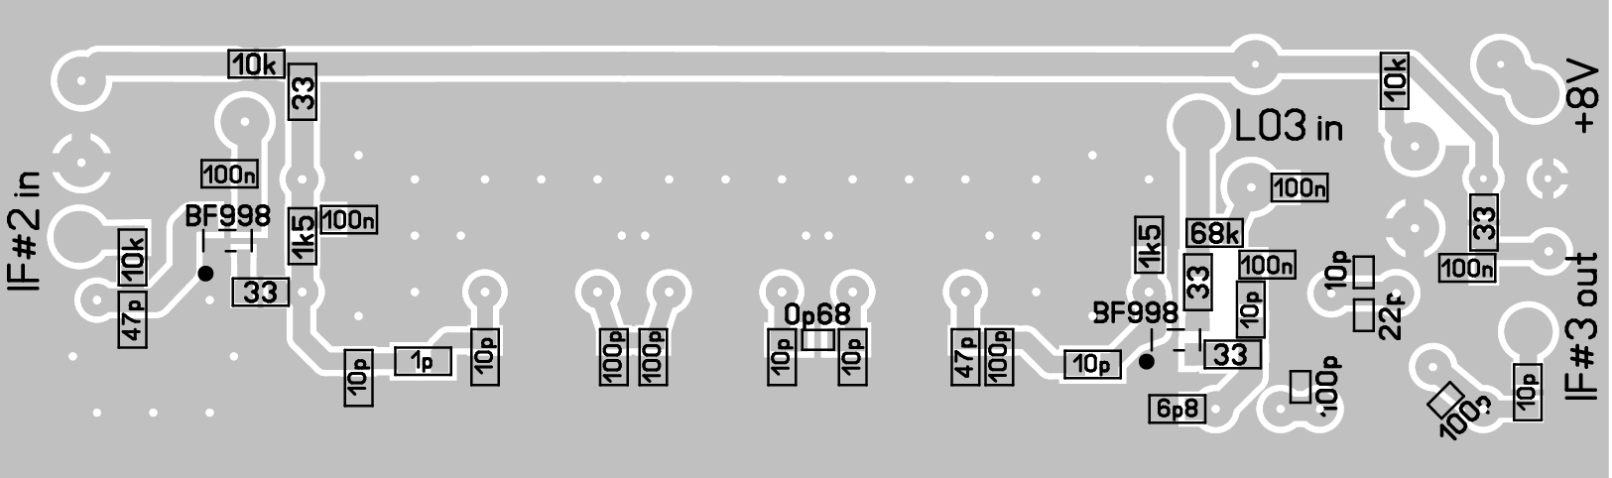
MIX/MIX3_component_placement_SMD_bottom.png
