aljazblatnik/Spectrum-analyzer/MIX/MIX3_component_placement_THT_top.png

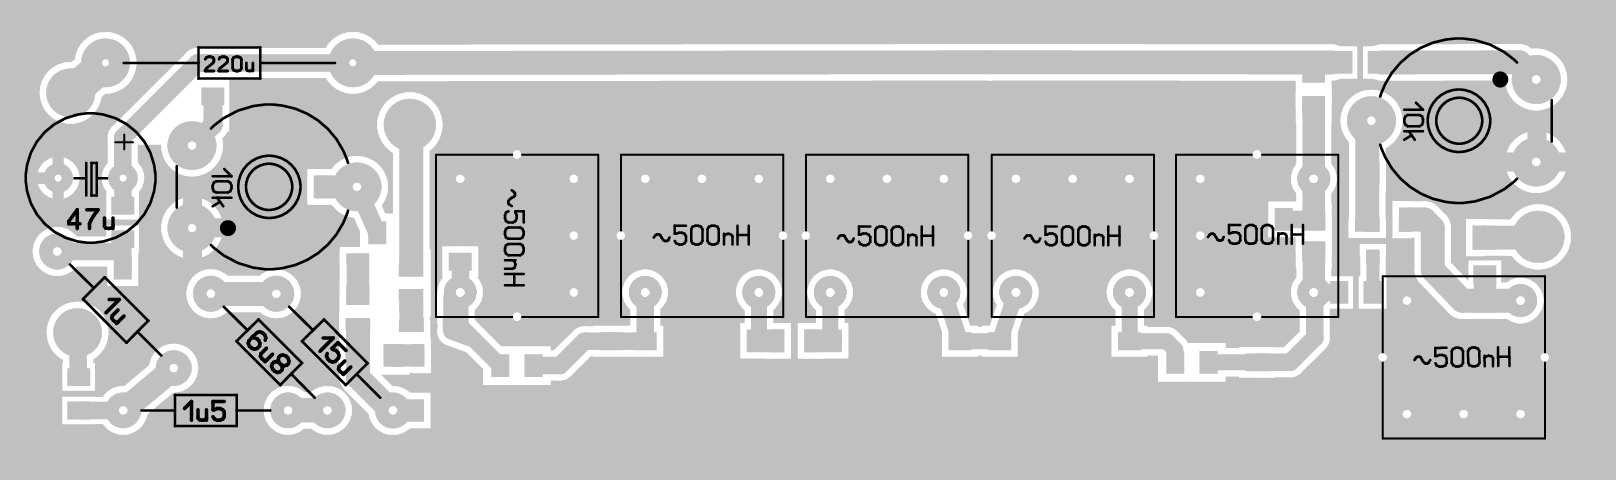
MIX/MIX3_component_placement_THT_top.png
