aljazblatnik/Spectrum-analyzer/Cavity filter/3D_holder/2x2cm_end_plug_plus_mounting.FCStd

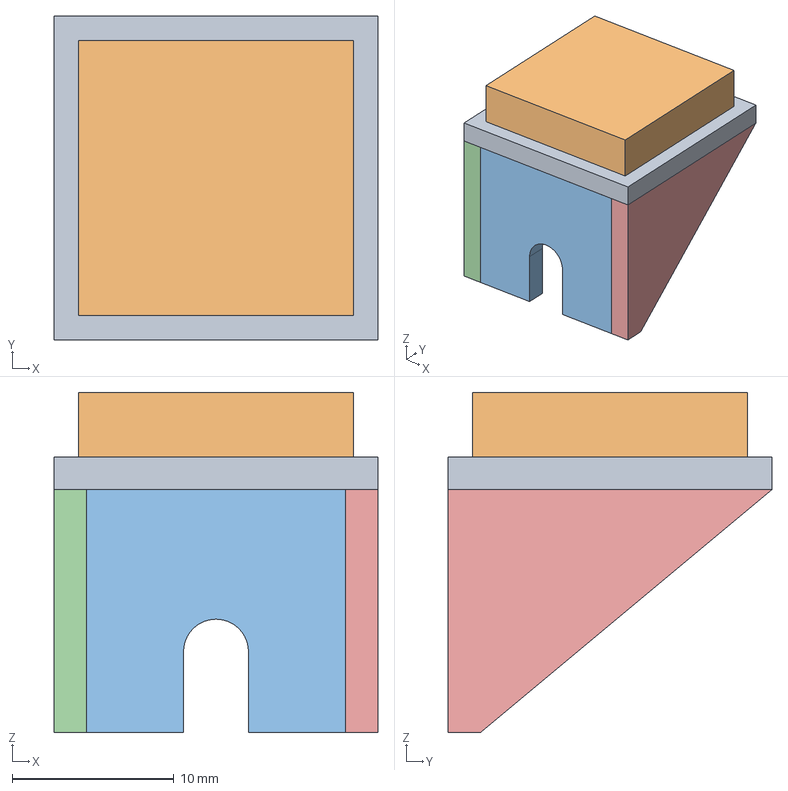
[picture p238: CAD file, 2023-01-02]
Cavity filter/3D_holder/2x2cm_end_plug_plus_mounting.FCStd
20.0 x 20.0 x 21.0 mm
