aljazblatnik/Spectrum-analyzer/(list of files, cad)

Other CAD files:
Cavity filter/3D_holder/2x2cm_end_plug_plus_mounting.stl
