aljazblatnik/Spectrum-analyzer/ATT/measurements/prototip2/PE43711B_10dB_step.png

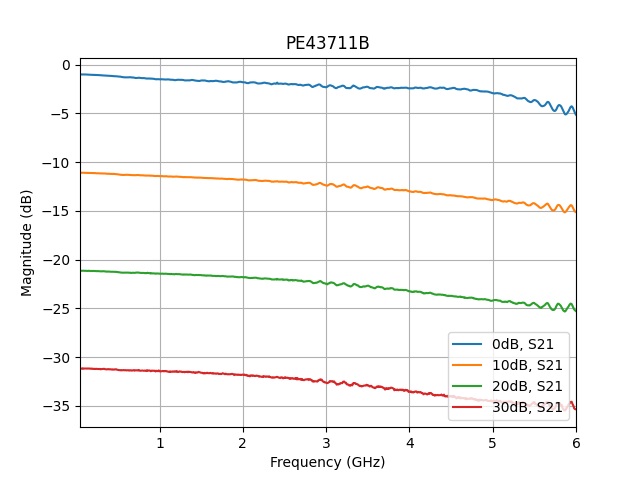
ATT/measurements/prototip2/PE43711B_10dB_step.png
