aljazblatnik/Spectrum-analyzer/construction/Layout_bottom.jpg

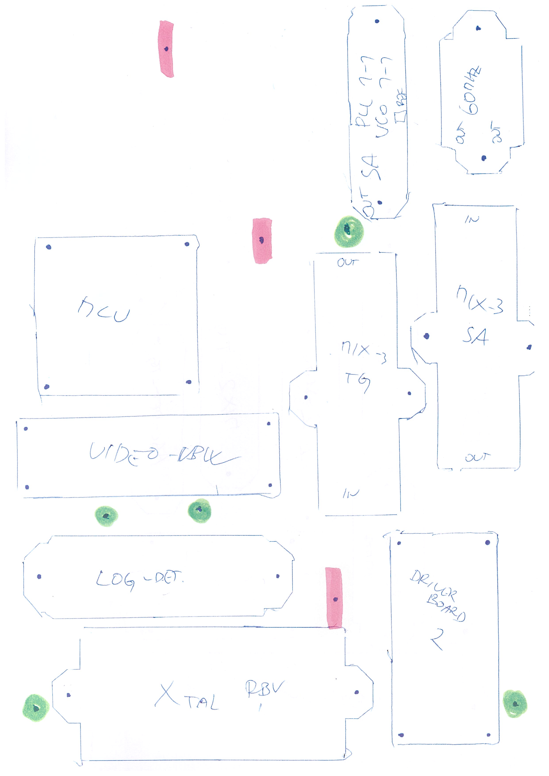
construction/Layout_bottom.jpg
