aljazblatnik/Spectrum-analyzer/construction/Layout_top.jpg

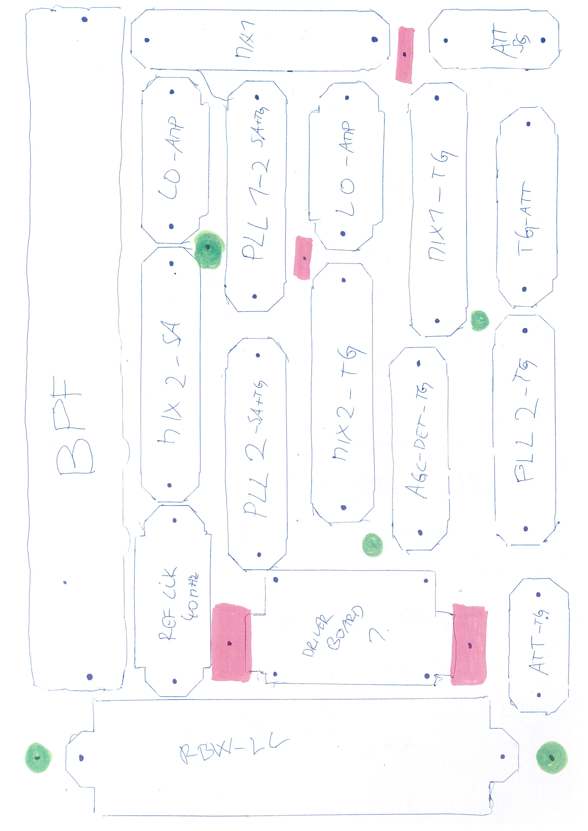
construction/Layout_top.jpg
