aljazblatnik/Spectrum-analyzer/LOG detector/measurements/meritve_AM_PM.pdf

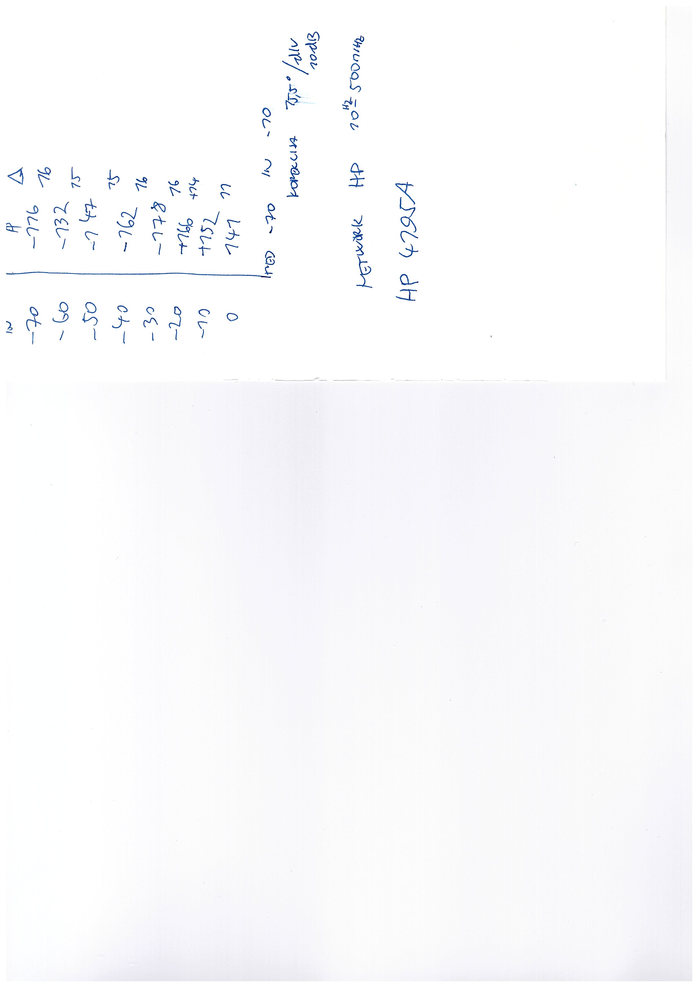
[picture p242: page 1]
