aljazblatnik/Spectrum-analyzer/LO1/measurements/grafi_izhodna_moc.xlsx

GHz | Podatkovni list |  |  | Meritev - no HEMT |  |  | Meritev - with HEMT
3.90 | 3900000000 | 6.23 | 3.79 | 4.00 | 4003886881 | 2.35 | 4.00 | 4000792936 | 9.4
4.02 | 4021854305 | 6.15 | 3.64 | 4.17 | 4172731987 | 2.53 | 4.12 | 4124390335 | 9.41
4.16 | 4159602649 | 6.09 | 3.51 | 4.27 | 4265024736 | 2.55 | 4.20 | 4201451334 | 9.22
4.32 | 4318543046 | 5.98 | 3.33 | 4.36 | 4364462517 | 2.26 | 4.30 | 4298048733 | 9.2
4.48 | 4482781457 | 5.9 | 3.18 | 4.45 | 4450202909 | 2.21 | 4.40 | 4400869038 | 9.23
4.63 | 4631125828 | 5.85 | 3.06 | 4.56 | 4556785723 | 1.92 | 4.47 | 4465267304 | 9.28
4.80 | 4800662252 | 5.8 | 2.94 | 4.66 | 4664553888 | 2.09 | 4.56 | 4555641797 | 9.3
4.93 | 4927814570 | 5.77 | 2.84 | 4.78 | 4778281735 | 1.89 | 4.65 | 4652456116 | 9.34
5.10 | 5097350993 | 5.71 | 2.71 | 4.87 | 4869981808 | 2.03 | 4.79 | 4788126316 | 9.73
5.27 | 5272185430 | 5.69 | 2.62 | 4.97 | 4970012265 | 2.01 | 4.87 | 4865404235 | 9.71
5.44 | 5436423841 | 5.69 | 2.55 | 5.07 | 5068857371 | 1.7 | 4.96 | 4961567793 | 9.82
5.61 | 5611258278 | 5.66 | 2.45 | 5.18 | 5176625536 | 1.87 | 5.04 | 5038845712 | 9.7
5.79 | 5786092715 | 5.61 | 2.33 | 5.25 | 5247483187 | 1.72 | 5.09 | 5090364325 | 9.75
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
