aljazblatnik/Spectrum-analyzer/LOG detector/measurements/meritve_power_voltage.xlsx

dBm in | V out SEBASTJAN | V out moj | V out NORM | Aljaz 2022 | 1.651 | 0.5
-120 | 0 | 1.651 | 0 | 0.5 | 0
-115 | 0.2 | 1.653 | 0.002 | 0.5 | 0
-110 | 0.5 | 1.654 | 0.003 | 0.5 | 0
-105 | 1.5 | 1.661 | 0.01 | 0.5 | 0
-100 | 2.7 | 1.672 | 0.021 | 0.514 | 0.014
-95 | 4.7 | 1.721 | 0.07 | 0.515 | 0.015
-90 | 6.7 | 1.833 | 0.182 | 0.528 | 0.028
-85 | 9.6 | 2.102 | 0.451 | 0.555 | 0.055
-80 | 12.2 | 2.392 | 0.741 | 0.608 | 0.108
-75 | 15.8 | 2.752 | 1.101 | 0.697 | 0.197
-70 | 18.8 | 3.044 | 1.393 | 0.824 | 0.324
-65 | 22.4 | 3.39 | 1.739 | 0.976 | 0.476
-60 | 25.4 | 3.68 | 2.029 | 1.142 | 0.642
-55 | 29 | 4.03 | 2.379 | 1.317 | 0.817
-50 | 32.1 | 4.31 | 2.659 | 1.496 | 0.996
-45 | 35.7 | 4.66 | 3.009 | 1.678 | 1.178
-40 | 38.8 | 4.95 | 3.299 | 1.861 | 1.361
-35 | 42.6 | 5.31 | 3.659 | 2.045 | 1.545
-30 | 45.6 | 5.69 | 4.039 | 2.23 | 1.73
-25 | 49.4 | 5.95 | 4.299 | 2.414 | 1.914
-20 | 52.5 | 6.24 | 4.589 | 2.602 | 2.102
-15 | 56.4 | 6.6 | 4.949 | 2.79 | 2.29
-10 | 60.2 | 6.9 | 5.249 | 2.983 | 2.483
-5 | 67.1 | 7.29 | 5.639 | 3.205 | 2.705
0 | 76.4 | 7.72 | 6.069 | 3.525 | 3.025
5 |  |  |  | 4.064 | 3.564
10 |  |  |  | 4.998 | 4.498
