aljazblatnik/Spectrum-analyzer/RBW Xtal filter/measurements/grafi.xlsx

10 kHz - extra wide |  | 3 kHz - extra wide |  | 1 kHz - extra wide |  | 10 kHz wide |  | 3 kHz wide |  | 1 kHz wide |  | 3 kHz narrow |  | 1 kHz narrow
9750000 | -59.5381 | 9750000 | -68.7727 | 9750000 | -76.2583 | 9950000 | -58.9964 | 9950000 | -68.7798 | 9950000 | -77.0626 | 9975000 | -66.8142 | 9975000 | -78.4261
9751250 | -59.621 | 9751250 | -70.4103 | 9751250 | -76.816 | 9950250 | -59.0893 | 9950250 | -68.7674 | 9950250 | -74.2645 | 9975125 | -66.6323 | 9975125 | -76.5971
9752500 | -59.4931 | 9752500 | -68.8769 | 9752500 | -76.4392 | 9950500 | -58.8247 | 9950500 | -67.681 | 9950500 | -74.9966 | 9975250 | -65.4977 | 9975250 | -74.7822
9753750 | -59.1246 | 9753750 | -69.2515 | 9753750 | -74.6129 | 9950750 | -58.6378 | 9950750 | -68.2859 | 9950750 | -75.0938 | 9975375 | -66.101 | 9975375 | -75.0113
9755000 | -59.4325 | 9755000 | -68.6365 | 9755000 | -77.0658 | 9951000 | -58.3173 | 9951000 | -68.4361 | 9951000 | -74.6109 | 9975500 | -66.6386 | 9975500 | -74.8787
9756250 | -59.2082 | 9756250 | -68.7059 | 9756250 | -74.6303 | 9951250 | -58.077 | 9951250 | -67.3154 | 9951250 | -72.7116 | 9975625 | -65.5665 | 9975625 | -78.5409
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
