aljazblatnik/Spectrum-analyzer/RBW LC filter/measurements/chart.xlsx

3 MHz - wide |  | 3 Mhz - extra wide |  | 1 MHz wide |  | 300 kHz wide |  | 300 kHz narrow |  | 100 kHz wide |  | 100 kHz narrow |  | 30 kHz wide |  | 30 kHz narrow
0.001 | -85.9312 | 0.001 | -83.0435 | 0.001 | -78.8865 | 0.001 | -94.2503 | 5000000.001 | -80.0338 | 0.001 | -81.6912 | 7500000.001 | -89.2481 | 0.001 | -95.1967 | 9500000.001 | -80.0684
50000.001 | -85.9312 | 125000.001 | -81.8061 | 50000.001 | -80.086 | 50000.001 | -94.2503 | 5025000.001 | -80.0338 | 50000.001 | -81.6912 | 7512500.001 | -84.3611 | 50000.001 | -95.1967 | 9502500.001 | -85.5239
100000.001 | -85.9312 | 250000.001 | -83.0435 | 100000.001 | -78.8865 | 100000.001 | -84.4057 | 5050000.001 | -81.3288 | 100000.001 | -88.445 | 7525000.001 | -83.8292 | 100000.001 | -89.0089 | 9505000.001 | -82.6565
150000.001 | -91.7178 | 375000.001 | -82.9435 | 150000.001 | -79.8313 | 150000.001 | -89.1688 | 5075000.001 | -88.6418 | 150000.001 | -82.4351 | 7537500.001 | -87.3222 | 150000.001 | -80.5827 | 9507500.001 | -81.4082
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
