aljazblatnik/Spectrum-analyzer/AMP HEMT/measurements/43_measurements.png

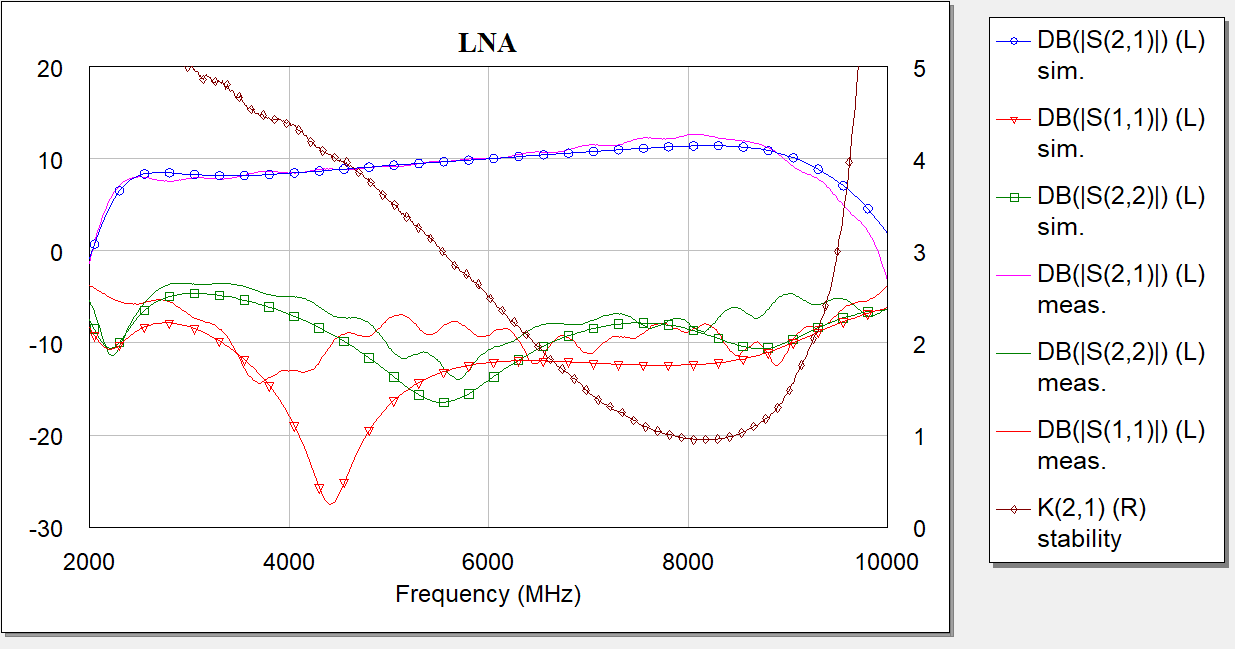
AMP HEMT/measurements/43_measurements.png
