aljazblatnik/Spectrum-analyzer/AMP HEMT/measurements/43r1-meritve.png

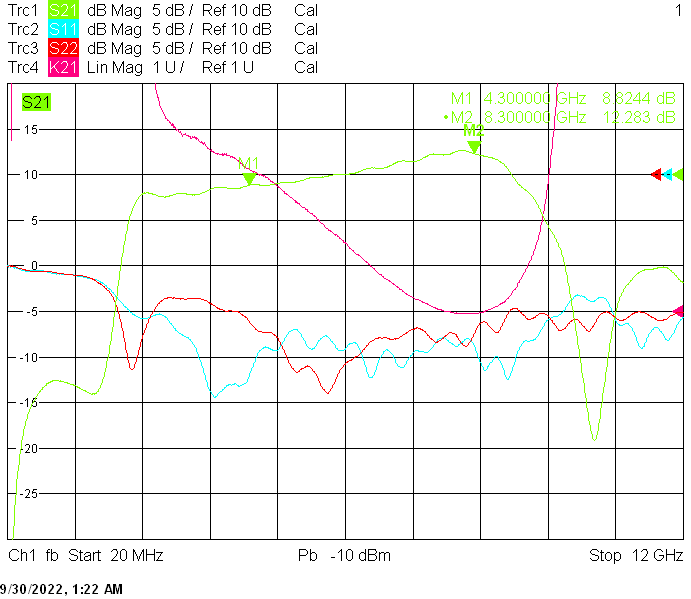
AMP HEMT/measurements/43r1-meritve.png
