aljazblatnik/Spectrum-analyzer/ATT/measurements/PE43711B_primerjava_1_2_prototip.png

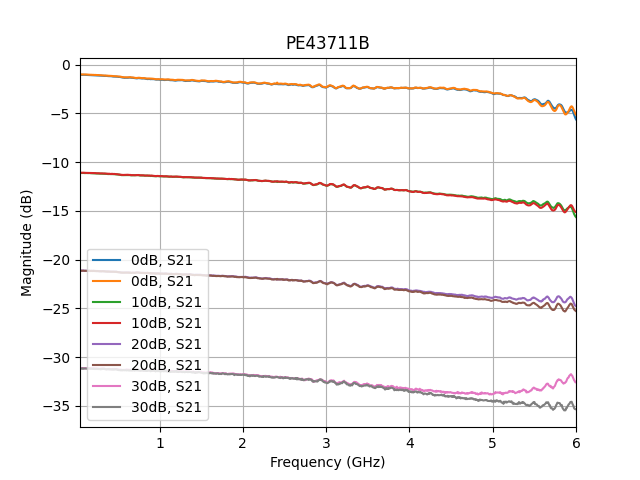
ATT/measurements/PE43711B_primerjava_1_2_prototip.png
