aljazblatnik/Spectrum-analyzer/ATT/measurements/prototip2/PE43711B_koraki.png

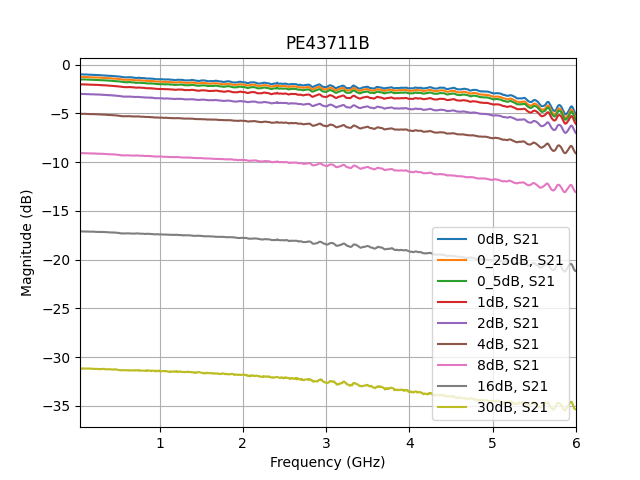
ATT/measurements/prototip2/PE43711B_koraki.png
