aljazblatnik/Spectrum-analyzer/Cavity filter/measurements/BPF_final_100MHz_2dB.bmp

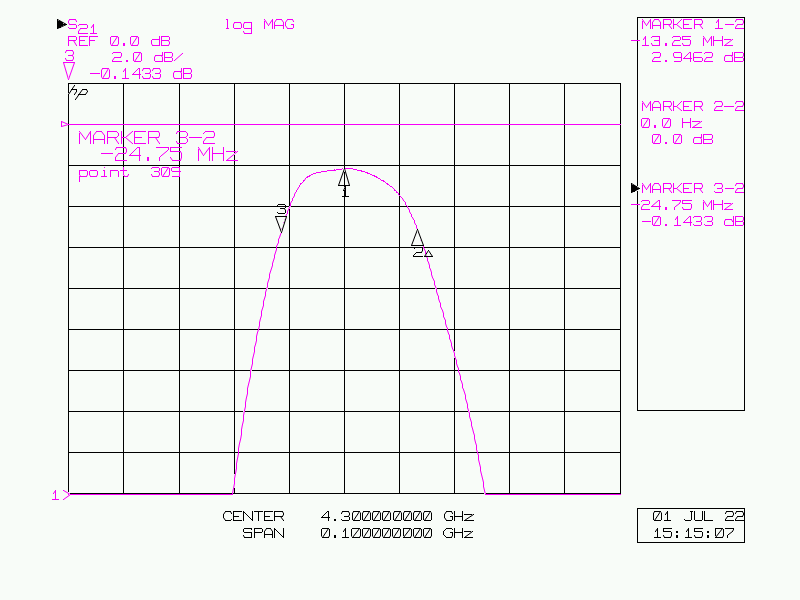
Cavity filter/measurements/BPF_final_100MHz_2dB.bmp
