aljazblatnik/Spectrum-analyzer/LO1/measurements/IMG_5137.jpg

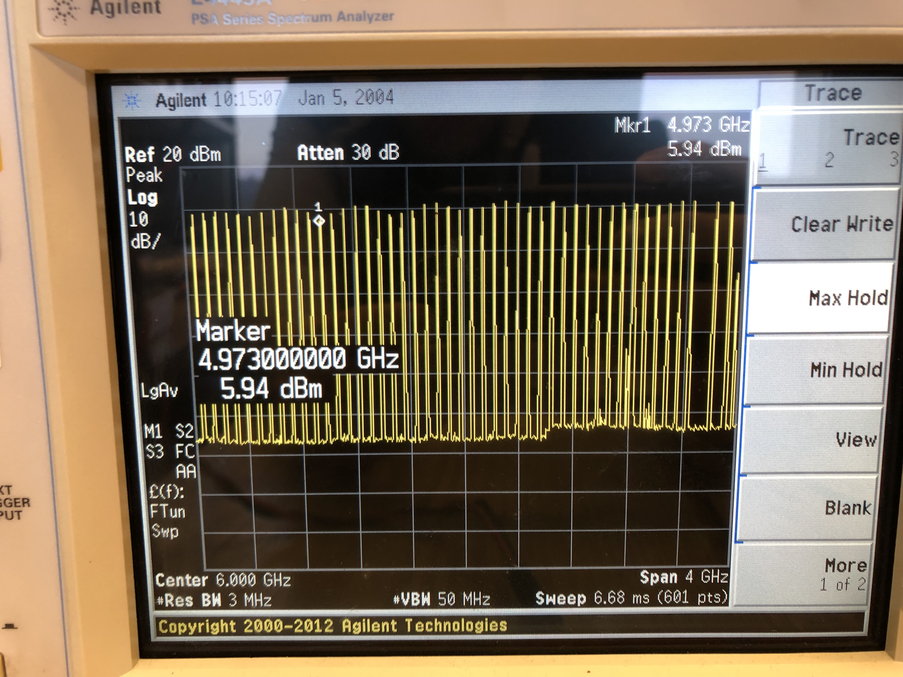
LO1/measurements/IMG_5137.jpg
