aljazblatnik/Spectrum-analyzer/LO1/measurements/IMG_5138.jpg

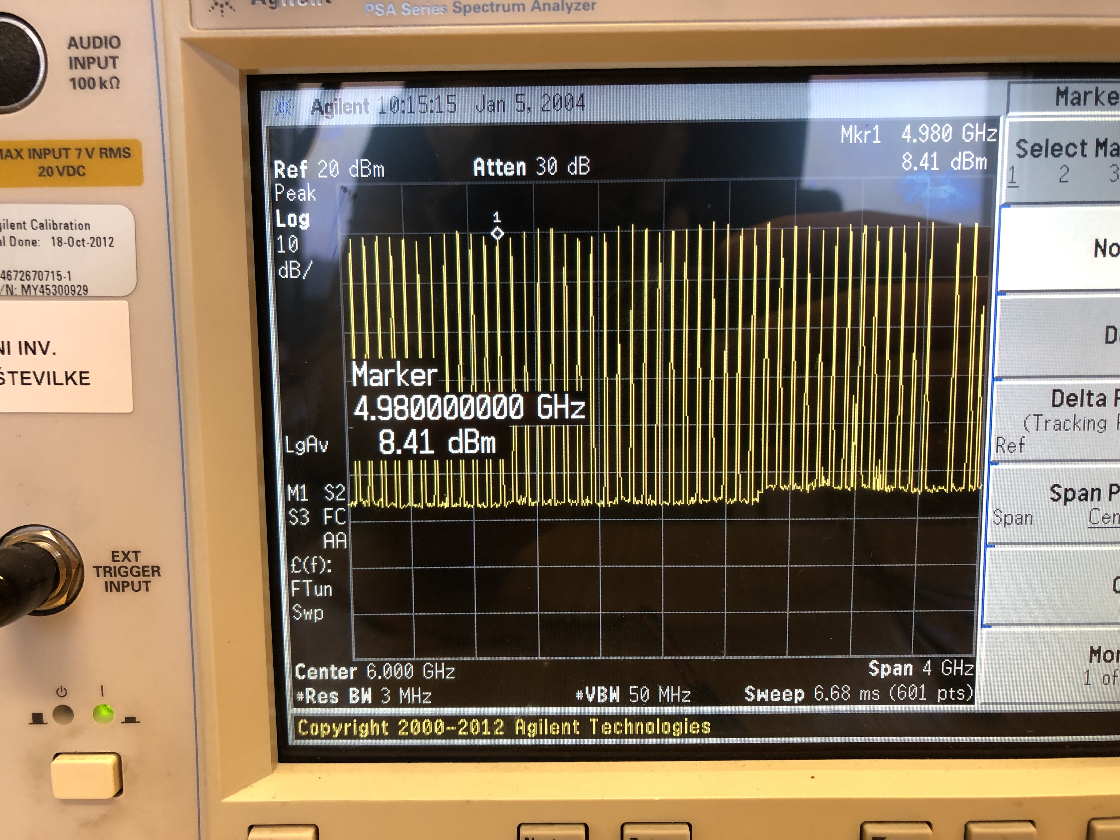
LO1/measurements/IMG_5138.jpg
