aljazblatnik/Spectrum-analyzer/LO1/measurements/IMG_5139.jpg

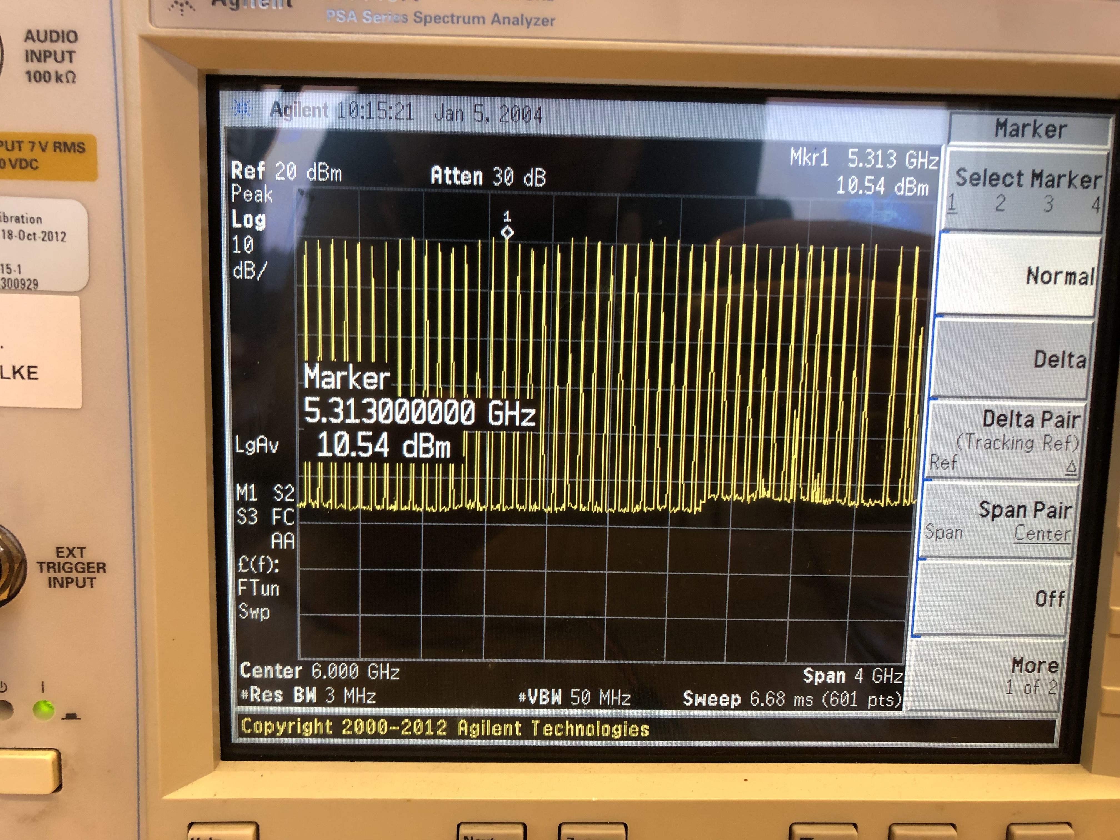
LO1/measurements/IMG_5139.jpg
