aljazblatnik/Spectrum-analyzer/LO1/measurements/IMG_5153.jpg

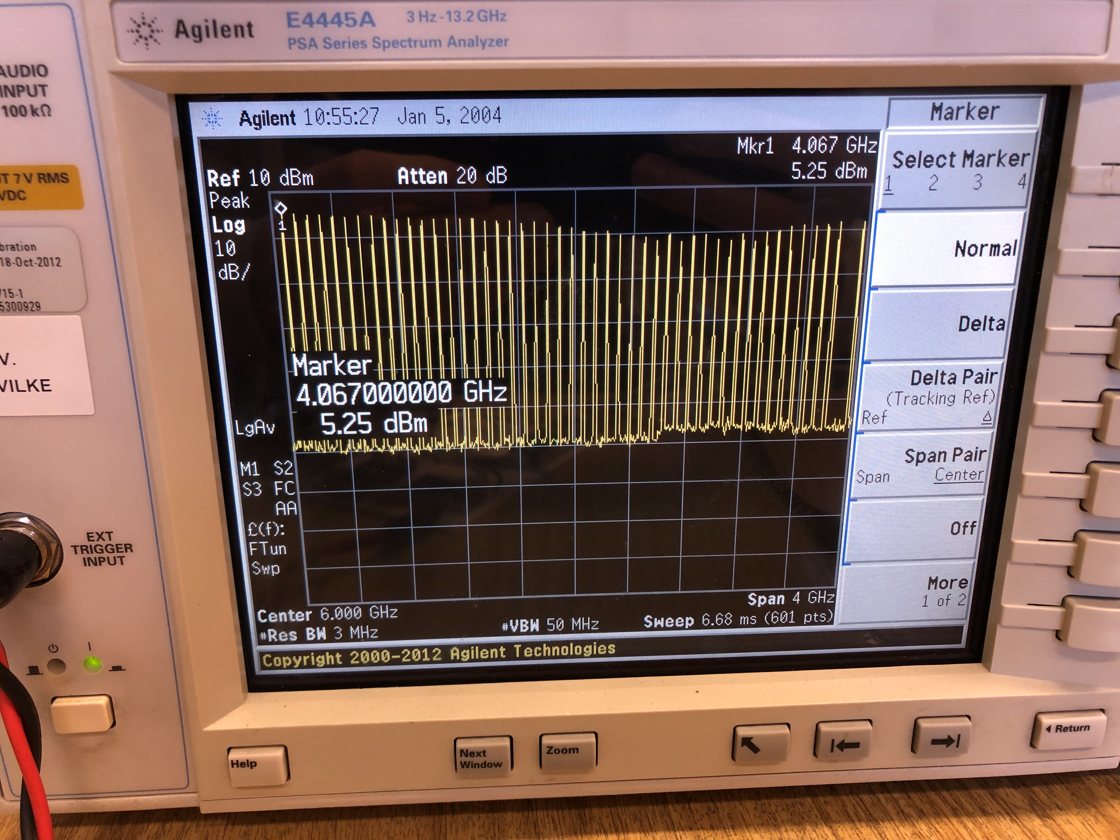
LO1/measurements/IMG_5153.jpg
