aljazblatnik/Spectrum-analyzer/LO1/measurements/IMG_5154.jpg

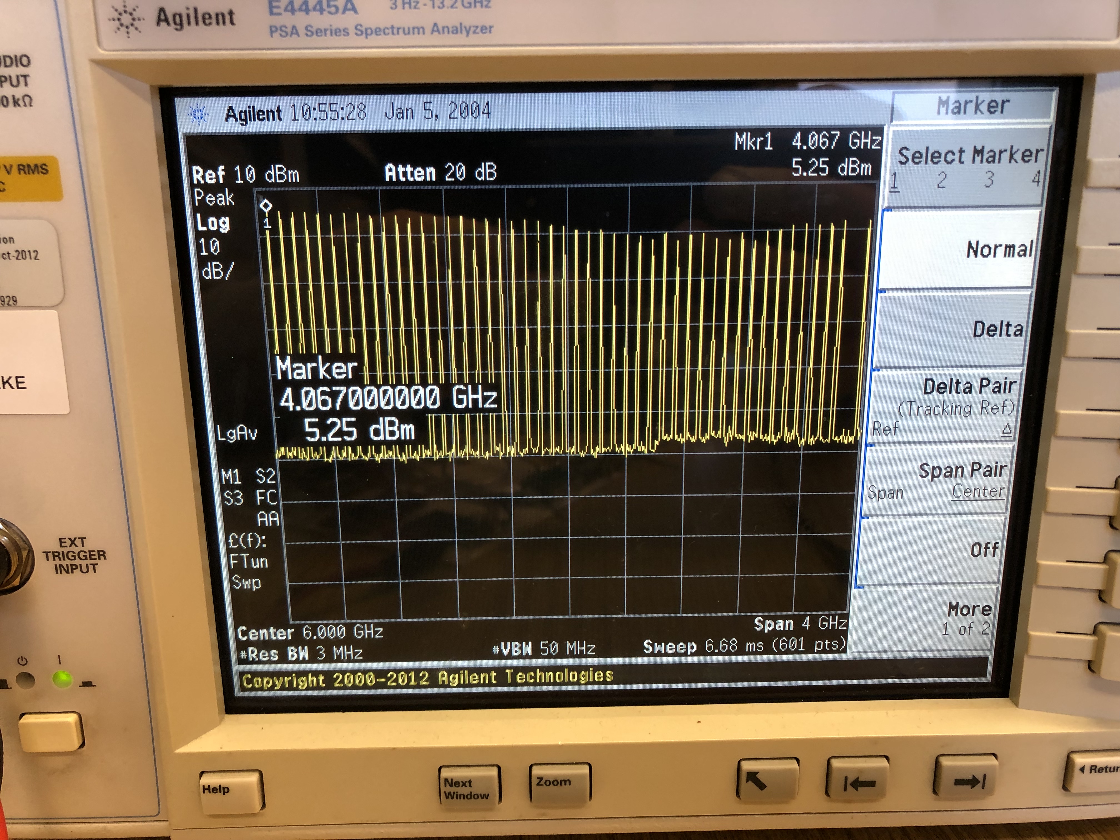
LO1/measurements/IMG_5154.jpg
