aljazblatnik/Spectrum-analyzer/LO1/measurements/IMG_5155.jpg

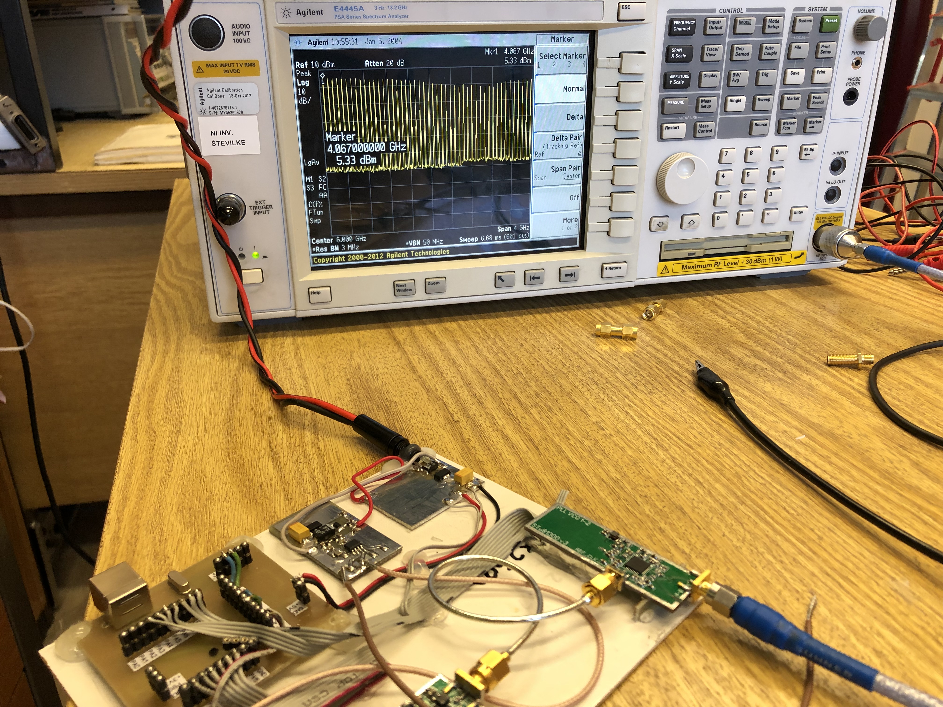
LO1/measurements/IMG_5155.jpg
