aljazblatnik/Spectrum-analyzer/LO1/measurements/izhodna_moc_AMP.jpg

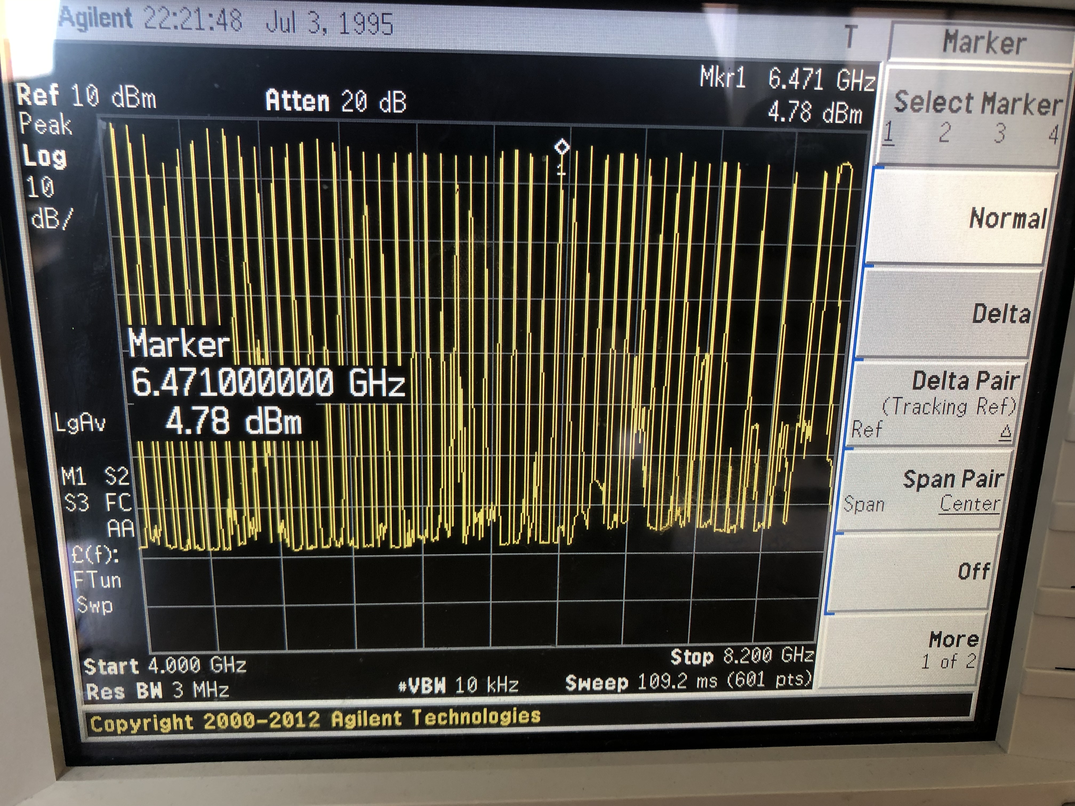
LO1/measurements/izhodna_moc_AMP.jpg
