aljazblatnik/Spectrum-analyzer/LO1/measurements/izhodna_moc_AMP_no_AMP.png

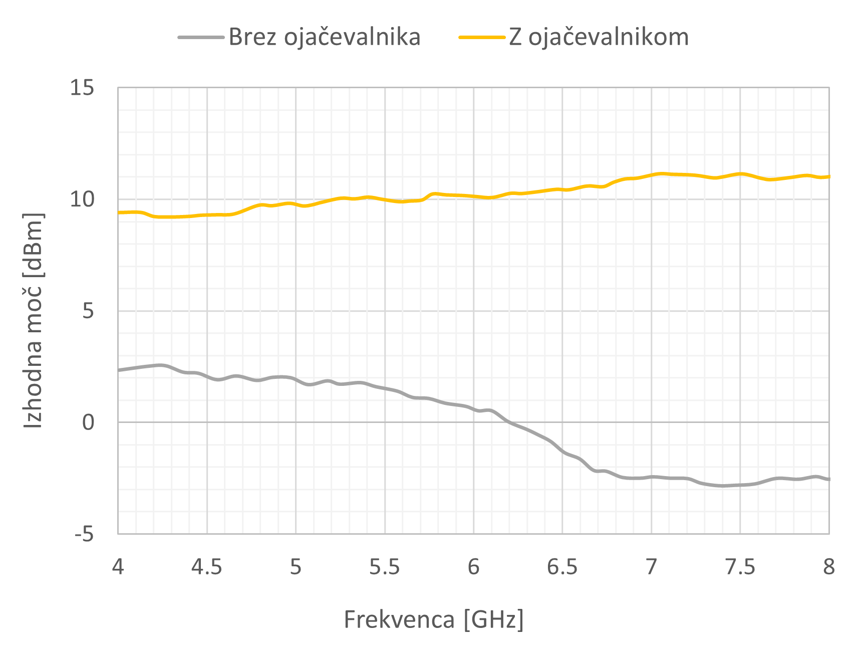
LO1/measurements/izhodna_moc_AMP_no_AMP.png
