aljazblatnik/Spectrum-analyzer/LO1/measurements/izhodna_moc_noAMP.jpg

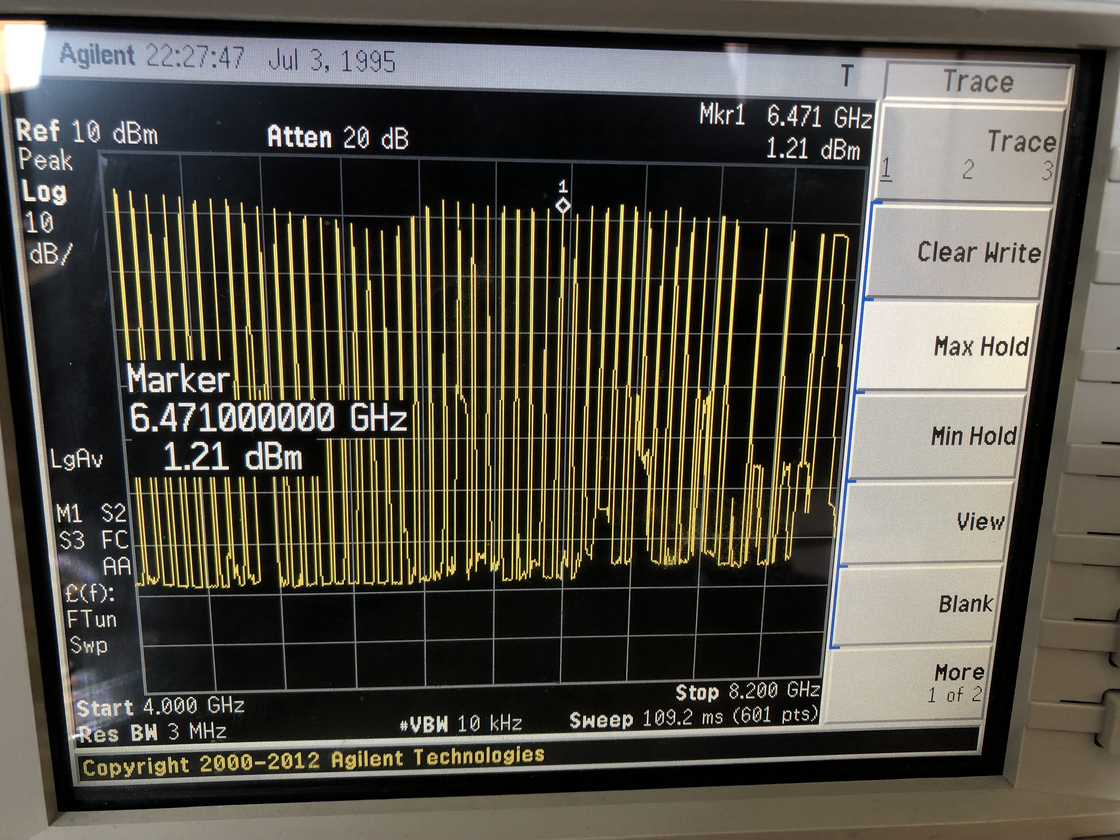
LO1/measurements/izhodna_moc_noAMP.jpg
