aljazblatnik/Spectrum-analyzer/LO1/measurements/izhodna_moc_slope_gain_AMP.jpg

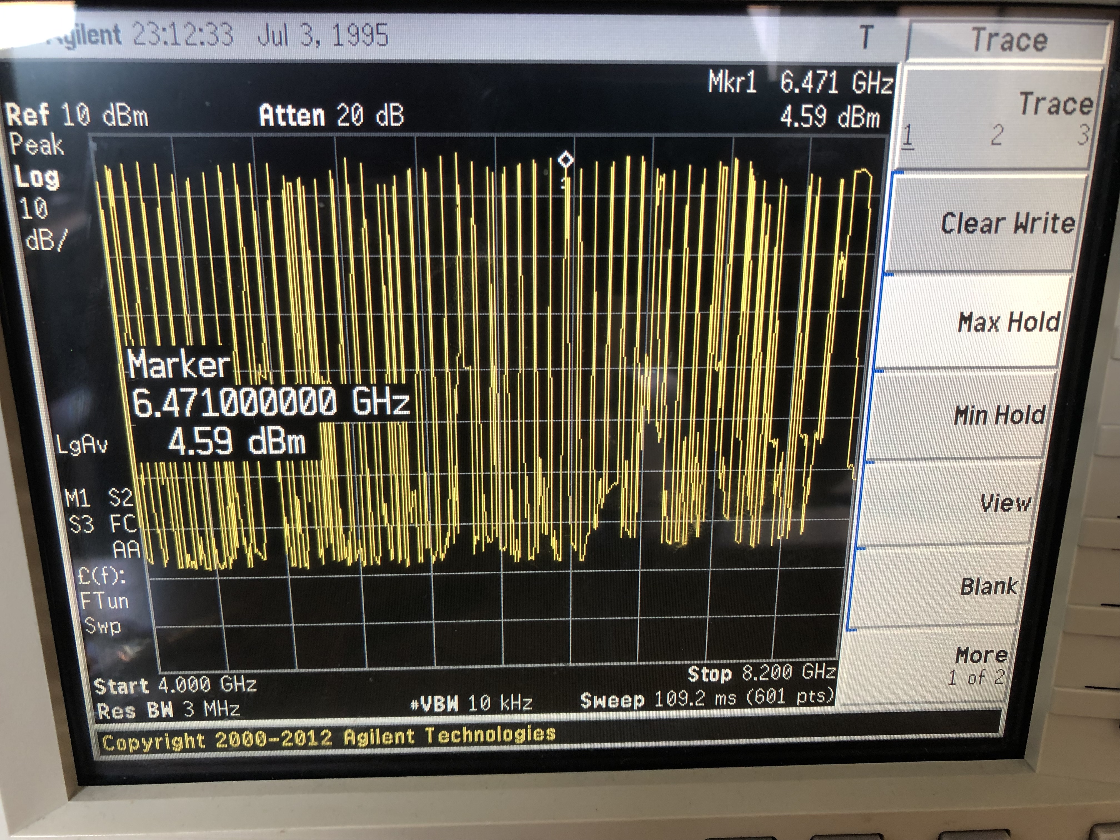
LO1/measurements/izhodna_moc_slope_gain_AMP.jpg
