aljazblatnik/Spectrum-analyzer/LOG detector/measurements/postavitev_AM_PM.jpg

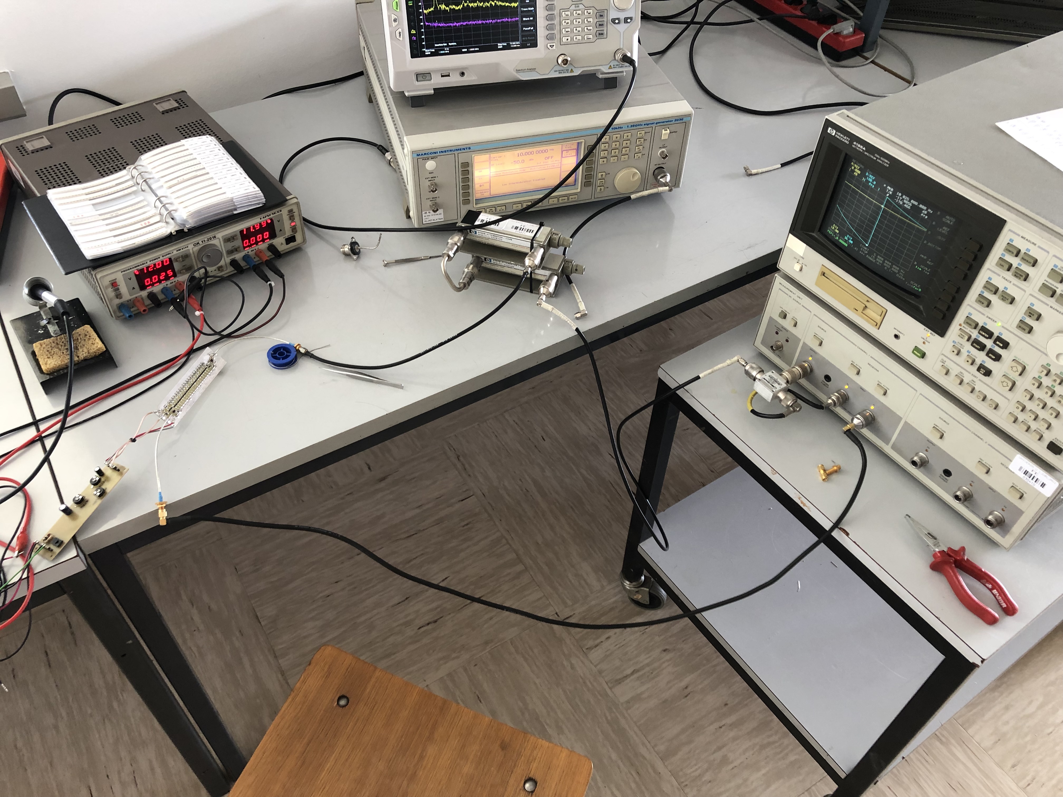
LOG detector/measurements/postavitev_AM_PM.jpg
