aljazblatnik/Spectrum-analyzer/MIX/measurements/MIX2/MIX2 comp point.png

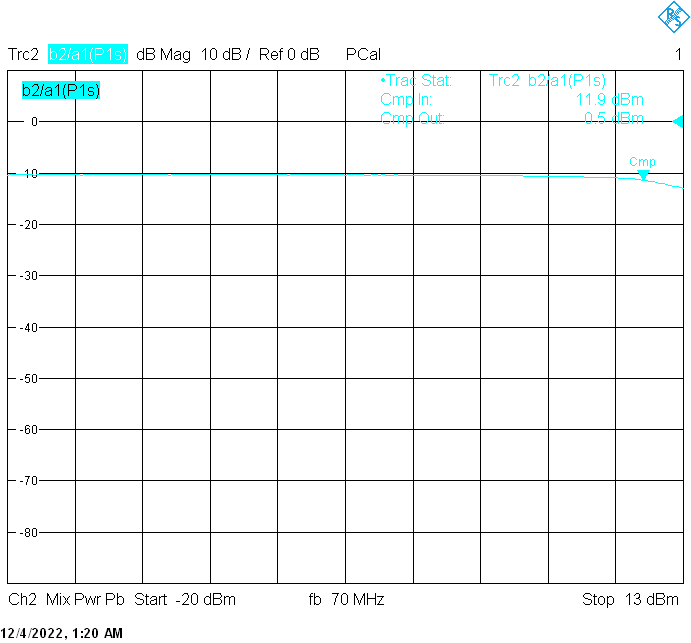
MIX/measurements/MIX2/MIX2 comp point.png
