aljazblatnik/Spectrum-analyzer/MIX/measurements/MIX2/MIX2 IP3.png

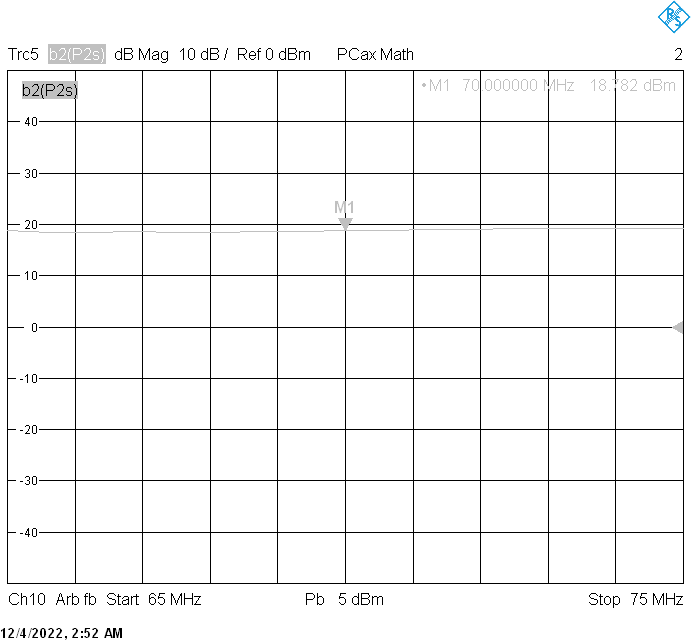
MIX/measurements/MIX2/MIX2 IP3.png
