aljazblatnik/Spectrum-analyzer/RBW LC filter/measurements/1MHz.png

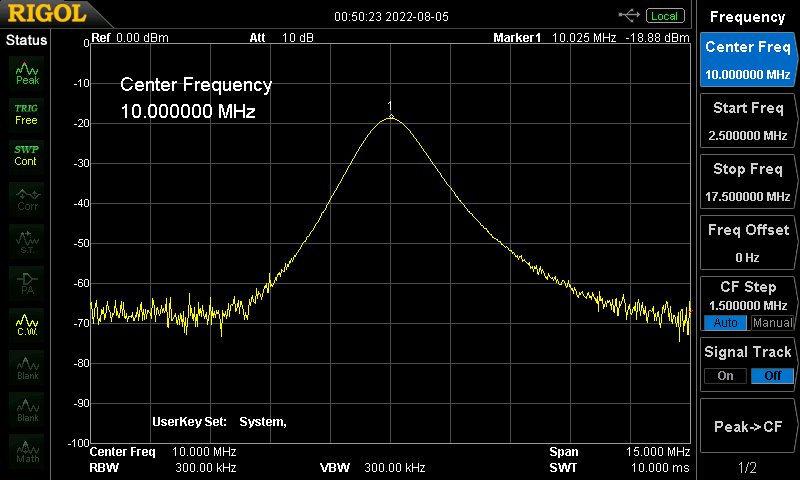
RBW LC filter/measurements/1MHz.png
