aljazblatnik/Spectrum-analyzer/RBW LC filter/measurements/3MHz.png

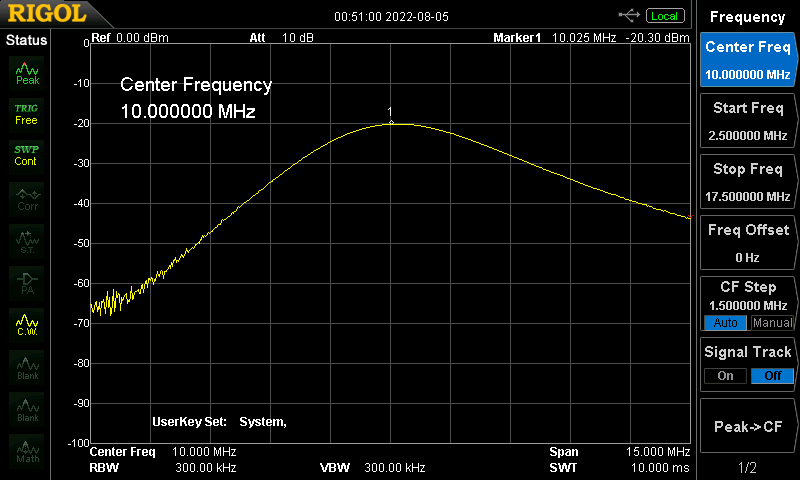
RBW LC filter/measurements/3MHz.png
