aljazblatnik/Spectrum-analyzer/RBW LC filter/measurements/30kHz.png

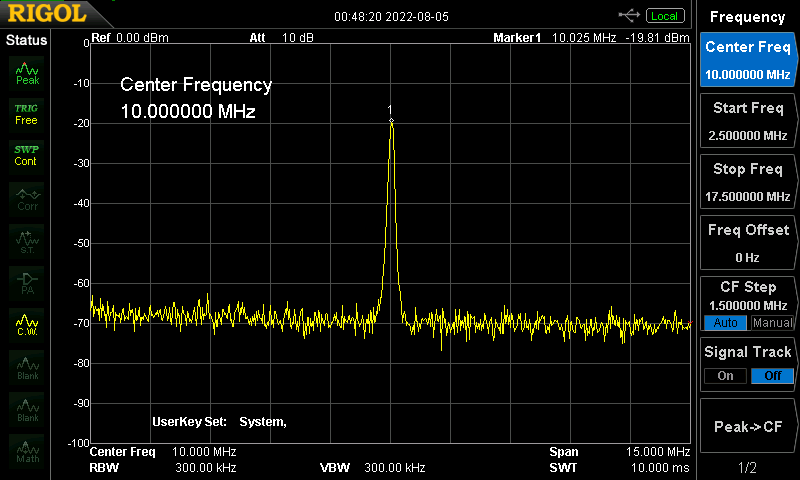
RBW LC filter/measurements/30kHz.png
