aljazblatnik/Spectrum-analyzer/RBW LC filter/measurements/100kHz.png

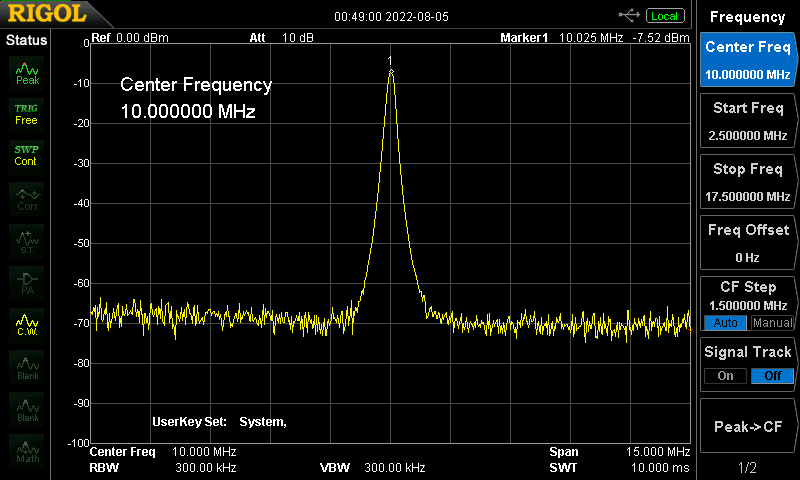
RBW LC filter/measurements/100kHz.png
