aljazblatnik/Spectrum-analyzer/RBW LC filter/measurements/300kHz.png

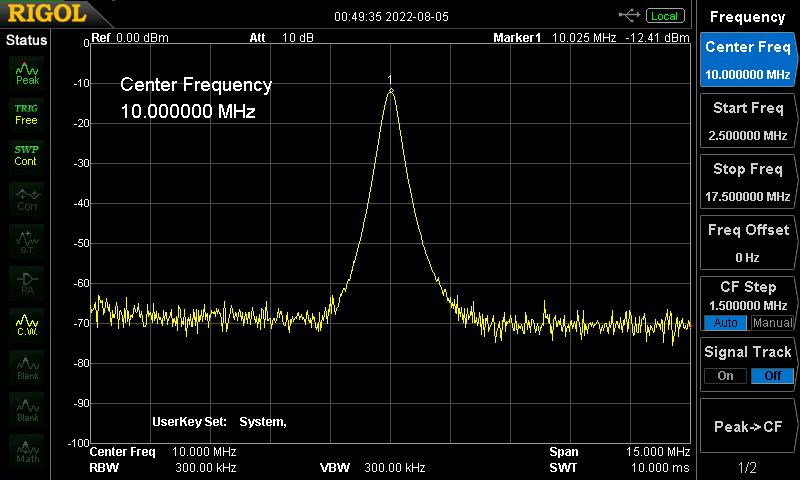
RBW LC filter/measurements/300kHz.png
