aljazblatnik/Spectrum-analyzer/RBW Xtal filter/measurements/IMG_5133.JPEG

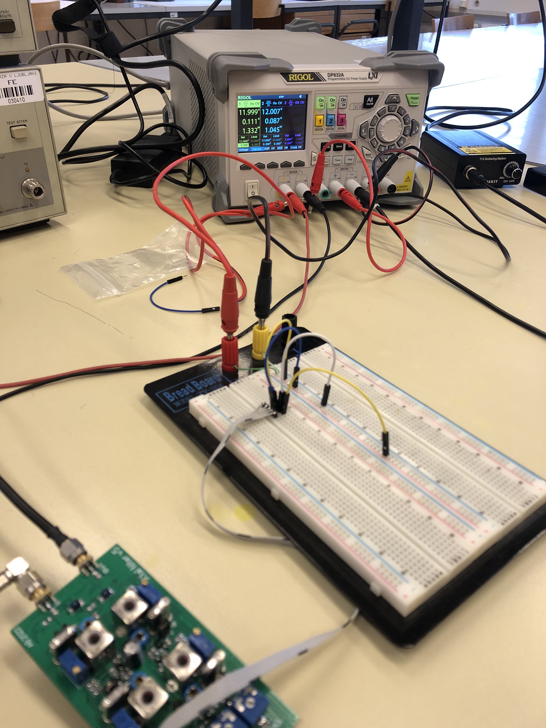
RBW Xtal filter/measurements/IMG_5133.JPEG
