aljazblatnik/Spectrum-analyzer/RBW Xtal filter/measurements/IMG_5134.JPEG

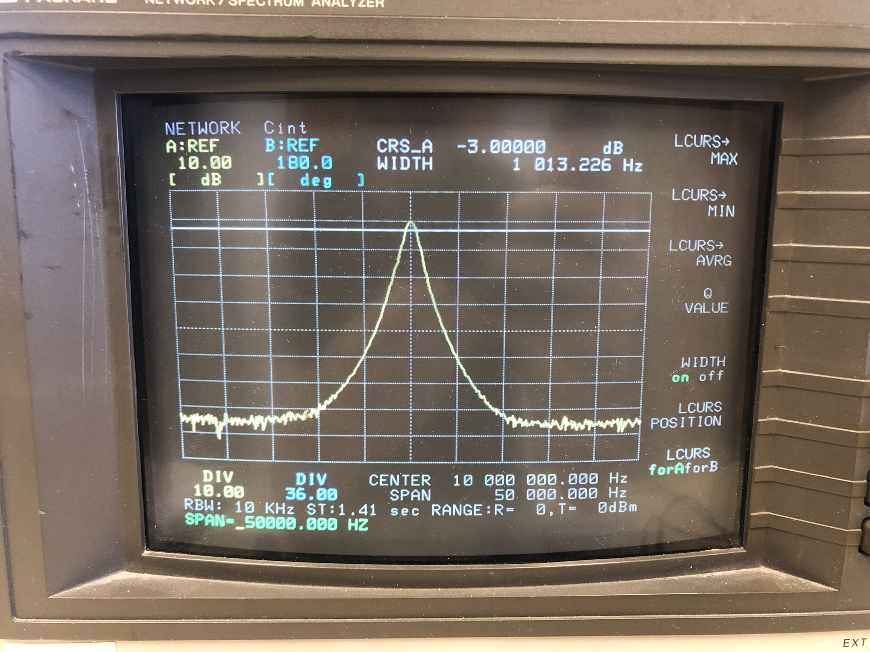
RBW Xtal filter/measurements/IMG_5134.JPEG
