aljazblatnik/Spectrum-analyzer/RBW Xtal filter/measurements/IMG_5135.JPEG

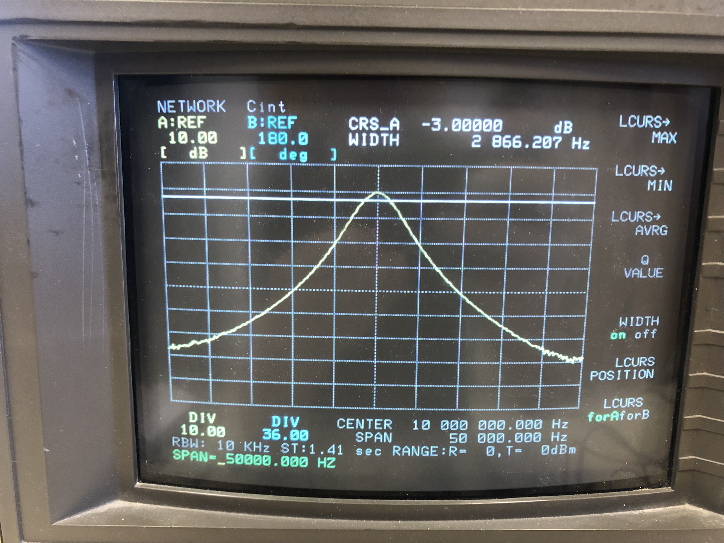
RBW Xtal filter/measurements/IMG_5135.JPEG
