aljazblatnik/Spectrum-analyzer/RBW Xtal filter/measurements/IMG_5136.JPEG

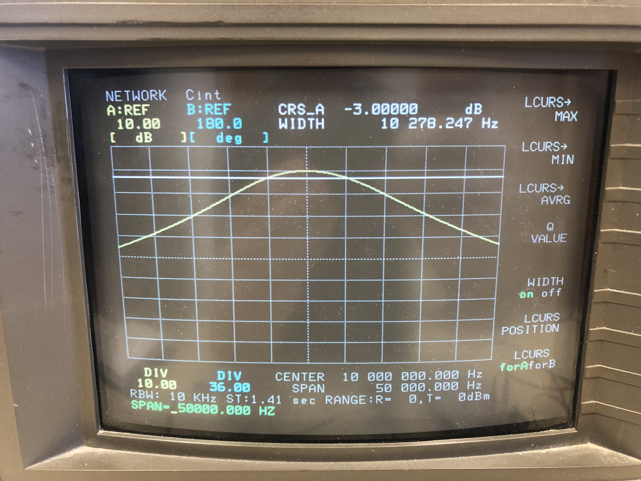
RBW Xtal filter/measurements/IMG_5136.JPEG
