aljazblatnik/Spectrum-analyzer/TG PHASE comp/measurements/meritev_0dBm.png

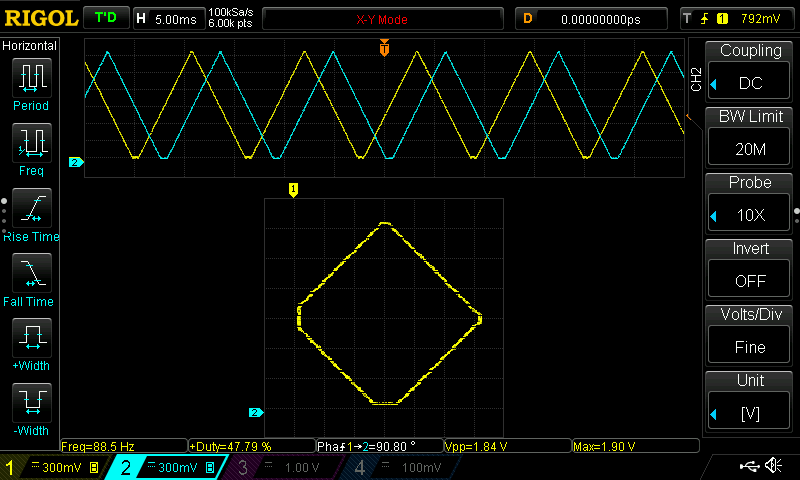
TG PHASE comp/measurements/meritev_0dBm.png
