aljazblatnik/Spectrum-analyzer/(list of files, drawings)

Other design files:
AMP HEMT/AMP HEMT PCB.lay6
AMP HEMT/AMP HEMT schematic.spl8
ATT/ATT PCB.lay6
ATT/ATT schematic.spl8
Cavity filter/Cavity filter.spl8
COMM/COMM PCB.lay6
COMM/COMM schematic.spl8
construction/Layout.spl8
LO1/LO 1-1 PCB.lay6
LO1/LO 1-1 schematic.spl8
LO1/LO 1-2 PCB.lay6
LO1/LO 1-2 schematic.spl8
LO2/LO2_PCB.lay6
LO2/LO2_schematic.spl8
LO3/LO3 PCB.lay6
LO3/LO3 schematic.spl8
LOG detector/Backup_of_LOG schematic.spl8
LOG detector/LOG PCB.lay6
LOG detector/LOG schematic.spl8
MCU/MCU PCB.lay6
MCU/MCU schematic.spl8
MIX/MIX1 PCB.lay6
MIX/MIX2 PCB.lay6
MIX/MIX3 PCB.lay6
MIX/MIX schematic.spl8
RBW LC filter/LC_RBW.lay6
RBW Xtal filter/RBW_Xtal_schematic.spl8
RBW Xtal filter/Xtal_RBW.lay6
REF clock/REF CLK PCB.lay6
REF clock/REF CLK schematic.spl8
TG ARO/AGC ATT PCB.lay6
TG ARO/AGC ATT schematic.spl8
TG ARO/Backup_of_AGC ATT schematic.spl8
TG output AMP/TG output AMP PCB.lay6
TG output AMP/TG output AMP schematic.spl8
TG PHASE comp/Backup_of_PHASE COMP schematic.spl8
TG PHASE comp/PHASE COMP PCB.lay6
TG PHASE comp/PHASE COMP schematic.spl8
VBW/VIDEO PCB.lay6
VBW/VIDEO schematic.spl8
