aljazblatnik/Spectrum-analyzer/ATT/test program (STM32F030K6)/src/calibration.c

#include "stm32f0xx.h"
#include "system_stm32f0xx.h"

#include "delay.h"

// NASTAVITEV koraka:
const int step = 1000;

// stevilka array-a - stevilo * 25 Mhz
// 1. char - maksimalna moc v dBm (zapis na zaslonu)
// 2. char - nastavitev slabilca za doseganje te moci (fikna nastavitev z byte vrednostjo)

const char calibrationMax[6476][2] = {
{4,3},{5,3},{7,3},{8,3},{8,3},{9,3},{10,3},{11,0},{11,3},{12,0},
{12,3},{12,3},{13,1},{13,3},{13,3},{14,1},{14,2},{14,3},{14,3},{14,3},
{15,1},{15,1},{15,2},{15,2},{15,3},{15,3},{15,3},{15,3},{15,3},{15,3},
{16,0},{16,0},{16,0},{16,1},{16,1},{16,1},{16,1},{16,1},{16,1},{16,1},
{16,1},{16,1},{16,1},{16,1},{16,1},{16,1},{16,1},{16,1},{16,1},{16,1},
{16,1},{16,1},{16,1},{16,1},{16,1},{16,1},{16,1},{16,1},{16,1},{16,1},
{16,1},{16,1},{16,1},{16,1},{16,1},{16,1},{16,1},{16,1},{16,1},{16,1},
{16,1},{16,1},{16,1},{16,1},{16,1},{16,1},{16,1},{16,1},{16,1},{16,1},
{16,1},{16,1},{16,1},{16,1},{16,1},{16,1},{16,1},{16,1},{16,1},{16,1},
{16,1},{16,1},{16,1},{16,1},{16,1},{16,1},{16,1},{16,1},{16,1},{16,1},
{16,1},{16,1},{16,1},{16,1},{16,1},{16,1},{16,1},{16,1},{16,1},{16,1},
{16,1},{16,1},{16,1},{16,1},{16,1},{16,1},{16,1},{16,1},{16,1},{16,1},
{16,1},{16,1},{16,1},{16,1},{16,1},{16,1},{16,1},{16,1},{16,1},{16,1},
{16,1},{16,1},{16,1},{16,1},{16,1},{16,1},{16,1},{16,1},{16,1},{16,1},
{16,1},{16,1},{16,1},{16,1},{16,1},{16,1},{16,1},{16,1},{16,1},{16,1},
{16,1},{16,1},{16,1},{16,1},{16,1},{16,1},{16,1},{16,1},{16,1},{16,2},
{16,2},{16,2},{16,2},{16,2},{16,2},{16,2},{16,2},{16,2},{16,2},{16,2},
{16,2},{16,2},{16,2},{16,2},{16,2},{16,1},{16,1},{16,1},{16,1},{16,1},
{16,1},{16,1},{16,1},{16,1},{16,1},{16,1},{16,1},{16,1},{16,1},{16,1},
{16,1},{16,1},{16,1},{16,1},{16,0},{16,0},{16,0},{16,0},{16,0},{16,0},
{16,0},{16,1},{16,1},{16,1},{16,1},{16,1},{16,1},{16,1},{16,1},{16,1},
{16,1},{16,1},{16,1},{16,1},{16,1},{16,1},{16,1},{16,1},{16,1},{16,1},
{16,1},{16,1},{16,1},{16,1},{16,1},{16,1},{16,1},{16,1},{16,1},{16,1},
{16,1},{16,1},{16,1},{16,1},{16,1},{16,1},{16,1},{16,1},{16,1},{16,1},
{16,1},{16,1},{16,1},{16,1},{16,1},{16,1},{16,1},{16,1},{16,1},{16,1},
{16,1},{16,1},{16,1},{16,1},{16,1},{16,1},{16,1},{16,1},{16,1},{16,1},
{16,1},{16,1},{16,1},{16,1},{16,1},{16,1},{16,1},{16,1},{16,1},{16,1},
{16,1},{16,1},{16,1},{16,1},{16,1},{16,1},{16,1},{16,1},{16,1},{16,1},
{16,1},{16,1},{16,1},{16,1},{16,1},{16,1},{16,1},{16,1},{16,0},{16,1},
{16,0},{16,0},{16,0},{16,0},{16,0},{16,0},{16,0},{16,0},{16,0},{16,0},
{16,0},{16,0},{16,0},{16,0},{16,0},{16,0},{16,0},{16,0},{16,0},{16,0},
{16,1},{16,1},{16,1},{16,1},{16,1},{16,1},{16,1},{16,1},{16,1},{16,1},
{16,1},{16,1},{16,1},{16,1},{16,1},{16,1},{16,1},{16,1},{16,1},{16,1},
{16,1},{16,1},{16,1},{16,1},{16,1},{16,1},{16,2},{16,2},{16,2},{16,2},
{16,1},{16,1},{16,1},{16,1},{16,1},{16,1},{16,1},{16,1},{16,1},{16,1},
{16,1},{16,1},{16,1},{16,1},{16,1},{16,1},{16,1},{16,1},{16,1},{16,1},
{16,1},{16,1},{16,2},{16,2},{16,2},{16,2},{16,2},{16,2},{16,2},{16,2},
{16,2},{16,2},{16,2},{16,2},{16,2},{16,2},{16,3},{16,3},{16,3},{16,2},
{16,3},{16,3},{16,3},{16,2},{16,2},{16,2},{16,2},{16,2},{16,2},{16,2},
{16,2},{16,2},{16,2},{16,2},{16,1},{16,1},{16,1},{16,1},{16,1},{16,1},
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
};

char calibrationReturnMaxPower(int frequency){
    // vrnemo najvecjo moc v odvisnosti od frekvence
    int i = frequency/step;
    int j = frequency%step;
    if(j>(step/2)) i++; // ce je ostanek vecji, se priblizamo drugi vrednosti.

    if(i>6475) i = 6475;
    if(i<0) i = 0;

    return calibrationMax[i][0];
}

char calibrationReturnMaxAttenuator(int frequency){
    // vrnemo najvecjo moc v odvisnosti od frekvence
    int i = frequency/step;
    int j = frequency%step;
    if(j>(step/2)) i++; // ce je ostanek vecji, se priblizamo drugi vrednosti.

    if(i>6475) i = 6475;
    if(i<0) i = 0;

    return calibrationMax[i][1];
}

int calibrationReturnPower(int frequency, int power){
    // Vrnemo moc glede na zelje in frekvenco (max, min meje moci)
    int maxPower = calibrationReturnMaxPower(frequency);

    if(power > maxPower){
        return maxPower;
    }
    else if(power < (maxPower-30)){
        return (maxPower - 30);
    }
    else{
        return power;
    }
}

char calibrationReturnAttenuation(int frequency, int power){
    // vrnemo nastavitev slabilca glede na zeljeno moc v odvisnosti od frekvence
    char calPower = calibrationReturnMaxPower(frequency);
    char calAttenuator = calibrationReturnMaxAttenuator(frequency);

    if(power >= calPower){
        return calAttenuator;
    }
    else{
        char attenuatorSetting = calPower - power;
        attenuatorSetting = attenuatorSetting<<2; // premaknemo vrednost za 2 desno
        char returnValue = attenuatorSetting + calAttenuator;
        if(returnValue > 0b01111111){
            return 0b01111111;
        }
        else{
            return returnValue;
        }
    }
}
