aljazblatnik/Spectrum-analyzer/LO2/LO2_test_program/inc/pe43711.h

#ifndef PE43711_H_INCLUDED
#define PE43711_H_INCLUDED

void send_attenuator_SA(unsigned char data);
void send_attenuator_TG(unsigned char data);
void init_attenuators(void);

#endif /* PE43711_H_INCLUDED */
