aljazblatnik/Spectrum-analyzer/(commit log)

2022-10-31 Initial public release
    v9 of industrial circuit
    [100k_narrow_5M.csv, 100k_wide_20M.csv, 1M_wide_20M.csv, 300k_narrow_10M.csv, 300k_wide_20M.csv, 30kHz_0_200MHz.csv, 30k_narrow_1M.csv, 30k_wide_20M.csv]
2023-01-02 Master (#1)
    * Xtal filter added
    * Cavity filter added
    * LO2 added
    * LO1 added
    * LOG detector added
    * ATT added
    * VBW added
    * REF clock added
    * AMP HEMT added
    * MIX added
    * LO3 added
    * MCU and COMM added
    * Layout added
    * TG added
    [1. ord..csv, 100k-10k.csv, 100k-1k.csv, 100k-3k.csv, 10MHz_filter_full_system.csv, 10kHz_loop_filter.csv, 10kHz_loop_filter_AVA_comparisonAVA-183A+.csv, 10kHz_loop_filter_AVA_comparison_no AMP.csv]
2023-12-08 Cavity filter README.md and web editing
    [2x2cm_end_plug_plus_mounting.FCStd, 2x2cm_end_plug_plus_mounting.stl, Backup_of_COMM schematic.spl8]
2023-12-25 MIX -> FR4 update
    Change PCB material from Rogers to FR4 0.8mm
    [10MHz_filter_full_system.csv, 70MHz_filter.csv, MIX schematic.spl8, MIX1 PCB.lay6, MIX2 PCB.lay6, MIX2_LPF1_v2.csv, MIX2_LPF2_v2.csv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]
2024-01-04 FR4 DIY update
    [MIX1 PCB.lay6, MIX2 PCB.lay6]
2024-01-18 MIX3 PCB error correction
    [MIX3 PCB.lay6]
2024-02-26 LO2 repository update
    First update to public release
    [LO2_PCB.lay6, LO2_schematic.spl8, MAX2870_PLL2_new_loop_Xtal.csv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]
2024-02-27 LO2 README update
    LOR Readme and Components placement
    [LO2_PCB.lay6]
2024-05-06 LO1 Readme update
    Readme updated for public release
    [PLL_VCO_1_1.DRL, PLL_VCO_1_1_copper_bottom.gbr, PLL_VCO_1_1_copper_top.gbr, PLL_VCO_1_1_outline.gbr, PLL_VCO_1_1_silkscreen_bottom.gbr, PLL_VCO_1_1_silkscreen_top.gbr, PLL_VCO_1_1_smdmask_bottom.gbr, PLL_VCO_1_1_smdmask_top.gbr]
2024-08-21 COMM update
    Update in comm 2 boar schematic
    [COMM schematic.spl8]
2024-08-21 MCU update
    Removal of wrong schematics
