aljazblatnik/Spectrum-analyzer/AMP HEMT/photo/IMG_5211.jpg

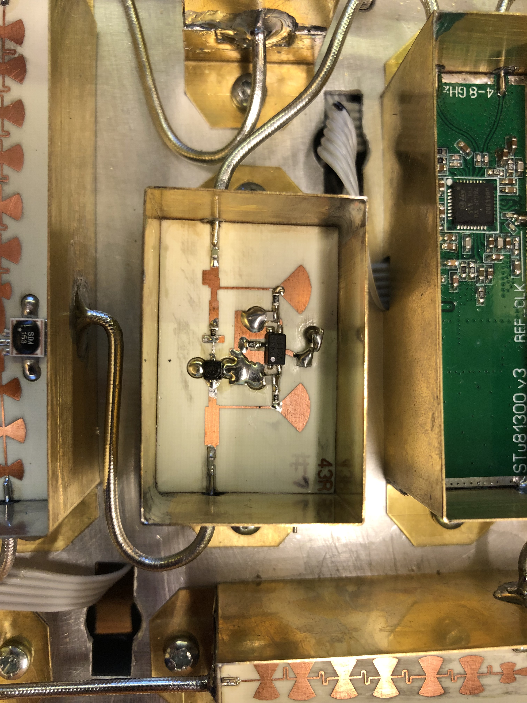
AMP HEMT/photo/IMG_5211.jpg
