aljazblatnik/Spectrum-analyzer/LOG detector/photo/IMG_5250.jpg

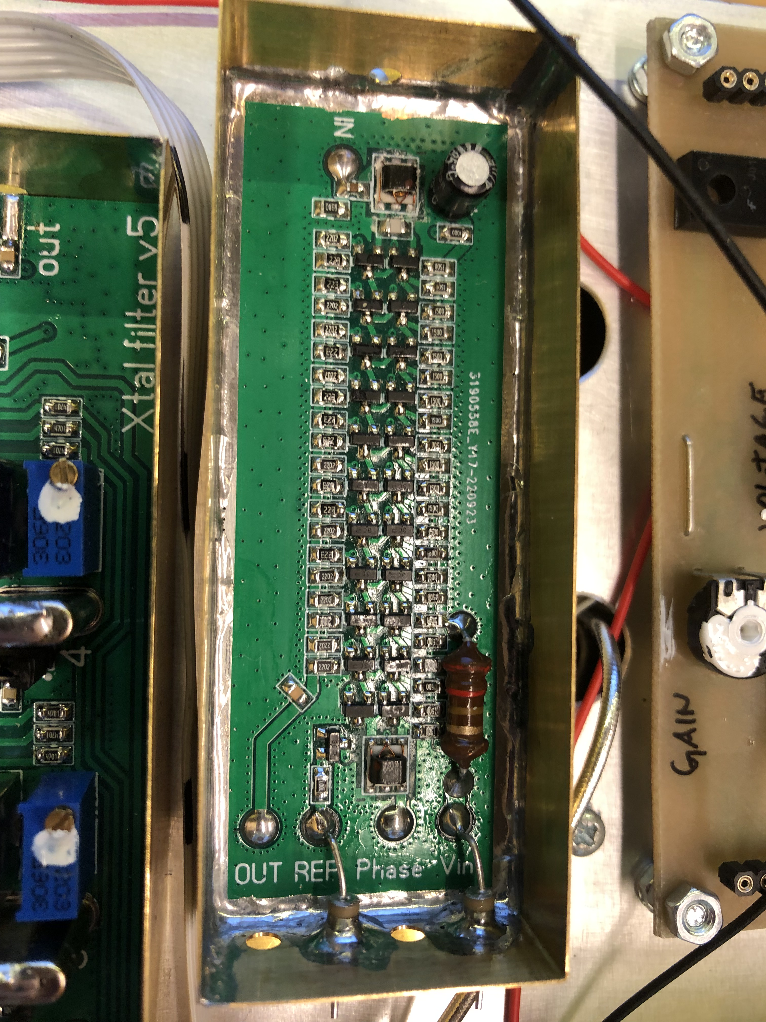
LOG detector/photo/IMG_5250.jpg
