aljazblatnik/Spectrum-analyzer/LOG detector/photo/IMG_5251.jpg

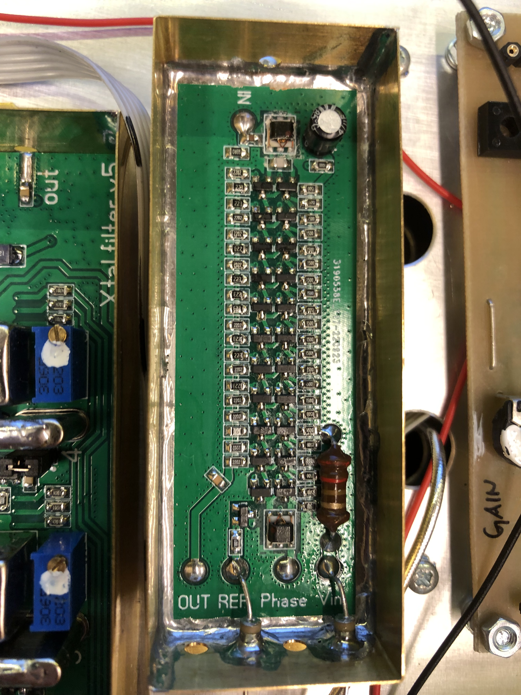
LOG detector/photo/IMG_5251.jpg
