aljazblatnik/Spectrum-analyzer/LOG detector/photo/IMG_5261.jpg

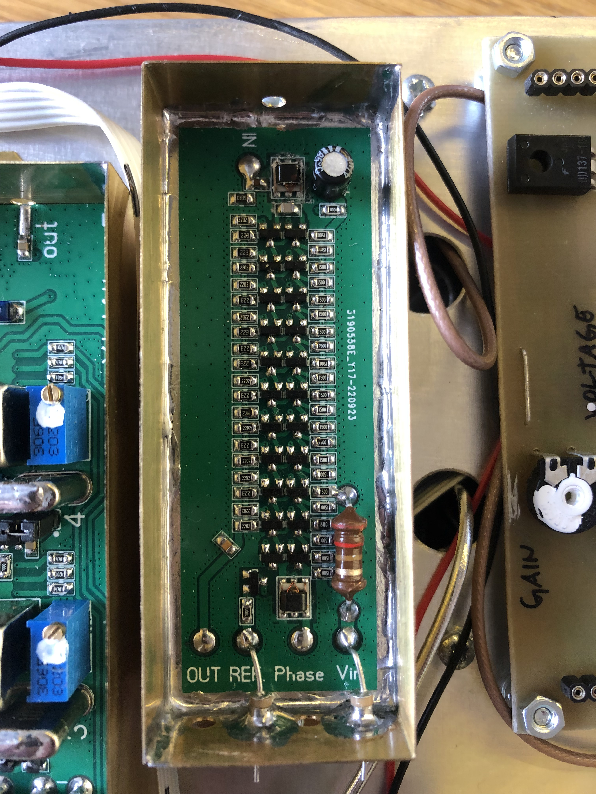
LOG detector/photo/IMG_5261.jpg
