aljazblatnik/Spectrum-analyzer/LOG detector/photo/IMG_5262.jpg

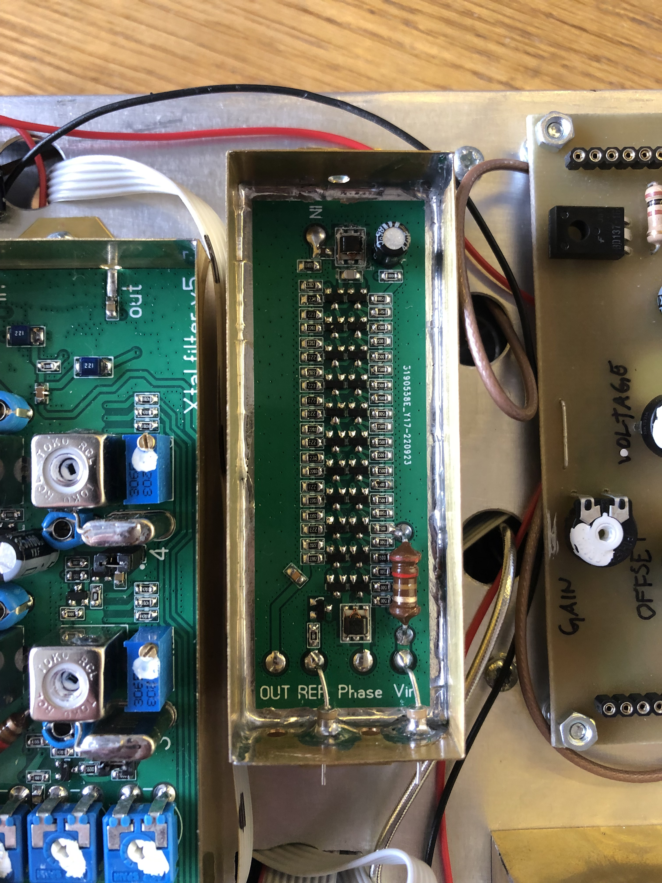
LOG detector/photo/IMG_5262.jpg
