aljazblatnik/Spectrum-analyzer/RBW Xtal filter/photo/IMG_5253.jpg

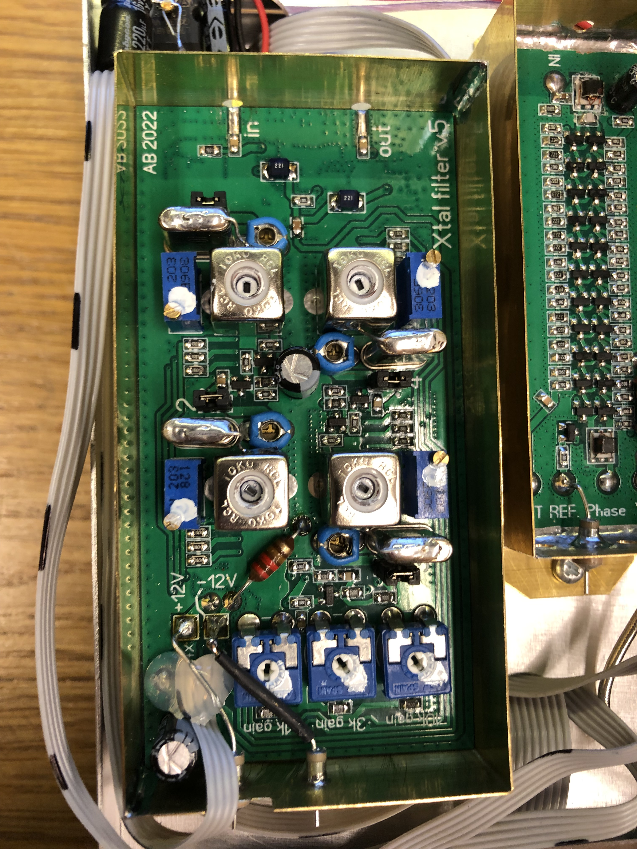
RBW Xtal filter/photo/IMG_5253.jpg
