aljazblatnik/Spectrum-analyzer/RBW Xtal filter/photo/IMG_5263.jpg

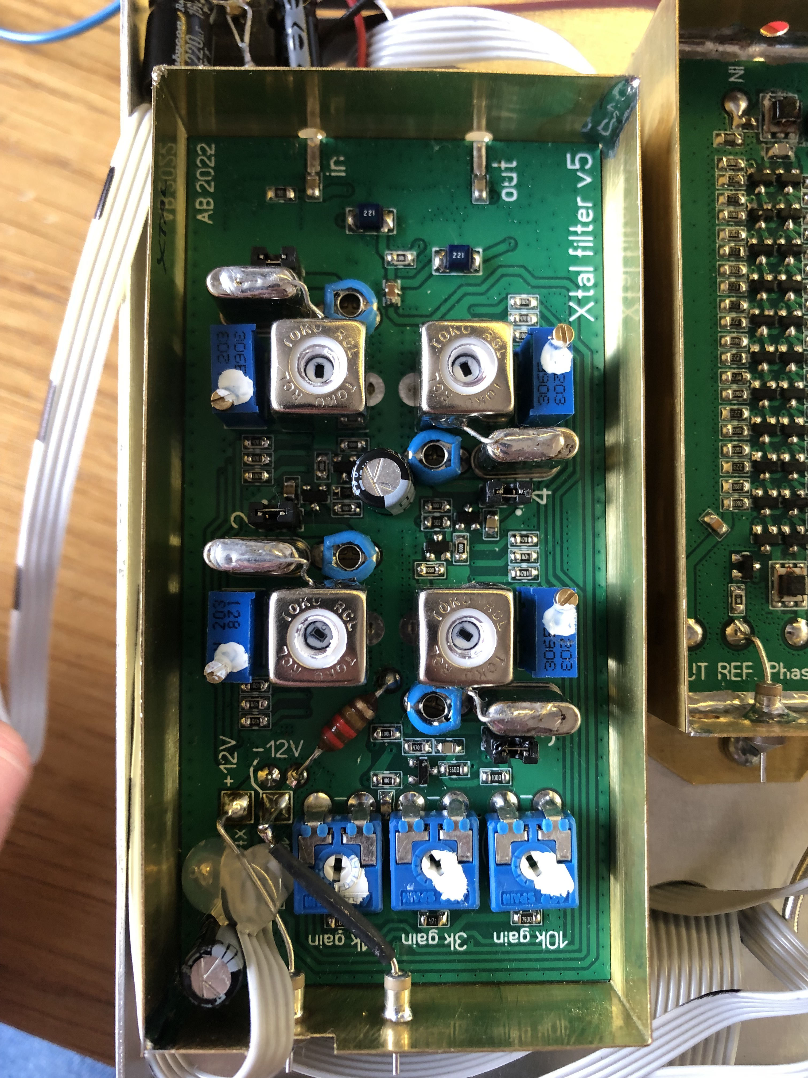
RBW Xtal filter/photo/IMG_5263.jpg
