aljazblatnik/Spectrum-analyzer/RBW Xtal filter/photo/IMG_5264.jpg

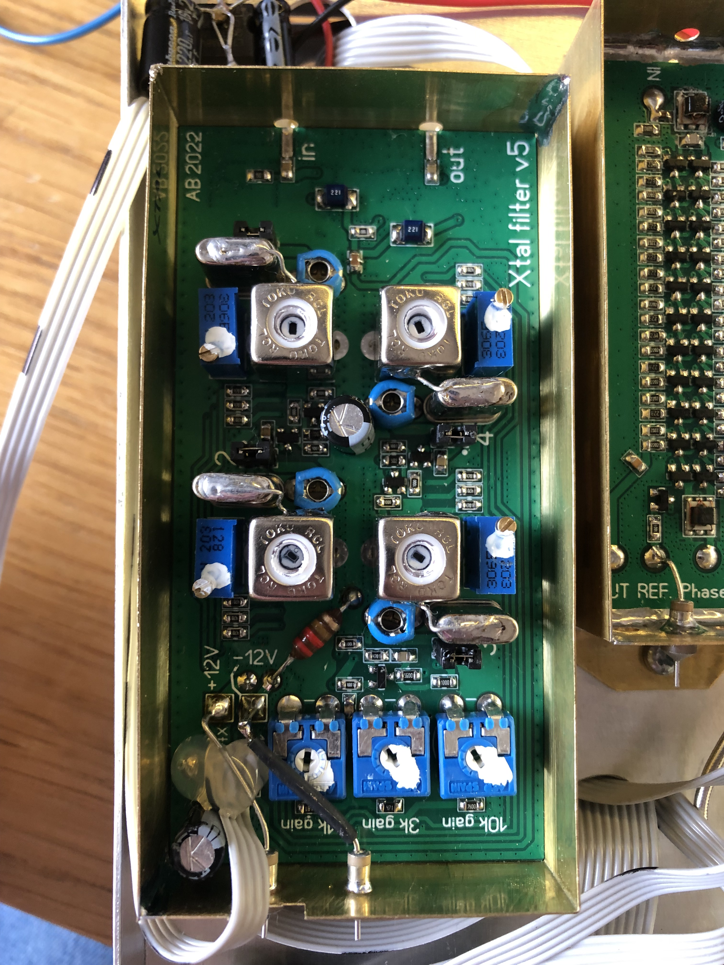
RBW Xtal filter/photo/IMG_5264.jpg
