aljazblatnik/Spectrum-analyzer/RBW Xtal filter/photo/IMG_5265.jpg

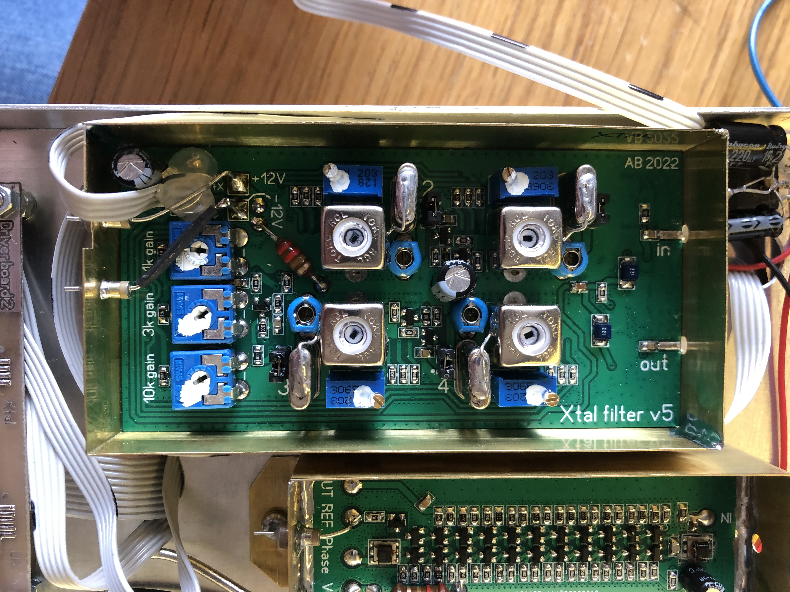
RBW Xtal filter/photo/IMG_5265.jpg
