aljazblatnik/Spectrum-analyzer/REF clock/photo/IMG_5197.jpg

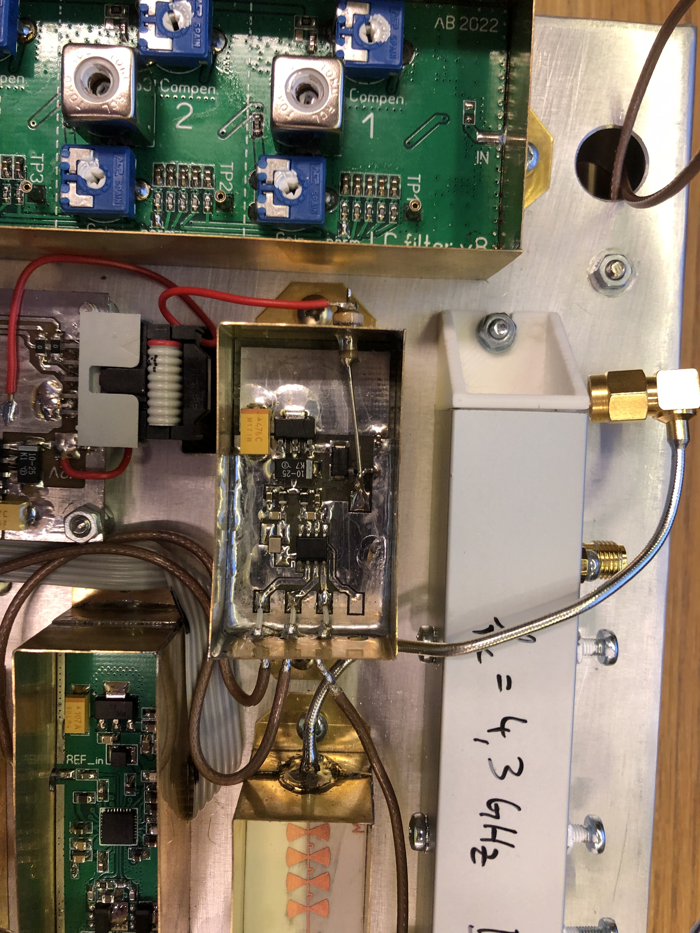
REF clock/photo/IMG_5197.jpg
