aljazblatnik/Spectrum-analyzer/TG output AMP/photo/IMG_5287.jpg

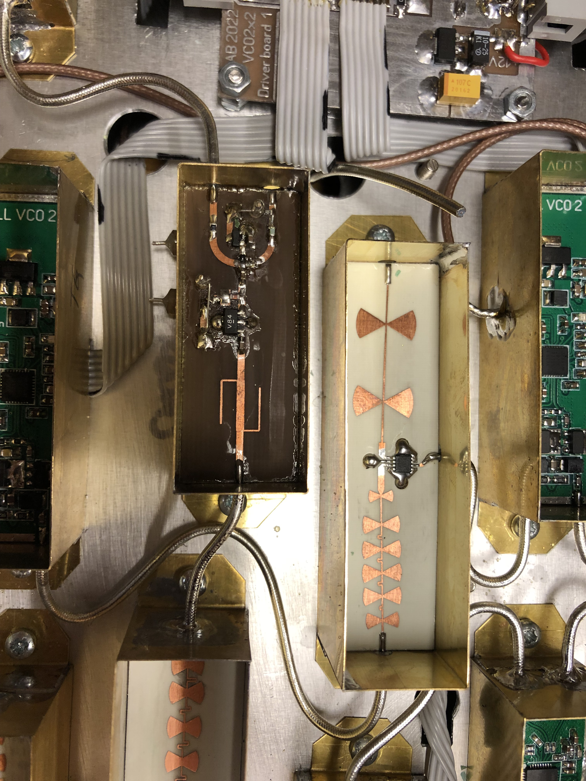
TG output AMP/photo/IMG_5287.jpg
