aljazblatnik/Spectrum-analyzer/TG output AMP/photo/IMG_5289.jpg

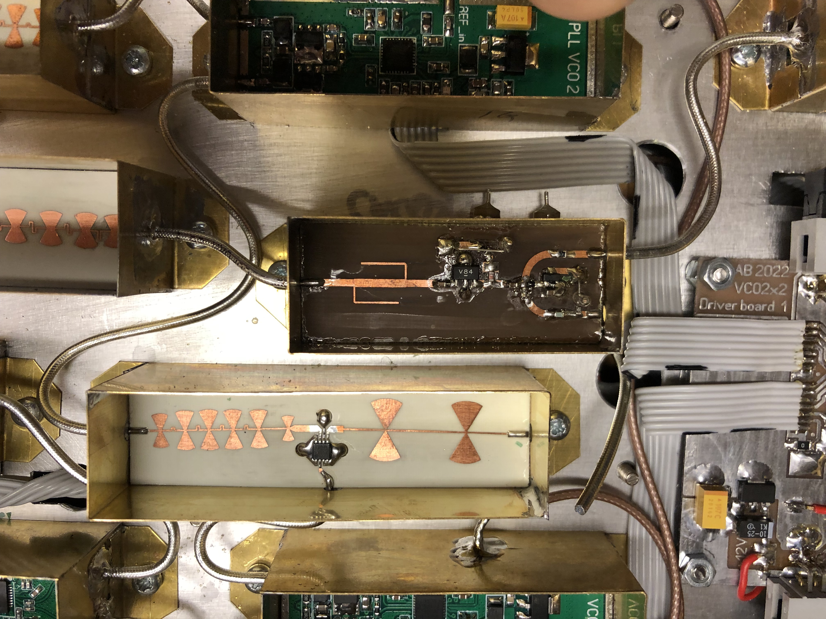
TG output AMP/photo/IMG_5289.jpg
