aljazblatnik/Spectrum-analyzer/TG output AMP/photo/IMG_5294.jpg

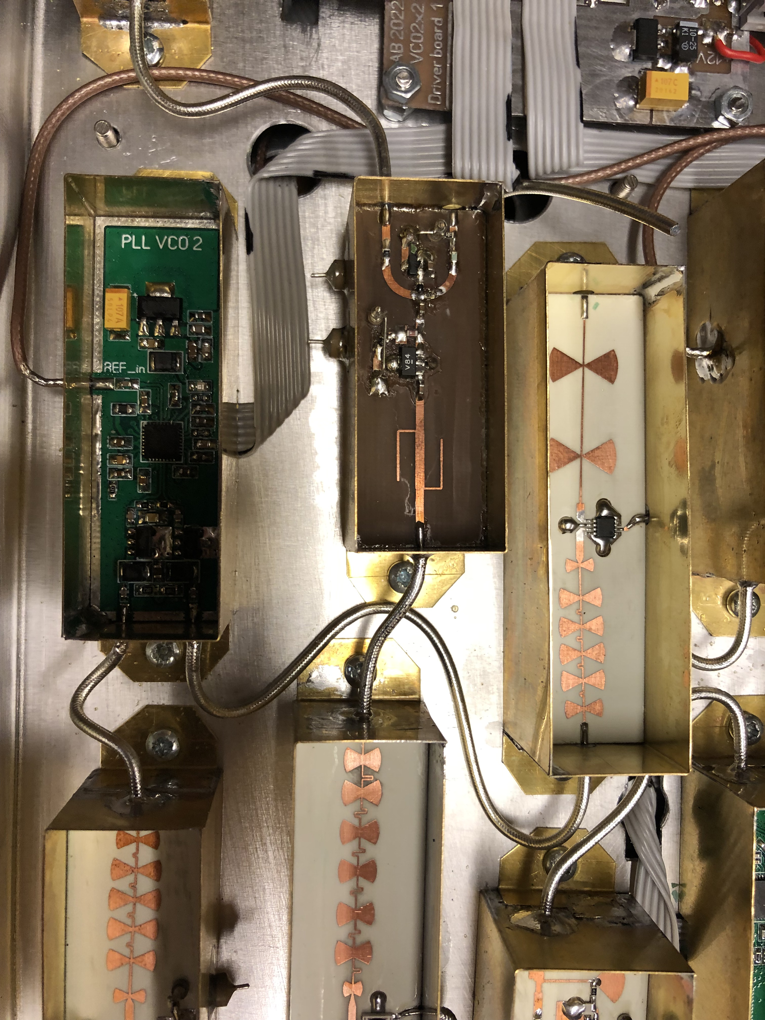
TG output AMP/photo/IMG_5294.jpg
